hdhimmel/willy-rover/docs/WildWilly_AsBuilt_Design_v1.0.md

# WildWilly Autonomous Rover

## As-Built Design Document

**Revision 1.0 · Current Configuration**

---

## Document Control

| Field | Value |
|---|---|
| Project | WildWilly Autonomous Rover |
| Document | As-Built Design — current configuration only |
| Revision | 1.0 |
| Date | 2026-08-15 |
| Owner | Howard Himmel |
| Status | Build complete; live verification in progress |
| Supersedes | Nothing. This is a parallel document. |
| Historical record | Master Engineering Package rev 6.2.0 retains all incident history, superseded designs, and revision lineage. Retain it. |

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

---

## 1. System Overview

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

---

## 2. Power Architecture

### 2.1 Distribution tree

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

### 2.2 Regulated rails

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

### 2.3 Protection

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

### 2.4 Capacitors — complete list

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

### 2.5 Voltage limits

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

---

## 3. I²C Bus and Isolation
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
