hdhimmel/willy-rover/hardware/arm/arm_ducts_check.png

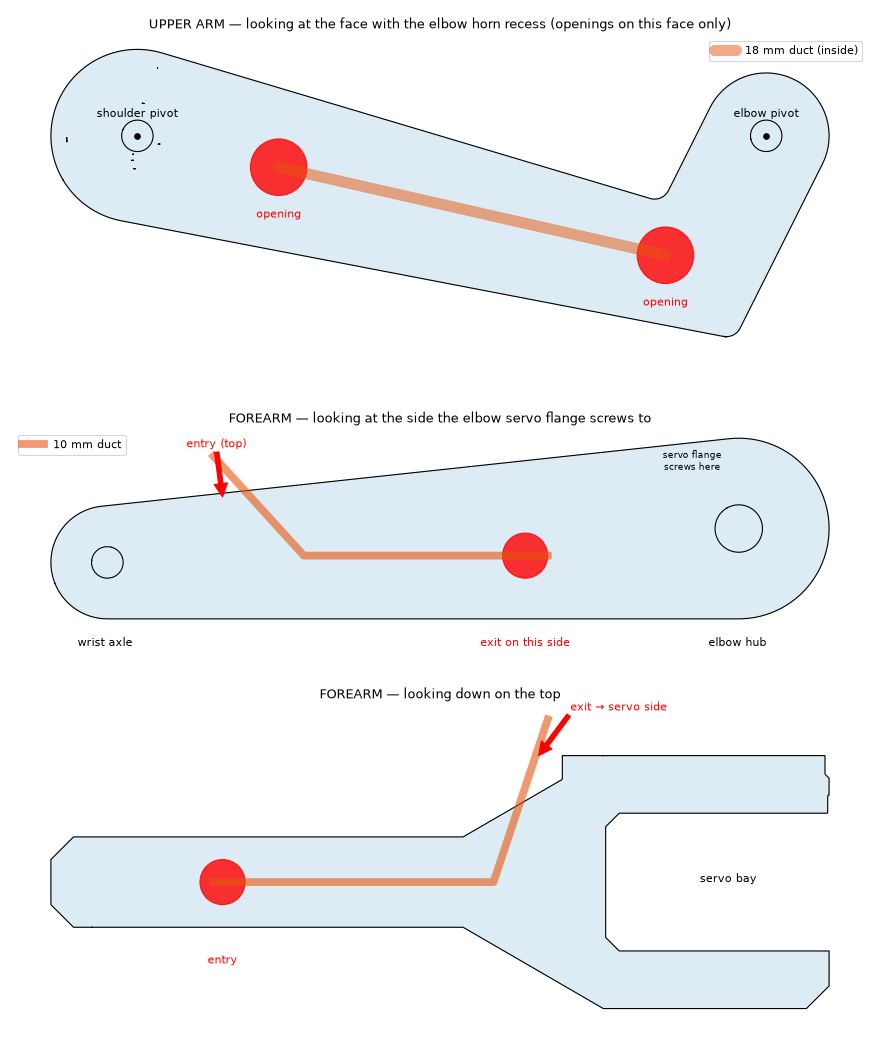
hardware/arm/arm_ducts_check.png
