hdhimmel/willy-rover/hardware/body/WildWilly_Body_P1S.3mf

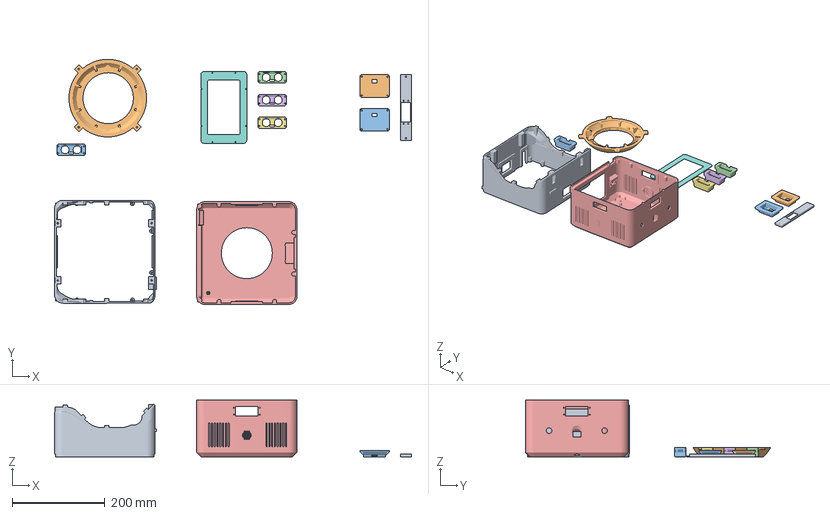
[picture p2: CAD file, 2026-10-14]
hardware/body/WildWilly_Body_P1S.3mf
771.7 x 530.4 x 123.2 mm
WildWilly_body_lower
WildWilly_dome_cap
Sonar_holder_1
Sonar_holder_2
WildWilly_body_upper
Sonar_holder_3
Sonar_holder_4
WildWilly_display_bezel
WildWilly_servo_bar
ToF_box_front
ToF_box_rear
