hdhimmel/willy-rover/docs/WildWilly_Bench_Test_Procedures.md

# WildWilly — Bench Test Procedures

**Created 2026-09-14.** Prepared in advance of a hardware session, at the owner's request,
following the direction to *"make the physical robot's control and safety foundation
rock-solid before expanding autonomy."*

> **NO RESULT IN THIS DOCUMENT HAS BEEN OBSERVED.** Every result field is blank and stays
> blank until someone runs the procedure on the physical rover and writes down what
> happened. A procedure with a plausible-looking number already in it is worse than no
> procedure: the whole point of this session is to replace assumptions with measurements,
> and the repository already contains several defects that survived because a reasonable
> guess was written down as though it were a reading.

This is an operational checklist, not a design document. It does not count against the
three-document rule (Master Hardware Design, Software Design, Functional Requirements) and
follows the existing convention of `archive/WildWilly_ADS1115_Bringup_Checklist.md`
and `archive/WildWilly_PCA9685_Arrival_Punchlist.md` (both archived 2026-09-24 — the
convention stands, the checklists are closed).

---

## What is already verified, and what is not

The distinction matters because it decides what still needs the rover.

### Verified in software — done, no hardware required

These are proven by the test suite (`WILLY_SIMULATE=1 ./venv/bin/python -m pytest`, 398
passing at time of writing; **412 as of 2026-09-17**). They need no bench time and are listed
so nobody re-does them.

✅ **S-1 sonar array — CLOSED ON HARDWARE 2026-09-17.** All three channels range-tested
together for the first time since the build: front 49.7cm, left 91.1cm, right 30.9cm, each
stable to ±0.4cm over 8 samples and each reading its own direction (three distinct
distances, so no cross-talk). All three ECHO lines idle LOW and go low against an internal
pull-down. R2 at 4.990V @ 0.026A — no sensor drawing fault current. There is no separate
S-1 procedure below because the array was closed while debugging it; the method is recorded
in Master Hardware Design §16.13, which now carries a diagnosis table for a dead channel.

| area | evidence |
|---|---|
| Emergency stop phrasing, incl. negation | `tests/test_emergency_stop_phrases.py` (40) |
| Reflex/deliberative separation | `tests/test_reflex_deliberative_separation.py` (5) |
| Nothing bypasses `safety.py` to the motors | `tests/test_no_direct_drive_bypass.py` |
| AI result → motion gating, all result kinds | `tests/test_stuck_ai_fallback_chain.py` |
| Malformed model output never becomes an action | `tests/test_malformed_model_output.py` (24) |
| Confidence gate semantics | `tests/test_confidence_gate_semantics.py` (9) |
| Hailo ChatML framing, statelessness, params, device sharing | 4 files, 27 tests |
| STUCK prompt shape and single-source | `tests/test_stuck_prompt.py` (11) |
| sd_notify wire format, inertness, fault tolerance | `tests/test_sd_notify.py` (6) |
| I²C expected-device agreement | `tests/test_expected_i2c_agreement.py` (5) |

### Requires the physical rover — everything below

Nothing in the sections that follow can be established from a laptop, and none of it should
be inferred from code reading. Each has a blank result field.

**Safety rules for every procedure here:**

1. **Rover on blocks, wheels free**, unless a step explicitly says otherwise.
2. **Stop the service first**: `sudo systemctl stop willy-rover` — it holds the I²C bus, the
   camera and the serial ports, and two processes driving the same PCA9685 is its own defect.
3. **Keep a hand on the power switch.** The hardware e-stop is a latching cut with no
   documented GPIO sense pin, so software cannot observe or override it — that is the point.
4. Restart afterwards: `sudo systemctl start willy-rover`.

---

## M-1 — Motor port mapping (one wheel at a time)

**Why:** `config.py:59` `MOTOR_PORT` was changed on 2026-09-04 from a bench-measured mapping
to an assumed physical ordering. Until this is confirmed, do not trust per-wheel odometry,
stall attribution, crab steering, or autonomous recovery — every one of those names a
specific wheel.

**Tooling (rewritten 2026-10-16 for the Pico cutover):** the MCP23017 expander is off the
bus (Master Hardware Design §4.7); the six encoders are counted by **Pico A** and read over
`uart4-pi5` by `sensors.Encoders` (signed ×2 since firmware a-0.3, `ENCODER_COUNTS_PER_REV`=763).
`scripts/motor_map_check.py` drives each `MOTOR_PORT` alone in rover-forward terms
(`MOTOR_SIGN` applied, as `motors.py` does) and prints every encoder's count change: a correct
row moves **only its own** encoder, by a **positive** amount. `scripts/wheel_current_test.py`
drives one wheel and reports current, which independently confirms a port is connected.
`scripts/encoder_map_check.py` (MCP23017 pin poll) no longer exists; do not reinstate it.

**Procedure:**

1. Rover on blocks. Service stopped (it owns the motor ports and Pico A's UART). Label the
   six wheels physically (LF, LM, LR, RF, RM, RR) with tape.
2. `python3 scripts/motor_map_check.py` -- all six, or name wheels (`lf rr`).
3. For each row, record **which physical wheel turned**, **whether it rolled forward**, and the
   script's verdict. The script can only see encoders; your eyes confirm the wheel.
4. Any non-OK row: wires first (connector, crimp, J3 position), then config
   (`MOTOR_PORT`, `MOTOR_SIGN`), then the part. Re-run that wheel alone after a fix.

**Record:**

| config key | address, port | wheel that actually turned | rolled forward? | script verdict |
|---|---|---|---|---|
| `lf` | `MOTORKIT_LEFT_ADDR`, 3 | | | |
| `lm` | `MOTORKIT_LEFT_ADDR`, 2 | | | |
| `lr` | `MOTORKIT_LEFT_ADDR`, 1 | | | |
| `rf` | `MOTORKIT_RIGHT_ADDR`, 3 | | | |
| `rm` | `MOTORKIT_RIGHT_ADDR`, 2 | | | |
| `rr` | `MOTORKIT_RIGHT_ADDR`, 1 | | | |

**Pass:** all six map to the wheel their key names, and forward is forward on both sides.
**If a whole side runs backward**, that is `MOTOR_SIGN`, not `MOTOR_PORT`: the motors are
mounted mirrored (harness-end outward), so one side is negated in software (2026-10-01).
**If it fails:** correct `MOTOR_PORT` in `config.py`, then re-run this whole procedure —
not just the rows that were wrong. A mapping is a permutation; fixing one entry can move
another.

**Note:** the encoder A/B channel assignment is a *separate* unverified question
(`config.py:57`) and is **not** settled by settling this one. See E-1.

---

## E-1 — Encoder supply and output

✅ **Counts/rev MEASURED 2026-10-01: 382** (×1, Phase A only — see C-1 Phase 5). Every 752
below is the old-motor figure and is superseded. **Now 763** — Pico A a-0.3 decodes signed x2
the same day, exactly 2 × 381.6.

**Why:** `ENCODER_COUNTS_PER_REV=752` (11 PPR × 4 quadrature × 17.1:1) is arithmetic, not a
measurement, and the A/B assignment is flagged unverified. FRD G-2 separately computes that
at 620 RPM output the edge rate is ~7,770 Hz against a ~1 kHz polling ceiling — roughly 8×
oversubscribed — which means counts may be *systematically* low rather than noisy.

**Do not hand-turn the wheels.** Measured 2026-08-25: 30s of hand-turning produced one
distinct pin state while 3s of driving produced seven. The encoder is on the motor shaft
behind the 17.1:1 gearbox and does not back-drive. Any encoder measurement here must be
taken under power.

**Procedure:**

1. Meter the encoder supply rail at the encoder connector, motors idle, then again while
   driving. Record both — a rail that sags only under load is the failure mode that looked
   like a dead sensor on 2026-08-25 (measured 2.83 V against a 3.3 V target).
2. Run `scripts/encoder_map_check.py` (rover on blocks) and record which encoder channels
   move for which driven wheel.
3. Run `scripts/encoder_calibration.py` to compare observed counts per revolution against
   the configured 752.

**RESULT 2026-09-18 — partially closed.**

| measurement | value | notes |
|---|---|---|
| Encoder supply, idle | **3.3 V** | in spec; the datasheet range is 3.3–5 V, so undervoltage was never the fault |
| Encoder supply, under load | **3.3 V** | no sag — the 2026-08-25 theory (2.83 V) is dead |
| Encoder supply POLARITY | ⚠ **WAS REVERSED** | found and corrected 2026-09-18. LF Phase A went 2/6 → 6/6 immediately after |
| Pin-to-wheel map | ✅ **measured** | left/right were transposed, same as the motor boards — see Master Hardware Design §7.2 |
| Phase A (yellow, even pin) | ✅ all six | |
| Phase B (green, odd pin) | ❌ **dead on all six** | one wiring pattern, not six faults — trace the green wires |
| Counts per revolution vs 752 | not measured | blocked on Phase B: quadrature needs both channels |

**Superseded 2026-10-01:** the dead Phase B was the OLD motors. On the six new motors A and B
toggle in step on every wheel (raw pin poll over USB, each wheel driven alone); a-0.3 decodes
signed x2, direction verified on all six; counts/rev **763**.

**Historical (MCP23017, retired):** the next paragraph describes the old expander method and
is kept for the record only -- Pico A counts in hardware (PIO), so none of its aliasing applies now.
**The method matters more than the numbers here.** Do not poll these pins for edges: at 0.6
duty the edge rate is ~7.7 kHz against a ~1.2 kHz I²C ceiling, and the aliasing reads as a
CONSTANT. Three attempts concluded "no encoder output at all" and all three were wrong. Drive
one wheel ~1 s, compare the MCP23017 resting state before and after, and count across several
trials which pins change.

**Still open:** the green/Phase-B wiring, and only then counts-per-rev. **Both closed 2026-10-01.** Note step 3 below is
itself invalid — `scripts/encoder_calibration.py` is built on hand-turning, which produces
nothing on this rover (§2.2: the encoder is behind the 17.1:1 gearbox and does not
back-drive).

⚠ **STEP 3 IS ALSO BLOCKED ON HARDWARE, owner-stated 2026-09-24: the drive motors are
being replaced with 170 RPM variants.** `ENCODER_COUNTS_PER_REV` is 11 × 4 × the gearbox
ratio, so calibrating it against the 17.1:1 motors measures hardware that is about to come
out. **Do step 1 and step 2 now; leave step 3 until the new motors are fitted.**
**Done 2026-10-01: 382** — under power, not with step 3's script (C-1 Phase 5). **763** under a-0.3's x2.

Two things to carry into that session:

- **Step 2 has to be re-run after the swap regardless.** Both left/right transpositions
  found on 2026-09-18 — `MOTOR_PORT` and `ENCODER_PINS` — came from landing motors and
  their encoders in a single pass. Six new motors is that same pass. M-1 and E-1 step 2
  both re-open, and wire colours differ between batches of this family.
- **Do not let 3292 back in.** It implies 74.8:1 ≈ 142 RPM output, not 170, so it is
  roughly 20% wrong for the new motors rather than 4.4× wrong — and a 20% fixed offset
  reads as wheel slip, which is exactly what FR-500-002 is supposed to distinguish it
  from. Measure the value; do not adopt either recorded figure.
| Channels responding per wheel | | |
| Observed counts/rev vs 763 | | x2 (a-0.3); was "vs 382" (×1) earlier 2026-10-01, "vs 752" before |
| Counts plausible at speed, or systematically low? | | bears on FRD G-2 |

**Pass:** supply holds within tolerance under load, every wheel produces distinct A/B
activity, and observed counts/rev are within a few percent of **763** (x2, a-0.3), and each wheel counts
up driven forward, down in reverse. Was 382 (×1) earlier 2026-10-01, 752 before.

---

## A-1 — Arm connector reconnection

**Why:** the arm connector was reconnected and has not been exercised since.

**Procedure:**

1. Arm clear of obstructions, rover powered, service running.
2. Issue `arm_home` by voice ("willie, home the arm") or via the pending-command path.
3. Observe physically.

**Record:**

| check | result |
|---|---|
| All expected joints moved | |
| Any joint stuck, buzzing, or fighting | |
| Motion smooth or jerky | |
| Servo current during motion (`scripts/servo_current_test.py`) | |

**Pass:** every joint moves to centre, nothing buzzes at the limit, current is in family
with the other joints.

**Note for the recorder:** `brain.py:807` currently aliases **both** `arm_stow` and
`arm_home` to `arm.center_all()`, because no calibrated stow pose exists yet (§20.6). So
this procedure tests the connector and the servos — it does **not** test a stow pose,
because there is not one. Do not record "stow verified".

---

## V-1 — IMX708 range and bearing calibration

**Why:** `vision.py:19-20` uses `_ASSUMED_HFOV_DEG = 70.0` and `_FOCAL_PX_ESTIMATE = 600.0`,
both explicitly not bench-measured. `come_here`, `follow`, `retrieve` and the grasp standoff
all rest on them. Conservative stopping does not make the numbers right; it makes the error
land in a safer direction *most* of the time.

**Precondition — settle the camera question first.** `vision.py`'s constants are commented as
being for the **OV9281**, while `config.CAMERA_DEVICE` is `/dev/video8`, which `config.py:587`
records as the **rear-facing Arducam**. Calibrating range for a camera that is not looking
where the rover drives produces a confident wrong number, which is worse than the current
honest estimate. `scripts/calibrate_vision_range.py` refuses to proceed until this is
confirmed, deliberately.

**Procedure:**

1. `sudo systemctl stop willy-rover`
2. `./venv/bin/python scripts/calibrate_vision_range.py --object person`
3. Place the object squarely at measured distances across the working range — suggested
   50, 75, 100, 150, 200, 300 cm, measured to the **front face of the rover**.
4. For bearing: place the object at a measured lateral offset at one fixed distance, both
   left and right, and record reported bearing against true angle.

**Record:**

| true distance (cm) | reported (cm) | ratio |
|---|---|---|
| 50 | | |
| 75 | | |
| 100 | | |
| 150 | | |
| 200 | | |
| 300 | | |

| bearing check | true angle | reported |
|---|---|---|
| left offset | | |
| right offset | | |

**Interpretation, decided in advance so the result is not rationalised afterwards:**

- A **constant** true/reported ratio across all distances is a focal-length error. Scale
  `_FOCAL_PX_ESTIMATE` by it.
- A **varying** ratio is *not* a focal-length error — a wrong focal length scales every
  reading by the same factor. Varying means the assumed object width is wrong, the detector
  box is unstable, or the object was not square to the camera. **Do not apply a correction
  from such a run.**

**Pass:** ratio constant within ±0.1 across the range, bearing within a few degrees.
**Until this passes**, treat `retrieve` grasp distance as unvalidated regardless of how
conservative the stopping behaviour looks.

---

## T-1 — ToF (DFRobot SEN0628) bench test, before integration

**Why:** `tof.py::read_frame()` deliberately raises `NotImplementedError` — the wire format
had never been observed. `ENABLE_TOF=False`.

> **HISTORICAL — first bench test of the sensor, before it was mounted (2026-09-15).** The zone
> results below (62–63 of 64 live, rows reading 5–14 mm) describe the loose sensor on the bench, not
> the mounted ones. Both mounted sensors run with floor profiles re-captured **2026-10-15** (front rows
> 6–7, rear rows 0–1; see Software Design ToF section). Do not cite these numbers as current.
>
> ✅ **LARGELY CLOSED 2026-09-15 — the sensor works.** Transport, protocol and sensor are all
> verified: **200/200 clean frames** at 0.13s each, 62–63 of 64 zones live.
>
> **Root cause of the day spent getting there: it was powered from a dormant supply rail**, not
> from the Pi's 3V3 / I²C rail (R4). A marginal supply boots the RP2040 far enough to light its
> LED, hold TX idle-high and answer a few commands, then go quiet — so every "is it powered?"
> check passed. **Prove which RAIL a device is on, not just that it has voltage.**
>
> What remains: the near-field zone anomaly below, one longer stability run, `read_frame()`,
> and the floor profile.

**Pi side — VERIFIED 2026-09-15, does not need rechecking:**

| check | result |
|---|---|
| `dtoverlay=uart3-pi5` in `/boot/firmware/config.txt` | ✅ added and confirmed |
| `/dev/ttyAMA3` exists after reboot | ✅ `PL011 AXI` at `1f0003c000.serial` |
| `pinctrl get 8-9` shows `a2` = TXD3 / RXD3 | ✅ |
| `spi0` not holding GP8/GP9 | ✅ empty |

⚠ **It must be `uart3-pi5`, never `uart3`.** The plain overlay is BCM2711/Pi 4 and puts
UART3 on GPIOs 4–7. It does not error, the Pi boots cleanly, and the sensor reads as dead
hardware on the wrong pins.

**UART protocol — derived from `DFRobot_MatrixLidar.cpp` verbatim, 2026-09-15:**

```
request   [0x55][argsNumH][argsNumL][cmd][args...]      argsNum = len(args) + 1
reply     [status][cmd][lenL][lenH][payload...]          lenL BEFORE lenH
          status 0x53 = SUCCESS, 0x63 = FAILED
          0xFF is filler; skip it while hunting the status byte
getAllData    55 00 01 02
setRangingMode 8x8   55 00 05 01 00 00 00 08   then wait 5s (library does delay(5000))
payload   little-endian uint16 millimetres, 64 zones = 128 bytes; 4000 = invalid
```

Two traps, both of which cost hours: `argsNum` is `len+1` not `len` (the un-incremented
value returns `STATUS_FAILED`, which reads like a hardware fault), and the reply's `0x53`
is a **status byte, not a header** — parsing it as a header yields nonsense lengths.

**`scripts/tof_probe.py` implements all of this.** Use it rather than rewriting a client.

**Procedure — the sensor-dependent half:**

1. **Set the DIP switch to UART and then DISCONNECT POWER.** The factory default is I²C, and
   DFRobot require a power disconnect for the change to latch — a Pi reboot will not do it,
   because the 3.3V header rail stays up. A sensor in I²C mode is silent on UART with both
   lines idling high, indistinguishable from any other fault here.
2. **Peel the protective film** off the optics and off the DIP switch.
3. **Wire BOTH data lines.** `sensor TX → GP9 = pin 21` *and* `sensor RX → GP8 = pin 24`.
   Power from **3.3V, not 5V**. Earlier guidance that only RX was needed was wrong — see
   below — and one wire produces permanent silence.
4. `./venv/bin/python scripts/tof_probe.py --listen` → **expect zero bytes.** The sensor is
   polled, not streaming. Zero here is a pass, not a fault.
5. `./venv/bin/python scripts/tof_probe.py` → expect `SUCCESS`, `len=128`, and a grid.
6. `./venv/bin/python scripts/tof_probe.py -n 200` for the stability bar. §6.5 requires a
   **stable multi-minute stream**; intermittent is a fail. Return inside 30 days if it will
   not hold one.
7. Implement `read_frame()` against the observed bytes.
8. On clear level floor, on the surface Willie actually roams, run
   `python3 scripts/calibrate_tof_floor.py`.
9. Only then set `ENABLE_TOF=True`.

**`pinctrl` answers "is it even connected?" without a meter.** `sudo pinctrl get 9` reads
`pu | hi` by default — but a *floating* pin reads the same, so that proves nothing. Force
the pull down (`sudo pinctrl set 9 pd`) and re-read: still `hi` means something external is
actively driving the line, i.e. the sensor is powered and its TX is alive. Restore with
`sudo pinctrl set 9 pu`. This separated "sensor absent" from "sensor present but mute"
three times on 2026-09-15.

**Record:**

| check | result |
|---|---|
| Raw frame observed (paste a sample) | ✅ 2026-09-15 — `status=0x53 cmd=2 len=128`, payload LE uint16 mm; sample row `1087 1145 1182 1211 1167 1203 1227 1212` |
| Frame length and structure match library source | ✅ 128 bytes = 64 zones × uint16, exactly as derived |
| All 64 zones return data | ⚠ **62–63 of 64.** Rows 1–4 read **5–14mm**, below the sensor's 20mm minimum, with scattered zeros and two `4000`s. Rows 5–8 read a sensible 1.0–1.2m. **Check the protective film on the optics first** (CLAUDE.md's first ToF trap — a ~5×3mm square the vendor docs never mention), then the bench pose. Do NOT run the floor profile until this is understood — `calibrate_tof_floor.py` would bake it into the baseline |
| Stable multi-minute stream (`-n 200`) | ✅ **200/200, zero dropouts, 0.13s/frame.** Run took ~1.8 min — repeat at `-n 600` to fully satisfy "multi-minute" before `ENABLE_TOF=True` |
| Floor profile captured, zones with no data | blocked on the near-field anomaly above |
| Reads consistent at fixed distance | |

**Supply — record this, it was the whole fault.** 3.3V must come from the **Pi 3V3 / I²C rail
(R4)**. The rail it was originally on is out of the build entirely. The sensor adds
up to 80mA to R4 and is now its largest single consumer; nothing monitors that rail, so if it
goes tight the symptom is I²C flakiness appearing after `ENABLE_TOF` goes True.

**Note:** re-run the floor capture after **any** mechanical change. The profile is tied to
the sensor's exact pose; a shifted bracket invalidates it. That failure is loud rather than
silent (phantom obstacles, so he stops for nothing), but it is still a failure.

---

## B-1 — Battery divider calibration

**Why:** `BATTERY_DIVIDER_SCALE=0.2386` needs re-trimming, and the feed should be confirmed
electrically correct first. A scale trimmed against a wrong feed is a wrong number that
looks right.

**Procedure:**

1. Confirm the divider feed is what the documentation says it is — meter it, do not infer it.
2. With a meter on the pack, compare true pack voltage against `adc.battery_volts` at three
   states of charge across the usable range.
3. Compute the corrected scale; do not fit from a single point.

**Record:**

| true pack voltage | reported `battery_volts` | ratio |
|---|---|---|
| | | |
| | | |
| | | |

**Pass:** reported tracks true within ~0.1 V across the range after correction.

**Related:** `config.BAT_IMPLAUSIBLE_V=5.0` rejects readings below a plausibility floor. Note
during this procedure whether any legitimate reading is being rejected.

---

## W-1 — systemd watchdog, bench validation before arming

**Why:** on 2026-09-07, `WatchdogSec=500ms` was installed on a `Type=simple` unit.
`NotifyAccess` then defaults to `none`, so systemd **discarded every** `sd_notify` message —
the heartbeat was never received, no heartbeat rate could have satisfied the deadline, and
the rover was SIGABRTed four times in twenty seconds, never reaching its own first log line.

**Prepared, not installed:** `willy-rover-watchdog.service.prepared`. It is named `.prepared`
so a wildcard copy cannot pick it up, and it carries two `__MEASURE__` placeholders.

**systemd does not reject those** — verified 2026-09-14 with `systemd-analyze`, it logs
`Failed to parse ... ignoring` for both lines and starts the unit with the **defaults**, and the
default for `WatchdogSec` is *disabled*. That would be the worst outcome available: the rover
comes up cleanly and whoever installed it believes the watchdog is armed while nothing is
watching. So the refusal is enforced explicitly by an `ExecStartPre` guard that fails the start
while any placeholder remains (checked in both directions: exit 1 with placeholders, exit 0 once
filled). **A unit that refuses to start is a better failure than a rover that crash-loops, and
far better than one that lies about being protected.**

**Software side already verified** (`tests/test_sd_notify.py`): message wire format,
inertness when `NOTIFY_SOCKET` is unset, abstract-socket translation, no exception into the
tick loop from a dead socket, and that `READY=1` is reachable after a *failed* self-test — so
a degraded rover stays up instead of restart-looping.

**Procedure:**

1. `sudo systemctl stop willy-rover`
2. `./venv/bin/python scripts/measure_startup.py --runs 5 --out /tmp/startup.json`
   This launches `main.py` with its own notify socket; it does not install anything or use
   `systemctl`.
3. Fill both `__MEASURE__` values from the printed suggestions. Sanity-check `WatchdogSec`
   against `config.TICK_OVERRUN_THRESHOLD_S` — a watchdog **below** the tick-overrun
   threshold kills the process before it has logged that it was running slow, destroying the
   evidence for why it died.
4. Install as a **separate** unit; do not overwrite `willy-rover.service`, so rollback is one
   command.
5. **Rover on blocks.** Restart it 10 times: `sudo systemctl restart willy-rover-watchdog`,
   confirming each time that it reaches ready and stays up for at least two minutes.
6. Confirm the watchdog actually bites: induce a stalled tick (e.g. `SIGSTOP` the process) and
   confirm systemd restarts it within roughly `WatchdogSec`.

**Record:**

| measurement | value |
|---|---|
| Startup, worst of 5 runs | |
| Startup, median | |
| Worst tick-gap between heartbeats | |
| `TimeoutStartSec` chosen | |
| `WatchdogSec` chosen | |
| `WatchdogSec` > `TICK_OVERRUN_THRESHOLD_S`? | |
| 10 restarts all reached ready | |
| Watchdog fires on an induced stall | |
| Degraded self-test still reaches ready (not a restart loop) | |

**Pass:** all ten restarts reach ready, the watchdog demonstrably fires on a real stall, and
a deliberately failed self-test produces a degraded-but-running rover rather than a loop.

**Rollback:**
`sudo systemctl disable --now willy-rover-watchdog && sudo systemctl enable --now willy-rover`

---

## Suggested order

Each stage assumes the one before it. Doing them out of order produces measurements that
have to be retaken.

⛔ **C-0 comes before all of these, and before the motors are touched.** It measures
counts-per-rev on the fitted motors, and once they are out it can never be run. The
170 RPM replacements arrived 2026-09-26.

1. **M-1** motor mapping — everything per-wheel depends on knowing which wheel is which.
2. **E-1** encoders — needs M-1 to attribute channels to wheels correctly.
3. **B-1** battery divider — cheap, independent, and it underpins every "is the rail sagging"
   question in E-1.
4. **A-1** arm — independent, quick.
5. **W-1** watchdog — do it before any unattended running, and after M-1/E-1 so a restart
   loop cannot be confused with a drive fault.
6. **V-1** vision range — gate for `retrieve`/`come_here`/`follow`; settle the camera-facing
   question first or skip it.
7. **T-1** ToF — last, because it is the only one that needs new code written against
   observed bytes.
8. **C-1** the Pico and motor cutover — a session of its own, not a step in another
   one. It re-lands six motors and twelve encoder wires, which is how the left/right
   transposition happened twice before.

---

## C-0 — counts-per-rev on the FITTED motors ⛔ DO THIS BEFORE ANYTHING ELSE

⚠ **Overtaken 2026-10-01:** the cutover is done and these motors are out; the table below
was never filled. The 170 RPM replacements measured **382** (C-1 Phase 5) — **763** under a-0.3's x2.

**Why:** the vendor parameter table (2026-09-27) makes the fitted motors
`JGA25-370-9.6K`, i.e. **9.6:1**, which puts `ENCODER_COUNTS_PER_REV` at **422** rather
than the **752** in `config.py`. If that is right, `odometry.py` is under-reporting
every distance by **1.78×** and has been all along. The recorded 17.1:1 was
owner-supplied, and the ~10,600 RPM bare speed was *derived from it* — then each was
cited as corroborating the other. Neither was measured.

**This is unrepeatable once the motors are out.** Everything else in C-1 can be redone;
this cannot.

**Procedure:**

1. Read the part number off a fitted motor body and write it here. `-9.6K` confirms the
   table; anything else rewrites this whole item.
2. Rover on blocks, wheels free, service stopped. Drive **one** wheel a known number of
   full revolutions **under power** — never by hand, the gearbox does not back-drive.
3. counts ÷ revolutions = counts/rev. Expect **422** if the table is right, **752** if
   the document is.
4. Record it, then set `ENCODER_COUNTS_PER_REV` to the measured value regardless of
   which it matches.

| measurement | value | notes |
|---|---|---|
| Part number on the motor body | | `-9.6K` expected |
| Revolutions driven | | |
| Counts observed | | |
| **counts/rev measured** | | 422 vs 752 |

---

## C-1 — Pico and motor cutover

**Everything below happens in one session.** The two changes are independent in
principle and entangled in practice: both re-land six motors' worth of connectors, and
that is exactly how the left/right transposition happened on 2026-09-18 — twice, on the
motor ports and on the encoder channels.

**Standing convention:** removed hardware is **DELETED** from the documents, not struck
(owner-directed 2026-09-20). The MCP23017 does not become a historical note; it goes.

### Phase 1 — bench, before the rover is opened

- [ ] Two carrier boards built to the schematic, **four meter checks passed** — diode
      orientation, no short across the input, PTC cold resistance under ~0.5Ω, divider
      ratio at TP2. Nothing plugged in.
- [x] Both Picos flashed, `os.uname()` and `machine.unique_id()` recorded against A and
      B, and the IDs written **on the boards**. A is `643f69a756a232ea`, B is
      `ad25bbf0f1e1f160` — confirm rather than assume.
      **Confirmed over USB 2026-09-29: both UIDs match, both on MicroPython v1.29.0
      (2026-08-24), RP2350.** ⚠ **And add a step nobody thought to write down: check
      the firmware is installed as `main.py`.** Both boards had it as `pico_a.py` /
      `pico_b.py`, which does not autorun; that alone cost a full session and looked
      exactly like dead hardware.
- [x] `Pin("LED")` **verified on BOTH boards, 2026-09-29** — lit at boot, 60 ms wink
      once a second, wrapped so a CYW43439 failure cannot take the link down.
- [ ] On the Pi: `dtoverlay -h uart2-pi5` reports GPIOs 4–5 and `uart4-pi5` reports
      12–13. **A wrong overlay boots clean and the Pico reads as dead hardware** — that
      cost a full session on the SEN0628.
- [x] `dtoverlay=uart2-pi5` and `dtoverlay=uart4-pi5` added, rebooted, `/dev/ttyAMA*`
      present, serial console still disabled. **Done 2026-09-28**; `pinctrl get 4,5,12,13`
      reads `TXD2 RXD2 TXD4 RXD4`, so `uart4-pi5` IS GP12/GP13 and the `uart5-pi5`
      fallback is not needed.

### Phase 2 — hardware

- [ ] **Meter the encoder supply polarity at the connector before anything is powered.**
      It was found reversed on 2026-09-18; blue-to-black read −3.3 V and a swapped pair
      of probes made it look right.
- [ ] Six motors out, six in. **Record which physical wheel each harness goes to as you
      go** — do not rely on the old labelling.
- [ ] Twelve encoder wires onto Pico A's J3, **yellow to the even GP, green to the odd**,
      in the order the net table gives.
- [ ] MCP23017 off the bus entirely. The bus becomes **ten devices**.
- [ ] Six sonar lines off the Pi header onto Pico B. GP4, GP5, GP13, GP14, GP21 and GP26
      are then free on the Pi, and **GP14 stays free permanently** — that is what retires
      the UART0 console hazard.
- [ ] BNO085 RST from the MCP23017's GPB4 to Pico B, **open-drain against the 10k**.
- [ ] Both carriers' feeds fused and diode'd: A from R5 at the encoder 3V3 distribution,
      B from 5 V at the breakout terminal. **Not R2.**

### Phase 3 — software

- [x] `config.py`: `ENCODER_COUNTS_PER_REV` → **382, measured 2026-10-01** (this line said
      **1562**, which assumed ×4 quadrature — wrong for Pico A's ×1 Phase-A count; **now 763**, a-0.3 x2); `ENCODER_ADDR` and `ENCODER_PINS`
      retire; re-measure `MOTOR_PORT` before trusting it (see Phase 5).
- [x] `config.py`: re-measure breakaway duty before keeping `SPEED_SLOW=0.55`. **Done
      2026-10-01 with `scripts/breakaway_sweep.py`: SLOW raised to 0.60, not lowered.**
      Four wheels break away at 0.15–0.35, but lm sits at 0.40–0.50 and rf wanders
      0.45–0.55. Motors accepted as-is pending break-in; re-sweep after use.
- [ ] `config.py`: `STALL_GRACE_S` is now a **hardware protection parameter**. Stall is
      1.8 A against the TB6612's 1.2 A continuous — 150% — so the window must be short
      enough to matter thermally, not merely short enough to feel responsive.
- [ ] `brain.py`: `_EXPECTED_I2C` drops `0x27`. The self-test expects **ten**. Miss this
      and a correctly built rover fails its own gate and `_motion_enabled` stays false.
- [ ] `sensors.py::Encoders`: I²C register reads → framed counts from Pico A.
- [ ] `sensors.py::SonarArray`: local pin timing → frames from Pico B, **with the
      staleness deadline**. The 999 cm sentinel goes; `-1` means unmeasurable and stale
      means **stop**. Software Design S-9.

### Phase 4 — documents, same session

Counts as of 2026-09-27, so you can tell when you are done:

| File | `MCP23017` / `0x27` / `ENCODER_ADDR` | `620 RPM` / `17.1` |
|---|---|---|
| Master Hardware Design | **42** — includes all of §16.6, which is deleted whole | **22** |
| FRD | **8** | **9** |
| Software Design | **5** | **7** |
| Bench Test Procedures | **2** | — |
| `config.py` | **7** | **5** |
| `sensors.py` | **14** | — |
| `brain.py` | **1** | — |

§4.7 stops being "design, not as-built" and becomes the description. §0's topology, §3.3's
roll-call, §11.2's self-test count, §13 and FRD FR-100-002 all move from eleven devices to
ten.

### Phase 5 — re-verify, in this order

- [ ] **M-1**: drive each port alone by raw address, owner names the wheel that turns.
      `0x61` is LEFT, `0x60` is RIGHT — confirm it survived the swap.
- [x] **E-1 step 2**: `scripts/encoder_map_check.py`, channel-to-wheel attribution. **Done
      2026-10-01 over USB on Pico A** (raw pin poll, each wheel alone): lf GP0/1, lm GP2/3,
      rf GP4/5, rm GP6/7, lr GP8/9, rr GP10/11.
- [x] **Green wires**: Phase B has read dead on all six since 2026-09-18. **Superseded
      2026-10-01: alive on all six new motors** — the dead ones were the old motors. Meter them
      during the re-land — the connectors are open anyway, and it is the cheapest this
      check will ever be.
- [x] **Counts/rev on the new motors**: expect **1562**. If it comes out otherwise, the
      11 PPR figure is wrong, since the ratio is fixed by the part number.
      **MEASURED 2026-10-01: 382.** Left-front, 0.35 duty to 3905 Phase-A edges, hard brake,
      3911 final (6 coast) over 10.25 tape-marked turns = 381.6, ±~5. **×1, not ×4** — 1562
      was the wrong expectation for this transport. 2.3% under 11 × 35.5 = 390.5 (effective
      ≈ 34.7:1). One wheel only. ⚠ Hand-turning failed (459, then 0, for 10 turns) — hub
      likely slips when back-driven; measure under power. Re-measure (≈1526) once Phase B
      decodes ×4. **Superseded 2026-10-01: a-0.3 decodes x2 → 763** (2 × 381.6); ×4 not planned.
- [ ] Only then: rails under load, and a drive test.

## Recording results

Write results **into this file** and commit them, rather than into a chat log. The standing
repo rule applies: when a measurement contradicts a document, prefer the artifact, and sweep
the *old* value repo-wide before calling the change done. Strike superseded text rather than
deleting it, so the correction stays legible.
