hdhimmel/willy-rover/docs/drawings/WildWilly_Arm_Measurements.html

# Willie Arm Measurements

for IK · 2026-10-14 · all lengths mm, pivot centre to pivot centre

## Side view · lengths and heights

## Top view · base axis, offsets, camera

## Lengths

Key | What | mm
L1 | shoulder pivot → elbow pivot
L2 | elbow pivot → wrist-pitch pivot
L3 | wrist-pitch pivot → jaw centre (where the object sits, jaws closed)
Hs | floor → shoulder pivot
Xs | shoulder pivot → front face (horizontal)
So | base axis → shoulder pivot, if the pivot is off the axis (0 if on it)
Xb | base axis → front face
Ys | centreline → base axis (+ = left)
Hc | floor → front camera lens centre
Xc | lens set back from front face (0 if flush)
Yc | centreline → lens (+ = left)
θc | camera tilt below horizontal, degrees

## How to measure

1. Lengths go between output-shaft centres, not horn edges or bracket ends.
2. Willie on a flat floor, tyres at normal pressure: Hs and Hc depend on it.
3. Angles: phone level app laid along the link, read at two pulses per joint. Two readings give degrees per µs and the zero pulse. Pick pulses far apart.
4. θc: level the phone on the camera board, or aim at a floor mark of known distance and work it out from the frame.
5. Gripper is already known: open 1150 µs = 73 mm, closed 2150 µs = 0.

## Joint angles · two-point slope

Joint | 0° is | µs A | ° at A | µs B | ° at B | °/µs | 0° at µs

## Send me the numbers

Copy all values

Values stay in this browser only. Paste the text into the chat.
