hdhimmel/willy-rover/config.py

# WildWilly Rover — Central Configuration v2
# 180x125mm chassis · 5" 800x480 landscape display

import os,storage
# §19 of docs/WildWilly_Claude_Fix_Implementation_Plan.md: every hardware-backed class in
# motors.py/sensors.py/arm.py checks this at construction time and, when set, skips opening real
# I2C/GPIO/SPI entirely in favor of an in-memory simulated stand-in with the same public
# interface — this is what lets brain.py (and everything built on it) import and run off the
# physical rover, per §20's testing requirements. Default OFF: the real hardware path is
# unchanged unless this is explicitly requested.
SIMULATE_HARDWARE=os.environ.get('WILLY_SIMULATE','0')=='1'

# §13: configurable storage roots — see storage.py's module docstring for why the *default*
# (unset env var) anchors to the repo directory rather than the process's CWD, and why this unit
# doesn't yet split these across a real SSD/SD (no such split physically exists here — confirmed
# 2026-08-08, boot-from-SSD is still a pending item per the master doc §13.4). Setting an env var
# overrides that tier's location with zero further code changes whenever that migration happens.
WILLY_DATA_ROOT=storage.resolve_root('WILLY_DATA_ROOT','.')      # operational/working files root
WILLY_MAP_ROOT=storage.resolve_root('WILLY_MAP_ROOT','.')        # world_model.db lives here (§9)
WILLY_MEMORY_ROOT=storage.resolve_root('WILLY_MEMORY_ROOT','.')  # memory.db lives here (§FR-1900)
WILLY_LOG_ROOT=storage.resolve_root('WILLY_LOG_ROOT','logs')     # logsetup.py's rotating file dir
# SIMULATION NEVER WRITES THE REAL STORES (2026-10-02). Running the test suite on the rover wrote
# simulated BATTERY_HALT events into the real logs/willy.log -- which feature_requests.py reads as
# evidence -- and full-sim brain tests open memory.db/world_model.db in the repo. Under
# WILLY_SIMULATE, any root not set explicitly goes to a throwaway directory instead.
if SIMULATE_HARDWARE:
    import tempfile as _tf
    _SIM_ROOT=os.path.join(_tf.gettempdir(),'willy-sim')
    for _env,_name in (('WILLY_DATA_ROOT','WILLY_DATA_ROOT'),('WILLY_MAP_ROOT','WILLY_MAP_ROOT'),
                       ('WILLY_MEMORY_ROOT','WILLY_MEMORY_ROOT'),('WILLY_LOG_ROOT','WILLY_LOG_ROOT')):
        if not os.environ.get(_env):
            globals()[_name]=os.path.join(_SIM_ROOT,'logs' if _name=='WILLY_LOG_ROOT' else '')
    os.makedirs(os.path.join(_SIM_ROOT,'logs'),exist_ok=True)

# DISPLAY_FPS 30 -> 15 (2026-10-11): py-spy on the idle service showed drawing the face at 30 fps
# was the largest CPU user (~38% of busy samples, above wake-word listening at ~29%). 15 fps is
# plenty for blinking and the talking mouth, and frees CPU for speech-to-text.
DISPLAY_W=800; DISPLAY_H=480; DISPLAY_FPS=15; DISPLAY_ROTATE=0
DISPLAY_FPS_QUIET=5   # while voice transcribes (display.set_quiet): frees CPU for speech-to-text

# Drive — 2x Adafruit FeatherWing #2927 MotorKit boards over I2C (§9, §1.3 master doc).
# Replaces the old GPIO H-bridge pins (freed — no discrete driver chip, no direction/PWM GPIO).
# ADDRESSES SWAPPED 2026-09-18 AFTER MEASURING THEM. These read 0x60=left, 0x61=right
# from the original build until M-1 was finally run: the left wheels are on 0x61.
MOTORKIT_LEFT_ADDR=0x61; MOTORKIT_RIGHT_ADDR=0x60
# BENCH-VERIFIED 2026-09-18 (M-1). Rover on boxes, wheels clear, service stopped,
# each port driven ALONE by raw address+port -- never by wheel name, since this dict
# was the thing under test -- with the owner naming the wheel that actually turned.
#
#   0x61 M1 -> LEFT REAR     0x60 M1 -> RIGHT REAR
#   0x61 M2 -> LEFT CENTER   0x60 M2 -> RIGHT CENTER
#   0x61 M3 -> LEFT FRONT    0x60 M3 -> RIGHT FRONT
#
# Two separate findings, and only one of them was the expected one:
#
# 1. PORT ORDER M1=REAR, M2=MIDDLE, M3=FRONT IS CORRECT. This was the ordering
#    commit 484fbdc asserted on 2026-09-04 for "physical layout symmetry" -- an
#    argument, not a measurement, and flagged here as untrustworthy ever since. The
#    argument happened to be right.
#
# 2. THE BOARD ADDRESSES WERE SWAPPED, AND THAT WAS NEVER SUSPECTED. Every revision
#    of this file had 0x60=left, 0x61=right. The left wheels are on 0x61. Note the
#    hardware was rebuilt after the 2026-08-24 test, so that result described
#    different wiring and could not have caught this.
#
# The 2026-08-24 result (M1=MIDDLE, M2=FRONT, M3=REAR) is now superseded and should
# not be restored -- it predates the rebuild.
#
# WHY THIS HID FOR SO LONG, and it is worth understanding before trusting any
# per-wheel claim in this repo: _set() commands all three wheels of a side to the
# same value, so forward, reverse and skid turns behave identically whether or not
# the sides are swapped. A left/right swap is invisible to every gross motion the
# rover makes. It only surfaces under per-wheel work -- odometry attribution,
# crab/differential steering, stall tracing -- where "lf stalled" names the wrong
# physical wheel, on the wrong side of the robot.
#
# The encoder A/B channel assignment in Master Hardware Design section 7.2 is
# unverified for the same reason and is NOT settled by settling this one. It has its
# own bench test (E-1) and its own swap risk.
#
MOTOR_PORT={'lf':(MOTORKIT_LEFT_ADDR,3),'lm':(MOTORKIT_LEFT_ADDR,2),'lr':(MOTORKIT_LEFT_ADDR,1),
            'rf':(MOTORKIT_RIGHT_ADDR,3),'rm':(MOTORKIT_RIGHT_ADDR,2),'rr':(MOTORKIT_RIGHT_ADDR,1)}
# MIRRORED MOTORS, 2026-10-01. Every motor is mounted harness-end OUTWARD, so the left and
# right motors face opposite ways, and both sides are wired the same (owner-stated). The
# same throttle therefore turns the two sides opposite ways at the ground. Until this sign
# existed, motors._set() sent both sides the same value: forward() pivoted him in place and
# turn_left()/turn_right() drove him straight. Observed on the block the same day: +0.6 on
# lf rolled forward, +0.6 on rf rolled BACKWARD, so the right side is negated. Only lf and
# rf were watched; rm/rr follow on the owner's word that all six are mounted and wired
# alike. motors.py applies this at the one place it writes throttle, so everything above
# it -- _target, _actual, current_speed -- stays in rover terms (+ = forward). Scripts that
# drive a single wheel raw (wheel_current_test, breakaway_sweep) bypass it, which is fine:
# they measure current and |counts|, not direction. Phase-A-only counts have no sign, so
# telemetry cannot see a wrong entry here -- watch the wheels.
MOTOR_SIGN={'lf':1,'lm':1,'lr':1,'rf':-1,'rm':-1,'rr':-1}
# Raised 2026-08-24. The previous set (ROAM .55 / TURN .50 / SLOW .35 / MAX .80)
# was below breakaway torque for this chassis: commanded motion produced an
# audible hum with no rotation. Measured per-wheel on the bench that day, a
# JGA25-370 on this base needs roughly 0.5+ duty to start turning at all, so
# SLOW=0.35 could never move him -- it only ever stalled the motors.
# WHY breakaway is that high, established 2026-08-25: these are 12V 620 RPM motors,
# a low-reduction speed-optimised gearbox, driving 101.6mm wheels. Torque scales
# with reduction and tractive force scales inversely with wheel radius, so both
# choices cut force at the ground. Raising these numbers spends headroom; it does
# not create torque, and full duty is already full duty. If more torque is needed
# it is a motor change -- see Master Hardware Design v2.0 section 7.1.
# HISTORY, from when these were PWM duty -- SLOW 0.55 -> 0.60 on 2026-10-01, after the 170 RPM / 35.5:1 motors went in. The
# prediction that more reduction would drop breakaway well below 0.5 did not hold for
# every wheel: scripts/breakaway_sweep.py, wheels free, found 0.15-0.35 on four wheels
# but lm at 0.40-0.50 and rf at 0.45-0.55 from rest (rf failed to move at 0.50 twice
# across five sweeps). Owner accepted the motors as-is, expecting break-in, so SLOW
# carries margin over rf on the block -- loaded on the floor needs more, not less.
# Re-run the sweep after some hours of use; this should come down.
# SPEEDS IN MPH (owner, 2026-10-02): slow 0.5, cruise 1.0, cap 1.5. Since closed-loop wheel
# speed control (FR-500-004, motors.wheel_duty) the SPEED_* values below are FRACTIONS OF THE
# CAP, not PWM duty: 1.0 = SPEED_MAX_MPH. The motors top out near 147 RPM free (~1.8 mph), so
# the 1.5 mph cap leaves headroom for the loop; 3 mph would need ~250 RPM (different motors).
SPEED_MAX_MPH=1.5; SPEED_ROAM_MPH=1.0; SPEED_SLOW_MPH=0.5; SPEED_TURN_MPH=1.0
SPEED_MAX=1.0
SPEED_ROAM=SPEED_ROAM_MPH/SPEED_MAX_MPH; SPEED_SLOW=SPEED_SLOW_MPH/SPEED_MAX_MPH
SPEED_TURN=SPEED_TURN_MPH/SPEED_MAX_MPH
# FR-500-004 closed-loop wheel speed (2026-10-02). Each wheel's duty = feed-forward from its
# measured duty->RPM line + a PI trim from its encoder. Off -> feed-forward only (open loop).
WHEEL_SPEED_CONTROL=True
# Feed-forward per wheel: RPM ~= slope*(duty-d0), fitted to scripts/breakaway_sweep.py,
# wheels free, 2026-10-02 (rf was disconnected -> default). Loaded on the floor reads lower;
# the PI trim makes that up, and a re-fit after break-in keeps the trim small.
WHEEL_FF={'lf':(0.163,225.0),'lm':(0.229,195.0),'lr':(0.192,231.0),
          'rf':(0.22,225.0),'rm':(0.271,211.0),'rr':(0.285,273.0)}
WHEEL_KP=0.002        # duty per RPM of error
WHEEL_KI=0.008        # duty per RPM-second of error
WHEEL_TRIM_MAX=0.30   # the PI may move duty at most this far from feed-forward: a blocked
                      # wheel gets a bounded push, and stall detection still stops it at
                      # STALL_GRACE_S (Directive 5)
# Seconds of being stopped AND fully ramped down before the bridges are released and the
# two MotorKit PCA9685s are put to sleep. Measured 2026-09-30: the +12V motor branch idles
# at 0.019A holding six stopped wheels in adafruit_motor's hard-brake -- about 0.2W spent
# to hold nothing. brake() is exempt: ESTOP wants the wheels held, not coasting.
# ~ Raise this if the rover is ever parked on a slope; a released 35.5:1 gearbox has high
#   backdrive resistance but it is not a parking brake.
MOTOR_COAST_AFTER_S=2.0

# --- servo idle release -------------------------------------------------------------
# A servo holds its angle only while it is receiving pulses. Stop the pulses and it goes
# LIMP. That is the point -- and the hazard.
#
# WHY THIS IS NOT ABOUT BATTERY. Idle draw measured 2026-09-30 is 0.23W on R2 and 0.35W on
# R3, which is nothing against a ~333Wh pack (2x 3S 15000mAh since 2026-10-05). The real reason is arm.py's note: the servo
# fitted before 2026-09-17 "held ~8A at 1500us indefinitely and was destroyed by it". A
# servo stalling against its own mechanism cooks itself in minutes, and releasing an idle
# joint is what prevents that. Treat this as servo protection that happens to save power.
#
# ⚠ THE ARM WILL FALL when released, to wherever gravity and its stops take it. The delay
#   is longer than steering's for that reason, and the first test should be done with the
#   arm LOW and nothing underneath it. Set ARM_RELEASE_WHEN_IDLE=False to disable.
STEER_RELEASE_AFTER_S=2.0
STEER_SETTLE_S=0.3   # 2026-10-10 (owner): straighten before moving -- centre, wait this long, then drive
ARM_RELEASE_AFTER_S=10.0
ARM_RELEASE_WHEN_IDLE=True
SPEED_RAMP_PER_S=2.0  # FR-400-003: max throttle change per second (slew rate), full range in 0.5s
TURN_INNER_SCALE=0.0

# Sonar (§8.1 master doc) — FRONT_ECHO/LEFT_ECHO were wired to GP11/GP19 here, which do not match
# the documented harness (GP26/GP14) and aren't connected to anything real — front/left obstacle
# detection has likely been silently reading 999cm (no obstacle) on every call. Fixed 2026-08-02.
# SONAR PIN CONSTANTS REMOVED 2026-09-30. They named GP5, GP13 and GP4, which the
# uart2-pi5 and uart4-pi5 overlays now claim as TXD2, RXD4 and RXD2 -- pinctrl confirms
# it. The three HC-SR04s are read by Pico B and arrive as $S frames over uart2-pi5, so
# nothing on the Pi times an ECHO line any more. Master Hardware Design section 4.7.
SONAR_INTERVAL=0.05
# Furthest a fresh "no echo" reading means. A -1 on a channel whose frame is FRESH is
# the Pico saying it pinged and heard nothing -- for a sensor pointed at an open room
# that is true, and it means clear, not broken. Distinct from a stale link, which means
# stop. Software Design S-9.
SONAR_MAX_CM=400.0
# How old a $S frame may be before sonar is treated as UNKNOWN, which means STOP.
# 33 Hz nominal, so this is ~10 missed frames -- long enough not to trip on jitter,
# short enough that a dead link cannot be driven through.
SONAR_STALE_S=0.30
DIST_STOP=20; DIST_SLOW=40; DIST_CLEAR=60; DIST_SIDE_CLEAR=25
# FR-1000-002 turn choice (avoidance.py, owner 2026-10-06): the front camera's detections bias
# WHICH WAY he turns. Never whether he stops -- Master Hardware Design §12 rule 15.
AVOID_USE_CAMERA=True
# CAMERA BRAKE (2026-10-14, owner): he hit a chair and a coffee table that sonar and ToF looked
# under. The calibrated front camera (CAM_FRONT_*) turns where these objects meet the floor into a
# distance, and ROAM/SLOW use the nearer of that and the sonar/ToF reading (arm_ik.obstacle_cm).
CAMERA_BRAKE=True
CAMERA_BRAKE_CLASSES=('chair','couch','dining table','bed','person','dog','cat','bench','potted plant','toilet','suitcase','tv')
CAMERA_BRAKE_PERIOD_S=0.3       # look this often while roaming (a detect costs ~50 ms)
CAMERA_BRAKE_HALF_WIDTH_MM=250  # his path: body/wheels half-width plus margin
CAMERA_BRAKE_OVERHANG_CM=10     # table tops / seats stick out past their legs
CAMERA_BRAKE_CUTOFF_FRAC=0.98   # box bottom this low = cut off by the frame: closer than it looks
CAMERA_BRAKE_CUTOFF_EXTRA_CM=10
ROAM_START_CLEAR_CM=40          # roaming starts with something nearer than this: turn away first
# STEER EARLY (2026-10-14, owner go): while roaming, something in his path within ROAM_STEER_EARLY_CM
# -> curve gently toward the clearer side (front corners +deg, rear -deg) and keep moving, instead
# of driving straight at it until the 40 cm slow-down / 20 cm stop (which stay as the backstop).
# This is steered DRIVING, deferred since 2026-08-18 and released by the owner on 2026-10-14.
ROAM_STEER_EARLY=True
ROAM_STEER_EARLY_CM=100         # start curving away when something in the path is this close
ROAM_STEER_DEG=15               # how hard (corner degrees); safety clamps to ROAM_STEER_MAX_DEG
ROAM_STEER_MAX_DEG=20
ROAM_STEER_HOLD_S=1.0           # keep a curve at least this long before switching sides
# SIDE-STEP (2026-10-14, owner): blocked on one side, he went back and forth. On the
# SIDESTEP_AFTER-th avoid within SIDESTEP_WINDOW_S, with one side under SIDESTEP_BLOCKED_CM and the
# other over SIDESTEP_OPEN_CM, all six wheels turn SIDESTEP_DEG toward the open side ("crab") and he
# drives SIDESTEP_TIME_S at slow speed: forward-diagonal if the front has room, else in reverse with
# the wheels the other way (still toward the open side). Then straight again. Owner 2026-10-14: the
# wheels do not touch the body at this angle.
SIDESTEP=True
SIDESTEP_AFTER=3
SIDESTEP_WINDOW_S=15.0
SIDESTEP_BLOCKED_CM=40
SIDESTEP_OPEN_CM=60
SIDESTEP_DEG=40
SIDESTEP_MAX_DEG=45
SIDESTEP_TIME_S=1.0
SIDESTEP_FRONT_ROOM_CM=35       # forward-diagonal only with at least this much in front
# Rotation mode (rotate.py, owner 2026-10-07): corners steered onto the turning circle, spin on IMU.
ROTATE_SPEED=1.0              # fraction of the mph cap for the corners; a skid turn needed full duty
ROTATE_SETTLE_S=0.6           # steering reaches its angle before any wheel drives
ROTATE_RESTEER_S=0.5          # re-assert the corner pulses, ahead of STEER_RELEASE_AFTER_S
ROTATE_STOP_EARLY_DEG=10.0    # stop this short; live 2026-10-07 he coasted ~6 deg past a 5 deg early stop
ROTATE_TIMEOUT_S=8.0          # a turn that is not happening, not a turn that is slow
ROTATE_CLEAR_CM=15.0          # anything nearer than this on any sonar/ToF stops the spin
# Pre-spin clearance on front/left/right (rotate.py _room_to_turn). Footprint ~0.42 x 0.41 m (length
# ESTIMATED as wheelbase + one wheel diameter; width owner-measured 41 cm): the corners sweep a
# 0.29 m radius, ~9 cm beyond the body on each side, plus margin. Arm or anything else sticking out
# is NOT included -- re-check if the arm rests outside the body.
ROTATE_START_CLEAR_CM=20.0
ROTATE_WRONG_WAY_DEG=10.0     # heading moving this far the wrong way = stop
# Blocked-turn stop (2026-10-07: spun into the couch, pushed 8 s until the timeout). After the spin
# has had ROTATE_STALL_ARM_S to break away and ramp, heading moving slower than this rate across
# the window = something is in the way. Live good turns ran ~25-50 deg/s.
ROTATE_STALL_ARM_S=1.0
ROTATE_STALL_WINDOW_S=0.7
ROTATE_STALL_MIN_RATE_DPS=5.0
ROTATE_STALL_WHEEL_CPS=100.0  # mean |counts/s| above this = wheels still turning (slip, not stall)
ROTATE_MIN_DEG=5.0
ROTATE_USE_CAMERA=True
ROTATE_CAMERA_HFOV_DEG=66.0   # imx708 standard lens, horizontal (datasheet), not bench-measured
ROTATE_REAR_CAMERA_HFOV_DEG=70.0  # rear Arducam OV9281 (UC599), global shutter -- NOT measured, a typical figure
ROTATE_CAMERA_MIN_RESPONSE=0.5    # phase-correlation quality; below it a frame is blurred = no measurement
ROTATE_CAMERA_MIN_MATCHED_DEG=20.0  # IMU rotation over a camera's clear frames before it may judge
ROTATE_CAMERA_MAX_DISAGREE_DEG=25.0
ROTATE_CAMERA_MAX_DISAGREE_FRAC=0.4
# First live run 2026-10-07: IMU 46 deg (owner: the turn was good) vs camera 17 deg -> stopped. The
# camera estimate under-reads; until the cause is found it can be set to log-only (False).
ROTATE_CAMERA_STOP=True
AVOID_CAMERA_CENTRE_DEG=5.0
AVOID_USE_ROTATION=True       # brain._avoid turns in rotation mode (rotate.py); False = the old skid turn   # a detection this close to dead ahead counts for neither side

# --- FR-1000-002 / FR-1200-005 multi-zone ToF (DFRobot SEN0628, Master Hardware Design §6.5).
# Front obstacle sensing ALONGSIDE the sonar, never replacing it: the two fail in opposite
# directions. Sonar is blind to chair legs, soft furnishings and angled surfaces; ToF looks
# straight THROUGH glass, which sonar reflects off perfectly well.
ENABLE_TOF=True             # fitted and answering (5/5 clean frames 2026-10-02). Reports NOTHING
                            # until scripts/calibrate_tof_floor.py has captured a floor profile.
TOF_POLL_S=0.05             # background reader cadence; a frame itself takes ~0.13 s
TOF_FRAME_MAX_AGE_S=0.5     # an older frame is no frame -> sonar alone
# 2026-10-10: the two ToF harnesses ended up swapped at the Pi header while the front sensor was
# being fixed. Proven with a palm over the FRONT sensor: it showed on ttyAMA0. Owner chose to follow
# in software rather than re-plug: FRONT = UART0 (pins 8 TXD0 / 10 RXD0), REAR = UART3 (24 / 21).
TOF_PORT='/dev/ttyAMA0'     # FRONT. UART, not I2C -- keeps it off a bus that took the whole rover down
                            # twice on 2026-09-07/08. CONFIRM the Pi 5 overlay->pin mapping first
                            # (§6.5): the Pi 4 mapping does not carry over to the RP1.
TOF_BAUD=115200             # fixed in the sensor's firmware, not configurable
TOF_ZONES=64                # 8x8. A frame of any other length is a desynchronised UART, not data
TOF_ZONE_COLUMNS=8          # zone index % this = column
# Which zone columns look LEFT (FR-1000-002 turn choice, avoidance.py). RE-MEASURED 2026-10-07 after
# the sensor was refitted in a new housing ROTATED 180 deg: an upright tin on Willie's left (front-
# camera photo as witness) showed in columns 0-1 only. LEFT = columns 0-3; row 7 is the BOTTOM of the
# view (near floor). Before the rotation it was columns 4-7 and row 0 at the bottom. ANY remount
# re-opens this -- re-run the tin test. None means "unknown" and turns the ToF's side input off.
# New housing: the 0-5 cm window-edge returns are gone (2026-10-07 baseline, nothing under 36 cm).
TOF_LEFT_COLUMNS=(0,1,2,3)
# Rows the floor profile keeps (scripts/calibrate_tof_floor.py); all others are NO_DATA. MEASURED
# 2026-10-07 in this mounting: rows 6-7 see floor at 37-60 cm, even across all columns, repeatable to
# a cm or two between captures; rows 0-5 see the room at 1.3-1.8 m. Tied to the mount like the
# columns -- re-check after a remount. None = keep every row.
# TRADE-OFF: NO_DATA zones never report an obstacle, so the ToF now sees only what blocks its view of
# the floor band (anything nearer than ~60 cm low down). Sonar still covers the rest.
TOF_FLOOR_ROWS=(6,7)
# Rows OUTSIDE the floor band (tof.py _is_obstacle, 2026-10-07: "why does he still bump into things"):
# anything nearer than this is an obstacle, no floor baseline needed. Those rows see the room at
# 1.3-1.8 m and meet the floor no nearer than ~86 cm, so 40 cm is well clear of both and matches
# DIST_SLOW. Catches a couch edge or table top at body height that the floor rows never see.
TOF_NOFLOOR_OBSTACLE_MM=400.0
# Floor-profile margin. A zone counts as an obstacle only when it returns this much SHORTER than
# its own stored floor distance, and as a drop when it returns this much LONGER (or nothing).
# Wide enough to absorb carpet pile, a rug edge and a few mm of ride height -- without a margin
# every surface change reads as an obstacle and he never moves.
TOF_FLOOR_MARGIN_MM=120.0
TOF_FLOOR_PROFILE_PATH='tof_floor_profile.json'
# REAR ToF (second SEN0628, 2026-10-10). Faces backward on the Pi 5 UART0 (dtoverlay=uart0-pi5,
# pins 8 TXD0 / 10 RXD0), 3.3 V from the DROK bus. Mounted UPSIDE DOWN relative to the front one,
# measured 2026-10-10: a hand over the top half showed in rows 5-7 and the floor is rows 0-1; a
# hand on Willie's LEFT showed in columns 0-3 (owner confirmed). Both handled in software.
ENABLE_TOF_REAR=True
# REAR CAMERA (vision.RearCamera, 2026-10-10). Opened on demand for rotation and reversing.
REAR_CAM_IDLE_CLOSE_S=5.0
REAR_CAM_RETRY_S=30.0          # after a failed open, do not retry every tick
REAR_CAM_DETECT_S=0.3          # rear detection rate while reversing (~3 Hz; the chip is shared)
REAR_CAM_NEAR_FRAC=0.6         # person box this tall (fraction of frame) = close behind -> stop reverse
REAR_CAM_STOP_CLASSES=('person','dog','cat')
TOF_REAR_PORT='/dev/ttyAMA3'   # REAR (swapped 2026-10-10, see TOF_PORT)
TOF_REAR_FLOOR_ROWS=(0,1)   # 2026-10-14: row 2 dropped -- he now sits nose-down and row 2 grazes the floor (540-1117 mm, erratic). Was (0,1,2): 2026-10-10: row 2 meets floor at 43-46 cm, only 3-6 cm past
                              # TOF_NOFLOOR_OBSTACLE_MM -- a little pitch would read as an obstacle
TOF_REAR_DROP_ROWS=(0,)          # 2026-10-14: row 0 only -- row 1 went empty across 5 columns while
                                 # driving (pitch). Was (0,1): only where returns are solid (row 2 grazes)
# FRONT drop rows (2026-10-14): row 7 only (~35 cm out, steady). Row 6 meets the floor at ~50 cm at a
# shallow angle; a degree or two of nose-up pitch while driving pushed it to 650-920 mm / nothing,
# so he flipped between ROAM and AVOID. Row 6 still counts for obstacles (TOF_FLOOR_ROWS).
TOF_FRONT_DROP_ROWS=(7,)
TOF_REAR_LEFT_COLUMNS=(0,1,2,3)     # WILLIE's left, not the sensor's
TOF_REAR_FLOOR_PROFILE_PATH='tof_rear_floor_profile.json'
TOF_PROFILE_SAMPLES=10

# FR-2300 GPS (gps.py, 2026-10-11): Adafruit Mini GPS PA1010D, I2C 0x10 via STEMMA QT, on the DROK
# 3.3 V bus. OPTIONAL: never in the self-test's required set, never feeds the stop (FR-2300-005).
ENABLE_GPS=True
GPS_ADDR=0x10
GPS_POLL_S=0.1              # 32-byte reads; the chip streams ~1 kB of NMEA a second
GPS_STALE_S=5.0             # a fix older than this is no fix
GPS_HOME_PATH='gps_home.json'
GPS_AT_HOME_M=15.0          # closer than this: "at home" (GPS is ~3-5 m at best)
GPS_HOME_RADIUS_M=50.0      # FR-2300-003 wander alert radius
GPS_WANDER_CONFIRM=5        # consecutive fresh fixes beyond (or back inside) the radius
GPS_ALERT_REPEAT_S=300.0    # while out of the home area, a position email every 5 min
GPS_LEARN_S=60.0            # "this is home": average this long
GPS_LEARN_MIN_FIXES=20
GPS_LEARN_MAX_SPREAD_M=15.0
TOF_STARTUP_IGNORE_DROP_S=3.0
TOF_DROP_CONFIRM_S=0.3          # front (since 10-14) and rear: a drop must persist this long (2+ frames) before it stops reversing   # no DROP verdicts for this long after a ToF starts giving frames      # frames averaged when capturing; one frame carries per-zone noise
                            # straight into the baseline everything else is measured against

# I2C bus 1 clock. THE KERNEL IS AUTHORITATIVE, NOT THIS CONSTANT -- the bus speed is set by
# dtparam=i2c_arm_baudrate in /boot/firmware/config.txt and needs a reboot. This value exists so
# sensors.py has one number to pass to busio.I2C() instead of a hardcoded literal that silently
# disagrees with the kernel, and so the intended speed is recorded somewhere a reader will find.
# Keep the two in sync by hand; scripts/i2c_bus_check.py reports the kernel's actual value.
#
# 100000 is the Pi default and what this bus has always run at. 400000 is a candidate worth
# ~4x on every transaction -- the BNO085 alone is polled at IMU_POLL_HZ=100 and clock-stretches,
# which costs more at the lower speed. It is NOT a free change: Master Hardware Design v2.0 s3.2
# computes ~2.2us to threshold from the Pi's 1.8k pull-ups into ~400pF of cabling, against a
# 2.5us bit at 400kHz. That is marginal on paper, and the LTC4311 accelerator is fitted for
# exactly this reason. Validate with scripts/i2c_bus_check.py (20 consecutive clean roll-calls,
# zero new kernel i2c errors) BEFORE leaving it raised. Revert on any device dropping out.
I2C_BAUDRATE=100000

IMU_ADDR=0x4A; IMU_TILT_LIMIT=25; IMU_TILT_WARN=18; IMU_POLL_HZ=100  # BNO085, §8.2/§8.5
# Hardware-reset recovery, 2026-10-01 (sensors.IMU._poll_once). 10 consecutive failed reads is
# 0.1 s at IMU_POLL_HZ -- long enough that one I2C hiccup never pulses RST, short enough that
# recovery starts before anyone notices. At most one recovery per 10 s: a chip that will not
# come back must not be hammered, and brain.py's SENSOR_FAULT already stops motion while the
# IMU is down (is_healthy goes false on its own deadline).
IMU_RESET_AFTER_FAILS=10; IMU_RESET_MIN_INTERVAL_S=10.0
# A quaternion unchanged for this long is a FAILED read, not a still rover. Measured 2026-10-01
# at rest: 101 distinct values in 10 s (~10 Hz reports), longest identical run 0.50 s. The case
# it exists for: a reset the driver did not cause leaves it returning its cached value forever
# with no error, so without this, tilt would freeze and nothing would notice.
# 2026-10-02: raised to 3.0 and judged on quaternion PLUS raw acceleration. On the blocks,
# perfectly still, the fused quaternion stayed bit-identical for up to 3.7 s with the service
# stopped (reports had dropped to ~5 Hz), so the 1.5 s quaternion-only check latched a false
# SENSOR_FAULT every ~15 s. Accelerometer noise changes whenever a report actually arrives.
IMU_STALE_S=3.0
# RST: see the note below. It is no longer an expander pin.
# IMU_RST_MCP_PIN REMOVED 2026-09-30 with the expander that hosted it. Section 4.7
# consequence 1 moves the BNO085 reset to Pico B GP15, open-drain against R4, exposed as
# an explicit acknowledged RST command over uart2-pi5. That direction was dead until
# 2026-10-01 -- cold solder joints on the one wire, Pi phys 7 to c27 -- and is now proven:
# PING, ID and BOGUS all answered. RST itself has not yet been sent.

# Steering — PCA9685 @0x42, CH0-3 and CH8-9 since 2026-10-05 (§3.1/§10). Servo mode (500-2500/1000-2000/900-2100us) is
# unconfirmed per-unit — default to the narrowest documented range so a narrow-mode servo can't
# be driven into a mechanical bind. Widen only after a bench check confirms a unit's real range.
# Steering kinematics (wheel-angle coordination, crab/point-turn) are undesigned in the master
# doc (§10: "pending in software") — this pass only centers all six and holds them there.
STEER_PCA_ADDR=0x42
# Channels as re-plugged by the owner 2026-10-05, each one MEASURED 2026-10-06: one channel swung
# 1000<->2000us at a time with the owner naming the wheel. Not a pattern -- the fronts and rears
# have right on the lower channel, the middles have left. Do not "tidy" it.
# 2026-10-06: INA260 0x40 showed NO current change while a steering servo swung -- the steering
# board's V+ was on the 6 V ARM rail. Moved to the 5 V bus after 0x40 on 2026-10-11; 0x40 now
# follows steering motion (0.08 -> 0.49 A on one servo's swing).
# 2026-10-12: the rear pair moved to CH4/CH5 (rear right showed no servo on CH8; found by a channel
# walk and the jig sweep). Fronts and middles unchanged.
STEER_LF=3; STEER_RF=2; STEER_LM=0; STEER_RM=1; STEER_LR=5; STEER_RR=4
SERVO_CENTER_US=1500; SERVO_MIN_US=1000; SERVO_MAX_US=2000
# Per-corner straight-ahead pulse. All six were mechanically re-horned straight at 1500us on
# 2026-10-05, so 1500 is measured, not nominal; the earlier trims (1800/1350/1270) are void.
# Fine-tune with scripts/steer_jog.py if a wheel is visibly off.
# MEASURED 2026-10-12 with the owner's alignment jig holding each side's wheels straight: each
# servo was swept 10 us at a time and the pulse where it stops pushing against the jig (the
# minimum of the 5 V current on INA260 0x40) is straight. Clean valleys on all six.
STEER_CENTER_US={'lf':1440,'rf':1440,'lm':1460,'rm':1320,'lr':1560,'rr':1630}
# Steering direction and scale, owner-measured 2026-10-07 by eye, each corner ALONE to 1700 us:
# all four corners point RIGHT for +us, ~15 deg per 200 us. The rear servos are mounted reversed
# from the fronts, but the wheel still went right -- measure, don't infer from the mounting.
# Middles not measured (rotation keeps them straight). 1 = +us turns the wheel right.
STEER_RIGHT_SIGN={'lf':1,'rf':1,'lr':1,'rr':1}
STEER_US_PER_DEG=200/15.0
# FR-600-004 manual steering override (steer_override.py, 2026-10-08): parked only, held until
# "wheels straight", a stop, or leaving IDLE. 37 deg = the full SERVO_MIN..MAX span at the
# measured scale (500 us / 13.3 us per deg); corner_us() clamps to the servo range as well.
STEER_OVERRIDE_MAX_DEG=37.0
STEER_OVERRIDE_DEFAULT_DEG=15.0  # "steer left" with no angle
SERVO_PWM_FREQ=50

# Arm — PCA9685 @0x43. Wider nominal range than steering (manufacturer spec 500-2500us) though
# §11.5/§20.6 flag cheap-clone units may bind before the full sweep.
ARM_PCA_ADDR=0x43
#
# CHANNEL MAP CORRECTED 2026-09-17 AGAINST HARDWARE. Every assignment below was verified by
# driving one channel at a time with the owner watching which joint moved. The previous map came
# from a 2026-09-06 paper reassignment that was never tested, and CHANNELS 0-3 WERE EXACTLY
# REVERSED in it -- it read shoulderA/shoulderB/elbow/wristPitch where the hardware is
# wristPitch/elbow/shoulder/shoulder. 4, 5 and 6 were already right.
#
#   CH0 wrist pitch   CH1 elbow   CH2 shoulder   CH3 shoulder (second servo of the pair)
#   CH4 wrist rotate  CH5 gripper CH6 base       CH7 unused, nothing connected
# RE-VERIFIED 2026-10-12, each channel driven alone with the owner watching.
#
# THE SHOULDER IS A PAIR, DRIVEN WITH THE SAME PULSE (2026-10-12). CH2 and CH3 are two servos on
# one joint, mounted facing each other. New servos fitted 10-12 (horns set at 1500us): each alone
# raises the shoulder as the pulse goes UP, and both at the same pulse held at ~0.1A and moved
# smoothly. arm.py writes every 'shoulder' command to both channels. Never drive them apart, and
# never mirror them (2x1500 - x): they would fight. The 09-17 note that they were "not a pair"
# was measured while one servo was dead (it drew no current at all on 10-12 until replaced).
# 2026-10-14 (owner): CH2's horn is loose (10-13) -- it moves nothing -- so the shoulder runs on CH3
# and CH2 is the passenger. With CH2 as primary, every hold and lowering move ran on the loose servo
# and the arm fell forward at the end of a stow. ARM_POSE_REST['shoulder'] (500) was CH2's pulse with
# the arm placed by hand: re-map the stow on CH3 with a camera before trusting it.
ARM_BASE=6; ARM_WRIST_PITCH=0; ARM_ELBOW=1; ARM_SHOULDER=3; ARM_SHOULDER_B=2
# 2026-10-13 (owner OK): the shoulder is driven by CH2 ONLY; CH3's servo stays unpowered and turns
# along as a bearing. Measured: moved gently together the pair agreed (<0.45 A over CH3 1360-1560),
# but after any jolt (a wave reversal, standing up, a 40 us jump) they settled apart inside their
# deadbands and locked at 2.9-5.8 A -- every arm jam that day. CH2 alone held the upright arm at
# 0.04 A. Set True to drive both again (same pulse; never mirrored).
ARM_SHOULDER_PAIR=False
# ...EXCEPT for the heavy moves (2026-10-13): CH2 alone could not lift the arm back from the floor
# reach (3.4 A); both servos stepped together ARM_PAIR_STEP_US every ARM_PAIR_STEP_S did it at
# 0.3-1.6 A. So every shoulder RAMP in a plan engages CH3 ('shoulder_pair' step), moves slowly,
# then drops CH3 again (grip.shoulder_ramp). Holding and the wave run on CH2 alone.
ARM_PAIR_STEP_US=25
ARM_PAIR_STEP_S=0.3
ARM_WRIST_ROT=4; ARM_GRIPPER=5
ARM_SERVO_MIN_US=500; ARM_SERVO_MAX_US=2500; ARM_SERVO_CENTER_US=1500
# Per-joint limits, clamped in arm.py on top of the servo range: {'joint':(min_us,max_us)}.
# Empty since 2026-10-13: ELBOW is now a DS3225 (270-degree travel, ~0.135 deg/us vs ~0.09 for the
# MG996R; owner: it holds its position unpowered), fitted 2026-10-13 and not yet mapped. Put each
# joint's measured stops here.
ARM_JOINT_LIMITS_US={'elbow':(800,1850),'wrist_pitch':(1075,1475)}   # elbow fold capped 1850 (owner 10-14)
# Limits that apply only while another joint is in a range: (joint, other, (other_lo,other_hi), (lo,hi)).
# 2026-10-13, owner, with the arm reaching down to the floor in front (shoulder forward of upright,
# lower us): the elbow opened down to 1300 keeps the hand off the wheels, and folded past 1850 the
# forearm presses into his front (1875 held 2.3 A). Upright and back, the elbow keeps its full range.
# Shoulder bound: reach pose measured at 1300 (hand at the floor), 1400 still forward of upright.
ARM_COUPLED_LIMITS_US=(('elbow','shoulder',(500,1400),(1300,1850)),)
# WRIST PITCH (horn refitted 2026-10-13): free 1050-1500 with the forearm level (0.14 A); 1000 and
# 1550 jammed at ~3.1 A. Every wave jam that day was the wrist driven past 1500.
# ELBOW 800: held the forearm out level without strain on 10-13 (owner's 1000 was not the end).
# ELBOW (DS3225, 2026-10-13, owner-set on the rover): 2050 = folded at rest, 1000 = fully open.
# Lower us opens it. Nothing outside that range is ever sent.
# Joints that keep their position with the pulses off (the DS3225 elbow, 2026-10-13). MEASURED: it is
# not limp -- with no pulse it keeps actively HOLDING its last position while the 6 V rail is on
# (all channels off still drew 0.1-1.1 A depending on the pose). So its last pulse still describes
# it after a release, and wherever it is left it keeps drawing whatever that pose costs -- stow
# must leave it where it does not press (ARM_POSE_REST elbow). Every other joint falls when released.
ARM_HOLDS_UNPOWERED=frozenset({'elbow'})
#
# Teaching arm poses by voice (teach.py, 2026-10-13). One jog = one step on one joint.
# ARM_POSE_EPOCH is stamped on every saved pose: BUMP IT whenever a servo or horn changes, and
# every pose taught before is refused instead of being replayed onto different hardware.
ARM_POSE_EPOCH='2026-10-14-ch3'   # shoulder now driven on CH3 (2026-10-14); was '2026-10-13-ds3225'
ARM_POSES_PATH='arm_poses.json'          # under WILLY_MEMORY_ROOT, on the rover only
ARM_TEACH_STEP_US=50
ARM_TEACH_STEP_SIZES_US={'small':20,'normal':50,'big':150}
ARM_TEACH_IDLE_S=180.0                   # teach mode ends after this long with no command
# Which way each spoken direction moves the pulse. shoulder: measured 2026-10-12 (higher = up).
# wrist pitch: measured 09-17 (higher lowers). gripper: measured (higher closes). Elbow, wrist
# rotate and base are NOT measured on the current servos -- if "up" goes down, flip the sign here.
ARM_TEACH_DIRECTIONS={
    'shoulder':{'up':+1,'down':-1},
    'elbow':{'up':+1,'down':-1},                       # unverified
    'wrist_pitch':{'up':-1,'down':+1},
    'wrist_rot':{'left':+1,'right':-1},                # unverified
    'base':{'left':+1,'right':-1},                     # unverified
    'gripper':{'open':-1,'close':+1},
}
# Where a joint not yet driven this boot starts when first jogged (its real position is unknown).
# Shoulder pair and elbow: where their horns were fitted on 10-12. Gripper: measured open.
ARM_TEACH_START_US={'shoulder':1500,'elbow':1500,'wrist_pitch':1500,'wrist_rot':1500,'base':1500,
                    'gripper':1150}            # = GRIP_OPEN_US (defined further down)
#
# Routines ("when I say X, do A, then B, then C"; teach.py). The next step starts once the brain
# has been free (IDLE, nothing queued, not speaking) for ROUTINE_STEP_GAP_S; a step that keeps it
# busy longer than ROUTINE_STEP_TIMEOUT_S abandons the rest.
ROUTINE_STEP_GAP_S=1.0
#
# Battery log (battery_log.py, owner 2026-10-13): every 2 h to a local CSV under WILLY_LOG_ROOT,
# then pushed to the public repo's 'battery-log' branch (owner's choice) from a separate clone,
# and posted to Home Assistant if the HA token file exists. Offline: the next cycle pushes it all.
ENABLE_BATTERY_LOG=True
BATTERY_LOG_INTERVAL_S=7200
BATTERY_LOG_FIRST_S=120          # first reading two minutes after start (unless a row is <2 h old)
BATTERY_LOG_HEARTBEAT_S=60       # running time is added to hours_on_charge this often (2026-10-14)
BATTERY_LOG_CHARGE_JUMP_V=0.3     # a rise this big between readings = he was charged
BATTERY_LOG_CSV='battery_log.csv'
BATTERY_LOG_BRANCH='battery-log'
BATTERY_LOG_REPO='https://github.com/hdhimmel/willy-rover.git'
BATTERY_LOG_CLONE="~/battery-log"
ROUTINE_STEP_TIMEOUT_S=300.0
ROUTINE_MAX_STEPS=10
#
# DO NOT CENTRE CH1. ARM_SERVO_CENTER_US applied to the elbow drives it into the top of Willy:
# the servo fitted before 2026-09-17 held ~8A there indefinitely and was destroyed by it. Any
# homing or park routine that centres every joint will stall the elbow on each startup.
#
# DIRECTIONS, owner-confirmed on hardware 2026-09-17 (shoulder re-measured 2026-10-12):
#   shoulder CH2+CH3 : INCREASING us RAISES (new servos 10-12 -- the OPPOSITE of the old servo,
#                  which raised with decreasing us; every shoulder value measured before 10-12
#                  is therefore wrong)
#   gripper  CH5 : INCREASING us closes, decreasing opens. LONGER FINGERS fitted by 2026-10-05:
#                  jaws now shut at ~2205us (0.39A); 2210us drew 0.49A = stalling. Widest open
#                  without load is 1150us (0.07A); the open stop is ~1100 and 1050us stalls at 0.8A. The ~1700us
#                  contact point and the current figures below are from the old, shorter fingers.
#
# GRIP FORCE IS SET BY CURRENT, NOT POSITION. Closing draws 0.075A at 1500us, 0.156A at 1650,
# 0.215A at 1700, 0.457A at 1750, 1.049A at 1780. Stop feeding past ~0.4-0.5A: it grips there,
# and beyond that it is stalling and heating. No position means "closed" -- the jaws close on
# whatever is held.
#
# MOVE, THEN KEEP HOLDING. Releasing a channel (off=0) makes the arm go limp and fold. Holding
# is nearly free -- the full waving pose below sits at ~0.33A -- while MOVING briefly costs amps.
# Release only when slack is actually wanted.
#
# ORDER MATTERS: open the elbow BEFORE moving the shoulder, or the arm strikes the top of Willy.
#
# Presets. WAVE_HELLO verified end to end on hardware 2026-09-17; the whole pose holds at ~0.33A
# on a 6.04V rail with every channel energised. Reach it in the order given, 50us steps on the
# shoulder -- not as a single jump, which would slam the joint.
ARM_POSE_WAVE_HELLO={'elbow':1000,'shoulder':1500,'wrist_pitch':1275}   # 10-13 new hardware: upright, held 0.18 A; wrist mid-range
#
# 2026-10-14 (owner): the shoulder gate (ARM_SHOULDER_POSES_VERIFIED, added 10-12 after the
# servo change) is REMOVED -- wave, stow, home, pick and knock run without it. The shoulder
# values here still date from before CH2's horn came loose on 10-13 and before the 10-15 servo
# swap; re-check them with a camera after the swap.
#
# REST pose, owner-designated 2026-09-17. TWO CAVEATS, both measured, neither yet resolved:
#
#  1. It does NOT hold for free. The wrist sits against its travel limit here and draws a
#     SUSTAINED 0.87A (~5.2W) for as long as the pose is held, with the 6V rail sagging to
#     6.017V. Every other pose today settled under 0.4A. A rest pose is held indefinitely by
#     definition, so this is the one place a standing load actually matters. Wrist at 2300us
#     holds the same shape for 0.23A and 2200us for 0.05A -- prefer one of those if the exact
#     wrist angle is not load-bearing.
#  2. The elbow value is OUT OF SPEC (manufacturer range is 500-2500us). Past about 2530us the
#     servo stopped responding -- peaks collapsed to ~0.1A -- so 2610 is very likely not a
#     position it actually reaches. Treat ~2530us as the real limit until re-measured.
# 2026-10-14 (owner): elbow 2050 folded too far in with the arm down -- the stow pressed into him
# and tripped the arm over-current (3.06 A, 10:39). Stow elbow 1825 = the fold measured 10-13 to
# hold at 0.12 A (1850 0.31 A, 1875 1.53 A, 1900 2.29 A); the elbow limit is capped at 1850.
# 2026-10-14 (owner go): shoulder 500 -> 2000. On CH3 lower us = FORWARD, so 500 made the stow
# stand the arm up and then extend it out in front again. 2000 = lying back on his top, measured
# 10-13 with both servos at one pulse (0.11 A; 2100 pressed into him at 3.2 A).
ARM_POSE_REST={'elbow':1825,'shoulder':1900,'wrist_pitch':1200}   # owner 10-14: 2000 stopped short -> 1900
# ⚠ SHOULDER STOW = 500, OWNER-SET 2026-10-13 EVENING (owner: "that is the stowed position for the
# shoulder -- don't forget it"): upper arm lying back over the REAR of his top. Confirmed with the
# laptop camera. Supersedes the 2000 above/below, which after the arm was jammed against his front
# no longer matched the real shoulder angle. Every other shoulder value (upright 1500, reach 1300,
# base-turn 1650) dates from before that and MUST be re-checked with a camera before it is trusted.   # elbow 1825->1800->1775 10-13 eve: stows left it pressing at 3.7 A
# 2026-10-13 STOW = lying back over the top (owner). Measured: arm up at shoulder 1500, elbow
# folded to 1950 (0.15 A; 2000 pressed at >2.5 A), then shoulder stepped back to 2000 (0.11 A,
# lying on his top; 2100 pressed into him at 3.2 A). Reached only in that order (brain._rest_plan).
# Refined the same day: the DS3225 elbow keeps HOLDING with the pulses off (it is not limp -- it
# holds its last pulse while the 6 V rail is on), so in stow it must not press: elbow 1950 held
# 0.60 A there, and folding UP to it (as stow does) 1875 held 1.53 A, 1900 2.29 A, 1850 0.31 A,
# 1825 0.12 A -> 1825. Wrist 1275 added ~1 A folded, 1200 nothing.
# ARM GEOMETRY (2026-10-14, for IK; pivot centre to pivot centre, mm). Upper arm and forearm are
# the ORIGINAL designs (hardware/arm/: the ducted reprints keep these lengths). The old 220 mm
# stretched forearm is retired. Upper arm hole line runs 10.9 deg off the part's long edge.
ARM_L1_MM=200.1               # shoulder pivot -> elbow pivot (Alt_Kol, from the STL)
ARM_L2_MM=220.0               # elbow -> wrist-pitch axle ON WILLIE NOW: the stretched forearm (owner
                              # measured 22 cm). The ORIGINAL On_Kol is 140.1 mm and CANNOT reach the
                              # floor past the front wheels at all (arm_ik.solve finds no pose,
                              # 2026-10-14) -- don't fit the 140 mm ducted print without stretching it.
ARM_HAND_TIP_CLOSED_MM=227    # wrist-pitch pivot -> fingertips, jaws closed (owner-measured)
ARM_HAND_TIP_OPEN_MM=180      # same, jaws open: the tips pull back 47 mm as the jaws open
ARM_SHOULDER_HEIGHT_MM=446    # floor -> shoulder pivot on the CURRENT body (owner); the new body changes it
ARM_BASE_OFFSET_MM=(0,0)      # base axis at the top centre of the body (owner): x forward, y left
ARM_FRONT_REACH_CLEAR_MM=215  # base axis -> front of the front wheels (430 mm chassis / 2)
ARM_SHOULDER_FWD_MM=0         # shoulder pivot ahead of the base axis (0: on the axis -- check)
ARM_GRIP_POINT_MM=165         # wrist-pitch pivot -> centre of an object in the open jaws. ESTIMATE
                              # (tips 180 mm open, minus a ball's radius); measure with a ball held
#
# VISION-GUIDED REACH (arm_ik.py, 2026-10-14, owner: "judge where an object is via the camera,
# move the arm there, verify with the camera"). None = not measured: the pick-up then falls back
# to the image-position line-up and says what is missing.
PICK_USE_IK=True
# Calibrated 2026-10-14 on the CURRENT body: ball at 6 taped spots 40-100 cm out
# (hardware/calibration/front_camera_2026-10-14.json). Height held at the taped 280 (a free fit
# gave 284); rms 12 mm on the floor. Nearest floor the camera sees: ~314 mm ahead of the lens
# (454 mm from the base axis) -- beyond the arm's reach band (220-380 mm).
CAM_FRONT_HEIGHT_MM=280       # floor -> front lens centre (owner tape)
CAM_FRONT_TILT_DEG=19.8       # optical axis below horizontal (fit)
CAM_FRONT_HFOV_DEG=71.4       # horizontal field of view of the 1280x720 detection frame (fit)
CAM_FRONT_X_MM=140            # lens ahead of the arm base axis (owner tape)
CAM_FRONT_Y_MM=0.0            # lens left of the base axis
# {joint: (us at 0 deg, us per deg)} in arm_ik.py's angle conventions (measurement sheet):
# base 0 = straight ahead (+ left); shoulder 0 = upper-arm hole line level forward (+ up);
# elbow 0 = straight (+ folding down); wrist 0 = in line with the forearm (+ curling down).
ARM_JOINT_CAL={'base':None,'shoulder':None,'elbow':None,'wrist_pitch':None}
ARM_ANGLE_LIMITS_DEG={'base':(-70,70)}   # extra angle-space limits; pulses are also held to ARM_JOINT_LIMITS_US
ARM_HAND_TILT_CHOICES_DEG=(0,15,30,45,60)  # hand from vertical, tried in order (more tilt = more reach)
ARM_IK_MARGIN_MM=10           # never ask for a fully straight or fully folded arm
ARM_IK_MIN_ELBOW_HEIGHT_MM=200  # elbow stays above the wheels / body edge
ARM_IK_MAX_GRIP_HEIGHT_MM=60  # grip at most this far above the floor (tall things: grip low)
# Keep-out boxes the whole arm must stay out of (every link, not just the joints, since 2026-10-14),
# centred on the base axis: (half length, half width, top above the floor), mm.
#   chassis + wheels: 430 x 400 mm, frame top 150 mm (owner)
#   body: front face ~170 mm ahead of the base axis and top = shoulder - 80 mm -- both ESTIMATES
#   for the current body; measure them (tape) before trusting a reach close to the body.
ARM_IK_KEEPOUT_MM=((215,200,150),(170,200,ARM_SHOULDER_HEIGHT_MM-80))
# LAST FIX + BLIND CREEP (2026-10-14, owner): the front camera's nearest floor (~450 mm) is beyond
# the arm's reach (220-380 mm), so: drive until the object is just above the bottom of the image,
# take that as the last good fix, creep the rest with it out of view (encoder distance, rf left out),
# reach to the remembered spot, then back off the same distance and look again to verify.
PICK_FIX_BOTTOM_FRAC=0.95     # box bottom this far down the frame = close enough for the last fix
PICK_MAX_BLIND_MM=220         # never creep further than this out of view
PICK_IK_TARGET_FRAC=0.8       # aim for this far across the reach band (0 near, 1 far): less blind creep
PICK_CREEP_PULSE_S=0.12       # one blind creep pulse at RETRIEVAL_CREEP_SPEED
PICK_CREEP_MAX_PULSES=40      # give up creeping after this many
PICK_CREEP_TOL_MM=10
PICK_CREEP_MM_PER_PULSE=10    # ESTIMATE, used only when the encoders are not healthy
ARM_STOW_UPRIGHT_US=1500        # shoulder: arm standing up, where the elbow folds/opens safely
ARM_BASE_TURN_SHOULDER_US=1650  # owner 10-13: shoulder raised/back while the base turns (hand high)
# ⚠ 2026-10-13 REPLACES the two caveats above (old servos). Re-measured on the new hardware:
# shoulder pair 1750 (10-12: the furthest back before the hand meets his front, held 0.05 A;
# then a release lets the arm settle into the fold), elbow 2050 (DS3225, owner-set as rest),
# wrist pitch 2300.
ARM_WAVE_WRIST_US=(1200,1350)  # inside the wrist's 1075-1475 (10-13); was 1380/1620   # oscillate the wrist between these, ~0.35s per leg, 4 cycles
ARM_WAVE_APPROACH_STEP_US=50    # shoulder step size travelling to the pose
ARM_WAVE_STEP_S=0.06            # time between shoulder steps (2026-10-02, brain._wave)
ARM_WAVE_CYCLES=4
ARM_WAVE_BASE_US=(1300,1700)    # owner 2026-10-13: base sways left/right after the wrist wave
ARM_WAVE_BASE_CYCLES=3
ARM_WAVE_BASE_LEG_S=0.6
ARM_WAVE_LEG_S=0.6     # 10-13: slower legs, the quick reversals jolted the shoulder pair
# Where the wave returns to: ARM_POSE_REST with the wrist at 2300us, the low-current variant noted
# under ARM_POSE_REST (0.23A vs 0.87A at 2450). The elbow is clamped to ARM_SERVO_MAX_US by arm.py.
ARM_REST_WRIST_US=1200   # 10-13: stow-measured (1275 pressed ~1 A with the arm folded)
#
# Any arm motion should watch INA260 ARM_6V current and release the arm when it stays above this
# for this long. A threshold checked only AFTER a move completes is useless -- that is how the
# first elbow servo was destroyed. ENFORCED since 2026-10-02 by brain._check_arm_current(), every
# tick (~20 Hz) rather than inside each movement loop, so it covers every arm motion. Arm.release()
# sleeps the whole PCA9685: EVERY arm channel goes limp, not just the straining one.
ARM_CURRENT_LIMIT_A=2.5
ARM_CURRENT_LIMIT_S=0.4
# FR-200-002 overcurrent, per INA260 rail (2026-10-02). Limits are 90% of the branch fuse
# (MHD §2.1: F2 10A motors, F4 10A DROK-5V), so software stops the load before the fuse goes.
# Held for OVERCURRENT_S, so a motor start or a steering slew does not trip it. The arm rail
# has its own, tighter limit above (servo protection, releases the arm).
# steering_5v trip RESTORED 2026-10-11. It was dropped 10-08 because 0x40 never saw steering
# current -- the cause, found by the owner: BOTH PCA9685 boards took V+ from the 6 V arm rail.
# The steering board (0x42) now feeds from the 5 V bus after 0x40; a front-left swing read
# 0.08 -> 0.49 A on 0x40 with 0x44 flat at 0.03 A (2026-10-11, wheel seen to turn).
OVERCURRENT_LIMIT_A={'bus_12v':9.0,'steering_5v':9.0}
OVERCURRENT_S=1.0

# Wheel encoders — Pico A over uart4-pi5 (§4.7). SIGNED x2 quadrature since firmware a-0.3
# (2026-10-01): both Phase A edges counted, Phase B sampled for direction; Phase B is alive on
# all six. ENCODER_COUNTS_PER_REV=763 is measured (one wheel, under power) -- see its own note.
# ENCODER_ADDR REMOVED 2026-09-30. The MCP23017 is off the bus; a live scan returns ten
# devices and none of them is 0x27. Encoder decode is Pico A's job now, over uart4-pi5.
PICO_A_DEVICE='/dev/ttyAMA4'   # uart4-pi5, Pi GP12/GP13 -- encoders + R5 rail sense
PICO_B_DEVICE='/dev/ttyAMA2'   # uart2-pi5, Pi GP4/GP5  -- sonar + BNO085 reset
# Identify a board by UID, never by port: the port follows the USB slot, not the board.
PICO_A_UID='643f69a756a232ea'
PICO_B_UID='ad25bbf0f1e1f160'
# $E arrives at 50 Hz. Ten missed frames before the encoders are considered unknown --
# at which point every wheel reads as stalled, which is the safe direction.
ENCODER_STALE_S=0.20
# R5 (the encoders' 3.3V rail) below Pico A's R5_WARN_MV (3000) for this long -> warn and name it.
# WARN ONLY, owner decision 2026-10-01: no stop on this. Nobody has measured the voltage these
# encoders quit at, and if they do quit, the stall and health checks already stop motion -- this
# makes the status and the stop reason say "encoder rail" instead of blaming six wheels, which is
# what the 2026-08-25 sag looked like. Grace so one low ADC sample does not raise it.
ENCODER_R5_GRACE_S=0.5
ENCODER_POLL_HZ=50.0
# MEASURED 2026-09-18 (E-1) -- LEFT AND RIGHT WERE TRANSPOSED, the same swap found on the
# motor boards the same day (see MOTOR_PORT above). The encoders were landed at the same time
# as the motors, so the same left/right confusion propagated into both. Master Hardware Design
# 7.2 predicted exactly this: the encoder column "may follow the physical wheels, or the port
# permutation, or neither".
#
# Method, SUPERSEDED 2026-09-29 and kept only because the reasoning still holds. It used to be:
# drive one wheel 1.0s and compare the MCP23017's resting state before and after, over six
# trials, because a pin on that wheel's encoder changes on most trials while one picking up PWM
# crosstalk changes rarely. That was a workaround for an I2C poll too slow to see edges.
# Pico A counts every edge in PIO, so the question is now answered directly: drive one wheel
# and read which channel's count moves. Done on blocks 2026-09-29, five wheels, unambiguous.
#
# DO NOT sample these pins in a tight loop looking for edges. At 0.6 duty the edge rate is
# ~7.7kHz and I2C polling tops out near 1.2kHz, which aliases to a CONSTANT reading -- that is
# why every earlier attempt concluded "no encoder produces any output", which was wrong.
#
# WARNING, PHASE B IS NOT VERIFIED AND CURRENTLY READS DEAD. Only the even pin of each pair
# (Phase A, yellow) produces transitions; every odd pin (Phase B, green) is silent except a
# flicker on A7. Six wheels failing on exactly the odd pin is one wiring pattern, not six
# faults -- trace the green wires before trusting any direction-aware decode. Until then the
# quadrature decode in sensors.py can count distance but cannot resolve direction.
#
# The encoder supply was found REVERSED on 2026-09-18 and corrected; lf went from 2/6 to 6/6
# on its Phase A immediately afterwards. Phase B did not recover, so those output stages may
# have been damaged by the reverse polarity -- the same failure that destroyed two sonars the
# previous day, on connectors reassembled during the same rebuild.
# ENCODER_PINS REMOVED 2026-09-30 with the expander. ⚠ AND IT WAS WRONG: it disagreed
# with the as-built landing in Master Hardware Design 16.6 by a left/right swap at every
# position, and the firmware's WHEELS tuple had inherited the same error. Proved on
# hardware 2026-09-29, one wheel at a time on blocks: driving lf counted on GP0/GP1, rf
# on GP4/GP5, lm on GP2/GP3, rm on GP6/GP7, rr on GP10/GP11 -- the as-built table, five
# for five. The order now lives in ONE place, firmware/pico_a.py's WHEELS, and reaches
# the Pi in the frame itself.
# 763 since Pico A firmware a-0.3 (2026-10-01): x2 quadrature, both edges of A with B sampled
# at each, SIGNED. That is exactly twice the x1 figure measured below the same day -- the same
# edges, both of them counted -- so it is derived from a measurement, not from a datasheet.
# The x1 measurement, for the record:
#
# MEASURED 2026-10-01: 382 counts per wheel revolution, on the fitted 170 RPM motors
# (JGA25-370-35.5K) and the then transport -- Pico A counting Phase A rising edges only (x1).
# Method: drove lf at 0.35 until Pico A had counted 3905, hard-braked (final 3911, 6 of coast);
# a tape mark on the tyre made 10.25 turns. 3911 / 10.25 = 381.6, +/- ~5 from judging the stop
# to an eighth of a turn. 2.3% under the 11 PPR x 35.5 = 390.5 prediction: the effective
# reduction is ~34.7:1, not the nominal 35.5. One wheel; the other five are the same part.
#
# MEASURE UNDER POWER, NOT BY HAND. Hand-turning lf ten times counted 459, then 0, while the
# same encoder counted ~475/s driven -- back-driving the gearbox slips the hub on the shaft.
# scripts/encoder_calibration.py's hand-turn method is not valid on this rover.
#
# THE CHAIN THIS ENDS, every link derived and none measured: 3292 ("823.1 PPR x4", a 74.8:1
# gearbox that never existed) -> 752 (11 x4 x 17.1, 2026-08-25) -> 422 (11 x4 x 9.6 from the
# vendor table, never set) -> 1562 (11 x4 x 35.5, assumed x4 quadrature this transport does
# not do). odometry.py divides by this, so at 752 every distance read 752/382 = 1.97x short.
#
# PHASE B WAS NEVER BROKEN ON THESE MOTORS: the dead greens were the old ones. Found alive on
# all six new motors 2026-10-01 and decoded from a-0.3 the same day. If the firmware ever moves
# to full x4, this doubles again (~1526) -- the frame format would not change, so re-measure.
ENCODER_COUNTS_PER_REV=763
# Which count sign is rover-FORWARD, per wheel. Pico A sends the board's raw sign; measured
# 2026-10-01 on a-0.3, each wheel alone on the block: +throttle -> +counts on all six. The
# motors are mirrored (MOTOR_SIGN), so forward is +counts on the left and -counts on the right.
# odometry.py applies this; Encoders.counts stays raw. Kept separate from MOTOR_SIGN because a
# swapped encoder pair on one motor would flip this and not that.
ENCODER_SIGN={'lf':1,'lm':1,'lr':1,'rf':-1,'rm':-1,'rr':-1}

# Odometry (§8, WildWilly_Claude_Fix_Implementation_Plan.md). This comment used to cite a
# "430x330x220mm chassis envelope (§2)" — that figure appears ONLY in
# docs/archive/WildWilly_Master_Engineering_Package_rev6.0.7.md, a superseded document the repo
# explicitly says not to cite as authoritative, and the current Master Hardware Design v2.0
# carries no chassis envelope at all. Owner measured the chassis at 400mm wide on 2026-08-25;
# the archived 430mm is stale. Neither figure is a track measurement anyway — no doc ever gave a
# wheel diameter or a track (L/R wheel-center spacing), so both constants below began as
# estimates derived from that retired envelope rather than from a caliper. odometry.py's pose output is dead-reckoning
# only (no slip correction, no fusion with the IMU heading) and will drift; re-measure these two
# values directly off the chassis before trusting distances/headings for anything beyond rough
# relative dead-reckoning.
WHEEL_DIAMETER_M=0.1016 # 4.00 in, owner-measured 2026-08-25. Was 0.065 (an UNCONFIRMED
                        # placeholder), so every distance odometry reported was 56% short of
                        # actual -- 0.204 m/rev assumed against 0.319 m/rev real. Anything
                        # derived from dead reckoning before this date is wrong by that
                        # factor, including stored world_model landmark positions.
                        # NOTE this is the nominal/unloaded diameter. The effective ROLLING
                        # diameter under the rover's weight is slightly smaller if the tyre
                        # compresses; a drive-a-measured-distance check is what settles that.
WHEELBASE_M=0.320      # front axle to rear axle, centre to centre, owner-measured 2026-10-07
TRACK_WIDTH_M=0.310     # Owner-measured 2026-08-25. 400mm overall width ACROSS THE WHEELS minus
                        # one 90mm wheel width: outer edges at +/-200mm put the wheel centrelines
                        # at +/-155mm, so track = 310mm. Was 0.28, which over-reported rotation by
                        # ~11% (odometry.py:36 divides d_heading by this, so too small a value
                        # makes him believe he turned further than he did).
                        # Chassis envelope, same measurements: 430mm long x 400mm wide across the
                        # wheels, wheels 90mm wide. Note the archived rev6.0.7 figure of
                        # "430x330x220mm" had the LENGTH right and the width wrong -- a reminder
                        # that a superseded citation is not automatically wrong in every part.
POSE_LOG_INTERVAL_S=5.0 # brain.py logs the current odometry pose at most this often
TICK_OVERRUN_THRESHOLD_S=0.15 # brain.py::run() logs+counts a TICK_OVERRUN when a single _tick()
                              # call takes longer than this (loop targets ~50ms sleep + tick time) --
                              # 2026-08-08 audit P1, pure visibility regardless of whether systemd's
                              # WatchdogSec ends up catching a hung loop on its own -- see brain.py's
                              # RoverBrain.__init__ comment for the unreconciled repo-vs-live-unit
                              # WatchdogSec=500ms discrepancy found 08-08, still unresolved.
                              # Raised from 0.1 2026-08-09 after this ran live for the first time:
                              # a sustained-brake state (battery shutdown/tilt/sensor fault) makes
                              # safety.py::emergency_stop() call motors.py::brake() every tick, which
                              # is 6 real per-wheel PCA9685 I2C writes -- that alone measured
                              # 100-134ms live (py-spy confirmed the cost is in
                              # adafruit_pca9685.duty_cycle's I2C write, not a bug). That write is
                              # intentional (safety.py's own comment: must reassert every tick to
                              # survive a noise-flipped register) so the threshold moved up to match
                              # real cost instead of the write being removed. Still tight enough to
                              # catch a genuine hang well above this range.
ESTOP_LOG_INTERVAL_S=5.0 # safety.py throttles emergency_stop()'s own log line to at most this
                          # often — the brake() call itself still fires every tick unconditionally,
                          # only the logging is throttled (found 2026-08-08: a sustained fault/tilt/
                          # battery-shutdown condition calls emergency_stop() every tick for as long
                          # as it persists, which had been flooding the log at ~20Hz with no limit —
                          # same class of bug as 516d1ec's memory.save_all_now() fix, just for a
                          # log line instead of a disk write, and missed by that pass since it lives
                          # in safety.py not brain.py)

# Current monitoring — INA260 x3 (§5.2). Monitor/log only (FR-1100 diagnostics) — no numeric
# overcurrent trip thresholds exist anywhere in the documentation to hardcode a cutoff against.
#
# 2026-08-24: ADDRESSES CORRECTED AGAINST LIVE MEASUREMENT. All three read directly off the bus
# with base power on and the self-test passing:
#     0x40 ->  5.148 V @ 0.136 A     0x44 -> 11.373 V @ 0.112 A     0x45 ->  9.068 V @ 0.002 A
# 0x40 matched its documentation exactly. The other two did NOT: the docs put the Pi's monitor on
# 0x44 (as a 5.0-5.1V Pi-buck rail) and the motor/+12V bus on 0x45. Measurement shows the opposite
# -- 0x44 is the ~11.4V bus and 0x45 is the Pi's supply. The 2026-08-23 power rework swapped them:
# the Pi is no longer fed 5V from the Pi buck, it is fed 9V (DROK -> Witty Pi VIN -> Pi), which is
# why 0x45 reads 9V rather than the old 5V and why it reads ~0A while the Pi runs on AC.
# So the original NAMES were right and only the ADDRESSES were transposed -- fixed by swapping the
# two address values below rather than renaming anything, which keeps every existing caller valid.
# Owner-confirmed. Master Hardware Design v2.0 §2.2/§16.4 updated to match.
#
# ⚠ SUPERSEDED 2026-09-15 -- AND NOTE WHY, because it is not "the docs were wrong".
# The 2026-08-24 readings above were CORRECT FOR THE WIRING OF THAT DATE. Re-measured 2026-09-15:
#     0x40 -> 4.986 V @ 0.526 A     0x44 -> 6.043 V @ 0.037 A     0x45 -> 11.174 V @ 0.019 A
# 0x44 moved from the +12V bus (11.373V) to the 6V arm rail, and 0x45 moved from the 9V Pi feed
# (9.068V) to the +12V bus. The monitors were PHYSICALLY RELOCATED between those dates -- there is
# an unmerged branch named docs/eplzon-rev3.2-ina260-relocation -- and neither this file nor the
# design docs were updated to follow. R1's 9V now has no INA260 at all; the Witty Pi HAT monitors
# its own VIN (owner-stated 2026-09-15).
#
# LESSON, and it is the expensive kind: a constant whose NAME encodes a consumer ("motor", "pi")
# silently becomes a lie when the wire moves, and nothing fails loudly. brain.py went on reading
# the rail called 'motor' for three weeks while that monitor sat on the arm supply. The names
# below now encode VOLTAGE, which is a property of the rail rather than of our intent for it.
# When an INA260 is relocated again, re-measure all three and rename to match -- do not assume
# the old name still describes the new wire.
# ---------------------------------------------------------------------------------------------
# INA260 IDENTITIES — CORRECTED AND RENAMED 2026-09-15, owner-stated, measurements agree.
#
# The old names (INA260_SERVO_ADDR / INA260_MOTOR_ADDR / INA260_PI_ADDR) were wrong about which
# rail two of the three watched, and the wrongness was not cosmetic: brain.py's motor-power-cut
# detector read the rail named 'motor' and was therefore watching the ARM rail. See the note on
# INA260_ARM_6V_ADDR below. Three mutually inconsistent mappings existed simultaneously -- these
# constants, sensors.py's class comment, and sensors.py's own _RAILS dict -- which is precisely
# how the error survived two separate identification passes (2026-09-13 and 2026-09-14).
#
# Names are now RAIL-DESCRIPTIVE rather than consumer-descriptive. "Servo" was ambiguous the
# moment arm servos moved to their own 6V rail; "motor"/"pi" were simply incorrect. A name that
# states the voltage cannot drift away from the hardware the way a name stating a purpose can.
#
# Measured 2026-09-15 with the pack at 11.36V (owner meter):
#     0x40 -> 4.986V     0x44 -> 6.043V     0x45 -> 11.174V
INA260_5V_ADDR=0x40      # R2, 5V (DROK-5V, replaced FEICHAO UBEC 2026-08-28) -> steering servos
                         # + sonar VCC + Pi screen. VERIFIED 5.148V; read 4.986V on 2026-09-15.
                         # Wired inline, so the rail passes through it: this device can stop
                         # ACKing on I2C while still passing power perfectly (seen 2026-08-24 --
                         # dropped off the bus, came back after the wiring was physically handled,
                         # which points at a marginal logic-side connection, not a dead chip).
INA260_ARM_6V_ADDR=0x44  # R3, 6V (DROK-6V) -> arm servo distribution. Reads 6.043V, which matches
                         # the DROK-6V's 12V->6.0V spec and nothing else in the system.
                         # ⚠ THIS IS NOT THE MOTOR BUS. It was named INA260_MOTOR_ADDR until
                         # 2026-09-15 and brain.py::_motor_rail_status() read it believing it was
                         # the +12V motor bus. That broke in both directions: a real motor-power
                         # cut collapses the 12V bus and leaves this rail untouched, so the cut
                         # was UNDETECTABLE; and this rail idles at 6.043V against a 6.0V
                         # threshold, so 43mV of arm-servo droop raised a false "motor rail lost".
INA260_BUS_12V_ADDR=0x45 # +12V bus (battery via F1/SW-MAIN/Q1) -> both FeatherWing VIN. Reads
                         # 11.174V against an owner-metered pack of 11.36V -- the ~0.19V delta is
                         # the fuse and switch drop. This is the rail brain.py watches for a
                         # motor-power cut.
                         # Was named INA260_PI_ADDR and documented as "DROK 9V -> Witty Pi VIN".
                         # It is NOT the 9V rail: R1's 9V is monitored by the Witty Pi HAT itself,
                         # not by any INA260 (owner-stated 2026-09-15). The old "reads ~0A when
                         # the Pi runs on AC" note explained the low current under the wrong
                         # premise; the real reason is that this bus only draws when motors do.

# Witty Pi 5 HAT+ (UUGear) — RTC and power management. Uses only SDA/SCL (per its own user
# manual), no other GPIO — confirmed no conflict with anything else on this bus. Physically
# installed, `wp5`/`wp5d` software installed and configured 2026-08-21: power source priority
# VUSB first (matches wiring — Pi powered via USB-C, then Witty Pi outputs that same 5V to the
# Pi via its own VUSB output). "Default state when powered" set to ON with a 2s delay (so Willie
# boots when power is connected), hardware watchdog enabled at 200 missed heartbeats (~10-20s).
# ENABLE_WITTY_PI now True — 0x51 is included in brain.py's _EXPECTED_I2C self-test set.
# Witty Pi's 9V input comes from DROK-Pi (9V adjustable buck, R1). The HAT monitors that VIN
# itself -- no INA260 sits on R1 (corrected 2026-09-15; this line previously credited
# INA260_PI_ADDR, which is now INA260_BUS_12V_ADDR and watches the +12V bus instead).
# The manual's low-voltage-threshold registers (#22/#23) monitor VIN; exact thresholds are not
# live-tested. The existing software battery-tier system (config.BAT_SHUTDOWN_V, battery-voltage
# ADC) remains the primary safety mechanism.
ENABLE_WITTY_PI=True
WITTY_PI_ADDR=0x51

ADS_ADDR=0x48; ADS_CH_BATTERY=0  # AIN0 = battery divider. A1 spare (FSR402 removed 2026-10-04).
# GRIPPER POSITION FEEDBACK on AIN2 (2026-10-04, replaces the FSR402). The gripper MG90S (arm CH5)
# is modified: a wire is soldered to its pot wiper and runs to a 47k/47k divider + 100 nF at the
# ADS1115 end (MHD §6.6). The divider is there because the wiper swings toward the 6V arm rail and
# the ADS1115 runs on 3.3V. 47k keeps the load on the servo's own pot to ~1%. Not yet calibrated:
# scripts/grip_feedback_curve.py records wiper volts against commanded us.
ADS_CH_GRIP_FB=2
GRIP_FB_DIVIDER_SCALE=0.5  # 47k/(47k+47k); ADS1115 input impedance pulls the reading ~0.4% low
# Gripper end points with the longer fingers, measured 2026-10-05 (see the CH5 note above).
# Measured 2026-10-11 (owner watching, arm held clear of the body): fully open 1150 us (feedback
# ratio 0.189), fully closed 2150 us (ratio 0.451; the owner's hand-closed reading was 0.446).
# Free travel between them draws no extra current; pressing past 2150 starts to. Feedback is
# linear, ~0.00026 ratio per us. 2205 was a squeeze past closed.
GRIP_OPEN_US=1150; GRIP_CLOSED_US=2150
GRIP_OPEN_WIDTH_MM=73   # jaw gap at GRIP_OPEN_US, owner-measured; 0 at GRIP_CLOSED_US
# 2026-10-14: every grasp "stopped near 1150 us" (fully open) -- the feedback never moved, so a dead
# or misread feedback looked like an object in the jaws. The jaw is open when closing starts, so the
# first reading must be near the open ratio measured 2026-10-11 (0.189); otherwise the feedback is
# not trusted and the close is unsensed (fixed close + the camera check after the lift).
GRIP_FB_OPEN_RATIO=0.189
GRIP_FB_SANE_TOL=0.06
# Grasp with feedback (grip.py, 2026-10-08). Feedback = A2 wiper / arm rail volts (ratio), so the
# 10-05 run-to-run shift with the rail drops out. Starting values -- to be checked against the A2
# curve (scripts/grip_feedback_curve.py) on the rover before fetch is switched on.
GRIP_CLOSE_STEP_US=30         # close this far per tick
GRIP_STALL_STEPS=3            # jaw not following for this many steps = blocked by the object
GRIP_FB_MIN_DELTA=0.004       # ratio change that counts as "the jaw moved" over those steps
GRIP_MIN_TRAVEL_US=90         # ignore the first few steps (servo starting to move)
GRIP_SQUEEZE_US=40            # hold this far past where the jaw stopped: grips, and lets hand-off be sensed
GRIP_UNSENSED_US=1800         # no feedback: close only this far (well short of the 2210 stall)
# Hand-off (FR-1700-006), set 2026-10-15 from the 10-11 calibration (re-checked 10-15: open 0.195,
# closed 0.46): ~0.00026 ratio per us, so the GRIP_SQUEEZE_US the jaw is held past the object is
# ~0.010 of travel when the object is pulled out. The old 0.01 threshold needed ALL of it -- a
# take could easily read short. Now 60% of it, toward CLOSED only (the jaw closes when the object
# leaves), on GRIP_HANDOFF_READS readings in a row, measured from the hold at the hand-off
# itself, not from the grasp (carrying can shift the object in the jaws).
GRIP_FB_PER_US=(0.451-0.189)/(2150-1150)
GRIP_HANDOFF_DELTA=round(0.6*GRIP_SQUEEZE_US*GRIP_FB_PER_US,4)   # ~0.0063
GRIP_HANDOFF_READS=3
GRIP_RAIL_MIN_V=5.0           # arm rail below this = no trustworthy ratio
# Reach-down pose for the floor, MEASURED 2026-10-13 with the owner: upper arm flat forward over
# the top, forearm straight down, hand at the floor just in front of the right-front wheel; held
# 0.27 A. Elbow 1300 is the owner's limit that keeps the hand off the wheel.
ARM_POSE_REACH={'shoulder':1300,'elbow':1300,'wrist_pitch':1275,'base':2200}
# base 1950 (2026-10-13, aimed with Willie's own front camera): at 1500 the hand lands beside the
# right-front wheel, outside the camera's view; stepping the base up brought it in from the right
# edge and at 1950 the open jaws were on the object at RETRIEVAL_TARGET_XY. 1400 pressed (4.4 A).
# base 2200 (owner, same evening): reach on his LEFT, where the front camera can see the hand --
# at 1950-2000 the forearm hid the hand and the ball. At 2200 the jaws land at image (0.26,0.93),
# holding 0.05 A. The base only ever turns with the arm UP (turning at the floor swept balls away).
# FR-1000-006 knock at a shut door (knock.py, 2026-10-08). Pose NOT MEASURED: jog it with
# scripts/arm_jog.py, owner watching, arm pointing at a door from ARM_KNOCK_STANDOFF_CM, then set
# e.g. {'shoulder':..,'elbow':..,'wrist_pitch':..}. Until then the navigator asks only. The tap
# is a fixed wrist-pitch flick: low current, and its sign (toward the door) is checked with the pose.
ARM_POSE_KNOCK=None
ARM_KNOCK_TAP_JOINT='wrist_pitch'
ARM_KNOCK_TAP_US=150            # tap amplitude; sign = direction, confirm when the pose is measured
ARM_KNOCK_TAPS=3
ARM_KNOCK_TAP_S=0.25            # per half-tap
ARM_KNOCK_STANDOFF_CM=(15,35)   # sonar front distance a knock may start from; not measured
# Re-trimmed 2026-10-01: AIN0 read 2.7653V (raw ~22120, 40 samples) against the pack metered at
# 11.37V at the divider input. Scale = 2.7653/11.37 = 0.2432 -- within 0.4% of the 10k/3.197k
# = 0.2423 that Master Hardware Design §16 specifies. The divider now matches its design.
#
# WHY IT MOVED: the 2026-09-17 trim (0.3237, ~10k/4.7k) was measured against the OLD bus node
# board, whose low side was ~4.7k rather than the drawn 3.2k. The rev 15.1 board is built to the
# drawn value (MHD §6.2), which already flagged 0.3237 as wrong for it. Nobody re-trimmed, and
# the stale 0.3237 read a healthy 11.37V pack as 8.53V: below BAT_SHUTDOWN_V, so Willie walked
# IDLE->SHUTDOWN on his own. A scale change this size is a divider change, not drift.
# ONE-POINT calibration: §6.2 asks for two points across the range -- repeat near 12.6V
# (full) and near 10.5V when the chance arises.
#
# HEADROOM: at PGA ±4.096V the ADC now represents up to 4.096/0.2432 = 16.8V, so a full or
# on-charger 3S pack (12.6V) reads correctly. The 12.65V ceiling of the 0.3237 era is gone.
#
# Previous values: 0.2481 (MCP3008-era), 0.2865 (2026-08-02), 0.2386 (2026-08-16),
# 0.3237 (2026-09-17, old bus node board). If this ever disagrees with a meter again, check the physical
# divider connection before recalibrating.
BATTERY_DIVIDER_SCALE=0.2452   # 2026-10-10: NEW divider board 10k/3.3k; A0 2.9983V vs metered pack 12.23V (one point; second point when the pack is ~11V)

# Battery threshold ladder (§13.2) — one-way toward safer states until voltage recovers above
# the next threshold up + hysteresis. Supersedes the old flat BAT_LOW/BAT_CRITICAL pair.
#
# BAT_FULL_V is a *display-only* 100% anchor for the battery_pct linear map (sensors.py
# ADC.battery_pct) — not a true full-charge voltage. A fully charged 3S LiPo open-circuit/rested
# reads ~12.6V; 11.39V is what this pack read *under load* while driving at calibration time
# (§13.2). battery_pct is cosmetic (HUD/voice announcements only) — every real safety decision
# in brain.py compares raw measured voltage against BAT_WARN/RTH/SAFE/SHUTDOWN_V directly, never
# battery_pct. Don't treat voltage-under-load as equivalent to open-circuit/rested voltage if
# these thresholds are ever recalibrated from a bench (unloaded) reading.
BAT_FULL_V=12.6       # display-only 100% anchor for battery_pct. 2026-10-10: was 11.58, an under-load
                      # divider figure; battery_volts is now bus+drop ~= the pack, so 3S full = 12.6V
# PLAUSIBILITY FLOOR. Below this, the reading is not a flat pack -- it is a broken sensor, and
# sensors.py refuses it instead of letting it drive the shutdown ladder.
#
# Why this exists: the 2026-08-24 change stopped a FAILED read from zeroing the value, because a
# loose I2C wire had made "the bus hiccupped" indistinguishable from "the pack is flat" and
# Willie powered himself off. It did not cover a SUCCESSFUL read of an impossible value, and
# that happened for real -- an unfed battery divider read A0 at 0.0146V, which scales to a pack
# voltage near 0.06V, passes every guard, and walks the ladder straight to shutdown.
#
# 5.0V is chosen to be unarguable rather than tight. The Pi runs from this same pack through
# DROK-Pi; at 5V a 3S pack is destroyed and nothing would be executing this code. It sits well
# BELOW BAT_SHUTDOWN_V on purpose -- a genuinely flat pack must still shut the rover down, so
# raising this above the shutdown threshold would disable the protection the ladder exists for.
BAT_IMPLAUSIBLE_V=5.0
BAT_WARN_V=11.1       # -> warn. 2026-10-10 (owner): was 11.4 = ~3.8V/cell, about HALF charge; 11.1 = 3.7V/cell, ~30%
BAT_RTH_V=10.8        # -> graceful halt while ENABLE_DOCKING=False; return-to-home / DOCK otherwise
BAT_SAFE_V=10.5        # -> SAFE_MODE (motion stop, arm holds)
BAT_SHUTDOWN_V=10.2   # -> controlled shutdown; also the 0% anchor for battery_pct
BAT_HYSTERESIS_V=0.2
# DOCKING IS DEFERRED (owner, 2026-10-01). With no dock, the 'rth' tier has nowhere to return
# to, so it runs FR-200-005's proactive graceful shutdown instead of driving DOCK. Flip this
# only when a dock and a route to it exist.
ENABLE_DOCKING=False
SONAR_FAULT_DEBOUNCE_S=2.0   # FR-800-004: a sonar must fail (or recover) for this long to be reported
# FR-1000-003 IMU heading in odometry (2026-10-02). OFF until checked on the rover: the BNO085's
# mounting sets the sign of its yaw relative to odometry's (CCW-positive) heading. To enable:
# turn left on the spot, confirm odometry heading and IMU.heading both increase (else set
# IMU_YAW_SIGN=-1), then set ODOM_USE_IMU_HEADING=True.
ODOM_USE_IMU_HEADING=False
IMU_YAW_SIGN=1
# FR-1000-006 search sweep: look for PURSUIT_LOOK_TICKS ticks, then turn PURSUIT_SEARCH_TURN_S,
# up to PURSUIT_SEARCH_STEPS times. Skid-turn timing is uncalibrated -- tune on the floor.
PURSUIT_LOOK_TICKS=10
PURSUIT_SEARCH_STEPS=8
PURSUIT_SEARCH_TURN_S=0.4
# FR-1200-005/006 stairs (2026-10-02). Owner decision 2026-09-11: in floor mode Willie holds
# STAIR_STANDOFF_M clear of a mapped stair edge. Stairs are labelled by voice ("stairs ahead")
# with Willie facing them; the edge is placed STAIR_LABEL_AHEAD_M in front of his centre.
# The standoff is only as good as odometry -- dead-reckoning drift moves the edge with it.
STAIR_STANDOFF_M=0.15
STAIR_DEFAULT_WIDTH_M=0.9
STAIR_LABEL_AHEAD_M=0.30
MOBILITY_MODE='floor'   # FR-1200-002: power-on default; 'stair' mode is not built
# A battery-tier halt (FR-200-004/005) powers the Pi off, so it must not fire on a transient:
# the reading has to stay below the tier's threshold, with the rover already stopped, for this
# long. Motors stopped means load sag has recovered, so this is close to a resting reading.
BAT_HALT_CONFIRM_S=10.0

# --- Battery cross-check (added 2026-09-15) -------------------------------------------------
# Two independent sources exist for pack voltage and until now nothing compared them:
#   * the ADS1115 divider on A0 -- the authority, because it taps V21 on the PACK side and keeps
#     reading no matter what is switched off downstream;
#   * INA260 INA260_BUS_12V_ADDR -- factory-calibrated, no divider, no scale constant.
# On 2026-09-15 they read 0.09V and 10.97V simultaneously for hours and nobody noticed until a
# diagnostics run happened to be read by eye.
#
# WHAT THIS ACTUALLY BUYS, and it is not the case you would first think of. A grossly wrong ADC
# reading is ALREADY caught: accept_battery_raw() rejects anything below BAT_IMPLAUSIBLE_V=5.0V
# and brain.py escalates the staleness through SENSOR_FAULT. The dangerous case is the one that
# passes that floor -- a divider drifting or partially failing so it reports, say, 7.5V from an
# 11.2V pack. That is plausible, so it is adopted, and it walks the tier ladder to rth/safe and
# eventually shutdown. Willie returns home or powers off for no reason, and the log says low
# battery. THAT is what a second opinion catches.
#
# DETECTION ONLY, exactly like _check_motor_rail(): it logs and shows on the face, it never
# stops, faults, or touches the tier. The whole point is not to add a new automatic halt path to
# a rover whose battery sensing is the thing under suspicion.
BAT_CROSSCHECK_MAX_DIFF_V=1.5
# Must clear the LEGITIMATE difference between the two taps, not just sensor noise. The bus sits
# downstream of F1/SW-MAIN/Q1 (and, per §2.1's P3 row, SW-M), so it reads lower than the pack by the
# drop across them: measured 0.19V at 16mA idle on 2026-09-15. Under motor load that drop grows,
# and nobody has measured how much yet -- M-1/E-1 will produce that number, and this value should
# be TIGHTENED once they have. 1.5V is deliberately loose to start: a false "your battery sensor
# is lying" during first driving would be worse than a slightly late catch.
BAT_CROSSCHECK_GRACE_S=5.0   # sustained disagreement before reporting -- rides out motor inrush

# Diagnostics/logging (FR-1100) — rotating file log alongside the existing journal output;
# the journal is ephemeral (rotates per systemd-journald policy), this file persists independently.
# §13: the directory itself is now WILLY_LOG_ROOT above (was a bare 'logs' joined against the
# script's own directory here — that join now happens once, in storage.resolve_root()).
LOG_FILE='willy.log'
VOICE_MAX_SPOKEN_CHARS=320       # ~20 s of speech; longer replies are cut at a sentence end (2026-10-15)
VOICE_PLAY_MARGIN_S=5.0          # playback limit = the reply's own length + this
# Yes to a question he asked (explore permission). 2026-10-15: "yes" answers were logged only as
# "declined"; widened, and the answer text is now logged so a miss can be read.
ASK_YES_WORDS=('yes','yeah','yep','yup','yah','ya','yea','sure','okay','ok','alright','fine','absolutely',
               'definitely','certainly','please','go','course')
ASK_NO_WORDS=('no','nope','nah','not',"don't",'dont','later','stop','wait','never')   # any of these = no, whatever else was said
ASK_YES_PHRASES=('go ahead','go for it','do it','you can','you may','of course','all right','uh huh','why not')
VOICE_FOLLOWUP_S=6.0       # 2026-10-15 (owner): after his reply he listens this long with no "Hey Willie" (0 = off)
VOICE_FOLLOWUP_PREROLL_BLOCKS=6   # ~0.5 s kept from before speech is detected, so the first word isn't cut
VOICE_LOCAL_AI_MAX_S=8.0  # 2026-10-15: the local model's typical answer is ~5 s; past this he asks the cloud instead of waiting (30-39 s seen)
# FR-2400 engagement words (2026-10-15). The cloud writes the line; these fill in when it is slow,
# offline or returns junk. Keys: topic kind, or kind_about for callback/change. {fields} come from
# Topic.facts; a template whose fields are missing is skipped.
ENGAGE_WORDS_TIMEOUT_S=3.0
ENGAGE_LINE_MAX_CHARS=200
ENGAGE_TEMPLATES={
    'greet_known':["Hi {name}!","Hello {name}, good to see you.","Hey {name}!"],
    'greet_known_back':["Hi {name}! I last saw you {when}.","Hello again, {name}. Last time I saw you was {when}."],
    'greet_stranger':["Hi, I'm Willie! What's your name?"],
    'ask_room':["What room is this?","Can you tell me what room I'm in?"],
    'ask_thing':["Whose {thing} is that?","Is that someone's {thing}?"],
    'callback_seen':["{who}! I last saw you {when}.","Hello again, {who}. Last time I saw you was {when}."],
    'callback_thing':["There's {label}. I last saw it {when}."],
    'callback_note':["{name}, last time you told me you {note}. How did that go?"],
    'change_new':["I haven't seen a {thing} in the {room} before."],
    'change_missing':["{label} isn't in the {room}. It was here {when}."],
    'ask_person':["How's your day going, {name}?","What have you been up to, {name}?"],
}
# FR-2400 engagement rules (2026-10-15, owner: idle + roaming, moderate, all four topic kinds,
# friendly to strangers). See docs/superpowers/specs/2026-10-15-engagement-design.md.
ENABLE_ENGAGEMENT=True
ENGAGE_STATES=('IDLE','ROAM','SLOW')
ENGAGE_GAP_S=300.0              # at most one non-greeting topic this often
ENGAGE_VISIT_S=1800.0           # unseen this long = the next sighting is a new visit (greet again)
ENGAGE_STRANGER_CONFIRM_N=3     # consecutive face scans with an UNKNOWN face before he says hello
ENGAGE_ASK_ROOM_GAP_S=3600.0
ENGAGE_ASK_PERSON_AFTER_S=120.0 # greeted this long ago and still here -> may ask about their day
ENGAGE_CALLBACK_MIN_H=2.0       # 'last time I saw you' only if it was at least this long ago
ENGAGE_MISSING_H=4.0            # a thing usually here, unseen this long while he has looked
ENGAGE_LOOK_ROOM_S=60.0         # ...and he has been in this room at least this long
ENGAGE_THING_CLASSES=('sports ball','frisbee','teddy bear','cup','bottle','wine glass','bowl','backpack',
                      'handbag','suitcase','umbrella','cell phone','remote','laptop','book','scissors',
                      'kite','skateboard')
ENGAGE_TURN_MIN_DEG=15.0
ENGAGE_MAX_S=20.0
ENGAGE_LOOK_S=2.0               # IDLE: run a detection this often for engagement
VOICE_REOPEN_MAX_S=60.0   # 2026-10-15: a failed mic stream is reopened (2,4,8.. s, capped here) instead of going deaf
VOICE_PLAY_FALLBACK_S=30.0       # if the length cannot be read
LOG_MAX_BYTES=5_000_000; LOG_BACKUP_COUNT=10   # 2026-10-15 (owner): keep more (still swept at DATA_RETENTION_DAYS)

# World model (§9/§10, WildWilly_Claude_Fix_Implementation_Plan.md) — spatial/semantic memory,
# a separate SQLite file from memory.db per the master doc's §13.4 storage design ("SQLite on
# the SSD = spatial/semantic memory... live source of truth").
WORLD_MODEL_DB_PATH='world_model.db'
OBSTACLE_MAX_AGE_S=30.0      # Layer-1 local obstacle points older than this are dropped, never persisted
ROOM_MATCH_RADIUS_M=1.5      # default Room radius when add_room() isn't given one
OBJECT_DEDUPE_RADIUS_M=0.5   # repeated detections of the same class within this radius merge into one Object
# Sonar mounting bearing relative to chassis forward (0deg, matches odometry.py's heading
# convention) — UNCONFIRMED placeholder, no bench measurement exists in any doc for how the side
# sonars are actually angled. Used to project a sonar hit into a world (x,y) point via the
# current pose (mapping.py). Re-measure off the chassis before trusting mapped obstacle positions.
SONAR_BEARING_DEG={'front':0.0,'left':-90.0,'right':90.0}

# Navigation (§11, WildWilly_Claude_Fix_Implementation_Plan.md) -- local planner tunables for
# navigation.py's Navigator. No bench-measurement basis for these two (same "UNCONFIRMED
# placeholder" caveat as WHEEL_DIAMETER_M/TRACK_WIDTH_M above) -- reasonable starting guesses.
NAV_ARRIVAL_RADIUS_M=0.3       # how close counts as "reached" a waypoint
# FR-1000-006 shut door (come-to-me design §4.7), ask-only -- the knock is not built.
# Blocked counts as a door only at a LABELLED doorway waypoint and within this radius of it. Wider
# than NAV_ARRIVAL_RADIUS_M because a shut door stops him DIST_STOP short of the doorway point,
# plus however far the label sits from the door leaf.
DOOR_BLOCKED_RADIUS_M=0.8
DOOR_WAIT_S=15.0               # between asks, re-checking front clearance every tick
DOOR_MAX_ASKS=3
NAV_HEADING_DEADBAND_DEG=15.0  # within this heading error, drive forward instead of turning first
NAV_TURN_STEP_S=0.2            # duration of each incremental heading-correction turn while seeking

CLAUDE_MODEL='claude-sonnet-5-5'   # owner decision 2026-10-02: Claude (not Gemini) is the cloud provider
CLAUDE_MAX_TOKENS=2000; CLAUDE_ESCALATE_AFTER=5   # headroom for adaptive thinking (Sonnet 5.5 cannot disable it)
# 2026-10-10 (owner: "the internet retrieval needs to be faster"): spoken answers to general
# questions use a FAST model, no extended thinking, short replies. Sonnet stays for decisions.
CLAUDE_CHAT_MODEL='claude-haiku-4-5-20251001'
CLAUDE_CHAT_MAX_TOKENS=200
CLAUDE_CHAT_TIMEOUT_S=6
# 2026-10-14 (owner): asked things, he kept saying he is "an AI without a physical presence" -- the
# prompt never told the model he HAS a body. WILLIE_BODY is shared by every prompt that speaks as him.
WILLIE_BODY=("You are Willie, a real six-wheeled home robot rover with a body: steerable wheels, a "
             "robotic arm with a gripper (you can wave, pick things up off the floor and put your arm "
             "away), front and rear cameras, sonar and depth sensors, a face on a screen, a microphone "
             "and a speaker. Never say you are just an AI or that you have no body or physical presence.")
CLAUDE_CHAT_SYSTEM=(WILLIE_BODY+" You are answering out loud. If asked to do something physical, say "
                    "you can and give the words to say, such as 'pick up the red ball', 'wave hello', "
                    "'come here', 'follow me' or 'go explore', or say honestly what you cannot do yet. "
                    "Reply in one or two short spoken sentences, plain words, no lists, no markdown.")
CLAUDE_EFFORT='low'   # short structured answers; low effort keeps thinking and latency small
AI_NEARBY_RADIUS_M=3.0  # §14: how far counts as "nearby" when ai_provider.py's build_world_state()
                        # filters world_model.py objects/obstacles into the AI's world-state payload

# safety.py SafetyController (§3/§4 of docs/WildWilly_Claude_Fix_Implementation_Plan.md) — the
# single authoritative gate all motor commands pass through, reactive-FSM and Claude-proposed
# alike.
MAX_COMMAND_DURATION_S=3.0  # hard cap on any single timed move regardless of what was requested
SENSOR_FAULT_GRACE_S=1.0    # how long imu/encoders/current may report unhealthy before _tick()
                            # forces a safe stopped state (SENSOR_FAULT) instead of just logging
BAT_ADC_STALE_S=5.0         # 2026-08-24: how long ADC.battery_volts may go without a successful
                            # read before is_healthy reports the value as stale. The ADC polls at
                            # 1.0s, so this tolerates ~4 consecutive misses -- long enough to ride
                            # out a transient I2C glitch, short enough that a genuinely dead bus is
                            # caught within a few seconds. Before this existed, a failed read was
                            # forced to 0.00V and read as a flat pack, silently powering the rover
                            # off (happened for real: a loose I2C wire self-terminated Willie with
                            # no warning). Staleness now escalates via SENSOR_FAULT instead.
# Self-test override (owner request 2026-08-24). While motion is gated off by a failed startup
# self-test, brain.py re-runs the test every SELFTEST_RETRY_S; after SELFTEST_OVERRIDE_AFTER
# consecutive failures for the SAME reason it offers an on-screen button to enable motion anyway.
# In-memory only -- a service restart clears it, so an override never outlives its session.
# Deliberately scoped to the startup self-test: TILT/STALL/SENSOR faults are NOT overridable.
SELFTEST_RETRY_S=30.0
# Start-up SENSOR check (startup_check.py, 2026-10-14, owner): STARTUP_SENSOR_CHECK_S after start,
# check every sensor is delivering readings (not just answering), log + say what isn't. Report only.
STARTUP_SENSOR_CHECK=True
STARTUP_SENSOR_CHECK_S=12.0
STARTUP_CAM_WAIT_S=5.0           # keep asking the on-demand rear camera for a frame this long
STARTUP_GRIP_FB_RANGE=(0.10,0.60)   # gripper feedback ratio anywhere from open (0.19) to closed (0.45), with margin
SELFTEST_OVERRIDE_AFTER=3

# STUCK help-photo alert (owner request 2026-08-24). When Willie enters STUCK -- he has exhausted
# his own avoidance attempts and escalated -- he emails the owner a photo from the front camera
# plus pose/sonar/battery context, so the situation can be seen rather than guessed at.
# This is the ONLY path where Willie sends outbound mail without a human confirmation step (see
# email_client.py::send_alert for why that's a bounded exception to FR-2000-004). It can only
# ever send to EMAIL_OUTBOUND_ALLOWLIST[0], and it reports -- it never acts.
# Both limits below are load-bearing, not boilerplate: _go('STUCK') can recur, and this codebase
# has already been bitten once by an unthrottled per-tick action spinning at ~9Hz for an hour.
# Motor-power-loss detection (2026-08-24). G-1 (FRD v3.1) is that the E-stop is invisible to
# software -- it cuts motors and arm with no GPIO sense line, so the control loop keeps issuing
# drive commands into dead motor controllers with no idea anything happened. A sense wire is
# still the real fix, but an INA260 sits inline on the +12V motor bus, so a cut there
# IS observable today with no new hardware: bus voltage collapses toward zero.
# (That monitor is 0x45 / INA260_BUS_12V_ADDR as of 2026-09-15. This comment said 0x44, and
# brain.py duly read 0x44 -- which had been relocated to the 6V ARM rail, making the cut
# undetectable. Corrected; see the INA260 identity note above and tests/test_motor_rail_identity.py.)
# Deliberately DETECTION-ONLY for now -- it logs and shows on the face, it does NOT stop or
# fault. Adding a brand-new automatic halt path on the eve of first driving is how you get a
# rover that refuses to move for reasons nobody understands; prove the signal is clean first,
# then decide about escalation. Threshold is well below any real operating voltage (the bus
# measured 11.3-11.4V) but above the ~0V a genuine cut produces.
MOTOR_RAIL_MIN_V=6.0
INA_FRESH_S=1.0   # an INA260 rail older than this is NOT a reading (sensors.fresh_volts); 10 Hz reader
BUS_TO_PACK_DROP_V=0.16   # F1 + SW-MAIN + Q1 between the pack and the 0x45 bus monitor. Measured 0.157V
                          # 2026-10-10 (12.23 metered vs 12.073 bus) and 0.16V 10-07, motors idle; was 0.08
MOTOR_RAIL_GRACE_S=1.0            # sustained below threshold before it's reported, not a blip
# Arm power (SW-A) seen on INA260 0x44, 2026-10-15 (brain._check_arm_rail). The rail sits at ~6.04 V
# and dips toward ~5.5 V on a servo stall; a switched-off converter reads near 0.
ARM_RAIL_MIN_V=4.0
ARM_RAIL_GRACE_S=1.0
ENABLE_STUCK_ALERT_EMAIL=True
STUCK_ALERT_COOLDOWN_S=600.0      # min seconds between stuck alerts (10 min)
STUCK_ALERT_MAX_PER_SESSION=5     # hard cap per service run, regardless of cooldown
# Wheels left out of the stall check because their ENCODER is known bad, not the wheel: rf reads
# ~0 counts while turning (open since 2026-10-07; owner parked encoders). 10-13 live: a pick-up
# line-up latched STALL_FAULT on rf within 2 s. The other five still catch a real stall.
STALL_IGNORE_WHEELS=('rf',)
STALL_SKIP_IN_LINEUP=True   # 2026-10-14: no stall check during the retrieval line-up (brain._check_stall)
STALL_GRACE_S=1.0           # FR-500-003 (Directive 5): how long a commanded wheel may show near-zero
                            # counts_per_sec before brain.py treats it as a real stall rather than
                            # still ramping up. Must clear both SPEED_RAMP_PER_S's worst-case ramp
                            # time (0.5s, full range) and Encoders' own 0.2s rate-sampling window —
                            # 1.0s matches SENSOR_FAULT_GRACE_S's precedent with comfortable margin
                            # over both. Unconfirmed against real hardware (no live drive test yet).
# FR-500-003, inverse case (2026-10-02): wheels turning with NO wheel commanded -- being pushed,
# rolling down a slope, or a driver fault. Reported, not braked (an idle rover coasts on purpose,
# see motors.py). Grace covers the coast-down after a stop.
UNCOMMANDED_COUNTS_PER_S=50.0   # ~2 cm/s at 763 counts/rev on a 0.1016 m wheel
UNCOMMANDED_GRACE_S=2.0

# ============================================================================
# v2.2 subsystems (docs/archive/WildWilly_Functional_Requirements_Document_v2.2.md,
# superseded by v3.0 but kept for the v2.2-era subsystem notes).
# Every flag below defaults OFF except the two with no external dependency
# (display expressions, local memory) — FR-000 Directive 6 requires all
# task-level behavior to stay inert unless explicitly enabled, and several of
# these need assets/credentials that are not provisioned on this unit yet
# (see docs/WildWilly_v2.2_Programming_Pass.md for the open list). Flip a
# flag only after its prerequisite is actually in place.
# ============================================================================

# --- FR-1300/2000: Willie's own Google account. This is NOT the owner's
# personal account (h.d.himmel@gmail.com). Create it, enable Gmail/Home Graph
# access on it, and populate the credential paths below before flipping
# ENABLE_SMART_HOME/ENABLE_EMAIL. Never put a live secret value directly in
# this file (FR-2000-005) — only env var names / paths under secrets/
# (gitignored).
WILLIE_GOOGLE_ACCOUNT='willie.pi5.droid@gmail.com'

ENABLE_SMART_HOME=False  # FR-1300
# Remote commands IN from Home Assistant / Google Home (remote_cmd.py, owner 2026-10-01). Fixed
# intents only: status, battery, stop, come_here. Never starts without the token file.
ENABLE_REMOTE_CMD=True
REMOTE_CMD_PORT=8765
REMOTE_CMD_TOKEN_PATH='secrets/remote_cmd_token.txt'
REMOTE_CMD_REPLY_TIMEOUT_S=8.0   # under HA rest_command's timeout, so HA always gets an answer
GOOGLE_HOME_CREDS_PATH='secrets/google_home_token.json'
SMART_HOME_DISCOVERY_TIMEOUT_S=5

# FR-1400 cloud AI fallback, never a primary dependency. The FRD assumed Gemini under
# WILLIE_GOOGLE_ACCOUNT above, but that account's Gemini API key hit a persistent zero free-tier
# quota even with billing linked (Google-side provisioning gap, parked 2026-08-06) — swapped to
# Anthropic's API instead, reusing ANTHROPIC_API_KEY (already configured for brain.py's STUCK-
# state decisions, see .env). See ai_provider.py::CloudAIProvider for the unified client (§14) —
# both this fallback and the STUCK-state decisions now share one Anthropic client instance.
ENABLE_CLOUD_AI=True
CLOUD_AI_TIMEOUT_S=8

ENABLE_EMAIL=True  # FR-2000 — Gmail app password verified working 2026-08-06 (IMAP+SMTP login OK)
GMAIL_IMAP_HOST='imap.gmail.com'; GMAIL_SMTP_HOST='smtp.gmail.com'; GMAIL_SMTP_PORT=465
GMAIL_APP_PASSWORD_ENV='WILLIE_GMAIL_APP_PASSWORD'
GMAIL_POLL_INTERVAL_S=120  # FR-2000-002
OWNER_EMAIL='h.d.himmel@gmail.com'
OWNER_FAMILY_SPOKEN='Carolyn and Howard Himmel'   # "who is your owner / who are your parents" (owner 2026-10-11)
OWNER_NAME='Howard'   # how Willie names the owner aloud ("Howard emailed: ...")
# FR-2000-012/013 email commands (owner decision 2026-09-11, built 2026-10-02). Only the owner,
# only with Gmail's own Authentication-Results showing DKIM pass ALIGNED with the From domain,
# only with a subject starting EMAIL_COMMAND_PREFIX, only if fresher than
# EMAIL_COMMAND_MAX_AGE_S, one per poll. Everything then goes through the same queue and
# Directive gating as a spoken command. Set False to shut the channel if the account is ever
# suspected compromised.
ENABLE_EMAIL_COMMANDS=True
EMAIL_COMMAND_PREFIX='willie'          # subject "Willie: go to the kitchen" (':' or ',' after)
EMAIL_COMMAND_MAX_AGE_S=600.0          # mirrors VOICE_COMMAND_MAX_AGE_S: late motion is worse than none
EMAIL_AUTHSERV_ID='mx.google.com'      # only this receiver's Authentication-Results is trusted
# FR-2200 feature requests (built 2026-10-02, feature_requests.py). Evidence-grounded, composed
# by the cloud model, approved by DKIM-verified owner email, then one Markdown file committed.
ENABLE_FEATURE_REQUESTS=True
FEATURE_REQUEST_MAX_PER_DAY=1
FEATURE_REQUEST_MIN_EVENTS=5          # a category needs this many events in the window to count
FEATURE_REQUEST_WINDOW_DAYS=7
FEATURE_REQUEST_EXPIRE_DAYS=7         # unapproved requests are discarded after this
FEATURE_REQUEST_REPROPOSE_DAYS=30     # the same problem is not proposed again within this
FEATURE_REQUEST_FIRST_CHECK_S=600     # first look 10 min after start
FEATURE_REQUEST_CHECK_S=21600         # then every 6 h
FEATURE_REQUEST_PENDING_PATH='secrets/pending_feature_request.json'
FEATURE_REQUEST_HISTORY_PATH='secrets/feature_request_history.json'
FEATURE_REQUEST_PUSH_PENDING_PATH='secrets/feature_request_push_pending.json'
# FR-2000-009: single hard-coded outbound recipient, enforced in email_client.py itself, not
# just here — changing who Willie can email requires a code change, not a config edit.
EMAIL_OUTBOUND_ALLOWLIST=('h.d.himmel@gmail.com',)
# FR-2000-010/011: inbound sender allowlist is owner-managed at runtime (voice/display cannot
# touch it) so it lives in its own file, not a code constant like the outbound list above.
EMAIL_INBOUND_ALLOWLIST_PATH='secrets/email_sender_allowlist.json'

# --- FR-1500 voice pipeline. Hardware confirmed present 2026-08-06 (USB PnP Audio Device,
# mic+speaker, card 2). Enabled 2026-08-09 on owner's go-ahead. Audio I/O and the acoustic
# feedback loop (TTS leaking into the mic and self-triggering) were fixed 2026-08-15 (b5ae067) —
# see voice.py's own comments for both. Not yet live-verified end-to-end with real voice input.
ENABLE_VOICE=True
# Custom-trained "Hey Willie" model (models/hey_willie.onnx + .onnx.data, trained 2026-08-07,
# deployed 2026-08-15 — see wakeword_data/hey_willie_model/ for training artifacts) — replaced
# the earlier "Hey Jarvis" placeholder; this is the real trained wake phrase, not a stand-in.
WAKEWORD_MODEL_PATH='models/hey_willie.onnx'; WAKEWORD_THRESHOLD=0.5
# 2026-08-24: back to 0.5. It was briefly raised to 0.65 on a theory that was then RULED OUT --
# Corrected note: raising this did NOT stop the false wakes. Neither did raising
# VOICE_ECHO_DECAY_S 0.6->2.0. The actual root cause was stale openwakeword smoothing state
# surviving the muted window -- fixed by calling Model.reset() in voice.py::_speaker_loop().
# See that function's comment for the real story; an earlier version of this comment asserted
# the dehumidifier-noise theory as established fact, which contradicted voice.py and would
# mislead whoever tunes this next.
# A dehumidifier IS genuinely running in the room, so some elevated threshold may still be
# worth keeping on its own merits -- but 0.65 is an untested-live guess that was never
# validated as necessary, and a higher threshold risks missing a real "Hey Willie", including
# the one preceding a spoken "stop". Revisit against 0.5 now that reset() is in place.
WHISPER_MODEL_SIZE='base.en'   # 2026-08-21: was 'small.en'. Benchmarked on this rover against a
                               # real 1.21s "what time is it" clip, service stopped: small.en
                               # 5.71s vs base.en 1.88s -- 3x faster for an identical, correct
                               # transcription. Pre-downloaded into ~/.cache/huggingface/hub
                               # before flipping (see the local_files_only note below).
                               # faster-whisper model name. NOTE voice.py loads this with
                               # local_files_only=True, so changing it to a size that is not
                               # already in ~/.cache/huggingface/hub RAISES, gets caught by
                               # _load_models()'s except, and silently disables voice entirely.
                               # Pre-download on the rover first, then change this.
WHISPER_CPU_THREADS=3          # 2026-08-21: was unset, so faster-whisper took all 4 cores. That
                               # all-core burst is the largest current spike this rover makes and
                               # it was browning the 5V rail out mid-utterance (EXT5V dipping past
                               # the Witty Pi cutoff -> hard power-off, reproducible by asking him
                               # the time). Leaving a core free trades a little STT latency for a
                               # smaller peak draw. Raise back to 4 once the rail is fixed.
# --- Hailo NPU STT, 2026-08-23. Scaffolding only -- see docs/superpowers/plans/2026-08-23-
# hailo-voice-offload-design.md Task 5. Blocked on compiling a Whisper HEF via Hailo's Dataflow
# Compiler on a separate x86 Ubuntu machine -- ARM (this rover) cannot run the compiler, and no
# such machine is available yet. Do not enable until HAILO_STT_MODEL_PATH points at a real HEF.
ENABLE_HAILO_STT=False
HAILO_STT_MODEL_PATH='models/hailo_whisper.hef'  # does not exist yet
PIPER_VOICE_PATH='models/piper/en_US-amy-medium.onnx'
# Faster replies (2026-10-07): voice.PiperEngine keeps the voice loaded in-process and caches the
# finished audio of short replies ("Turning left.", "Checking.") so they need no synthesis at all.
TTS_CACHE_MAX=64              # cached replies kept (oldest dropped first)
TTS_CACHE_MAX_CHARS=60        # only replies this short are cached -- the fixed fast-path ones
LOCAL_LLM_MODEL_PATH='models/llama-3.2-3b-instruct-q4.gguf'  # llama.cpp gguf
LOCAL_LLM_CONFIDENCE_FLOOR=0.55  # FR-1400-001: below this, offer cloud AI fallback if enabled
# --- Hailo NPU intent-parsing LLM, 2026-08-23. See docs/superpowers/plans/2026-08-23-hailo-
# voice-offload-design.md Task 4 for the full investigation trail. Shares vision's Hailo device
# via picamera2.devices.Hailo.TARGET (confirmed live on the rover -- a separately-constructed
# VDevice collides with vision's, HAILO_OUT_OF_PHYSICAL_DEVICES(74); reusing the existing one
# does not). CPU LocalAIProvider baseline on voice.py's real prompt: 75% (24/32) on a 32-case
# intent-reliability batch (experiments/llm_reliability_batch.py) -- that is the number this
# backend's own pass rate needs to be judged against before treating it as safe to leave on,
# not an assumed-good ~100%.
# FR-1400-006 real fix (hailo_server.py, 2026-10-08): one child process owns the Hailo chip for
# vision AND the model, so the model's prompt read (2.2 s holding the GIL) no longer freezes the
# rover process. False = the old in-process path (and its brake-before-every-call). If the child
# will not start, vision runs in-process for that run and the on-board MODEL stays off (2026-10-09:
# falling back to the in-process model would bring the freeze back).
ENABLE_HAILO_SERVER=True
HAILO_SERVER_START_TIMEOUT_S=90.0     # child loads YOLO + the 1.6 GB LLM before answering
HAILO_SERVER_DETECT_TIMEOUT_S=5.0     # a prompt read (~2.2 s) can delay a detection; 5 s = dead
HAILO_SERVER_GENERATE_TIMEOUT_S=60.0
HAILO_SERVER_RESTART_S=60.0           # after a crash or timeout, at most one restart a minute
ENABLE_HAILO_LLM=True   # PRIMARY on-device reasoning (Hailo-10H NPU). 2026-09-01: enabled for autonomous thinking.
                        # STUCK state tries this first; falls back to Claude only if confidence < HAILO_LLM_CONFIDENCE_FLOOR.
HAILO_LLM_MODEL_PATH='models/hailo_qwen2_1_5b.hef'  # qwen2:1.5b, Hailo GenAI Model Zoo. ~1.6GB, not tracked in git.
HAILO_LLM_CONFIDENCE_FLOOR=0.7  # NOT a confidence threshold, despite the name. brain.py:1007
                        # compares this against AIResult.action_confidence, and
                        # ai_provider.py::_action_confidence() returns ONLY 1.0 (the action name is
                        # recognised and duration/speed are in range) or 0.0. So this is a boolean
                        # gate: every value in (0.0, 1.0] behaves identically. Tuning it does
                        # nothing. 0.0 would admit structurally invalid actions and >1.0 would
                        # reject every on-device decision, which are the only two changes that
                        # would have any effect at all.
                        # The model's OWN self-reported confidence is used elsewhere --
                        # voice.py:467 against LOCAL_LLM_CONFIDENCE_FLOOR -- not here.
                        # Pinned by tests/test_confidence_gate_semantics.py.

# Generation parameters for the on-device LLM. Until 2026-09-14 hailo_llm.py called
# generate_all(prompt) with NONE of these set, leaving temperature/top_p/top_k/max_generated_tokens
# at whatever the runtime defaults to -- i.e. sampling tuned for varied prose, on a model whose
# only job is emitting one small JSON object for a strict parser. Observed live, same prompt back
# to back: defaults produced valid JSON with the WRONG intent ("status" for a battery question),
# temperature=0.1/top_p=0.9 produced valid JSON with the correct one.
#
# These are tuned against experiments/llm_reliability_batch.py. If you change one, RE-RUN THAT
# BATCH -- the 32-case score in FRD G-6 is only meaningful for the values it was measured at, and
# HAILO_LLM_CONFIDENCE_FLOOR above is calibrated against the same run.
HAILO_LLM_TEMPERATURE=0.1   # Near-greedy. JSON-only output wants determinism, not creativity.
HAILO_LLM_TOP_P=0.9
HAILO_LLM_MAX_TOKENS=256    # 20 of 32 failures on 2026-09-14 broke at exactly char 96 -- the
                            # signature of truncation. This budget is well clear of a complete object.
# --- Audio device selection. Mic swap 2026-09-09: capture moved OFF the Waveshare mic+speaker
# puck and onto a dedicated capture-only USB mic. The puck stays as the SPEAKER (owner decision
# 2026-09-09) -- it is the only non-HDMI playback device on the rover.
#
# Matched by NAME, not by card index. `arecord -l` order follows USB enumeration and can change
# across reboots, so a pinned `hw:3,0` would silently start listening to the wrong device. The two
# names differ by exactly one word, so read this carefully before editing:
#     'USB PnP Sound Device'  = the capture-only mic   (08bb:2902, card 3 as of 2026-09-09)  <- IN
#     'USB PnP Audio Device'  = the Waveshare puck     (0c76:1203, card 2 as of 2026-09-09)
AUDIO_INPUT_DEVICE='USB PnP Sound Device'
# The mic's hardware offers ONLY 48000 and 44100 (`cat /proc/asound/card3/stream0`) -- it cannot do
# the 16000 openwakeword requires, and PortAudio exposes the raw `hw:` devices only (no plug, no
# default, no PipeWire route), so ALSA will not convert for us. voice.py captures at this rate and
# decimates to 16k itself. 48000 is chosen over 44100 because it is an exact 3:1 integer ratio;
# 44100 would force fractional resampling on the wake-word hot path. Must be a whole multiple of
# 16000 -- validate() enforces it. A future 16kHz-native mic sets this to 16000 and the conversion
# becomes a passthrough.
AUDIO_INPUT_RATE=48000
AUDIO_QUEUE_BLOCKS=50
# 2026-10-11 CPU (audio_gate.py). The wake-word model runs only while there is sound: louder than
# WAKE_GATE_MARGIN x the tracked noise floor (and at least WAKE_GATE_MIN_RMS), or the ReSpeaker's
# hardware VAD. PREROLL ~1 s is replayed at onset so "Hey Willie" is not clipped; HANG keeps
# scoring after the sound stops. If a soft-spoken wake word starts being missed, lower MARGIN or
# set WAKE_GATE_ENABLED=False -- the heartbeat line logs 'skipped (quiet)' to tune by.
WAKE_GATE_ENABLED=True
WAKE_GATE_MARGIN=2.0
WAKE_GATE_MIN_RMS=0.002
WAKE_GATE_PREROLL_BLOCKS=12
WAKE_GATE_HANG_S=2.0
# A capture device whose name contains one of these is a mic ARRAY: captured at 16 kHz, channel 0
# (its processed output). RESPEAKER_VAD reads the v2.0's hardware voice flag over USB (pyusb).
AUDIO_ARRAY_NAMES=('ReSpeaker',)
RESPEAKER_VAD=True   # ~4 s of 80 ms blocks between the capture callback and the wake loop
# NOT USED. Kept only to document that it is inert: all three playback sites in voice.py call
# `pw-play`, which routes to PipeWire's default sink, and nothing anywhere reads this value.
# Setting it does nothing. To change the output device, change PipeWire's default sink.
AUDIO_OUTPUT_DEVICE=None
VOICE_TONE_DEFAULT='neutral'  # 'neutral'|'funny'|'silly'|'bashful' — FR-1500-008/009/010
# --- Voice latency, 2026-08-21. Measured live on this rover, "What time is it?":
# stt=12.1s intent=0.0s tts=4.6s total=16.7s. ~4.0s of that stt bucket was the old fixed capture
# window sitting in silence long after the speaker had stopped -- a 1.3s command paid the same
# 4s as a 4s one. Endpointing ends capture on trailing silence instead. NOTE the CPU was at a
# full un-throttled 2.4GHz for that measurement, so the remaining cost is real compute, not the
# power/throttling artifact the NPU spec (SS1) guessed at.
VOICE_CAPTURE_MAX_S=4.0       # hard cap -- unchanged from the old fixed window, so a noisy room
                              # that never endpoints behaves exactly as before, never worse
VOICE_CAPTURE_MIN_S=1.2       # never endpoint before this. Was 0.8, which live turned out to be
                              # short enough that a premature endpoint cut mid-command and Whisper
                              # returned nothing. Real commands ("what time is it") run ~1.2s of
                              # speech, so this is a floor under the whole utterance, not padding.
VOICE_ENDPOINT_SILENCE_S=0.6  # trailing silence that ends capture, once speech has been heard.
                              # Set >= VOICE_CAPTURE_MAX_S to disable endpointing entirely.
VOICE_VAD_NOISE_MULT=2.5      # speech threshold = measured ambient floor x this
VOICE_VAD_FLOOR=0.004         # absolute minimum threshold (RMS, 0-1) so a silent room can't set
                              # a threshold low enough for its own noise to read as speech
VOICE_ECHO_DECAY_S=0.6        # 2026-08-24: back at 0.6 (its original value). It was raised
                              # to 2.0 mid-investigation on a theory that was then RULED OUT --
                              # raising it did NOT stop the false wakes. The real fix was
                              # Model.reset() (see voice.py::_speaker_loop). Reverted because at
                              # 2.0 this was a ~2.4s window (decay + blocking done-chirp) where
                              # Willie could not hear "Hey Willie, stop" after every reply. That
                              # was tolerable while he could not move; with motion enabled and
                              # vision arming come_here/follow/retrieve, it is not.
# Perceived latency: a short chirp the instant the wake word fires, so the interaction *starts*
# immediately even though STT/TTS still take seconds behind it. This is the "Gotcha" idea the
# Hailo NPU spec (SS6) deferred rather than rejected. Deliberately a tone and NOT speech: this
# mic+speaker puck has no echo cancellation (see voice.py), so a spoken ack would be recorded
# and transcribed as part of the command.
# How long a queued voice command stays valid. voice.py stamps every queued command with 'ts'
# but nothing read it until 2026-08-25, so a command issued during a running task executed
# whenever that task happened to end -- "turn right" said during a 30s retrieval turned the
# rover half a minute later. Acting late on a motion command is worse than not acting: by then
# the person has stopped expecting it and is no longer watching for it. 10s is long enough to
# survive a slow STT+intent pass (measured worst case ~38.6s total is dominated by the LLM,
# which happens BEFORE queueing) and short enough that nothing executes out of context.
# confirm_receipt is exempt -- see brain.py's _NON_EXPIRING_INTENTS.
VOICE_COMMAND_MAX_AGE_S=10.0
VOICE_ACK_ENABLED=True
VOICE_ACK_PATH='models/ack.wav'  # generated on first use, not provisioned -- models/ is gitignored
# 2026-08-23: owner-requested -- a second, audibly distinct chirp signalling Willie has finished
# speaking and is listening again. Two 660Hz pulses (vs. the single 880Hz wake chirp) so the two
# are never confused by ear. Plays while still muted (_speaking held) so its own sound can't
# self-trigger the wake word, same defensive shape as the wake chirp's deaf_frames handling.
VOICE_DONE_CHIRP_ENABLED=True
VOICE_DONE_PATH='models/done.wav'  # generated on first use, not provisioned

# --- FR-1600 display expressions. Pure software, layered on the existing WillyFace state
# machine (display.py) — no new hardware/model dependency, safe to default on.
ENABLE_DISPLAY_EXPRESSIONS=True
# FR-1600-009 talking mouth (owner 2026-10-07): the mouth opens and closes with the loudness of the
# speech actually being played (voice.speech_envelope -> display.set_talking).
ENABLE_TALKING_MOUTH=True
MOUTH_TALK_STEP_S=0.05        # one mouth frame per 50 ms of audio
MOUTH_TALK_GATE=0.15          # quieter than this (fraction of the loud parts) = mouth closed
IDLE_PERSONALITY_CYCLE_S=90  # FR-1600-007: how often the idle 'silly' animation may recur
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
