hdhimmel/willy-rover/firmware/pico_b.py

"""Pico B firmware -- three HC-SR04 sonars and the BNO085 reset, over uart2-pi5.

PROVEN ON HARDWARE 2026-09-30 -- this said "NOT YET RUN" until then, and that line
outlived the truth by a day. Measured from the Pi on /dev/ttyAMA2: $S frames at
33.3 Hz, 200 frames in 6.0s with ZERO sequence gaps and ZERO bad checksums, all
three HC-SR04s ranging, and the stuck-ECHO flag firing correctly on two dead
sensors and clearing on a good one. Rail 0x40 read 5.004 V @ 0.031 A during it.

Pi -> Pico direction PROVEN 2026-10-01: PING, ID and BOGUS answered. It was dead
until then -- cold solder joints on the one conductor from Pi phys 7 to c27. RST
travels that way and is now reachable, but has not yet been sent.

Written 2026-09-24. Master Hardware Design section 4.7 is the wiring authority;
this file must not disagree with it.

THERE IS NO 999 SENTINEL HERE, AND THERE MUST NEVER BE ONE.
`sensors.py:43,46` return 999.0 on timeout and `safety.py:22,38` default to it,
which makes "I got no reading" and "nothing is in front of me" the same value.
Behind a serial link that is a fail-open: a dropped frame asserts clear path.
This firmware reports an unmeasurable channel as **-1** and never as a distance,
stamps every channel with its own age in milliseconds, and numbers every frame.
The Pi enforces the deadline and stale must mean STOP -- Software Design S-9.

ECHO STUCK HIGH IS A DESTROYED SENSOR, NOT A TIMEOUT. Two HC-SR04s were killed
by reverse polarity on 2026-09-17: 19 ohms across VCC-GND and ECHO held high
instead of idling low (section 16.12). So this firmware checks ECHO is low
BEFORE it triggers, and reports a stuck line as its own flag rather than letting
it masquerade as no-echo. A stuck line also never lets a measurement start, so
without this check the channel would simply read invalid forever with no clue
why.

THE RADIO IS NOT INITIALISED. Do not import `network`. Section 12 item 17.
"""

import sys
import time
import machine
from machine import Pin, UART, time_pulse_us

VERSION = "b-0.2"   # 2026-10-10: fourth sonar (REAR, GP6/GP7) + firmware update over the UART (uartupd.py)
BOARD = "B"

# --- wiring, section 4.7 -----------------------------------------------------
# ECHO arrives already divided to 3.33V on the signal conditioning board; the
# divider never moves downstream of the Pico (its GPIO is not 5V tolerant).
SONARS = (
    # name,   TRIG, ECHO, P1 trig, P1 echo
    ("front", 0, 1, "P1-1", "P1-4"),
    ("left",  2, 3, "P1-5", "P1-8"),
    ("right", 4, 5, "P1-9", "P1-12"),
    ("rear",  6, 7, "GP6",  "GP7"),    # 2026-10-10: ECHO through its own 1k/2k divider
)

UART_ID = 0
UART_TX = 12          # -> Pi GP5, phys 29
UART_RX = 13          # <- Pi GP4, phys 7
BAUD = 115200

# Status LED: the Pico 2 W has one ONBOARD, on the CYW43439, exposed by
# MicroPython as Pin("LED"). An earlier revision of this file fitted an external
# LED on GP14 in the belief that the onboard one was unusable without the radio.
# That was wrong: driving it brings up the wireless CHIP and loads its firmware
# over SPI, but joins no network and transmits nothing. Section 12 item 17 was
# amended 2026-09-26 to permit exactly that and nothing more. Do NOT import
# `network`. VERIFIED on both boards 2026-09-30 -- lit, and winking once a second.
LED_PIN = "LED"       # GP14 is free
RST_PIN = 15          # BNO085 RST, open-drain against a 10k pull-up to Pi 3V3

# 4 m of air is 23.3 ms there and back; 25 ms gives margin without stalling the
# loop on a dead channel.
ECHO_TIMEOUT_US = 25_000
# HC-SR04 needs ~60 ms between pings to avoid hearing its own last burst. One
# sensor per 30 ms slot, round robin, is 90 ms per sensor -- about 11 Hz each.
SLOT_MS = 30
US_TO_MM = 0.1715     # 343 m/s, there and back

RST_ASSERT_MS = 10

F_STUCK = {"front": 0x01, "left": 0x02, "right": 0x04, "rear": 0x08}
F_RESET_DONE = 0x40   # an IMU reset has been performed since boot


class Sonar:
    def __init__(self, name, trig, echo):
        self.name = name
        self.trig = Pin(trig, Pin.OUT, value=0)
        self.echo = Pin(echo, Pin.IN)
        self.mm = -1
        self.stamp = None       # ticks_ms of the last VALID reading
        self.stuck = False

    def ping(self):
        # The sensor's own idle state is the first diagnostic. Check it before
        # driving anything -- section 16.12's table, check 1.
        if self.echo.value():
            self.stuck = True
            self.mm = -1
            return
        self.stuck = False

        self.trig.value(1)
        time.sleep_us(10)
        self.trig.value(0)

        us = time_pulse_us(self.echo, 1, ECHO_TIMEOUT_US)
        if us < 0:
            # -1 no pulse end, -2 no pulse start. Either way: not a distance.
            self.mm = -1
            return
        self.mm = int(us * US_TO_MM)
        self.stamp = time.ticks_ms()

    def age_ms(self, now):
        if self.stamp is None:
            return -1
        return time.ticks_diff(now, self.stamp)


class ImuReset:
    """Open-drain, idle hi-Z. A push-pull pin sitting at 0V while this board is
    unpowered and the Pi runs on Witty Pi would hold an active-low reset on a
    live IMU -- section 4.7 consequence 1. OPEN_DRAIN with value=1 is hi-Z, so
    that state is unreachable, and the pull-up is what holds RST high."""

    def __init__(self, pin):
        self.pin = Pin(pin, Pin.OPEN_DRAIN, value=1)
        self.count = 0

    def assert_reset(self):
        self.pin.value(0)
        time.sleep_ms(RST_ASSERT_MS)
        self.pin.value(1)
        self.count += 1


class Status:
    """Onboard LED, lit from the moment the board is powered.

    Wrapped, and never allowed to fail loudly. Driving Pin("LED") brings the
    CYW43439 up over SPI, and this sits in main.py's boot path: if it threw, the
    board would crash-loop and send nothing -- which is exactly the silent-board
    failure that cost 2026-09-28. A Pico that cannot blink must still report.

    Lit steady with a short wink once a second. LIT means powered; the wink means
    the loop is still turning. Steady with no wink is a hung board, and dark is no
    power -- three states, one indicator, readable from across the bench.
    """

    WINK_MS = 60
    PERIOD_MS = 1000

    def __init__(self, pin):
        self.led = None
        self.off_until = None
        try:
            self.led = Pin(pin, Pin.OUT)
            self.led.value(1)
        except Exception:
            self.led = None
        self.next_wink = time.ticks_add(time.ticks_ms(), self.PERIOD_MS)

    def beat(self, now):
        if self.led is None:
            return
        try:
            if self.off_until is not None:
                if time.ticks_diff(now, self.off_until) >= 0:
                    self.led.value(1)
                    self.off_until = None
            elif time.ticks_diff(now, self.next_wink) >= 0:
                self.led.value(0)
                self.off_until = time.ticks_add(now, self.WINK_MS)
                self.next_wink = time.ticks_add(self.next_wink, self.PERIOD_MS)
        except Exception:
            self.led = None


def checksum(body):
    c = 0
    for ch in body:
        c ^= ord(ch)
    return c


def send(uart, body):
    uart.write("${}*{:02X}\n".format(body, checksum(body)))


def main():
    led = Status(LED_PIN)
    uart = UART(UART_ID, baudrate=BAUD,
                tx=Pin(UART_TX), rx=Pin(UART_RX),
                timeout=0, timeout_char=0, rxbuf=1024)   # update lines are ~280 chars
    try:
        from uartupd import Receiver
        upd = Receiver(lambda body: send(uart, body))
    except ImportError:
        upd = None        # installed without uartupd.py: USB updates only, as before
    sonars = [Sonar(n, t, e) for (n, t, e, _a, _b) in SONARS]
    by_name = {s.name: s for s in sonars}
    imu = ImuReset(RST_PIN)
    uid = "".join("{:02x}".format(b) for b in machine.unique_id())

    send(uart, "I,{},{},{}".format(BOARD, uid, VERSION))

    seq = 0
    slot = 0
    next_slot = time.ticks_ms()
    rx = b""
    reset_done = False

    wdt = machine.WDT(timeout=2000)

    while True:
        wdt.feed()
        now = time.ticks_ms()

        # --- commands from the Pi -------------------------------------------
        chunk = uart.read()
        if chunk:
            rx += chunk
            while b"\n" in rx:
                line, rx = rx.split(b"\n", 1)
                # Update lines are case-sensitive hex: handled BEFORE the upper() below.
                if upd is not None and upd.handle(line.strip()):
                    continue
                cmd = line.strip().upper()
                if cmd == b"PING":
                    send(uart, "P,{}".format(seq))
                elif cmd == b"ID":
                    send(uart, "I,{},{},{}".format(BOARD, uid, VERSION))
                elif cmd == b"RST":
                    # Explicit and acknowledged, never implicit and never on
                    # boot -- section 4.7 consequence 1.
                    imu.assert_reset()
                    reset_done = True
                    send(uart, "R,ok,{}".format(imu.count))
                elif cmd:
                    send(uart, "X,unknown")
            if len(rx) > 600:      # must fit an update line (was 128)
                rx = b""

        # --- one sensor per slot, round robin -------------------------------
        if time.ticks_diff(now, next_slot) >= 0:
            next_slot = time.ticks_add(next_slot, SLOT_MS)
            sonars[slot].ping()
            slot = (slot + 1) % len(sonars)

            now = time.ticks_ms()
            flags = 0
            for s in sonars:
                if s.stuck:
                    flags |= F_STUCK[s.name]
            if reset_done:
                flags |= F_RESET_DONE

            f = by_name["front"]
            l = by_name["left"]
            r = by_name["right"]
            b = by_name["rear"]
            seq = (seq + 1) & 0xFFFF
            # REAR goes AFTER the flags (b-0.2): fields 0-9 keep their places, so a Pi still
            # running the three-sonar parser reads this frame unchanged.
            send(uart, "S,{},{},{},{},{},{},{},{},{},{},{}".format(
                seq, now,
                f.mm, f.age_ms(now),
                l.mm, l.age_ms(now),
                r.mm, r.age_ms(now),
                flags,
                b.mm, b.age_ms(now)))

        # --- heartbeat ------------------------------------------------------
        led.beat(now)


if __name__ == "__main__":
    main()
