hdhimmel/willy-rover/brain.py

import json,math,re,time,socket,os,subprocess,threading,logging,config,logsetup,storage,privacy,thermal
from logsetup import log_event
if not config.SIMULATE_HARDWARE: import board,busio
from motors import DriveBase,Steering
from sensors import SonarArray,IMU,ADC,Encoders,CurrentMonitor
from display import WillyFace
from ai_provider import CloudAIProvider,build_world_state,build_stuck_prompt
from safety import SafetyController,Rejected
from odometry import Odometry
from world_model import WorldModel,Observation,project_point
from mapping import MappingSession
from navigation import Navigator,Mission
from arm import Arm
from memory_store import MemoryStore
from smart_home import SmartHomeClient
from voice import VoicePipeline,is_emergency_stop
from vision import ObjectDetector
from retrieval_task import RetrievalTask
from pursuit_task import PursuitTask
from come_to_me_task import ComeToMeTask
from rotate import Rotation
from steer_override import SteerOverride
import avoidance
import grip
import teach
import battery_log
import startup_check
import reach_table,arm_ik
from email_client import EmailClient
from remote_cmd import RemoteCommandServer
from feature_requests import FeatureRequests
from identity import IdentityStore,RECOGNISED,UNCERTAIN,UNKNOWN
from recognition import FaceRecognizer
from witty_pi import WittyPi
hailo_llm=None; HailoIntentModel=None
if config.ENABLE_HAILO_LLM:
    # Tolerated, not required: the Hailo runtime (picamera2.devices, hailo_platform) exists only on
    # the rover. Without it brain.py still imports and runs, with no on-board model -- STUCK falls
    # back to the cloud. Found 2026-10-07 by the first CI run, where this import alone stopped
    # test collection on a machine without picamera2.
    try:
        import hailo_llm
        from hailo_llm import HailoIntentModel
    except ImportError as e:
        logging.getLogger('brain').warning(f'Hailo runtime not importable ({e}); running without the on-board model')
        hailo_llm=None; HailoIntentModel=None
log=logsetup.setup('brain')

# Intents that must never be dropped for age in _drain_voice_commands(). confirm_receipt answers
# retrieval_task.py's AWAIT_CONFIRM state, which can legitimately sit waiting longer than the
# expiry window -- expiring it would stall the task rather than protect anyone from a stale
# command. Everything else is safer discarded than executed out of context.
_NON_EXPIRING_INTENTS=frozenset({'confirm_receipt'})

# Intents _drain_voice_commands() will answer on ANY tick rather than only from IDLE. Everything
# here does nothing but read already-cached state and speak, so it cannot move the rover and
# cannot meaningfully block the tick thread.
#
# The test is "does it block the tick", NOT "does it only speak". Two intents that speak rather
# than move are deliberately excluded:
#   'diagnostics'     runs a real I2C scan synchronously, ~0.5s+. The branch's own comment
#                     accepts that cost specifically because it only ever runs from IDLE.
#                     Draining it mid-drive stalls obstacle checks for half a second at speed.
#   'what_do_you_see' runs a detector inference synchronously -- cheap on the Hailo, several
#                     hundred ms on the CPU-YOLO fallback, which is precisely when the rover is
#                     already under strain.
# Both belong here once they are made non-blocking, and not before.
_SPEECH_ONLY_INTENTS=frozenset({'status','battery','where_are_you','what_doing','privacy_on'})
# Command sources that are not someone in the room speaking: they never answer a pending
# yes/no ask (the shutdown confirmation, the roam permission). See answers_ask.
_NON_SPOKEN_SOURCES=frozenset({'remote','email','routine'})
# What an email may queue: everything a spoken command could, through the same gating.
_EMAIL_QUEUEABLE=frozenset({'forward','reverse','turn_left','turn_right','go_to','retrieve','map',
    'stop_map','status','battery','arm_stow','arm_home','wave','come_here','come_to_me','rotate','steer','follow','diagnostics',
    'find_storm','tidy_toys','toy_box_here','last_seen','my_day',
    'where_are_you','what_do_you_see','see_object','what_doing','privacy_on','privacy_off','name_room','mark_stairs','shutdown','demo_replay','roam','check_logs','learn_home','home_address',
    'routine','pose_go','pose_list'})
# What a routine step is queued as: everything the brain executes (the rest just speak a reply).
_ROUTINE_QUEUED=_EMAIL_QUEUEABLE|{'arm_teach','arm_teach_done','arm_jog','arm_more','arm_step','pose_save',
                                  'pose_forget','enrol','forget_everyone','demo_start','demo_stop'}
# Teaching the arm and saved poses (teach.py, 2026-10-13), handled by RoverBrain._teach_cmd().
_TEACH_INTENTS=frozenset({'arm_teach','arm_teach_done','arm_jog','arm_more','arm_step','pose_save',
                          'pose_go','pose_forget','pose_list','reach_learn','reach_save','reach_forget','reach_touch',
                          'pick_up','let_go','put_down'})

# Intents answered while the startup self-test is failing (2026-10-01). _tick() returns early in
# that state, before either drain pass, so Willie heard every command and answered none -- with
# the base off he could not even say why he was not moving. The rover is parked with motion
# disabled, so blocking the tick is harmless here: 'diagnostics' (the self-test, ~0.5 s) is
# allowed, as is 'shutdown'. Anything else is refused out loud with the self-test reason.
_SELFTEST_FAULT_INTENTS=_SPEECH_ONLY_INTENTS|{'diagnostics','shutdown'}

class _SdNotify:
    # Hand-rolled systemd sd_notify (no extra dependency) — sends READY=1 once init passes and
    # periodic WATCHDOG=1 so systemd's WatchdogSec can restart us on a stalled tick loop
    # (§14.2: "Controller/process crash — systemd watchdog — motors disable, arm holds position").
    def __init__(self):
        addr=os.environ.get('NOTIFY_SOCKET'); self._sock=None; self._addr=None
        if addr:
            if addr.startswith('@'): addr='\0'+addr[1:]
            self._sock=socket.socket(socket.AF_UNIX,socket.SOCK_DGRAM); self._addr=addr
    def notify(self,msg):
        if self._sock:
            try: self._sock.sendto(msg.encode(),self._addr)
            except OSError: pass

# I2C addresses expected present per §5.2's authoritative map. Deliberately excludes 0x70 (PCA9685
# all-call broadcast) — PCA9685.reset() clears MODE1's ALLCALL bit during motors.py/arm.py's
# construction in RoverBrain.__init__, which runs before this self-test, so 0x70 legitimately
# never answers by the time we scan; it was never a real device to begin with.
# 0x27 REMOVED 2026-09-30. The MCP23017 is off the bus -- encoder decode moved to Pico A over
# uart4-pi5 (§4.7) and the expander is physically gone. Leaving it here made a correctly built
# rover fail its own self-test: missing={0x27} -> critical -> _motion_enabled stayed false, so
# Willie could not move no matter what else was right. Verified against a live scan the same day,
# which returns exactly these ten: 0x40 0x42 0x43 0x44 0x45 0x48 0x4a 0x51 0x60 0x61.
_EXPECTED_I2C={config.INA260_5V_ADDR,config.STEER_PCA_ADDR,config.ARM_PCA_ADDR,
               config.INA260_BUS_12V_ADDR,config.INA260_ARM_6V_ADDR,config.ADS_ADDR,config.IMU_ADDR,
               config.MOTORKIT_LEFT_ADDR,config.MOTORKIT_RIGHT_ADDR}
# Witty Pi 5 only joins the expected-device set once it's actually installed and enabled --
# adding it unconditionally when the hardware is absent would make the self-test report a
# real device as missing every single run. The gate is still correct; the hardware IS now
# fitted and ENABLE_WITTY_PI is True (config.py), so 0x51 is expected. The self-test now looks
# for TEN devices: nine plus the Witty Pi. It was eleven until 2026-09-30, when 0x27 left the
# set with the MCP23017 it named. (Comment corrected 2026-09-11 -- it still said the hardware
# did not exist on this unit.)
if config.ENABLE_WITTY_PI: _EXPECTED_I2C.add(config.WITTY_PI_ADDR)

# FULL SCAN ONCE, THEN PROBE ONLY WHAT IS MISSING (2026-10-01). Blinka's scan() probes every
# address with an SMBus quick-write -- a zero-length write. The BNO085 (0x4A) logs each one as
# SHTP error 2 "host write too short" and later sends the accumulated list as a channel-0 Error
# List packet, which adafruit_bno08x mis-parses as sensor data: 'Unprocessable Batch bytes'
# while the list is short, then KeyError: 12 once it ends in 0x0C ("list truncated"). With the
# base off the self-test retried every SELFTEST_RETRY_S, so the scan knocked the IMU over every
# 30 s and the RST recovery picked it back up. A device seen once is not re-probed: each one
# already has its own health check (IMU, ADC, encoders, current, motors) for dropping out later.
# THE IMU IS NEVER PROBED (2026-10-02). The one full scan kept at startup still quick-wrote
# 0x4A, and on the first boot with this code the resulting SHTP error list stalled the BNO085
# long enough to latch SENSOR_FAULT -- every boot would have waited for an operator reset. The
# IMU's presence is already proven by its driver constructing, and its health is the
# self-test's separate 'IMU not reporting' check, so probing it adds nothing but the fault.
def _i2c_present(seen,probe):
    """seen: expected addresses already found (None before the first run). probe(addr): True if
    addr answers. Probes only expected addresses not yet seen, never the IMU, never a full scan.
    Returns the updated set of expected addresses present."""
    seen=set(seen or ())|{config.IMU_ADDR}
    return seen|{a for a in _EXPECTED_I2C-seen if probe(a)}

def _i2c_probe(addr):
    # Same two-step probe as Blinka's generic_linux scan(), for one address.
    from Adafruit_PureIO.smbus import SMBus
    with SMBus(1) as bus:
        try: bus.write_quick(addr); return True
        except OSError:
            try: bus.read_byte(addr); return True
            except OSError: return False

# Battery ladder (§13.2), most severe first. Each entry's threshold is the "below this" boundary;
# recovering to a less severe tier requires climbing BAT_HYSTERESIS_V above that boundary, not
# just crossing it, so a hovering voltage doesn't flap the state back and forth.
_BAT_TIERS=[('shutdown',config.BAT_SHUTDOWN_V),('safe',config.BAT_SAFE_V),
            ('rth',config.BAT_RTH_V),('warn',config.BAT_WARN_V)]
_BAT_SEVERITY={'shutdown':4,'safe':3,'rth':2,'warn':1,'normal':0}

# §14/§15: what _stuck() asks the AI for — was ai_provider.py's predecessor claude_client.py's
# module-level SYSTEM constant. _MOTION_SCHEMA is what ai_provider.py structurally validates the
# response against (AIResult.parse_success/action_confidence) — this is NOT the safety gate,
# safety.py::SafetyController.approve_motion() still independently clamps/rejects whatever action
# comes out of this, unchanged.
_MOTION_SYSTEM=("You are the brain of WildWilly, a 6-wheel autonomous rover.\n"
                "Safety: never forward if front<15cm. Stop if tilt>22deg.")
_MOTION_SCHEMA={'action':str,'duration':(int,float),'speed':(int,float)}

# Found 2026-08-21: constructing this many I2C devices back-to-back at startup with zero
# spacing can draw enough simultaneous inrush current to transiently sag the bus below what a
# slow, one-at-a-time i2cdetect probe ever sees -- a device's OWN construction (e.g.
# MotorKit's first PWM write) then hits 'OSError: [Errno 121] Remote I/O error' even though the
# bus is otherwise healthy moments later. Not a substitute for real hardware margin -- just
# resilience against a demonstrated transient at process startup specifically.
#
# Widened 2026-09-07 to catch ValueError as well, and the window lengthened from 4x0.3s to
# 8x0.75s. The original guard caught OSError only, which covers the Errno 121 transient above
# but NOT the case that actually crash-looped the service: Adafruit's
# I2CDevice.__probe_for_device() raises **ValueError** ("No I2C device at address: 0x60") when
# nothing ACKs, so "the isolated rail has not come up yet" propagated on the first attempt with
# zero retries -- the exact scenario this function exists for, and it never engaged. The longer
# window is for rail settling, which is seconds, not the sub-second bus transient.
#
# ValueError is caught broadly rather than matched on message text, which would be fragile
# against a library string. The cost is that a genuine ValueError bug inside a constructor is
# retried before surfacing; unrelated exception types still propagate on the first attempt.
# States in which the tick's dispatch commands motion. A voice "stop" must leave these, or the
# same tick's dispatch drives again -- see the stop_requested branch of _tick().
_MOTION_STATES=('ROAM','SLOW','AVOID','STUCK','DOCK','WAVE','RETRIEVE','NAVIGATE','MANUAL','PURSUE','COME_TO_ME','ROTATE')

def _sonar_returns(d):
    """The sonar readings that are echoes off something real, for the world model.

    NOT `< 999`. That was the timeout sentinel the Pico cutover retired (S-9). Pico B's path
    reports "no echo, nothing in range" as SONAR_MAX_CM -- a CLEAR path -- and "no fresh
    frame" as 0.0, which means unknown and makes safety STOP. Both are below 999, so until
    2026-10-01 an open room plotted a phantom wall SONAR_MAX_CM out on every tick, and a
    stale link plotted one on top of the rover. Only a reading strictly inside
    (0, SONAR_MAX_CM) is a return."""
    return {n:cm for n,cm in d.items() if n in config.SONAR_BEARING_DEG and 0.0<cm<config.SONAR_MAX_CM}

def _init_device(ctor,name,attempts=8,delay_s=0.75):
    for attempt in range(attempts):
        try: return ctor()
        except (OSError,ValueError) as e:
            if attempt==attempts-1: raise
            log.warning(f'{name} init failed ({e}), retrying in {delay_s}s (attempt {attempt+1}/{attempts})')
            time.sleep(delay_s)

def _bus_volts(current):
    """+12V bus voltage for BATTERY decisions: 0.0 when the 0x45 reading is stale, i.e. a dead
    monitor counts as a dead bus. Then battery_volts falls back to the divider, which the
    cross-check flag can veto -- instead of the tiers reading a frozen last-good bus value
    (outside review 2026-10-08). Plain rail() for monitors without fresh_volts (test fakes)."""
    fresh=getattr(current,'fresh_volts',None)
    if fresh is None: return current.rail('bus_12v')['voltage_v']
    v=fresh('bus_12v')
    return 0.0 if v is None else v

class RoverBrain:
    def __init__(self):
        log.info('Initialising WildWilly v2...')
        self.display=_init_device(WillyFace,'display')
        try:
            self.motors=_init_device(DriveBase,'motors')
        except (OSError,ValueError) as e:
            # Pi powered without the 12 V supply: the motor drivers do not answer. Start without
            # them (motion stays disabled by the self-test) instead of crash-looping (2026-10-08).
            log.error(f'Motor drivers unreachable ({e}) -- starting with the drive OFFLINE; no motion')
            self.motors=DriveBase(offline=True)
        self.steering=_init_device(Steering,'steering')
        self.safety=SafetyController(self.motors,steering=self.steering)
        self.sonars=_init_device(SonarArray,'sonars')
        # FR-1000-002 / FR-1200-005: the SEN0628 multi-zone ToF. It was fitted but never
        # constructed -- sensors.py had a slot "set by brain.py" that nothing set (2026-10-02).
        if config.ENABLE_TOF and not config.SIMULATE_HARDWARE:
            try:
                from tof import ToFSensor,SerialFrameSource,BackgroundFrames
                self.sonars.tof=ToFSensor(source=BackgroundFrames(SerialFrameSource()),
                                          drop_rows=config.TOF_FRONT_DROP_ROWS)
                if self.sonars.tof.profile is None:
                    log.warning('ToF fitted but no floor profile -- it reports nothing until '
                                'scripts/calibrate_tof_floor.py is run on clear floor')
            except Exception:
                log.warning('ToF could not start; sonar alone',exc_info=True)
        # REAR ToF (2026-10-10): second SEN0628 facing backward, mounted upside down (config).
        if config.ENABLE_TOF_REAR and not config.SIMULATE_HARDWARE:
            try:
                from tof import ToFSensor,SerialFrameSource,BackgroundFrames
                self.sonars.tof_rear=ToFSensor(
                    source=BackgroundFrames(SerialFrameSource(config.TOF_REAR_PORT)),
                    profile_path=os.path.join(config.WILLY_MEMORY_ROOT,config.TOF_REAR_FLOOR_PROFILE_PATH),
                    floor_rows=config.TOF_REAR_FLOOR_ROWS,left_columns=config.TOF_REAR_LEFT_COLUMNS,
                    drop_rows=config.TOF_REAR_DROP_ROWS,name='rear')
                if self.sonars.tof_rear.profile is None:
                    log.warning('Rear ToF fitted but no floor profile -- it reports nothing until '
                                'scripts/calibrate_tof_floor.py --rear is run on clear floor')
            except Exception:
                log.warning('Rear ToF could not start; reversing without it',exc_info=True)
        # The BNO085's RST is on Pico B, whose link SonarArray owns (§4.7 consequence 1).
        self.imu=_init_device(lambda:IMU(reset=self.sonars.reset_imu),'imu')
        self.adc=_init_device(ADC,'adc')
        self.encoders=_init_device(Encoders,'encoders')
        try: self.motors.attach_encoders(self.encoders)   # FR-500-004 closed-loop wheel speed
        except Exception: log.warning('Wheel speed control: could not attach encoders',exc_info=True)
        self.current=_init_device(CurrentMonitor,'current')
        # Battery voltage from the +12V bus monitor when the bus is live (see ADC.battery_volts).
        self.adc.bus_source=lambda: _bus_volts(self.current)
        self.arm=_init_device(Arm,'arm')
        self.odometry=Odometry(self.encoders,
                               heading_source=lambda: self.imu.heading if self.imu.is_healthy else None)
        self.world_model=WorldModel(self.odometry)  # §9: loads any previously saved map in __init__
        self._sd=_SdNotify()
        # v2.2 subsystems (docs/archive/WildWilly_Functional_Requirements_Document_v2.2.md,
        # superseded by v3.0 but kept for the v2.2-era subsystem notes) — each stays
        # inert unless its config.ENABLE_* flag is on and its assets/credentials are present; see
        # config.py's v2.2 block and docs/WildWilly_v2.2_Programming_Pass.md for what's open.
        # §14: one CloudAIProvider instance now serves both STUCK-state motion decisions (below)
        # and voice.py's free-text fallback — was two separate, un-unified clients hitting the
        # same Anthropic endpoint (ClaudeClient + CloudAIClient).
        self.memory=MemoryStore(); self.cloud_ai=CloudAIProvider(); self.smart_home=SmartHomeClient()
        self.hailo_llm=HailoIntentModel() if (config.ENABLE_HAILO_LLM and HailoIntentModel) else None  # Primary on-device reasoning (STUCK state)
        # Brake before every Hailo generation: it freezes every thread for seconds (hailo_llm.py).
        if hailo_llm is not None: hailo_llm.set_before_generate(self._brake_before_hailo)
        self.voice=VoicePipeline(memory=self.memory,cloud_ai=self.cloud_ai,display=self.display,
                                  smart_home=self.smart_home)
        self.detector=ObjectDetector()
        self.mapping=MappingSession(self.world_model,self.detector)  # §10
        self.navigator=Navigator(self.safety,self.odometry,self.world_model,  # §11
                                 sonars=self.sonars,detector=self.detector,say=self._say,
                                 arm=self.arm)   # arm: the knock at a shut door (knock.py)
        self.retrieval=RetrievalTask(self.safety,self.arm,self.detector,display=self.display,voice=self.voice,
                                     feedback=lambda: grip.read_feedback(self.adc,self.current))
        self.retrieval.encoders=self.encoders   # 2026-10-14: blind-creep distance (arm_ik last fix)
        self.pursuit=PursuitTask(self.safety,self.detector,display=self.display,voice=self.voice)  # FR-1000
        # Rotation mode (rotate.py, live-verified 2026-10-07). Drives THROUGH SafetyController
        # (set_wheels is approved like a turn). Front camera only here: the rear camera is not
        # opened by the service, and opening a USB camera on the tick thread would stall it.
        # Rear camera (2026-10-10): rotation was built to use it and was never given it.
        from vision import RearCamera
        self.rear_cam=RearCamera()
        self._rear_watch=False; self._rear_block=False; self._rear_block_t=0.0; self._rear_thread_on=True
        threading.Thread(target=self._rear_watch_loop,daemon=True).start()
        self.rotation=Rotation(self.steering,self.safety,self.imu,lambda: self.sonars.distances,
                               camera_grab=self.detector.capture_frame,encoders=self.encoders,
                               rear_grab=self.rear_cam.grab,
                               say=self._say)
        self.steer_override=SteerOverride(self.steering)   # FR-600-004
        self.teacher=teach.ArmTeacher()      # arm poses taught by voice (2026-10-13)
        self._stow_requested=False; self._release_after_seq=False
        try: self.arm.on_idle=self._request_stow   # owner 2026-10-13: always back to stow
        except Exception: pass
        self.routine=teach.RoutineRunner()   # "when I say X, do A, then B" (2026-10-13)
        self.battery_log=battery_log.BatteryLogger(self._battery_reading) if config.ENABLE_BATTERY_LOG else None
        self.startup_check=startup_check.StartupCheck(self)
        # FR-2300 GPS (2026-10-11). Optional: absent or fixless never blocks anything (FR-2300-005).
        self.gps=None
        if config.ENABLE_GPS and not config.SIMULATE_HARDWARE:
            try:
                import gps as _gps; self.gps=_gps.GPS()
            except Exception: log.warning('GPS reader could not start (optional)',exc_info=True)
        self._gps_t=0.0; self._gps_reported=False; self._gps_started=time.time()
        try:
            import gps as _gps; self._wander=_gps.WanderWatch()
        except Exception: self._wander=None
        self._after_rotate='IDLE'
        self.come_to_me=ComeToMeTask(self.navigator,self.pursuit,self.world_model,self.detector,
                                     say=self._say)  # FR-1000-006
        self.email=EmailClient()
        self.remote=RemoteCommandServer(self.voice)  # HA / Google Home in, see remote_cmd.py
        self.email.set_command_handler(self._email_command)   # FR-2000-012
        self.feature_requests=FeatureRequests(self.cloud_ai,self.email)   # FR-2200
        self.email.add_approval_handler(self.feature_requests.try_approve)
        # FR-2100 person recognition: store/matcher + embedding source, both inert if disabled.
        self.identity=IdentityStore()
        self.faces=FaceRecognizer(self.detector.capture_frame)
        self.email.add_approval_handler(self._approve_enrolment)
        # FR-2400 engagement (2026-10-15) -- engage.py decides, _engage_* act.
        from engage import Engagement
        self.engage=Engagement(self.memory)
        self._engage_topic=None; self._engage_prev_state=None; self._engage_thread=None
        self._engage_prev={}; self._engage_look_t=0.0; self._last_dets=(0.0,[])
        self.witty=WittyPi()
        self._state='INIT'; self._stuck_count=0; self._last_action='none'; self._manual_action=None
        self._idle_t=0.0; self._avoid_start=0.0; self._avoid_phase=None; self._running=False
        self._motion_enabled=False; self._init_fail_reason=''; self._selftest_critical=[]
        # Self-test override (owner request 2026-08-24). While motion is gated off by a failed
        # startup self-test, retry the test periodically; after SELFTEST_OVERRIDE_AFTER
        # consecutive failures for the SAME reason, offer an on-screen button letting the
        # operator accept the risk and enable motion anyway. In-memory only -- a restart clears
        # it, deliberately, so an override can never outlive the session it was granted in.
        # Scoped to the startup self-test only: TILT/STALL/SENSOR faults keep their own reset
        # gate and are NOT overridable, since those represent live physical danger rather than
        # a missing diagnostic device.
        self._selftest_retry_t=0.0; self._selftest_fail_count=0; self._i2c_seen=None
        self._selftest_overridden=False
        # STUCK help-photo throttling (owner request 2026-08-24) -- see _send_stuck_alert().
        self._stuck_alert_t=0.0; self._stuck_alert_count=0
        # Motor-power-loss detection (2026-08-24) -- see _check_motor_rail().
        self._motor_rail_low_since=None; self._motor_rail_lost=False
        # Arm-power (SW-A) detection, 2026-10-15 -- see _check_arm_rail().
        self._arm_rail_low_since=None; self._arm_rail_lost=False
        # Encoder-rail (R5) warning, 2026-10-01 -- see _check_r5(). Warn only, never a stop.
        self._r5_low_since=None; self._r5_low=False
        self._bat_halt_since=None   # battery-tier halt confirmation clock, see _battery_halt()
        self.thermal=thermal.ThermalMonitor()   # M-009, polled from _tick(), see _thermal_tick()
        self._fan_warned=False
        self._retention_t=0.0       # FR-1800-004: last retention sweep, see _retention_sweep()
        self._arm_over_since=None   # FR-700-001: arm over-current clock, see _check_arm_current()
        self._oc_since={}           # FR-200-002: per-rail overcurrent clocks, see _check_overcurrent()
        self._sonar_failed={}       # FR-800-004: channels currently reported failed
        self._sonar_edge={}         # FR-800-004: channel -> when its state started to differ
        self._uncmd_since=None; self._uncmd_reported=False  # FR-500-003 inverse case
        self._demo=None             # FR-1900-001: demonstration being recorded, see _demo_sample()
        self._bat_warned=False      # FR-200-003: warn tier announced once per descent
        # Battery sense cross-check (2026-09-15) -- see _check_battery_crosscheck().
        self._bat_xcheck_since=None; self._bat_xcheck_flagged=False
        self._bat_tier='normal'; self._health={}; self._fault_since={}; self._stall_since={}
        self._wave_step=0; self._wave_deadline=None
        # RESOLVED 2026-09-07: it was a stale deploy, exactly as guessed below. The 2026-08-08
        # audit P1 found no systemd WatchdogSec configured, confirmed via `systemctl cat` on the
        # live unit -- while this repo's own willy-rover.service has specified WatchdogSec=500ms
        # since 2026-08-02 (df24199, predating that audit). Checked on the rover 2026-09-07:
        # /etc/systemd/system/willy-rover.service was byte-identical to the repo copy EXCEPT for
        # the missing WatchdogSec line, and `systemctl show -p WatchdogUSec` returned 0. So the
        # repo file was right and simply had never been installed, for over a month.
        #
        # Consequence worth holding onto: for that whole period the watchdog described below was
        # NOT armed. Every "systemd will kill us mid-tick" risk in this file and in FRD G-5 was
        # real in the code and dormant in deployment -- including the f18af62 blocking call noted
        # further down. sd_notify's WATCHDOG=1 was a no-op, so a genuinely wedged tick loop was
        # never restarted either; the Witty Pi HAT's own watchdog was the only live backstop.
        # Installing the repo unit on 2026-09-07 to arm it was a mistake and was reverted the
        # same hour: the service was SIGABRT'd ~500ms after every start, four times in twenty
        # seconds, never reaching its own first log line. Cause: this unit is Type=simple, so
        # NotifyAccess defaults to `none` and systemd DISCARDS every sd_notify message the
        # process sends -- the WATCHDOG=1 below was never received by anything, and no heartbeat
        # rate could have satisfied the deadline. WatchdogSec=500ms is now commented out in
        # willy-rover.service with the full precondition list; the rover is back on the unit it
        # had before. So the watchdog is STILL not armed, and the figures below still describe
        # a mechanism that has never once run in this deployment.
        #
        # FRD v3.1 G-5 (2026-08-18) sharpened the risk this WatchdogSec value actually poses:
        # notify() below is called once per tick, so a single _tick() call blocking anywhere near
        # 500ms gets the whole process killed by systemd *mid-tick*, before this tick's own
        # overrun-logging (which only runs after _tick() returns, in run()'s loop) ever executes.
        # The two known culprits that could push a tick that long -- retrieval_task.py's _grasp()
        # and this file's wave-hello gesture, both previously blocking via time.sleep() -- were
        # both converted to non-blocking, tick-serviced step machines the same day (see
        # retrieval_task.py and _wave()/_start_wave() below). This closes the *known cause*,
        # not the risk structurally -- nothing stops a future blocking call from reintroducing
        # it, and this reconciliation itself is unverified on live hardware.
        #
        # A future blocking call did exactly that. f18af62 (2026-09-01) added a synchronous
        # Hailo LLM generate_all() to _stuck(), on this thread, while the paragraph above still
        # read "no other per-tick blocking call is known to remain" -- so the claim was false
        # for six days and nothing flagged it. Moved to the async worker-thread path 2026-09-07
        # (see _stuck()). Treat "no blocking call remains" as a claim to re-verify whenever an
        # AI provider or task is added, not as a standing fact. Tick-overrun counting below is pure visibility regardless --
        # it doesn't do anything about an overrun, just makes one observable instead of silent.
        self._last_tick_duration_s=0.0; self._max_tick_duration_s=0.0; self._tick_overrun_count=0
        self._stopped=False
        self._claude_pending=False; self._claude_move_pending=False
        self._hailo_pending=False  # 2026-09-07: Hailo LLM is polled, not called inline
        self._stuck_history=[]; self._last_stuck_prompt=''  # §14: caller-owned conversation history
        self._pose_log_t=0.0
        self._shutdown_pending=False; self._shutdown_deadline=0.0  # FR-900-005 voice-commanded shutdown confirm
        self._fix_ask_pending=False; self._fix_ask_deadline=0.0    # "check your logs" -> "ask for a fix?"
        # Roam permission (owner decision 2026-09-09). ENABLE_AUTONOMOUS_ROAM means "allowed to
        # ask"; this grant is what actually opens the gate, and it starts false at EVERY boot --
        # unattended roaming is never the state Willie powers up in. See _roam_allowed().
        self._roam_permission=False
        self._roam_ask_pending=False; self._roam_ask_deadline=0.0
        self._roam_ask_next=0.0     # earliest time a new ask may open, after a decline/lapse
        self._shutdown_after_stop=False  # set by _begin_shutdown() -- see stop()'s tail

    def start(self):
        log.info('Starting subsystems...')
        # FR-100-002 (initialize I2C bus and connected devices): bringing up every sensor
        # and actuator subsystem is the whole point of start() below.
        self.display.start(); self.sonars.start(); self.imu.start(); self.adc.start()
        self.encoders.start(); self.current.start()
        self.steering.center_all()
        # The ARM IS NOT CENTRED AT STARTUP (2026-10-02, seen on the rover). centre_all() jumped
        # the shoulder from rest to 1500 us in one step -- the slam config.py forbids -- and the
        # idle release dropped it again 10 s later, on every boot. The arm stays as it is
        # (released) until something asks it to move, and every arm motion steps the shoulder.
        # v2.2: voice/email run their own background threads regardless of self-test result —
        # neither can move the robot on its own (voice queues motion intents for _tick() to
        # gate; email never acts autonomously per FR-2000-004) — but both stay inert no-ops if
        # their ENABLE_* flag is off or credentials/models are missing (see each module).
        self.voice.start(); self.email.start(); self.remote.start(); self.feature_requests.start()
        self.faces.start()
        self._running=True
        # FR-100-003 (run startup self-test): _self_test() below.
        ok,reason=self._self_test()
        # FR-100-004 (prevent motion until startup checks pass): _motion_enabled gates
        # every call into safety.approve_motion() -- see 'motion disabled (self-test
        # failed)' there. Set once here; not touched again afterward (see safety.py's
        # emergency_stop() for why that does NOT also cover FR-300-003's post-E-stop
        # reset requirement, which is a different, unimplemented, gate).
        self._motion_enabled=ok; self._init_fail_reason=reason
        if ok:
            self._go('IDLE')
            # main.py sets this when it force-enabled WILLY_SIMULATE because no I2C device
            # acked at startup (bus physically offline) -- distinct from a developer
            # deliberately running under WILLY_SIMULATE=1, which needs no special-casing here.
            # Self-test genuinely passes either way (simulated sensors always report healthy),
            # so this is purely an operator-visible label, not a different code path.
            if os.environ.get('WILLY_I2C_FORCED_SIMULATE'):
                self.display.update_state('idle','I2C OFFLINE — degraded mode, restart to recheck')
                log.warning('WildWilly v2 ready, but I2C was offline at startup — running '
                            'forced-simulate/degraded. Restart the service once hardware is '
                            'reconnected.')
            else:
                self.display.update_state('idle','WildWilly v2 ready')
                log.info('WildWilly v2 ready.')
        else:
            log.error(f'Startup self-test FAILED — motion disabled: {reason}')
            self.display.update_state('warn',f'SELF-TEST FAILED: {reason}')
        self._sd.notify('READY=1')

    def _self_test(self):
        # FR-100-002/003/004: no motion permitted until this passes (§13.1/§14.2 INIT->IDLE gate).
        # config.validate() (2026-08-08 audit P2) is deliberately NOT added to `problems` below --
        # a config inconsistency (e.g. today's real BAT_FULL_V vs BAT_WARN_V finding) doesn't mean
        # the robot can't safely hold still, and turning it into a new motion-blocking gate is an
        # owner decision, not something to flip silently. Logged for visibility only.
        config_problems=config.validate()
        if config_problems: log.warning('Config validation found issues (non-blocking): '+'; '.join(config_problems))
        # PROBLEMS ARE CLASSIFIED, ADDED 2026-09-17. `problems` used to be one flat list, and
        # brain.py offered the operator an override for ANY entry in it after
        # SELFTEST_OVERRIDE_AFTER consecutive failures -- which meant "IMU not reporting" was
        # exactly as overrideable as a log-directory permission warning. An override that
        # re-enables motion on a rover with no tilt sensing, no wheel feedback, no current
        # monitoring or no battery sensing is not a judgement call an operator should be offered.
        #
        # SAFETY-CRITICAL -> never overrideable. Anything the safety path reads: the I2C bus
        # itself (every expected address is a motor controller, a sensor, or a power monitor),
        # the IMU (tilt/stair detection), the battery ADC (the whole shutdown ladder), the
        # encoders (stall detection) and the current monitors (rail-loss detection).
        #
        # NON-CRITICAL -> overrideable. Storage: it costs logging, map persistence and memory
        # durability, which is real damage to the record but not to anyone's safety. Willy can
        # be driven home with a read-only data root.
        problems=[]; critical=[]
        storage_ok,storage_problems=storage.check_storage({'data':config.WILLY_DATA_ROOT,
            'map':config.WILLY_MAP_ROOT,'memory':config.WILLY_MEMORY_ROOT,'log':config.WILLY_LOG_ROOT})
        if not storage_ok: problems.extend(storage_problems)  # §13: startup availability/permission check
        if config.SIMULATE_HARDWARE:
            pass  # no real bus to scan — every sim class already reports itself healthy below
        else:
            try:
                self._i2c_seen=_i2c_present(self._i2c_seen,_i2c_probe)
                missing=_EXPECTED_I2C-self._i2c_seen
                if missing: critical.append('I2C missing: '+','.join(hex(a) for a in sorted(missing)))
            except Exception as e:
                critical.append(f'I2C scan failed: {e}')
        # Let the sensor threads take a first reading (current monitor is the slowest, 10 Hz) --
        # at STARTUP only. Retries run on the tick thread every SELFTEST_RETRY_S, and the threads
        # are long since running, so the sleep there was pure stall: 288 TICK_OVERRUNs of
        # ~501 ms on 2026-10-01/02, found by Willie's own feature request
        # (docs/feature-requests/2026-10-02-investigate-brain-control-loop-tick-overruns.md).
        if not getattr(self,'_selftest_settled',False):
            time.sleep(0.5); self._selftest_settled=True
        if not self.imu.is_healthy: critical.append('IMU not reporting')
        if self.adc.battery_volts<=0: critical.append('battery ADC not reporting')
        if not self.encoders.is_healthy: critical.append('encoders not reporting')
        # FR-100-003 (2026-10-08): Pico A also reports the encoder supply rail R5 -- the rail
        # whose loss killed every encoder on 2026-08-25. Watched every tick already
        # (_check_r5); now the boot gate refuses motion on it too, naming the rail.
        elif getattr(self.encoders,'r5_low',False): critical.append('encoder supply rail R5 low')
        if not self.current.is_healthy: critical.append('current monitors not reporting')
        if not self.sonars.is_healthy: critical.append('sonar link (Pico B) not reporting')
        if not self.motors.is_healthy: critical.append('motor drivers not responding')
        # FR-100-002: tell "base power off" apart from real faults. With the base switched off
        # the +12V bus monitor reads ~0V and exactly the base-fed subsystems drop out (battery
        # divider, Pico A on R5). 2026-10-01 that read as two unrelated sensor failures.
        base_fed={'battery ADC not reporting','encoders not reporting'}
        if critical and set(critical)<=base_fed|{'motor drivers not responding'}:
            try: bus=self.current.rail('bus_12v')['voltage_v']
            except Exception: bus=None
            if bus is not None and bus<config.MOTOR_RAIL_MIN_V:
                critical=[f'base power appears OFF (12V bus {bus:.1f}V) -- '+'; '.join(critical)]
        # Recorded on self so the override offer can consult it. Set on EVERY self-test run,
        # pass or fail, so a retry that clears the critical fault also clears the block.
        self._selftest_critical=list(critical)
        all_problems=critical+problems
        if all_problems:
            log.error('SELF-TEST FAILED: '+'; '.join(all_problems)
                      +(f'  [SAFETY-CRITICAL, override refused: {"; ".join(critical)}]' if critical else ''))
            return False,'; '.join(all_problems)
        log.info('Self-test passed — all subsystems present.')
        return True,''

    def stop(self):
        # Not just a nicety -- found live 2026-08-08: a second stop() call used to crash on
        # memory.close()'s already-closed sqlite connection (sqlite3.ProgrammingError), which
        # silently skipped every cleanup step after it (world_model.close(), motors.cleanup(),
        # every sensor's stop()). run()'s own `finally: self.stop()` plus any external caller
        # invoking stop() independently (this session's own live smoke test did exactly that)
        # is a real double-call path, not a hypothetical.
        if self._stopped: return
        self._stopped=True
        log.info('Shutting down...')
        self._running=False; self.safety.emergency_stop('shutdown'); time.sleep(0.2)
        if self.retrieval.active: self.retrieval.abort('shutdown')
        if self.mapping.active: self.mapping.abort('shutdown')
        if self.navigator.active: self.navigator.abort('shutdown')
        if self.pursuit.active: self.pursuit.abort('shutdown')
        if self.rotation.active: self.rotation.abort('shutdown')
        self.faces.stop(); self.feature_requests.stop(); self.remote.stop(); self.voice.stop(); self.email.stop(); self.detector.close()
        self._rear_thread_on=False
        try: self.rear_cam.close()
        except Exception: pass
        try:
            import hailo_server; hailo_server.close_client()   # FR-1400-006: release the chip
        except Exception: log.warning('Hailo server close failed',exc_info=True)
        self.memory.close()  # FR-1900-011: persist any new/updated memory before power-off
        self.world_model.close()  # §9/§10: persist rooms/landmarks/objects/routes before power-off
        self.motors.cleanup(); self.sonars.stop(); self.imu.stop(); self.adc.stop()
        self.encoders.stop(); self.current.stop(); self.display.stop()
        if self._shutdown_after_stop:
            # FR-900-005's actual `shutdown -h now` -- deliberately only fires from here, gated on
            # a flag only _begin_shutdown() ever sets, so a plain service restart/SIGTERM/Ctrl-C
            # calling this same stop() never powers off the Pi. voice.stop() above already waited
            # (join timeout=3.0) for the "Shutting down now" line queued in _begin_shutdown() to
            # finish playing before we get here.
            log_event(log,'COMMANDED_SHUTDOWN',severity='warning',subsystem='system',status='shutdown_h_now')
            try:
                subprocess.run(['sudo','shutdown','-h','now'],check=True,timeout=10)
            except Exception as e:
                log.error(f'shutdown -h now failed: {e}')

    def run(self):
        self.start()
        try:
            while self._running:
                t0=time.perf_counter(); self._tick(); self._record_tick_duration(time.perf_counter()-t0)
                time.sleep(0.05)
        except KeyboardInterrupt: log.info('Stopped.')
        finally: self.stop()

    def _record_tick_duration(self,dt):
        self._last_tick_duration_s=dt
        if dt>self._max_tick_duration_s: self._max_tick_duration_s=dt
        if dt>config.TICK_OVERRUN_THRESHOLD_S:
            self._tick_overrun_count+=1
            log_event(log,'TICK_OVERRUN',severity='warning',subsystem='brain',
                      duration_ms=f'{dt*1000:.0f}',threshold_ms=f'{config.TICK_OVERRUN_THRESHOLD_S*1000:.0f}')

    @property
    def tick_duration_ms(self): return self._last_tick_duration_s*1000
    @property
    def max_tick_duration_ms(self): return self._max_tick_duration_s*1000
    @property
    def tick_overrun_count(self): return self._tick_overrun_count

    # FR-200-002/003/004 (undervoltage/warning/critical-cutoff thresholds and shutdown):
    # tiered against calibrated volts (see sensors.py's ADC for FR-200-001's raw-to-volts
    # scaling), with hysteresis in _update_bat_tier() below so tier doesn't chatter at a
    # boundary. 'shutdown' tier below triggers emergency_stop() + SAFE_MODE in the battery
    # check further down this file.
    def _bat_tier_for(self,volts):
        for name,threshold in _BAT_TIERS:
            if volts<threshold: return name
        return 'normal'

    def _update_bat_tier(self,volts):
        raw=self._bat_tier_for(volts)
        if _BAT_SEVERITY[raw]>=_BAT_SEVERITY[self._bat_tier]:
            self._bat_tier=raw  # worsening (or unchanged) — react immediately, no hysteresis
        else:
            cur_threshold=next((t for n,t in _BAT_TIERS if n==self._bat_tier),None)
            if cur_threshold is not None and volts>=cur_threshold+config.BAT_HYSTERESIS_V:
                self._bat_tier=raw  # recovered enough to step down in severity
        return self._bat_tier

    def _check_health(self):
        # FR-1100-001/002: continuous subsystem health monitoring, independent of the one-shot
        # startup self-test in _self_test(). Before this, a sensor dying mid-run (e.g. the IMU
        # thread stalling) went completely unnoticed — is_healthy was only ever read once, at
        # INIT — so a live fault produced no log entry and no operator-visible signal at all.
        #
        # §4 watchdog (docs/WildWilly_Claude_Fix_Implementation_Plan.md): logging alone isn't
        # enough — a fault sustained past SENSOR_FAULT_GRACE_S must force a safe stopped state.
        # battery_adc WAS excluded from that escalation until 2026-08-24, on the reasoning that a
        # failed read defaulted battery_volts to 0 and _update_bat_tier() would treat that as
        # 'shutdown' anyway. That reasoning was wrong in practice: it made a bus glitch
        # indistinguishable from a flat pack and produced a SILENT power-off with no fault state
        # and no low-battery warning — which fired for real when a loose I2C wire took the bus
        # down. sensors.py::ADC now holds its last good value and reports is_healthy=False
        # instead, so staleness escalates here like every other sensor: grace period, visible
        # fault, operator reset. imu is the
        # sharpest case — self.imu.tilt returns the last cached reading even after the read
        # thread dies, so a stale tilt can silently pass the TILT_FAULT check below forever
        # without this.
        # FR-300-004 (controller failure halts motion) -- PARTIAL: this covers IMU,
        # encoders, current sensor and battery ADC health, escalating to emergency_stop()
        # below. It does NOT directly check the drive/arm PCA9685 controllers' own I2C
        # reads/writes for failure -- a total bus dropout would likely show up here via
        # the other devices going unhealthy, but an isolated motor-driver disconnect
        # would not be caught by this check on its own.
        # 'sonars' and 'motors' added 2026-10-01 (FRD gap audit). A stale Pico B link reads 0.0
        # on every channel -- fail-safe for forward motion, but with no fault raised ROAM fell
        # into AVOID and reversed blind on a loop. 'motors' is DriveBase's ramp thread: one I2C
        # error used to kill it silently, after which stop() did nothing.
        checks={'imu':self.imu.is_healthy,'encoders':self.encoders.is_healthy,
                'current':self.current.is_healthy,'battery_adc':self.adc.is_healthy,
                'sonars':self.sonars.is_healthy,'motors':self.motors.is_healthy}
        now=time.time(); sustained_fault=None
        for name,healthy in checks.items():
            was=self._health.get(name,True)
            if was and not healthy:
                # FR-1100-002: say what was seen and what was expected, not just the name.
                value,expected=self._fault_context(name)
                log_event(log,f'{name.upper()}_FAULT',severity='warning',subsystem=name,status='fault',
                          value=value,expected=expected)
            elif not was and healthy: log.info(f'{name} recovered'); self._fault_since.pop(name,None)
            self._health[name]=healthy
            if not healthy:
                self._fault_since.setdefault(name,now)
                if now-self._fault_since[name]>config.SENSOR_FAULT_GRACE_S:
                    sustained_fault=name
        return sustained_fault

    def _check_stall(self):
        # FR-500-003 (Directive 5): "a commanded motor showing no count change within the stall
        # window triggers stop-and-report, not increased drive." sensors.py::Encoders.stalled()
        # existed since the baseline pass but had no caller anywhere in the codebase (confirmed by
        # grep — found 2026-08-18) — Directive 5 was documented but not actually enforced. Same
        # sustained-past-a-grace-period shape as _check_health() above, so a wheel still ramping
        # up right after a fresh command isn't mistaken for a stall.
        now=time.time(); sustained=[]
        # 2026-10-14 (owner go): no stall check while a pick-up/fetch is lining up. Its creep and
        # turn pulses are 0.12-0.3 s at slow speed, too short and slow for the encoders to show
        # motion, so every line-up was cut off in 1-2 s (lf, rr). Bump and distance stops still apply.
        if config.STALL_SKIP_IN_LINEUP and getattr(getattr(self,'retrieval',None),'state',None) in ('LOCALIZE','APPROACH'):
            self._stall_since.clear(); return sustained
        for wheel,is_commanded in self.motors.commanded.items():
            if wheel in config.STALL_IGNORE_WHEELS: continue     # bad encoder, see config
            if is_commanded and self.encoders.stalled(wheel,True):
                self._stall_since.setdefault(wheel,now)
                if now-self._stall_since[wheel]>config.STALL_GRACE_S: sustained.append(wheel)
            else:
                self._stall_since.pop(wheel,None)
        return sustained

    def _fault_context(self,name):
        """FR-1100-002: (observed value, expected range) for a subsystem health fault."""
        try:
            if name=='battery_adc':
                return (f'{self.adc.battery_volts:.2f}V held (read failing or implausible)',
                        f'fresh plausible read, pack {config.BAT_SHUTDOWN_V}-12.6V')
            if name=='imu':
                return (f'tilt {self.imu.tilt:.1f}deg held, no fresh IMU report',
                        f'quaternion or acceleration changing within {config.IMU_STALE_S}s')
            if name=='encoders':
                return (self._encoder_fault_value(),f'$E frames within {config.ENCODER_STALE_S}s')
            if name=='sonars':
                return ('no fresh $S frame from Pico B',f'$S frames within {config.SONAR_STALE_S}s')
            if name=='current':
                return ('no INA260 read for >1s','reads from 0x40/0x44/0x45 within 1s')
            if name=='motors':
                return ('DriveBase ramp thread not running','ramp thread alive')
        except Exception:
            pass
        return ('unhealthy','is_healthy True')

    def _encoder_fault_value(self):
        """What an ENCODERS_FAULT saw, with the power state that usually explains it (feature
        request 2938, approved 2026-10-10 narrowed). 23 of these 10-07..09 all landed at service
        start with the base off: Pico A runs on R5 from the base, so "no frames" was no power, not
        a link fault -- and the log line could not say which. Now it says: the age of the last
        frame, the last R5 Pico A reported (it rides in the frame, so it can only be the last one),
        and the +12V bus, with a cause when the bus explains it."""
        parts=['no fresh $E frame from Pico A']
        try:
            f,age=self.encoders._link.latest('E')
            parts.append('never received' if f is None else f'last {age:.1f}s ago')
            if f is not None and len(f)>9: parts.append(f'last R5 {f[9]}mV')
        except Exception: pass
        try:
            bus=_bus_volts(self.current)
            parts.append(f'12V bus {bus:.1f}V')
            if bus<config.MOTOR_RAIL_MIN_V:
                parts.append('cause: base power off (Pico A and the encoders run on R5 from the base)')
            else:
                parts.append('bus live: Pico A, its power (R5) or the link')
        except Exception: pass
        return ', '.join(parts)

    def _stair_planning_front(self,d):
        """FR-1200-005, in the DELIBERATIVE layer (SWD §6.6): (front_cm for ROAM/SLOW/AVOID's
        planning, ok). A mapped stair edge ahead, in floor mode, shows up here as a nearer front
        so ROAM turns away STAIR_STANDOFF_M short of it. It never touches `d` -- the reflex
        sonar reading that safety.approve_motion() and the world model see stays the sensor's own
        -- so the map can steer the rover but is never what stops it.

        Fails CLOSED: with stairs on the map and no fresh pose (or an error reading them),
        ok=False and the caller refuses to roam. An uncomputable keep-out is not an absent one."""
        f=d['front']
        if config.MOBILITY_MODE!='floor': return f,True
        try:
            stairs=self.world_model.all_stairs()
            if not stairs: return f,True
            pose=self.world_model.get_robot_pose()
            if getattr(pose,'stale',False): return f,False
            from world_model import ray_to_segment
            best=None
            for st in stairs:
                a,b=st.endpoints()
                t=ray_to_segment(pose.x,pose.y,pose.heading,a,b)
                if t is not None and (best is None or t<best): best=t
        except Exception:
            log.warning('Stair standoff could not be computed -- refusing to roam',exc_info=True)
            return f,False
        if best is None: return f,True
        # f < DIST_STOP  <=>  the edge is closer than the standoff
        return min(f,max(0.0,(best-config.STAIR_STANDOFF_M)*100.0+config.DIST_STOP)),True

    # --- FR-2100 person recognition (2026-10-02) -----------------------------------------
    # Personality, not security: no alert, no event log, no photo (design §5). Runs in
    # IDLE/ROAM/SLOW since 2026-10-15 (FR-2400; was IDLE only) and only reads the
    # recognizer's single-slot result, so the tick thread never waits on a model.
    def _face_tick(self):
        """FR-2100 matching + presence; greetings moved to engage.py (FR-2400, 2026-10-15).
        Returns [FaceSeen] for a NEW scan, or None when no new scan arrived."""
        if not self.faces.available: return None
        self.faces.set_scanning(True)
        res=self.faces.latest()
        if res is None: return None
        from engage import FaceSeen
        _,faces=res; out=[]; w=getattr(self.faces,'frame_w',1280) or 1280
        pose=self.world_model.get_robot_pose(); room=self.world_model.get_room(pose.x,pose.y)
        for box,vec in faces:
            m=self.identity.match(vec)
            x,_,bw,_=box; bearing=(0.5-(x+bw/2)/w)*config.CAM_FRONT_HFOV_DEG
            if m.band==RECOGNISED:
                # 2026-10-15: last seen BEFORE this sighting, for 'back after hours' and restart-mid-visit
                try: s=self.identity.last_seen(m.name)
                except Exception: s=None
                self._engage_prev.setdefault(f'saw:{m.name}',s.at if s else None)
                self.identity.note_seen(m.name,room.name if room else None)
                self.voice.set_current_person(m.name)
            elif m.band==UNCERTAIN:
                self._face_last_uncertain=(time.time(),vec)   # silent (design §5); enrolment reads it
            out.append(FaceSeen(m.band,m.name if m.band==RECOGNISED else None,bearing))
        return out

    # --- FR-2400 engagement (2026-10-15): stop, turn toward it, say one thing, listen once ---
    def _engage_busy(self):
        try: priv=not privacy.mic_enabled()
        except Exception: priv=False
        def on(obj,attr='active'): return bool(getattr(getattr(self,obj,None),attr,False))
        task=(getattr(self,'_roam_purpose',None) is not None or getattr(self,'_holding',False)   # never during a task
              or on('teacher') or on('mapping') or on('routine') or on('steer_override'))
        return (priv or task or getattr(self.voice,'busy',False) or not self.voice.available
                or getattr(self,'_bat_tier','normal')!='normal' or self._engage_topic is not None)

    def _engage_step(self):
        faces=self._face_tick()
        if not config.ENABLE_ENGAGEMENT: return
        # Only IDLE/ROAM/SLOW get here, so a topic still set means ENGAGE/ROTATE was left some other
        # way (a fault, a task): end it, or _engage_busy() would block engagement for good.
        if self._engage_topic is not None: self._engage_end('interrupted')
        now=time.time()
        if self._state=='IDLE' and now-self._engage_look_t>=config.ENGAGE_LOOK_S:
            self._engage_look_t=now
            try:
                dets=self.detector.detect(); self._last_dets=(now,dets); self._note_sightings(dets)
            except Exception: log.warning('Engagement look failed',exc_info=True)
        t,dets=self._last_dets
        dets=dets if now-t<=2*config.ENGAGE_LOOK_S else []
        pose=self.world_model.get_robot_pose(); r=self.world_model.get_room(pose.x,pose.y)
        prev=self._engage_prev; self._engage_prev={}
        topic=self.engage.tick(self._state,dets,faces,pose,r.name if r else None,self._engage_busy(),prev)
        if topic is not None: self._start_engage(topic)

    def _start_engage(self,topic):
        log_event(log,'ENGAGE',subsystem='engage',kind=topic.kind,subject=topic.subject,status='start')
        self._engage_topic=topic; self._engage_prev_state=self._state
        self._engage_t0=time.time(); self._engage_phase='say'; self._engage_answer_text=None
        if self._state in ('ROAM','SLOW'): self.safety.stop()
        b=topic.bearing_deg
        if b is not None and abs(b)>=config.ENGAGE_TURN_MIN_DEG:
            ok,msg=self.start_rotation(b,then='ENGAGE')
            if ok: return
            log.info(f'Engage: not turning ({msg}); speaking from here')
        self._go('ENGAGE')

    # Every worker re-checks `self._engage_topic is t` before it speaks, listens or moves the phase:
    # a stop or timeout can land while line()/extract() wait on the cloud (fix round 1, 2026-10-15).
    def _engage_lock(self): return self.__dict__.setdefault('_engage_lk',threading.RLock())

    def _engage_apply_pending(self):
        """Tick thread only: rooms are stored here, never from the answer worker (world_model is read
        by the tick thread)."""
        p=getattr(self,'_engage_pending_room',None)
        if p is None: return
        self._engage_pending_room=None
        try: self.world_model.add_room(*p); self.world_model.save()
        except Exception: log.warning('Engage: room not stored',exc_info=True)

    def _engage_tick(self,d,tilt):
        self.safety.stop()   # ENGAGE behaves like IDLE for safety (spec §2.4)
        self._engage_apply_pending()
        self._upd('idle','',d,tilt)
        t=self._engage_topic
        if t is None: return self._engage_end('no topic')
        if time.time()-self._engage_t0>config.ENGAGE_MAX_S: return self._engage_end('timed out')
        if self._engage_phase=='say':
            self._engage_phase='talking'; self._engage_t0=time.time()   # the turn does not eat ENGAGE_MAX_S
            self._engage_thread=threading.Thread(target=self._engage_say,args=(t,),daemon=True,name='engage')
            self._engage_thread.start(); return
        if self._engage_phase=='done' and not getattr(self.voice,'busy',False):
            self._engage_end('done')

    def _engage_say(self,t):
        import engage_words
        try:
            text=engage_words.line(t,getattr(self,'cloud_ai',None))
            with self._engage_lock():   # _engage_end takes it too: no remark or listen after a stop
                if self._engage_topic is not t:
                    log.info(f'Engage line dropped (topic ended): {text!r}'); return
                self.voice.speak(text)
                log.info(f'ENGAGE said kind={t.kind} subject={t.subject}: {text!r}')
                if t.question:
                    self._engage_phase='listening'
                    cb=lambda ans,t=t: self._engage_answer(t,ans); self._engage_cb=cb
                    self.voice.prompt_listen(cb,config.FACE_ASK_TIMEOUT_S)
                    return
        except Exception: log.warning('Engage: saying failed',exc_info=True)
        if self._engage_topic is t: self._engage_phase='done'

    def _engage_answer(self,t,text):
        if text and is_emergency_stop(text):
            # prompt_listen hands the next utterance here, not to the stop matcher: a "stop" said
            # as the answer must still stop him -- checked FIRST, so a stop landing after the topic
            # timed out (and he went back to ROAM) is never dropped. The voice-stop branch does the rest.
            log.info(f'Engage answer was a stop: {text!r}')
            self.voice.stop_requested.set(); return
        if self._engage_topic is not t:
            log.info(f'Engage answer ignored (topic ended): {text!r}'); return
        def work():
            try: self._engage_store(t,text)
            except Exception: log.warning('Engage: storing failed',exc_info=True)
            finally:
                if self._engage_topic is t: self._engage_phase='done'
        self._engage_thread=threading.Thread(target=work,daemon=True,name='engage-answer'); self._engage_thread.start()

    def _engage_store(self,t,text):
        import engage_words
        if not text:
            log.info(f'ENGAGE answered=no kind={t.kind}'); return
        data=engage_words.extract(t,text,getattr(self,'cloud_ai',None))
        if not data:
            log.info(f'Engage answer not used: {t.kind} heard {text!r}'); return
        # 2026-10-16 (outside review): the topic check and everything it permits run under the lock
        # _engage_end takes, so a stop either lands first (nothing stored, nothing said) or after
        # (the answer was fully handled before it). speak() only queues; the writes are small.
        with self._engage_lock():
            if self._engage_topic is not t:
                log.info(f'Engage answer not used (topic ended): {t.kind} heard {text!r}'); return
            self._engage_act(t,data)

    def _engage_act(self,t,data):
        log.info(f'ENGAGE stored kind={t.kind} {data}')
        if t.kind=='greet_stranger':
            # FR-2100-003 kept: a spoken name may resolve an identity, never create one; no vector stored.
            name=data['name']; self.voice.set_current_person(name)
            if name in self.identity.names(include_pending=False):
                self.identity.note_seen(name)
                self.voice.speak(f"Oh, hi {name}! Sorry, I didn't recognise you.")
            else:   # a stranger's name lasts the visit only (set_current_person) -- not stored
                self.voice.speak(f'Nice to meet you, {name}!')
        elif t.kind=='ask_room':
            pose=self.world_model.get_robot_pose()
            self._engage_pending_room=(data['room'],pose.x,pose.y)   # stored by the tick thread
            self.voice.speak(f"Got it, this is the {data['room']}.")
        elif t.kind=='ask_thing':
            label=data.get('label') or f"the {t.facts.get('thing','thing')}"
            self.memory.name_thing(t.facts['thing'],t.facts.get('room'),data.get('owner'),label)
            self.voice.speak(f"Thanks, I'll remember that's {label}.")
        elif t.kind=='ask_person':
            self.memory.add_person_note(t.facts['name'],data['note'])
            self.voice.speak('Thanks for telling me.')

    def _engage_end(self,reason):
        with self._engage_lock():
            t=self._engage_topic; self._engage_topic=None
            cb=getattr(self,'_engage_cb',None); self._engage_cb=None
            if cb is not None and getattr(self.voice,'cancel_prompt',None):
                try: self.voice.cancel_prompt(cb)   # no wake-free listen left open after a stop
                except Exception: pass
        self._engage_apply_pending()
        if t is not None: log_event(log,'ENGAGE',subsystem='engage',kind=t.kind,subject=t.subject,status=reason)
        back=self._engage_prev_state if self._engage_prev_state in config.ENGAGE_STATES else 'IDLE'
        if reason in ('voice stop','operator stop button'): back='IDLE'   # stop means stop: never resume a roam
        if (back in ('ROAM','SLOW') and config.ROAM_PERMISSION_REQUIRED
                and not getattr(self,'_roam_permission',True)): back='IDLE'
        if self._state=='ENGAGE': self._go('ROAM' if back=='SLOW' else back)

    def _start_enrolment(self,name):
        """FR-2100-001/006: soft gate, capture ~2 s off the tick thread, store PENDING (inert),
        email the owner a code, then introduce himself and wave -- after the capture."""
        if not self.faces.available:
            self._say("I can't learn faces right now; my camera or face models aren't available."); return
        if not name: self._say('Who should I meet?'); return
        now=time.time()
        seen=[s for s in (self.identity.last_seen(n) for n in config.FACE_ENROL_AUTHORISED) if s]
        if self.identity.names(include_pending=False) and not any(now-s.at<config.FACE_ENROL_SEEN_WINDOW_S for s in seen):
            # Deterrent only (design §5): the email approval below is the real authority.
            self._say(f'I can only meet someone new when {" or ".join(config.FACE_ENROL_AUTHORISED)} is with me.')
            return
        self._say(f'Hello {name}. Look at me for a moment, please.')
        def work():
            vecs,why=self.faces.capture_for_enrolment()
            if why:
                if self.voice.available: self.voice.speak(why)
                return
            self.identity.enrol(name,vecs)
            code=__import__('secrets').token_hex(2)
            pend=self._load_pending_enrol(); pend[code]={'name':name,'expires':time.time()+config.FACE_ENROL_CODE_TTL_S}
            self._save_pending_enrol(pend)
            self.email.send_alert(f'Willie met {name}',
                f'Willie was introduced to "{name}" and stored their face as PENDING. It does nothing '
                f'until you approve it.\n\nTo approve, send an email with the subject:\n\n'
                f'    Willie: approve {code}\n\nIf you did not introduce anyone, ignore this; it '
                f'expires in a day.\n\n-- Willie')
            log_event(log,'IDENTITY',subsystem='identity',status='enrolled_pending',name=name,vectors=len(vecs))
            if self.voice.available:
                self.voice.speak(f"Nice to meet you, {name}. I'm Willie. {config.OWNER_NAME} will confirm you by email.")
            self._wave_requested=True   # the wave runs AFTER the capture, from the tick (design §5)
        threading.Thread(target=work,daemon=True,name='enrol').start()

    def _load_pending_enrol(self):
        try:
            with open(os.path.join(os.path.dirname(os.path.abspath(__file__)),config.FACE_PENDING_ENROL_PATH)) as f:
                return json.load(f)
        except (OSError,ValueError): return {}
    def _save_pending_enrol(self,pend):
        p=os.path.join(os.path.dirname(os.path.abspath(__file__)),config.FACE_PENDING_ENROL_PATH)
        os.makedirs(os.path.dirname(p),exist_ok=True)
        with open(p,'w') as f: json.dump(pend,f)

    def _approve_enrolment(self,code,provenance):
        """Email approval handler (DKIM already verified). None if the code is not an enrolment.
        It may ONLY flip an already-pending identity to active (design §5)."""
        pend=self._load_pending_enrol()
        ent=pend.pop(code.lower(),None)
        if ent is None: return None
        self._save_pending_enrol(pend)
        if time.time()>ent['expires']: return False,f'the code for {ent["name"]} has expired'
        ok=self.identity.approve(ent['name'])
        log_event(log,'IDENTITY',subsystem='identity',status='approved' if ok else 'approve_failed',name=ent['name'])
        return (True,f'{ent["name"]} is now recognised') if ok else (False,f'{ent["name"]} was not pending')

    def _demo_sample(self,pose):
        """FR-1900-001: while a demonstration is recording, keep a waypoint every
        DEMO_POINT_SPACING_M of travel. Stale odometry adds nothing (no guessed points)."""
        if self._demo is None or getattr(pose,'stale',False): return
        lx,ly=self._demo['points'][-1]
        if math.hypot(pose.x-lx,pose.y-ly)>=config.DEMO_POINT_SPACING_M:
            self._demo['points'].append((pose.x,pose.y))

    def _finish_demo(self):
        """FR-1900-001: stop recording; save the path as a demonstration and as a route."""
        demo=self._demo; self._demo=None
        if self.pursuit.active: self.pursuit.abort('demonstration finished'); self._go('IDLE')
        if demo is None:
            self._say("I wasn't learning a route."); return
        pose=self.world_model.get_robot_pose()
        pts=demo['points']+([(pose.x,pose.y)] if math.hypot(pose.x-demo['points'][-1][0],
                                                            pose.y-demo['points'][-1][1])>0.05 else [])
        if len(pts)<config.DEMO_MIN_POINTS:
            self._say("We barely moved, so there's nothing to learn yet."); return
        pts=[(round(x,2),round(y,2)) for x,y in pts]
        self.memory.record_demonstration(demo['name'],pts,demo['context'])
        self.world_model.add_route(demo['name'],pts); self.world_model.save()
        log_event(log,'DEMO',subsystem='memory',status='saved',name=demo['name'],points=len(pts))
        self._say(f"Got it. I've learned the way to the {demo['name']}.")

    def _check_uncommanded_motion(self):
        """FR-500-003, inverse: counts changing with no command issued. Reported once per
        episode; not braked, because an idle rover coasts deliberately (motors.py)."""
        try:
            if any(self.motors.commanded.values()) or not self.encoders.is_healthy:
                self._uncmd_since=None; self._uncmd_reported=False; return
            rates=self.encoders.counts_per_sec
        except Exception:
            return
        moving=sorted(w for w,r in rates.items() if abs(r)>config.UNCOMMANDED_COUNTS_PER_S)
        if not moving:
            self._uncmd_since=None; self._uncmd_reported=False; return
        now=time.time()
        if self._uncmd_since is None: self._uncmd_since=now; return
        if not self._uncmd_reported and now-self._uncmd_since>=config.UNCOMMANDED_GRACE_S:
            self._uncmd_reported=True
            log_event(log,'UNCOMMANDED_MOTION',severity='warning',subsystem='encoders',
                      status='moving_without_command',wheels=','.join(moving),
                      max_counts_per_s=f'{max(abs(rates[w]) for w in moving):.0f}',
                      threshold=config.UNCOMMANDED_COUNTS_PER_S)

    def _abandon_stuck_if_active(self):
        # Called alongside every retrieval.abort() at a Directive 1-4 preemption point (tilt,
        # battery, sensor fault). If STUCK was mid-flight — waiting on Hailo or Claude, or
        # executing an AI-issued timed move — this drops that in-flight work so the next STUCK
        # entry starts clean rather than replaying a stale poll/move-pending state.
        #
        # Both providers must be reset, not just the cloud one: reset_async() exists precisely
        # because an unpolled result leaves _busy True forever, after which every future
        # request_async() silently refuses to submit. Missing the Hailo reset here would mean a
        # single tilt fault during on-device thinking permanently disables on-device thinking.
        if self._state=='STUCK':
            self.cloud_ai.reset_async(); self._claude_pending=False; self._claude_move_pending=False
            if self.hailo_llm is not None: self.hailo_llm.reset_async()
            self._hailo_pending=False

    def _tick(self):
        # On-screen STOP SVC button (owner request 2026-08-24). Checked first, before any
        # Directive gating: this is an operator explicitly asking the service to stop, and it
        # must work even when the rover is faulted, wedged, or off the network -- which is the
        # whole reason it exists (2026-08-24: Willie sat healthy but unreachable with no way to
        # stop him from the panel). display.py's two-step confirm means this only fires on a
        # deliberate second tap. Brake first, then let main.py's normal shutdown path run.
        if self.display.privacy_resume_tapped():
            privacy.enable_mic_camera()
            self._say("My microphone and camera are back on.")
        if self.display.stop_tapped():
            log.warning('STOP SVC tapped on screen — braking and stopping the service.')
            self.safety.emergency_stop('operator stop button')
            if self._engage_topic is not None: self._engage_end('operator stop button')
            if self.retrieval.active: self.retrieval.abort('operator stop button')
            if self.mapping.active: self.mapping.abort('operator stop button')
            if self.navigator.active: self.navigator.abort('operator stop button')
            if self.pursuit.active: self.pursuit.abort('operator stop button')
            if self.rotation.active: self.rotation.abort('operator stop button')
            self.memory.save_all_now()
            self.display.update_state('warn','STOPPING SERVICE…')
            self._running=False
            return
        self._thermal_tick()
        self._gps_tick()
        if self.battery_log is not None: self.battery_log.tick()   # owner 2026-10-13: every 2 h
        self.startup_check.tick()   # owner 2026-10-14: report any sensor not delivering, once after start
        self.steer_override.tick(self._state)   # FR-600-004: held in IDLE, ended on leaving it
        if self.voice.stop_requested.is_set():
            # Checked before any Directive gating below — see voice.py's stop_requested docstring.
            # This is the only place that ever clears it, and this is the tick thread, so
            # SafetyController still only ever has one caller.
            self.voice.stop_requested.clear()
            if self.retrieval.active: self.retrieval.abort('voice stop')
            if self.mapping.active: self.mapping.abort('voice stop')
            if self.navigator.active: self.navigator.abort('voice stop')
            if self.pursuit.active: self.pursuit.abort('voice stop')
            if self.rotation.active: self.rotation.abort('voice stop')
            self.steer_override.end('release','voice stop')
            self.routine.abandon('voice stop')   # stop means the rest of the routine too
            if self.teacher.active: self.teacher.end()
            self._release_after_seq=False; self._pick=None; self._pick_after_stow=None
            try: self.arm.drop_pair()              # outside review 2026-10-13
            except Exception: pass
            self._abandon_stuck_if_active()
            if self._engage_topic is not None: self._engage_end('voice stop')   # FR-2400: drops a pending answer
            self.safety.emergency_stop('voice stop')
            self._revoke_roam_permission()  # stop means stop, not "pause for 30 seconds"
            # LEAVE THE MOTION STATE. Found 2026-10-01 (FRD gap audit): this branch braked and
            # aborted the tasks but left _state alone, so the dispatch at the bottom of this
            # same tick ran _roam() -- or SLOW/AVOID/DOCK/WAVE -- and drove again. Braking does
            # not latch anything in SafetyController; only the state does. Fault states are
            # left as they are: a voice stop must never clear a latched fault.
            if self._state in _MOTION_STATES: self._go('IDLE')
            log.info('Voice-triggered immediate stop')
        if getattr(self,'_fix_ask_pending',False) and time.time()>self._fix_ask_deadline:
            self._fix_ask_pending=False; log.info('Fix-request offer lapsed unanswered.')
        if self._shutdown_pending and time.time()>self._shutdown_deadline:
            self._shutdown_pending=False
            log.info('Voice shutdown confirmation timed out — cancelled.')
            if self.voice.available: self.voice.speak("Never mind, I won't shut down.")
        self._service_roam_ask()  # panel tap / lapse for the roam-permission ask (2026-09-09)
        sustained_fault=self._check_health()
        # FR-000 Prime Directives, in order — Directive 2 (self-test gate) and Directive 4
        # (tilt/physical-limit fault) and Directive 3 (battery ladder) are checked here, each
        # able to pre-empt Directive 6 (voice/retrieval/smart-home/email, everything added in
        # v2.2) mid-task. E-stop (Directive 1) is listed in the doc's priority table too but
        # software has no way to observe it — the hardware-only latching cut has no documented
        # GPIO sense pin, so there is no check for it here, same gap as the baseline pass.
        self._sd.notify('WATCHDOG=1')
        self.witty.heartbeat()  # independent hardware watchdog (Witty Pi 5), no-op if not
                                 # installed/enabled -- see witty_pi.py's own module docstring
        pose=self.odometry.update()  # §8: passive dead-reckoning, runs regardless of motion_enabled
                                      # — no motor consequence, just keeps the estimate current for
                                      # logging/diagnostics (nothing consumes it for navigation yet).
        if time.time()-self._pose_log_t>config.POSE_LOG_INTERVAL_S:
            self._pose_log_t=time.time(); log.info(f'pose: {pose}')
        if not self._motion_enabled:
            now=time.time()
            # Retry the self-test on a timer. Without this nothing ever re-runs it, so a fault
            # that clears on its own (e.g. the loose I2C wire reseating) would keep motion
            # disabled until a manual restart -- and the failure count below would never reach
            # the threshold that offers the override.
            if now-self._selftest_retry_t>=config.SELFTEST_RETRY_S:
                self._selftest_retry_t=now
                ok,reason=self._self_test()
                if ok:
                    log.info('Self-test now passes on retry — motion enabled.')
                    self._motion_enabled=True; self._init_fail_reason=''
                    self._selftest_fail_count=0; self._go('IDLE')
                    self._upd('idle','Self-test recovered — ready',{'front':999,'left':999,'right':999},0.0)
                    return
                # Count consecutive failures for the SAME reason. A new/different reason resets
                # the count, so an override is never offered for a fault the operator hasn't
                # actually seen repeated.
                if reason!=self._init_fail_reason:
                    self._init_fail_reason=reason; self._selftest_fail_count=1
                else:
                    self._selftest_fail_count+=1
                log.warning(f'Self-test retry failed ({self._selftest_fail_count}x): {reason}')
            if self.display.override_tapped():
                # Refuse here as well as hiding the button. The tap event can only have been
                # armed while the offer stood, but a critical fault can appear between the offer
                # and the tap -- and this is the last gate before motion is re-enabled, so it
                # re-checks rather than trusting that the button was never shown.
                if self._selftest_critical:
                    log.error('SELF-TEST OVERRIDE REFUSED — safety-critical failure: '
                              +'; '.join(self._selftest_critical))
                else:
                    log.error(f'SELF-TEST OVERRIDDEN by operator — motion enabled despite: '
                              f'{self._init_fail_reason}')
                    self._motion_enabled=True; self._selftest_overridden=True
                    self._go('IDLE'); return
            # FR-100-004: the override is offered ONLY when every outstanding problem is
            # non-safety-critical. See the classification in _self_test().
            offer=(self._selftest_fail_count>=config.SELFTEST_OVERRIDE_AFTER
                   and not self._selftest_critical)
            self._upd('fault',f'SELF-TEST FAILED: {self._init_fail_reason}',
                       {'front':999,'left':999,'right':999},0.0,offer_override=offer)
            self._drain_voice_in_selftest_fault()
            return
        d=self.sonars.distances; tilt=self.imu.tilt; bat_v=self.adc.battery_volts; bat=self.adc.battery_pct
        self.safety.update_context(front_cm=d['front'],tilt_deg=tilt,motion_enabled=self._motion_enabled,
                                   rear_cm=self._rear_cm())
        # §9: passive Layer-1 obstacle feed, same "no motor consequence, just keeps an estimate
        # current" spirit as the odometry pose logging above -- every real (non-timeout) sonar hit
        # this tick becomes a world_model Obstacle point at the robot's current pose+bearing.
        for name,dist_cm in _sonar_returns(d).items():
            x,y=project_point(pose,config.SONAR_BEARING_DEG[name],dist_cm/100.0)
            self.world_model.update_observation(Observation('obstacle',x,y,payload={'source':f'sonar_{name}'}))
        # §10: orthogonal to self._state -- see mapping.py's module docstring for why this is a
        # passive tick alongside whatever ROAM/SLOW/AVOID/STUCK is already doing, not its own FSM state.
        if self.mapping.active: self.mapping.tick(d,tilt)

        if sustained_fault:
            # §4 watchdog escalation (see _check_health) — a sensor fault this sustained means we
            # can no longer trust our own safety checks (tilt above all), so stop unconditionally
            # rather than let TILT_FAULT/battery logic below run on possibly-stale inputs.
            if self.retrieval.active: self.retrieval.abort(f'sensor fault: {sustained_fault}')
            if self.mapping.active: self.mapping.abort(f'sensor fault: {sustained_fault}')
            if self.navigator.active: self.navigator.abort(f'sensor fault: {sustained_fault}')
            if self.pursuit.active: self.pursuit.abort(f'sensor fault: {sustained_fault}')
            if self.rotation.active: self.rotation.abort(f'sensor fault: {sustained_fault}')
            self._abandon_stuck_if_active()
            self.safety.emergency_stop(f'{sustained_fault} sensor fault')
            if self._state!='SENSOR_FAULT': log.warning(f'  {self._state}->SENSOR_FAULT ({sustained_fault})')
            self._state='SENSOR_FAULT'
            self._upd('fault',f'SENSOR FAULT: {sustained_fault}',d,tilt); return
        if self._state=='SENSOR_FAULT':
            if not self._await_reset_or_resume('sensor fault',d,tilt,
                    'SENSOR FAULT CLEARED — tap screen to resume'): return

        if tilt>config.IMU_TILT_LIMIT:
            if self.retrieval.active: self.retrieval.abort(f'tilt fault {tilt:.1f}deg')  # FR-1700-007
            if self.mapping.active: self.mapping.abort(f'tilt fault {tilt:.1f}deg')
            if self.navigator.active: self.navigator.abort(f'tilt fault {tilt:.1f}deg')
            if self.pursuit.active: self.pursuit.abort(f'tilt fault {tilt:.1f}deg')
            if self.rotation.active: self.rotation.abort(f'tilt fault {tilt:.1f}deg')
            self._abandon_stuck_if_active()
            if self._state!='TILT_FAULT': log.warning(f'TILT_FAULT tilt={tilt:.1f}'); self._go('TILT_FAULT')
            self.safety.emergency_stop(f'tilt fault {tilt:.1f}deg')
            self._upd('fault',f'TILT {tilt:.1f}deg STOP',d,tilt); return  # FR-1600-003
        if self._state=='TILT_FAULT' and tilt<config.IMU_TILT_WARN:
            if not self._await_reset_or_resume('tilt fault',d,tilt,
                    'TILT CLEARED — tap screen to resume'): return

        # Motor-power observability (detection only -- never changes state, see _check_motor_rail).
        # Runs every tick regardless of FSM state so a cut is noticed while parked, not just
        # while driving.
        motor_rail_msg=self._check_motor_rail()
        # Encoder rail (detection only -- see _check_r5); feeds _upd's prefix and _stall_reason.
        self._check_r5()
        self._check_arm_rail()
        self._check_arm_current()
        self._check_sonar_channels()
        self._check_uncommanded_motion()
        self._demo_sample(pose)
        # Second opinion on the pack reading (detection only -- see _check_battery_crosscheck).
        self._check_battery_crosscheck()
        # Only advance the battery tier on a reading we actually got. A stale value must not
        # drive the ladder toward 'shutdown' -- that is exactly the silent self-power-off this
        # was changed to prevent (2026-08-24). _check_health() above is what reacts to staleness,
        # via SENSOR_FAULT, and it has already run this tick. Holding the tier here means a
        # transient glitch changes nothing and a sustained one surfaces as a visible fault.
        if self.adc.is_healthy:
            tier=self._update_bat_tier(bat_v)
        else:
            tier=self._bat_tier
        self.safety.update_context(bat_tier=tier)
        if tier=='shutdown':
            if self.retrieval.active: self.retrieval.abort(f'battery shutdown {bat_v:.2f}V')  # FR-1700-007
            if self.mapping.active: self.mapping.abort(f'battery shutdown {bat_v:.2f}V')
            if self.navigator.active: self.navigator.abort(f'battery shutdown {bat_v:.2f}V')
            if self.pursuit.active: self.pursuit.abort(f'battery shutdown {bat_v:.2f}V')
            if self.rotation.active: self.rotation.abort(f'battery shutdown {bat_v:.2f}V')
            self._abandon_stuck_if_active()
            self.safety.emergency_stop(f'battery shutdown {bat_v:.2f}V')
            if self._state!='SHUTDOWN':
                log_event(log,'LOW_BATTERY',severity='error',subsystem='battery',
                          status='shutdown',volts=f'{bat_v:.2f}')
                # best-effort backstop — the guaranteed save already ran at 'rth'. Guarded like
                # the 'rth' branch below: without this, every tick while voltage stays under the
                # threshold re-runs a full WAL checkpoint to disk, forever (found 2026-08-07 —
                # spun at ~9Hz for over an hour with the base powered off, pinning CPU).
                self._go('SHUTDOWN'); self.memory.save_all_now()
            # FR-200-004: the same clean halt as FR-900-005, not just a parked state.
            self._battery_halt('critical battery',bat_v,config.BAT_SHUTDOWN_V,d,tilt); return
        if tier=='safe':
            if self.retrieval.active: self.retrieval.abort(f'battery safe mode {bat_v:.2f}V')  # FR-1700-007
            if self.mapping.active: self.mapping.abort(f'battery safe mode {bat_v:.2f}V')
            if self.navigator.active: self.navigator.abort(f'battery safe mode {bat_v:.2f}V')
            if self.pursuit.active: self.pursuit.abort(f'battery safe mode {bat_v:.2f}V')
            if self.rotation.active: self.rotation.abort(f'battery safe mode {bat_v:.2f}V')
            self._abandon_stuck_if_active()
            if self._state!='SAFE_MODE':
                log_event(log,'LOW_BATTERY',severity='warning',subsystem='battery',
                          status='safe_mode',volts=f'{bat_v:.2f}')
            self.safety.emergency_stop(f'battery safe mode {bat_v:.2f}V'); self._go('SAFE_MODE')
            self._upd('lowbatt',f'SAFE_MODE bat={bat_v:.2f}V',d,tilt); return  # FR-1600-004
        if tier=='rth' and not config.ENABLE_DOCKING:
            # FR-200-005 with docking deferred: stop, save, then the FR-900-005 graceful halt.
            # This used to drive DOCK -- forward at 0.2 on sonar alone -- and re-enter it every
            # tick, so a voice "stop" could not hold the rover (FR-900-004).
            if self.retrieval.active: self.retrieval.abort(f'low battery {bat_v:.2f}V')
            if self.mapping.active: self.mapping.abort(f'low battery {bat_v:.2f}V')
            if self.navigator.active: self.navigator.abort(f'low battery {bat_v:.2f}V')
            if self.pursuit.active: self.pursuit.abort(f'low battery {bat_v:.2f}V')
            if self.rotation.active: self.rotation.abort(f'low battery {bat_v:.2f}V')
            self._abandon_stuck_if_active()
            self.safety.stop()
            if self._state!='LOW_BATTERY':
                self.memory.save_all_now()  # FR-1900-011 guaranteed save, while there is time
                log_event(log,'LOW_BATTERY',severity='warning',subsystem='battery',
                          status='low_battery_halt',volts=f'{bat_v:.2f}',threshold=config.BAT_RTH_V)
                if self.voice.available:
                    self.voice.speak(f'My battery is low, {bat_v:.1f} volts. I will shut down to protect it.')
                self._go('LOW_BATTERY')
            self._battery_halt('low battery',bat_v,config.BAT_RTH_V,d,tilt); return
        if tier=='rth':
            if self._state not in('DOCK','TILT_FAULT'):
                if self.retrieval.active: self.retrieval.abort(f'return-to-home {bat_v:.2f}V')  # FR-1700-007
                if self.mapping.active: self.mapping.abort(f'return-to-home {bat_v:.2f}V')
                if self.navigator.active: self.navigator.abort(f'return-to-home {bat_v:.2f}V')
                if self.pursuit.active: self.pursuit.abort(f'return-to-home {bat_v:.2f}V')
                if self.rotation.active: self.rotation.abort(f'return-to-home {bat_v:.2f}V')
                self._abandon_stuck_if_active()
                # ENABLE_DOCKING=True only (docking is deferred; the branch above handles rth
                # today). FR-1900-011: the guaranteed memory save happens here, at the earlier RTH
                # threshold. This does NOT by itself satisfy FR-200-005, which also requires the
                # FR-900-005 graceful halt -- with a dock, that halt is still to be designed.
                self.memory.save_all_now()
                log_event(log,'LOW_BATTERY',severity='warning',subsystem='battery',
                          status='return_to_home',volts=f'{bat_v:.2f}')
                self._go('DOCK')
        elif self._state=='SAFE_MODE':
            # FR-300-003 EXTENDED TO THE BATTERY LADDER, 2026-09-17. SAFE_MODE is entered via
            # safety.emergency_stop() (see the 'safe' tier above), so it is a latched fault like
            # tilt/sensor/stall -- and it used to be the ONE emergency_stop() path that resumed
            # automatically the moment voltage recovered. That is the worst place to auto-resume:
            # a sagging pack recovers as soon as the motors stop loading it, so the rover would
            # move, sag, cut, recover, and move again in a loop, each cycle taking the pack lower.
            # Now it holds braked and waits for an explicit operator reset like every other fault.
            if not self._await_reset_or_resume('battery safe mode',d,tilt,
                                               'Battery recovered — tap or say reset'): return
        if tier=='warn' and not self._bat_warned:
            # FR-200-003: warn BEFORE the critical level -- once per descent, not every tick.
            self._bat_warned=True
            log_event(log,'LOW_BATTERY',severity='warning',subsystem='battery',status='warn',
                      volts=f'{bat_v:.2f}',threshold=config.BAT_WARN_V)
            if self.voice.available:
                self.voice.speak(f'Heads up, my battery is getting low: {bat_v:.1f} volts.')
        elif tier=='normal':
            self._bat_warned=False
        if tier not in('shutdown','safe','rth'): self._bat_halt_since=None
        if self._state=='LOW_BATTERY' and tier in('normal','warn'):
            self._go('IDLE')   # recovered past the hysteresis band before the halt confirmed
        elif self._state in('SHUTDOWN','DOCK') and tier!='rth':
            # Unchanged. SHUTDOWN is a terminal powering-off path and DOCK is an ordinary
            # return-to-home task, not an emergency_stop() latch -- neither is a fault to reset.
            # Recovery can skip straight from shutdown/safe to warn/normal in one hysteresis step
            # (bypassing 'rth'), so release is handled here rather than only on DOCK.
            self._go('IDLE')

        # FR-000 Directive 5 (FR-500-003): stalls halt, not retry blindly. Checked after
        # Directives 2-4 above and before Directive 6's task dispatch below, per the priority
        # table's own ordering.
        stalled_wheels=self._check_stall()
        if stalled_wheels:
            why=self._stall_reason(stalled_wheels)
            if self.retrieval.active: self.retrieval.abort(why)
            if self.mapping.active: self.mapping.abort(why)
            if self.navigator.active: self.navigator.abort(why)
            if self.pursuit.active: self.pursuit.abort(why)
            if self.rotation.active: self.rotation.abort(why)
            self._abandon_stuck_if_active()
            if self._state!='STALL_FAULT':
                log_event(log,'MOTOR_STALL',severity='warning',subsystem='motors',
                          status='stalled',wheels=','.join(stalled_wheels),r5_low=self._r5_low)
                log.warning(f'  {self._state}->STALL_FAULT ({why})')
            self.safety.emergency_stop(why)
            self._state='STALL_FAULT'
            label='ENCODER RAIL LOW' if self._r5_low else f'STALL {stalled_wheels}'
            self._upd('fault',f'{label} STOP',d,tilt); return
        if self._state=='STALL_FAULT':
            if not self._await_reset_or_resume('wheel stall',d,tilt,
                    'STALL CLEARED — tap screen to resume'): return

        # FR-200-002: overcurrent latches like a stall -- stop, then wait for an operator reset.
        oc=self._check_overcurrent()
        if oc:
            if self.retrieval.active: self.retrieval.abort(oc)
            if self.mapping.active: self.mapping.abort(oc)
            if self.navigator.active: self.navigator.abort(oc)
            if self.pursuit.active: self.pursuit.abort(oc)
            if self.rotation.active: self.rotation.abort(oc)
            self._abandon_stuck_if_active()
            self.safety.emergency_stop(oc)
            if self._state!='OVERCURRENT_FAULT': log.warning(f'  {self._state}->OVERCURRENT_FAULT ({oc})')
            self._state='OVERCURRENT_FAULT'
            self._upd('fault',f'{oc.upper()} — STOP',d,tilt); return
        if self._state=='OVERCURRENT_FAULT':
            if not self._await_reset_or_resume('overcurrent',d,tilt,
                    'Current back to normal — tap screen to resume'): return

        self.safety.tick()  # services any in-flight timed move's deadline/obstacle re-check —
                             # must run every tick regardless of which state started the move
                             # (AVOID's reverse/turn or STUCK's Claude-issued action alike).

        if self._state=='DOCK':
            if self.adc.is_charging:
                self.safety.stop(); self._upd('idle',f'Charging {bat}%',d,tilt)
                if config.ENABLE_AUTONOMOUS_ROAM and bat>=95 and self._roam_allowed(): self._go('ROAM')
                return

        # FR-000 Directive 6 (v2.2): voice-queued task-level commands are only ever picked up
        # here, after every Directive 1-5 check above has already run this tick and none of
        # them pre-empted (FR-1500-007). Only intake a new task from IDLE — never interrupt an
        # in-progress ROAM/AVOID/etc. state to start one. Exception: mapping.active also opens
        # the gate (§10) -- mapping never touches self._state (see mapping.py's module docstring),
        # so without this a voice-issued "stop mapping" could never be drained while ROAM/SLOW/
        # AVOID legitimately keeps running the whole session.
        # Queries first, on every tick regardless of state. Asking "how's your battery?" while the
        # rover is driving used to leave the command sitting in the queue until it stopped, which
        # reads as being ignored. These branches only read cached state, so answering them costs
        # the tick nothing and none of the Directive 1-5 gating above is relevant to them.
        self._drain_voice_commands(speech_only=True)
        if (self._state=='IDLE' or self.mapping.active) and not self.retrieval.active and not self.pursuit.active:
            self._drain_voice_commands()
        self._teach_tick()
        # FR-2400 (2026-10-15): faces + engagement before dispatch; with engagement off, IDLE still scans faces.
        if self._state in config.ENGAGE_STATES and (config.ENABLE_ENGAGEMENT or self._state=='IDLE'):
            try: self._engage_step()
            except Exception: log.warning('Engagement step failed',exc_info=True)

        {'IDLE':self._idle,'ROAM':self._roam,'SLOW':self._slow,'AVOID':self._avoid,
         'STUCK':self._stuck,'DOCK':self._dock,'WARN':self._warn,'RETRIEVE':self._retrieve,
         'NAVIGATE':self._navigate,'MANUAL':self._manual,'PURSUE':self._pursue,'WAVE':self._wave,
         'COME_TO_ME':self._come_to_me_tick,'ROTATE':self._rotate_tick,'ENGAGE':self._engage_tick,
         'TILT_FAULT':lambda d,t:None,'SAFE_MODE':lambda d,t:None,'SHUTDOWN':lambda d,t:None,
         'LOW_BATTERY':lambda d,t:None,'OVERCURRENT_FAULT':lambda d,t:None,
        }.get(self._state,lambda d,t:None)(d,tilt)

    def _email_command(self,text,reply):
        """FR-2000-012, on the email thread: interpret an authenticated owner command, announce
        it aloud, and queue it exactly like a spoken one (Directives 1-5 gate it at drain).
        reply(text) mails the result back; brain._say() calls it with the actual answer."""
        intent=self.voice.interpret_text(text)
        if not intent:
            reply(f"I didn't understand \"{text}\", so I did nothing."); return
        name=intent.get('intent','')
        who=config.OWNER_NAME
        if name=='stop':
            self.voice.stop_requested.set()
            if self.voice.available: self.voice.speak(f'{who} emailed: stop. Stopping.')
            reply('Stopping.'); return
        if name not in _EMAIL_QUEUEABLE:
            r=intent.get('reply') or "That isn't something I can do from an email."
            reply(r); return
        if self.voice.available: self.voice.speak(f'{who} emailed: {text}.')
        log_event(log,'EMAIL_COMMAND',subsystem='email',status='queued',intent=name)
        self.voice.pending_commands.put({'source':'email','intent':name,'args':intent.get('args',{}),
                                         'text':text,'ts':time.time(),'on_reply':reply})

    def _request_fix_now(self):
        """Off the tick thread: compose (cloud model) + email take seconds. Speaks the outcome."""
        try: r=self.feature_requests.tick(owner_asked=True)
        except Exception:
            log.warning('Owner-asked feature request failed',exc_info=True); r='error'
        msg={'proposed':"Done. Check your email for the fix request and its approval code.",
             'pending':"There's already a fix request waiting for your approval in your email.",
             'no_evidence':"None of those happen often enough, or recently enough, to ask for a fix yet.",
             'deferred':"I can't write it right now. I need the internet and my email.",
             'error':"Something went wrong writing the fix request."}.get(r,f"Fix request: {r}.")
        log.info(f'Owner-asked feature request: {r}')
        if self.voice.available: self.voice.speak(msg)

    def _ask(self,question):
        """A question that wants a spoken answer: beep and listen without the wake word after it
        (voice.ask). A remote caller gets the question text as its reply, as _say does."""
        cb=getattr(self,'_reply_to',None)
        if cb is not None or not getattr(self.voice,'available',False) or not hasattr(self.voice,'ask'):
            self._say(question); return
        self.voice.ask(question)

    def _say(self,text):
        # Every answer from the two drain passes goes through here. Speaks it, and hands it to
        # a remote caller (remote_cmd.py) when the command being answered came from one, so
        # Home Assistant can read it back on the Nest. The callback runs even with voice off.
        cb=getattr(self,'_reply_to',None)
        if cb is not None:
            self._reply_to=None
            try: cb(text)
            except Exception as e: log.warning(f'Remote reply callback failed: {e}')
        # 2026-10-13: the answers are in the log, for remote testing. Since 2026-10-15 voice.speak
        # logs every spoken line itself (cloud answers included), so only log here when it won't.
        if self.voice.available: self.voice.speak(text)
        else: log.info(f'Say: {text}')

    def _drain_voice_in_selftest_fault(self):
        # See _SELFTEST_FAULT_INTENTS. Peeks like the speech-only pass, but a disallowed intent
        # is popped and refused rather than left at the head, where it would block every query
        # queued behind it for as long as the fault lasts.
        q=self.voice.pending_commands
        with q.mutex:
            if not q.queue: return
            head=q.queue[0]; intent=head.get('intent')
        if (self._shutdown_pending or self._roam_ask_pending or getattr(self,'_fix_ask_pending',False)) and head.get('source') not in _NON_SPOKEN_SOURCES:
            self._drain_voice_commands(); return
        if not intent or intent in _SELFTEST_FAULT_INTENTS:
            self._drain_voice_commands(); return
        try: self._reply_to=q.get_nowait().get('on_reply')
        except Exception: return
        log.info(f'Voice intent "{intent}" refused: self-test failing ({self._init_fail_reason})')
        self._say(f"I can't do that. My self-test is failing: {self._init_fail_reason}.")
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
