hdhimmel/willy-rover/rotate.py

import math,time,config,logsetup
log=logsetup.setup('rotate')

# ROTATION MODE (owner, 2026-10-07): turn on the spot with the corner wheels steered onto the
# turning circle, instead of skid-turning six straight wheels.
#
# Why: a skid turn drags every tyre sideways. Measured 2026-10-07 on the floor: duty 0.6 for
# 1.5 s strained in place (+0.8 deg); duty 1.0 for 1.0 s turned +62 deg, "rough". With the four
# corners pointed along the circle round his centre, they roll instead of scrub; the middles sit
# on the centre line and roll straight.
#
# GEOMETRY. Corner at (+-a, +-b), a = WHEELBASE_M/2 (0.16), b = TRACK_WIDTH_M/2 (0.155). The wheel
# must be perpendicular to the radius, so |angle| = atan(a/b) = 46 deg, and:
#     front-left RIGHT, rear-right RIGHT, front-right LEFT, rear-left LEFT,  middles straight.
# The same angles serve both spin directions; the drive decides which way he goes (left spin =
# left wheels back, right wheels forward -- as the skid turn). Corners sit on a 0.22 m radius,
# middles on 0.155 m, so corners run 1.44x faster than the middles.
#
# STEERING SCALE, owner-measured 2026-10-07 by eye (no protractor): on all four corners +us
# turns the wheel RIGHT, ~15 deg per 200 us. 46 deg would need ~610 us, past the +-500 us the
# servos are allowed (SERVO_MIN/MAX_US, the narrow range). So the corners go to the limit
# (~37 deg) until a wider servo range is confirmed. Close is far better than straight.
#
# WATCHED THE WHOLE WAY (owner: "use the cameras and sensors to watch the turning"):
#   - IMU heading is the feedback: stop on the angle reached, never on a timer. A timeout only
#     catches a turn that is not happening.
#   - sonar + ToF: anything inside ROTATE_CLEAR_CM stops it; the corners sweep a wider circle
#     than the body.
#   - front camera: frame-to-frame horizontal shift is integrated into a second, independent
#     rotation estimate. If the IMU says he has turned and the camera says the scene has not
#     moved (or the reverse), one of them is wrong: stop and say so. Magnitudes only -- the
#     image's sign convention is not measured.
#   - encoders: Directive 5 stall detection in brain.py still runs every tick for commanded wheels.
#   - BLOCKED TURN (2026-10-07: he spun into the couch and pushed for 8 s until the timeout). Once
#     the spin is under way, a heading rate below ROTATE_STALL_MIN_RATE_DPS for ROTATE_STALL_WINDOW_S
#     stops him; the encoders only say whether the wheels were still turning. THIS IS THE ONLY
#     THING THAT SEES THE REAR AND THE CORNERS: the sonars face front/left/right, the ToF faces
#     forward, there is no rear sensor, and sonar is known to miss soft furniture. Rotation needs
#     open space; the bump stop is the backstop, not a clearance check.
#
# Shape: tick-serviced, like the other tasks. abort() is the preemption contract.

def corner_us(corner,deg):
    """Pulse for a corner wheel at `deg` degrees RIGHT of straight (negative = left), from the
    measured scale and per-corner direction, clamped to the allowed servo range."""
    sign=config.STEER_RIGHT_SIGN.get(corner,1)
    us=config.STEER_CENTER_US.get(corner,config.SERVO_CENTER_US)+sign*deg*config.STEER_US_PER_DEG
    return max(config.SERVO_MIN_US,min(config.SERVO_MAX_US,us))

def rotation_angle_deg():
    return math.degrees(math.atan2(config.WHEELBASE_M/2,config.TRACK_WIDTH_M/2))

def rotation_pulses():
    """Corner pulses for rotation mode; middles centred."""
    th=rotation_angle_deg()
    out={'lf':corner_us('lf',+th),'rr':corner_us('rr',+th),'rf':corner_us('rf',-th),'lr':corner_us('lr',-th)}
    for m in ('lm','rm'): out[m]=config.STEER_CENTER_US.get(m,config.SERVO_CENTER_US)
    return out

def wheel_targets(direction,speed):
    """Per-wheel drive fractions for a spin. direction +1 = left (CCW), -1 = right (CW).
    Corners on the larger radius get the full speed; middles scaled by radius."""
    r_corner=math.hypot(config.WHEELBASE_M/2,config.TRACK_WIDTH_M/2); r_mid=config.TRACK_WIDTH_M/2
    mid=speed*r_mid/r_corner
    t={}
    for w in ('lf','lm','lr','rf','rm','rr'):
        s=mid if w[1]=='m' else speed
        side=-1.0 if w[0]=='l' else 1.0           # left spin: left side back, right forward
        t[w]=side*direction*s
    return t

def _wrap(a): return (a+180.0)%360.0-180.0


class CameraYaw:
    """Integrated horizontal image shift -> degrees, for one camera. Frame-to-frame (phase
    correlation on a small greyscale copy), because a whole turn soon leaves the first view.

    ONLY CLEAR FRAMES COUNT, and the IMU is compared over THE SAME FRAMES. Second live run
    2026-10-07 (90 deg, 54 frames at a steady 67 ms): frames with match quality >= 0.5 showed the
    expected ~4.4 px per frame; motion-blurred ones (quality 0.2-0.35) reported 0.3-1.5 px, and
    summing them turned 87 deg into 17. A blurred frame is now NO MEASUREMENT, not "no movement":
    the camera's degrees and the IMU's degrees are both accumulated only across clear frames."""
    def __init__(self,grab,hfov_deg,name='front',clock=time.time):
        self.grab=grab; self.hfov=hfov_deg; self.name=name; self.clock=clock
        self.prev=None; self._t_prev=None; self._imu_prev=None
        self.deg=0.0            # camera estimate over clear frames
        self.imu_deg=0.0        # IMU rotation over the same clear frames
        self.ok=grab is not None
        self.samples=[]         # (t, dt_s, dx_px, response, used) per frame pair
    def _small(self,f):
        import cv2,numpy as np
        g=cv2.cvtColor(f,cv2.COLOR_BGR2GRAY) if f.ndim==3 else f
        g=cv2.resize(g,(160,90),interpolation=cv2.INTER_AREA)
        return np.float32(g)
    def update(self,imu_turned):
        if not self.ok: return
        try:
            f=self.grab()
            if f is None: return
            import cv2
            s=self._small(f); now=self.clock()
            if self.prev is not None:
                (dx,_dy),resp=cv2.phaseCorrelate(self.prev,s)
                used=resp>=config.ROTATE_CAMERA_MIN_RESPONSE
                if used:
                    self.deg+=abs(dx)*self.hfov/160.0
                    self.imu_deg+=abs(imu_turned-self._imu_prev)
                self.samples.append((now,now-self._t_prev,dx,resp,used))
            self.prev=s; self._t_prev=now; self._imu_prev=imu_turned
        except Exception:
            log.warning(f'{self.name} camera yaw estimate failed; turning without it',exc_info=True)
            self.ok=False
    @property
    def judged(self):
        """Enough clear-frame rotation to compare at all."""
        return self.ok and self.imu_deg>=config.ROTATE_CAMERA_MIN_MATCHED_DEG
    @property
    def agrees(self):
        return abs(self.deg-self.imu_deg)<=max(config.ROTATE_CAMERA_MAX_DISAGREE_DEG,
                                               config.ROTATE_CAMERA_MAX_DISAGREE_FRAC*self.imu_deg)


class Rotation:
    def __init__(self,steering,drive,imu,distances,camera_grab=None,say=None,clock=time.time,
                 rear_grab=None,encoders=None):
        self.steering=steering; self.drive=drive; self.imu=imu; self.distances=distances
        self.camera_grab=camera_grab; self.rear_grab=rear_grab; self.encoders=encoders; self.say=say or (lambda t:None); self.clock=clock
        self.state='IDLE'   # IDLE|SETTLE|SPIN|DONE|FAILED|ABORTED
        self._fail_reason=''

    @property
    def active(self): return self.state in('SETTLE','SPIN')
    @property
    def fail_reason(self): return self._fail_reason

    def start(self,degrees):
        """degrees > 0 = left (CCW), < 0 = right (CW)."""
        if self.active: return False,'already rotating'
        if abs(degrees)<config.ROTATE_MIN_DEG: return False,'too small to rotate for'
        room=self._room_to_turn()
        if room: return False,room
        self._goal=float(degrees); self._dir=1 if degrees>0 else -1
        self._h0=self.imu.heading; self._h_last=self._h0; self._acc=0.0
        self._t0=self.clock(); self._last_steer=0.0
        use=config.ROTATE_USE_CAMERA
        # Front and back cameras (owner: "include willie's back camera"). The back one looks the
        # other way, so its image moves the other way -- only magnitudes are compared.
        self._cams=[CameraYaw(self.camera_grab if use else None,config.ROTATE_CAMERA_HFOV_DEG,'front',self.clock),
                    CameraYaw(self.rear_grab if use else None,config.ROTATE_REAR_CAMERA_HFOV_DEG,'rear',self.clock)]
        self.trace=[]     # (t, imu_turned, {camera: (camera_deg, imu_deg over its clear frames)})
        self._pulses=rotation_pulses(); self._steer()
        self.state='SETTLE'; self._fail_reason=''
        log.info(f'Rotation start: {degrees:+.0f} deg from heading {self._h0:.1f}, corners {self._pulses}')
        return True,'started'

    def _steer(self):
        for c,us in self._pulses.items(): self.steering.set_pulse(c,us)
        self._last_steer=self.clock()

    def _room_to_turn(self):
        """Pre-spin clearance (outside review 2026-10-07, P0 "rotation safety envelope"): '' when
        front, left and right all read beyond ROTATE_START_CLEAR_CM, else why not. The chassis
        corners sweep a circle wider than the body, so a spin needs room on every side it can
        see. It CANNOT see behind -- no rear sensor -- which is why the bump stop exists; this
        check covers the sides that can be checked before moving, not the one that cannot."""
        if self.distances is None: return ''
        try: d=self.distances()
        except Exception: return 'I cannot read my distance sensors'
        for side in ('front','left','right'):
            v=d.get(side,0.0)
            if v<config.ROTATE_START_CLEAR_CM:
                return f'not enough room to turn, only {v:.0f} centimetres on my {side}'
        return ''

    def _blocked_reason(self):
        try:
            cps=self.encoders.counts_per_sec if self.encoders is not None else None
        except Exception: cps=None
        if cps and sum(abs(v) for v in cps.values())/max(1,len(cps))>config.ROTATE_STALL_WHEEL_CPS:
            return 'something is in the way, my wheels are turning but I am not'
        return 'something is stopping me turning'

    def _turned(self):
        """Rotation so far, UNWRAPPED: heading changes are summed tick by tick. 2026-10-07, live:
        a 180 deg "turn around" logged "-178.4 deg" -- heading wraps at +-180, so start-to-now
        cannot tell 182 from -178, and a turn past 190 would have tripped the wrong-way stop."""
        h=self.imu.heading
        self._acc+=_wrap(h-self._h_last); self._h_last=h
        return self._acc

    def _finish(self,state,reason=''):
        self.drive.stop(); self.state=state; self._fail_reason=reason
        try: self.steering.center_all()
        except Exception: log.warning('Could not recentre steering after rotation',exc_info=True)
        if state=='DONE': log.info(f'Rotation done: turned {self._turned():+.1f} deg of {self._goal:+.0f}')
        else:
            log.warning(f'Rotation {state}: {reason} (turned {self._turned():+.1f} deg)')
            if state=='FAILED': self.say(f"I stopped turning: {reason}.")

    def abort(self,reason):
        if self.active: self._finish('ABORTED',reason)
        else: self.state='ABORTED'; self._fail_reason=reason

    def reset(self): self.state='IDLE'

    def tick(self,d,tilt):
        if not self.active: return
        now=self.clock()
        if now-self._last_steer>=config.ROTATE_RESTEER_S: self._steer()   # beat the idle release
        if self.state=='SETTLE':
            if now-self._t0>=config.ROTATE_SETTLE_S:
                res=self.drive.set_wheels(wheel_targets(self._dir,config.ROTATE_SPEED))
                if res is not None and type(res).__name__=='Rejected':   # SafetyController said no
                    self._finish('FAILED',f'I am not allowed to move: {res.reason}'); return
                self.state='SPIN'; self._spin_t0=now; self._hist=[]
            return
        # 2026-10-14: a drop ahead does not matter to a turn on the spot (front_obstacle), and the
        # message names the side -- 'something is 0 centimetres away' told the owner nothing
        sides={'front':d.get('front_obstacle',d.get('front',999)),'left':d.get('left',999),'right':d.get('right',999)}
        side=min(sides,key=sides.get); near=sides[side]
        if near<config.ROTATE_CLEAR_CM:
            log.info(f'Rotation stopped: {side} reads {near:.0f} cm ({sides})')
            self._finish('FAILED',(f'my {side} sensor reads zero, it may not be working' if near<=0.5 else
                                   f'something is {near:.0f} centimetres away on my {side}')); return
        turned=self._turned()
        self._hist.append((now,turned))
        while self._hist and now-self._hist[0][0]>config.ROTATE_STALL_WINDOW_S: self._hist.pop(0)
        if (now-self._spin_t0>=config.ROTATE_STALL_ARM_S and
                now-self._hist[0][0]>=config.ROTATE_STALL_WINDOW_S*0.9 and
                abs(turned-self._hist[0][1])<config.ROTATE_STALL_MIN_RATE_DPS*config.ROTATE_STALL_WINDOW_S):
            self._finish('FAILED',self._blocked_reason()); return
        for c in self._cams: c.update(turned)
        self.trace.append((now,turned,{c.name:(c.deg,c.imu_deg) for c in self._cams if c.ok}))
        judged=[c for c in self._cams if c.judged]
        # Stop only when every camera that can judge disagrees: one blurred or badly lit camera
        # must not stop a turn the other camera and the IMU agree on.
        if config.ROTATE_CAMERA_STOP and judged and not any(c.agrees for c in judged):
            c=judged[0]
            self._finish('FAILED',f'my gyro says {c.imu_deg:.0f} degrees but my {c.name} camera says {c.deg:.0f}'); return
        if turned*self._dir<-config.ROTATE_WRONG_WAY_DEG:
            self._finish('FAILED','I was turning the wrong way'); return
        if abs(turned)>=abs(self._goal)-config.ROTATE_STOP_EARLY_DEG:
            self._finish('DONE'); return
        if now-self._spin_t0>config.ROTATE_TIMEOUT_S:
            self._finish('FAILED',f'I only turned {abs(turned):.0f} of {abs(self._goal):.0f} degrees'); return
