hdhimmel/willy-rover/(commit log)

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2026-08-02 Swap ADC from MCP3008/SPI to ADS1115/I2C
    MCP3008 all-channels-zero fault was never conclusively isolated after
    exhausting power and wiring diagnostics; switching ADC families
    sidesteps the ambiguity. sensors.py's ADC class and config.py now
    target the ADS1115 over I2C (0x48) instead of SPI0. Charge-sense
    divider and battery-divider recalibration are still open, tracked in
    docs/WildWilly_ADS1115_Bringup_Checklist.md.
    Also commits docs/ for the first time (previously untracked).
    [config.py, sensors.py]
2026-08-02 Calibrate ADS1115 battery divider scale against multimeter
    Pack metered at 11.43V while AIN0 read 3.2749V, giving a new
    BATTERY_DIVIDER_SCALE of 0.2865 (was 0.2481, carried over from the
    MCP3008 and no longer valid given the ADS1115's different input
    loading). battery_volts now matches the meter to 1mV.
    [config.py]
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2026-08-02 Fix IMU: dead MPU6050@0x68 → BNO085@0x4A (was crash-looping in prod)
    willy-rover.service was actively crash-looping: IMU.__init__ wrote to
    0x68, a chip address that no longer exists on the bus (superseded by
    a BNO085 at 0x4A per the master doc, code never updated). Rewrote the
    IMU class to use adafruit-circuitpython-bno08x's SH-2 quaternion
    fusion instead of hand-rolled MPU6050 register reads + a complementary
    filter — same public API (pitch/roll/tilt/is_safe/should_warn), plus
    a new is_healthy property (FR-800-004).
    Also required, discovered along the way:
    - None of the Adafruit CircuitPython stack was installed. Since pip
    is externally-managed on this OS, created venv/ (--system-sit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
    [config.py, sensors.py]
2026-08-02 Rebuild hardware constants, drive/steering/arm drivers, encoder+current sensing
    config.py: replaced stale/wrong constants (PCA_ADDR_1=0x40 collided with the
    real INA260 address; MOTOR_LF_IN1 etc referenced freed GPIO pins) with the
    master doc's §5.2 authoritative address map. Also fixed a real, independent
    bug caught while auditing: SONAR_FRONT_ECHO/LEFT_ECHO were on GP11/GP19,
    which don't match the documented harness (GP26/GP14) and aren't wired to
    anything — front/left sonar have likely been silently returning "no
    obstacle" on every read. Battery thresholds moved from a flat two-tier
    raw-code pair to the master doc's §13.2 voltage ladder (warn/RTH/safe/
    shutdown + hysteresis).
    motors.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
    [arm.py, arm_jog.py, config.py, motors.py, sensors.py]
2026-08-02 Rewrite brain.py safety state machine: self-test gate, battery ladder, watchdog
    INIT self-test (FR-100-002/003/004): rolls call all 10 expected I2C addresses
    plus confirms IMU/ADC/encoders/current monitors have produced a first reading
    before permitting any motion. Failure holds in a motion-disabled state with
    the reason shown on-display, rather than crashing or silently driving with
    dead sensors.
    Battery ladder (§13.2) replaces the old flat two-tier battery_low/critical
    check: 11.4V warn -> 10.8V DOCK (return-to-home) -> 10.5V SAFE_MODE (brake,
    hold) -> 10.2V controlled shutdown (software-side halt only; no OS poweroff
    is wired up, that needs privileges and sign-off this pass didn't cover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
    [brain.py]
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2026-08-07 Fix self-test false failure on PCA9685 all-call address (0x70)
    PCA9685.reset() clears MODE1's ALLCALL bit during motors.py/arm.py
    construction in RoverBrain.__init__, which runs before the self-test —
    so 0x70 never answered by scan time and motion was disabled on every
    boot since df24199. It was never a real device to check for.
    [brain.py]
2026-08-07 Enable cloud AI fallback: fix model ID and disable thinking for JSON/text parsing
    Real ANTHROPIC_API_KEY replaces the old 19-char stub, so this and the
    STUCK-state escalation path are credential-unblocked for the first time.
    - config.py: CLAUDE_MODEL was pinned to the deprecated
    claude-sonnet-4-20250514; updated to claude-sonnet-5. ENABLE_CLOUD_AI
    flipped to True after live verification through both client classes.
    - claude_client.py / cloud_ai.py: added thinking:{type:disabled} to both
    request payloads. Claude Sonnet 5 runs adaptive thinking by default,
    and both clients index content[0]['text'] unconditionally — without
    disabling thinking, content[0] would be a thinking block i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
    [config.py]
2026-08-07 Fix display black screen and unclean SIGTERM shutdown
    display.py created its SDL/Wayland window on the main thread but rendered
    on a background thread, so frames drew but never presented to the
    compositor. SDL was also grabbing SIGINT/SIGTERM process-wide by default,
    translating them into an SDL_QUIT event only display.py's own loop
    consumed, so systemd stop/restart hung until timeout. Move all pygame/SDL
    calls into the render thread, disable SDL's signal handlers, and give
    main.py an explicit SIGTERM handler so shutdown runs the normal
    KeyboardInterrupt/cleanup path.
    [display.py, main.py]
2026-08-07 Fix SHUTDOWN tier hammering memory.save_all_now() every tick
    The tier=='shutdown' branch in _tick() had no state guard, unlike the
    'rth' branch three lines below. As long as battery voltage stayed under
    BAT_SHUTDOWN_V, every tick re-ran a full SQLite WAL checkpoint to disk.
    Found 2026-08-07: with the base powered off (Pi-only via USB-C), this
    spun at ~9Hz for over an hour, pinning CPU and spamming the log.
    [brain.py]
2026-08-07 Implement Phase 1 safety architecture: non-blocking control loop + SafetyController gate
    Removes the three CONFLICT findings from the gap analysis: the AI-to-motor
    path blocked the tick thread and had no independent duration clamp or gate.
    - claude_client.py: move the HTTP call to a background worker thread with a
    non-blocking request/poll queue; brain.py's STUCK state polls instead of
    blocking on the API call.
    - motors.py/safety.py: replace blocking sleep-based *_for() timed moves with
    a deadline-based SafetyController serviced every tick.
    - safety.py: add SafetyController.approve_motion() as the single
    authoritative gate (speed clamp, duration cap, tilt, battery tier,
    obstacle c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
    [brain.py, config.py, motors.py, retrieval_task.py, safety.py, sensors.py, test_safety.py]
2026-08-08 Add differential-drive odometry (§8 of the Claude fix plan)
    odometry.py: Odometry.update() converts averaged left/right wheel encoder
    counts into a Pose(x,y,heading,linear_velocity,angular_velocity,timestamp),
    integrated once per brain.py tick and logged periodically. Freezes (marks
    stale) instead of integrating a bad delta when the encoder subsystem is
    unhealthy. The arc-update math (integrate()) is a pure function, unit
    tested in isolation in tests/test_odometry.py.
    Dead-reckoning only: no slip correction, no IMU fusion. WHEEL_DIAMETER_M
    and TRACK_WIDTH_M are unconfirmed placeholder estimates from the chassis
    envelope (no bench measurement exists in the docs) — flagged accordingly
    in c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
    [brain.py, config.py, odometry.py, test_odometry.py]
2026-08-08 Add WILLY_SIMULATE hardware mock mode (§19/§20 of the Claude fix plan)
    config.SIMULATE_HARDWARE (env var WILLY_SIMULATE=1) gates every real
    I2C/GPIO open in motors.py, arm.py, sensors.py, and brain.py's own I2C
    self-test scan. New hw_sim.py holds two shared mocks (SimMotor,
    SimServoBank) that satisfy DriveBase/Steering/Arm's existing interfaces
    unchanged, so no caller-visible API changed. sensors.py's five hardware
    classes (Sonar/SonarArray, IMU, ADC, Encoders, CurrentMonitor) each get a
    simulated _update() path returning plausible, safe values instead of
    touching real hardware.
    This was the root cause blocking §20 testing: previously even constructing
    RoverBrain() failed off the physica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
    [arm.py, brain.py, config.py, hw_sim.py, motors.py, sensors.py, test_sim_hardware.py]
2026-08-08 Add World Model foundation (§9 of the Claude fix plan)
    world_model.py: layered spatial/semantic memory (obstacle map / odometry-
    delegated pose / rooms / objects-landmarks / routes), own SQLite file per
    master doc §13.4, exposing exactly the plan's own API. Wired passively into
    brain.py's tick loop (sonar->obstacle feed) with no motor consequence, same
    pattern as the existing odometry logging. Unblocks §10/§11 (mapping mode,
    navigation layer), next.
    [brain.py, config.py, test_world_model.py, world_model.py]
2026-08-08 Add Mapping/Learning Mode (§10 of the Claude fix plan)
    mapping.py: MappingSession records vision landmarks/objects into the world
    model while active, snapshots the map on stop/abort. Voice-triggered via new
    map/stop_map intents, mirroring the existing retrieve intent's pattern.
    Deliberately not a top-level brain.py FSM state, unlike the plan's literal
    phrasing -- self.mapping.active is an orthogonal flag checked passively
    alongside the existing ROAM/SLOW/AVOID/STUCK dispatch (same pattern as the
    §9 odometry/obstacle logging), so driving during mapping is the unmodified
    existing reactive FSM rather than a copy of it. Routing through a competing
    top-level state and calling into _avoid()/_st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
    [brain.py, mapping.py, test_mapping.py, voice.py]
2026-08-08 Add Navigation Layer (§11 of the Claude fix plan)
    navigation.py: Mission (room/route/raw xy) + Navigator resolving a global
    route (known Route waypoints, or a networkx shortest-path over known
    Room/Doorway records with a straight-line fallback when no graph is known
    yet) and driving it via a bearing-to-waypoint local planner, entirely
    through the existing safety.py gate. Obstacle avoidance mirrors brain.py's
    _avoid() reverse-then-turn pattern as a self-contained copy rather than a
    direct call into it, same reasoning as mapping.py's §10 deviation.
    Owns a new top-level NAVIGATE FSM state (unlike mapping, which stayed
    orthogonal) since actively driving legitimately needs one -- its own
    SEEKI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
    [brain.py, config.py, navigation.py, test_navigation.py]
2026-08-08 Add timestamp/camera_id to vision detections (§12 of the Claude fix plan)
    vision.py's ObjectDetector.detect() now returns timestamp and camera_id on
    every detection, matching the plan's required shape. bearing/range stay a
    separate localize() call rather than bundled in -- mapping.py already calls
    both together every tick, so merging them would be a larger refactor for no
    behavior change.
    [vision.py]
2026-08-08 Unify AI call sites behind one AIProvider (§14+§15 of the Claude fix plan)
    ai_provider.py: AIProvider ABC (non-blocking worker-thread plumbing moved
    from claude_client.py, plus a synchronous ask_sync() path) with
    CloudAIProvider/LocalAIProvider implementations. Retires claude_client.py
    and cloud_ai.py entirely -- both independently hit the same Anthropic
    endpoint with duplicated transport code; brain.py and voice.py now share
    one CloudAIProvider instance instead. Conversation history is caller-owned
    (threaded through each call) rather than provider-owned, so the shared
    instance can't leak STUCK's motion-decision turns into voice's unrelated
    free-text turns.
    AIResult replaces voice.py's ol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
    [ai_provider.py, brain.py, config.py, test_ai_provider.py, voice.py]
2026-08-08 Add configurable storage roots (§13 of the Claude fix plan)
    storage.py: resolve_root() backs new config.WILLY_DATA_ROOT/MAP_ROOT/
    MEMORY_ROOT/LOG_ROOT -- an env var override, or a repo-relative default
    matching today's exact behavior. Unifies three independent copies of the
    same __file__-relative path-join in memory_store.py/world_model.py/
    logsetup.py. check_storage() adds a startup availability/permission check,
    folded into brain.py's existing self-test gate -- a bad storage mount now
    blocks motion the same way a missing sensor already does.
    This unit has no physical SSD/SD split yet (confirmed via df/mount --
    master doc's boot-from-SSD migration is still pending), so all four roots
    reso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
    [brain.py, config.py, logsetup.py, memory_store.py, storage.py, test_storage.py, world_model.py]
2026-08-08 Close §20 testing gaps: SafetyController, corrupted-db, AI timeout, battery hysteresis
    Auditing §20's checklist against the existing 91-test suite found three real
    blind spots, not just thin coverage:
    - SafetyController itself had zero tests -- only the pure approve_motion()
    function was covered. tests/test_safety_controller.py adds command
    timeout/cancellation, mid-flight obstacle abort, emergency_stop().
    - Corrupted-database handling was unhandled, not just untested:
    MemoryStore/WorldModel.__init__ raised sqlite3.DatabaseError straight out
    of RoverBrain.__init__, crashing the whole service on a corrupted
    memory.db/world_model.db (a real failure mode after an unclean shutdown)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
    [memory_store.py, test_ai_provider.py, test_brain_battery.py, test_memory_store.py, test_safety_controller.py, test_world_model.py, world_model.py]
2026-08-08 Add structured EVENT= logging tags (§21 of the Claude fix plan)
    logsetup.log_event(): a grep-able EVENT=<NAME> tag (plus key=value fields)
    on top of the existing free-text rotating-file log, applied at real
    fault/abort call sites -- brain.py's per-subsystem health-check
    transitions (IMU_FAULT/ENCODERS_FAULT/CURRENT_FAULT/BATTERY_ADC_FAULT),
    all three battery-tier branches (LOW_BATTERY), safety.py's mid-flight
    obstacle abort (OBSTACLE_STOP), navigation.py's Navigator.abort()
    (NAVIGATION_ABORT), and ai_provider.py's timeout path specifically
    (AI_TIMEOUT, not every failure).
    Deliberately not a wholesale reformat into JSON -- every other existing
    log call is unchanged. ESTOP_ACTIVE/WATCHDOG_FA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
    [ai_provider.py, brain.py, logsetup.py, navigation.py, safety.py, test_logsetup.py]
2026-08-08 Add subsystem implementation status doc (§22 of the Claude fix plan)
    docs/WildWilly_Subsystem_Status.md: the IMPLEMENTED/HARDWARE REQUIRED/
    SIMULATION ONLY/PARTIALLY IMPLEMENTED/PLANNED tag taxonomy per Python
    module, a small ASCII diagram of the actually-wired AI/World
    Model/Navigation/Safety/Hardware data flow, and an explicit capability
    caution reiterating that this robot does not have SLAM, autonomous house
    navigation, persistent spatial memory, or stair climbing -- now that
    world_model.py/mapping.py/navigation.py exist and could be oversold by
    anyone skimming commit messages without reading each module's own
    "milestone 1, not SLAM" caveats.
    Closes out everything code-shaped in the Cla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
2026-08-08 Wire up BNO085 RST via MCP23017 B4; correct stale §4 gap-analysis finding
    sensors.py::IMU now passes a real digitalio-style reset pin (adafruit_mcp230xx,
    MCP23017@0x27 port B bit 4) to BNO08X_I2C, so its initialize()/hard_reset() does
    an actual GPIO pulse instead of the silent no-op it was before. Bit confirmed by
    owner (previously only "spare pin" in the master doc, no bit number); verified
    live on Willie: IMU + Encoders construct together in brain.py's exact order, both
    healthy, no register conflict on the shared MCP23017.
    Also corrected gap-analysis §4 (watchdog) from PARTIAL to DONE — it described a
    "stale tilt reading" gap that Phase 1's SENSOR_FAULT escalation (adb9077) already
    cl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
    [config.py, sensors.py]
2026-08-08 Throttle emergency_stop()'s log line to avoid tick-rate log flooding
    Found live on Willie (2026-08-08, first real RoverBrain.run() since Phase 1 —
    the arm PCA9685 VCC was reconnected, unblocking init past the long-standing
    0x43 fault): with the base powered off, battery_volts reads 3.17V (correctly
    below BAT_SHUTDOWN_V), and brain.py calls safety.emergency_stop() every tick
    for as long as that persists. brake()/deadline-clear correctly need to fire
    every tick, but emergency_stop()'s own log.warning() had no throttle, so the
    log filled at ~20Hz indefinitely — same class of bug as 516d1ec's
    memory.save_all_now() fix, just for a log line instead of a disk write, and
    missed by that pass sinc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
    [config.py, safety.py, test_safety_controller.py]
2026-08-08 Close §18 (owner config sign-off); log first live RoverBrain.run()
    ENABLE_CLOUD_AI/ENABLE_EMAIL confirmed to stay True by owner, no code change
    needed -- §18 moves PARTIAL->DONE. Tally now DONE:14/PARTIAL:2/MISSING:1(§17,
    hw-gated)/CONFLICT:2(stale)/N/A-HW:2.
    Also logs today's bigger event: the arm PCA9685's VCC was reconnected,
    resolving the 0x43 fault that blocked every init since Phase 1 -- willy-rover.
    service reached active(running) for the first time, live-verifying init/safety
    FSM/battery-shutdown path (see prior commit for the emergency_stop() log-spam
    fix that surfaced during this). Motion itself remains unverified live.
    C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
2026-08-08 As-built pass on Master Engineering Package (rev6.0.7) and FRD
    Both documents predated the WildWilly Claude Fix architecture pass
    (Phases 1-6, landed 2026-08-07/08) and had drifted from what's actually
    running. Corrected against direct code/live-hardware inspection rather
    than assumption:
    Master doc (rev6.0.7, the current revision -- rev6.0.md is superseded
    and was not edited): no systemd WatchdogSec is actually configured
    (the "500ms watchdog" claim throughout was never deployed); real FSM
    states and SafetyController.emergency_stop() documented in place of
    "ACTIVE/SAFE_MODE" and "disable autonomy, allow limited manual"; servo/
    motor-rail overcurrent and Pi-undervoltage hazard rows marked n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
2026-08-08 Guard smbus2 import behind SIMULATE_HARDWARE (audit P0-1)
    sensors.py imported smbus2 unconditionally at module level, unlike every
    other hardware library it uses (RPi.GPIO/board/busio/adafruit_bno08x/
    adafruit_mcp230xx, all already guarded). This meant WILLY_SIMULATE=1
    didn't actually make the app importable on a machine without smbus2
    installed (a laptop, CI) -- it only happened to work on this Pi because
    the package is present here. All three real smbus2.SMBus(...) call sites
    were already conditional on SIMULATE_HARDWARE, so moving the import
    inside the same guard was a pure no-op for real-hardware behavior.
    Verified against the audit's own acceptance criterion: RoverBrain()'s
    full start(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
    [sensors.py]
2026-08-08 Make storage permission tests root-independent (audit P1-1)
    Both permission-denial tests used chmod to lock a directory read-only,
    then asserted check_storage() reported it as unwritable. That assumption
    breaks when the test suite runs as root, which bypasses filesystem
    permission checks entirely -- root would still be able to write, turning
    these into silent false-passes rather than real negative-path coverage.
    Replaced chmod with unittest.mock.patch on open()/os.makedirs() to
    deterministically inject PermissionError/OSError regardless of which
    user runs the suite. check_storage() itself is untouched -- this was a
    test-design problem, not evidence the function was wrong.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
    [test_storage.py]
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2026-08-08 Add config self-test (audit P2); surfaces a real BAT_FULL_V/WARN_V bug
    config.py has grown into the central hardware/software contract (per
    the audit's own P2 note) with no automated consistency check -- a
    duplicate address or an out-of-order threshold was easy to introduce
    and easy to miss reading the file top to bottom.
    New config.validate(): pure function, no hardware access, checks for
    duplicate I2C addresses, duplicate raw GPIO pins, MCP23017 pin index
    collisions (a separate namespace from raw GPIO -- checks ENCODER_PINS
    against IMU_RST_MCP_PIN specifically), battery-tier threshold ordering,
    tilt warn-vs-limit ordering, servo pulse-width range sanity, and speed/
    duration bounds. 11 new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
    [brain.py, config.py, diagnostics.py, test_config_validate.py]
2026-08-08 Add tick-duration telemetry (audit P1); fix a real RoverBrain.stop() double-call crash
    Audit P1 asked for tick_duration_ms/tick_overrun_count/max_tick_duration_ms
    given no systemd WatchdogSec is actually configured (confirmed earlier
    today -- see the master doc's §14 as-built correction), so a hung tick
    loop has no OS-level backstop. run()'s loop now measures each _tick()
    call and routes it through the new _record_tick_duration() (extracted
    as its own method specifically so it's unit-testable the same way
    _bat_tier_for/_update_bat_tier already are, per test_brain_battery.py's
    pattern, without constructing a full RoverBrain). Overruns past
    config.TICK_OVERRUN_THRESHOLD_S (100ms) are logged v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
    [brain.py, config.py, test_sim_hardware.py, test_tick_timing.py]
2026-08-08 Add AI safety telemetry tags (audit P2): REQUEST/RESULT/REJECTED/UNAVAILABLE
    Only AI_TIMEOUT existed before (added during the §21 logging pass).
    The audit's recommended full set makes it possible to reconstruct what
    the AI was asked, what it returned, and what got rejected -- purely
    from the log, without touching the AI response pipeline itself.
    Added to both CloudAIProvider._call() and LocalAIProvider._call() (same
    shape in each, since both funnel through _parse_response()):
    AI_UNAVAILABLE when the provider isn't configured/loaded, AI_REQUEST
    right before the actual call, and either AI_REJECTED (schema/parse
    failure -- result.parse_success is False) or AI_RESULT (success, with
    intent_conf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
    [ai_provider.py, test_ai_provider.py]
2026-08-09 Correct stale §6 gap-analysis finding: battery load/open-circuit comment already shipped
    The row still said the comment was missing; it landed same-day back in
    Phase 1 (config.py/sensors.py) but this doc was never revisited after.
    Tally: DONE 14->15, PARTIAL 2->1.
    Claude-Session: https://claude.ai/code/session_01TfzDGzCqUHqrgZvxf8DUoc
2026-08-09 Raise TICK_OVERRUN_THRESHOLD_S to 0.15s to match measured brake-reassertion cost
    First live run of the tick-duration telemetry (971c6e0) surfaced constant
    overruns (100-134ms) during any sustained-brake state. py-spy against the
    live process traced it to safety.py::emergency_stop()'s intentional
    per-tick PCA9685 I2C reassertion in motors.py::brake() -- 6 real writes,
    not a bug. Recalibrating the threshold to real cost rather than removing
    the writes, which safety.py's own comment says exist to survive a
    noise-flipped register.
    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
    [config.py]
2026-08-09 Finalize as-built pass: master doc + correct FRD (v2.2.md, not v1.1.md)
    Master doc (rev6.0.7): documents full Claude Fix plan closure
    (gap-analysis DONE 15/PARTIAL 1/MISSING 1), the follow-on audit's 8
    commits, live-verification status after this week's restarts, and the
    TICK_OVERRUN root cause/threshold recalibration (§14). New 6.0.9
    changelog entry.
    FRD: discovered the 2026-08-08 as-built pass was applied to the wrong
    file. v1.1.md predates the entire v2.2 subsystem set and is missing 50
    of the 55 FR-IDs actually cited in the codebase -- v2.2.md is the real
    match, confirmed by grep. Redid the as-built pass on v2.2.md's FR-000
    through FR-1200 groups against current code (not copied from t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
2026-08-09 Enable voice pipeline (ENABLE_VOICE=True); fix a real cloud-dependency gap
    Model files were confirmed present (2026-08-06) and all required
    packages import cleanly -- the "not downloaded yet" comment was stale.
    Flipping the flag surfaced a real bug: WhisperModel(WHISPER_MODEL_SIZE)
    made a live HTTP request to huggingface.co on every construction, even
    with the model already cached locally, since WHISPER_MODEL_SIZE is a
    hub name rather than a filesystem path like the other three voice
    models. This violated FR-1500-002's "no cloud dependency for basic
    STT" and added a startup network dependency. Fixed with
    local_files_only=True (cache already exists locally). Updated the FRD
    to match.
    Not yet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
    [config.py, voice.py]
2026-08-15 Fix voice pipeline audio I/O, deploy Hey Willie wake model, fix local LLM parsing, correct display for landscape-mounted panel
    - voice.py: TTS playback used bare aplay, which conflicts with pipewire holding
    the USB audio device exclusively under this session -> switched to pw-play.
    Also installed missing libportaudio2 (sounddevice/PortAudio import was
    crashing the mic thread on every startup).
    - voice.py: fix acoustic feedback loop -- TTS output was leaking back into the
    mic (no echo cancellation on this mic+speaker puck), getting transcribed as
    a new "command", and self-triggering endless AI round-trips while deaf to
    real wake words the whole time (wake-scoring and utterance-han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
    [ai_provider.py, config.py, display.py, sensors.py, voice.py]
2026-08-15 Remove stale 0x70 from I2C self-test expected-device list
    construction in RoverBrain.__init__, which runs before the self-test
    scan — 0x70 legitimately never answers by scan time, so it was never
    a real device to check for.
    Claude-Session: https://claude.ai/code/session_01FuqcTFg3JEpoNgFiCPrUmD
    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
    [diagnostics.py]
2026-08-16 docs: Hailo AI HAT+2 driver bring-up complete, flag new IMU 0x4a regression
    Root cause of the PCIe "link down" saga was a Hailo-8-only package line
    (hailo-all) installed against Hailo-10H hardware — its driver's PCI ID
    table never matched the device (1e60:45c4), so it loaded but silently
    never bound. Swapped to hailo-h10-all; /dev/hailo0 live, hailortcli
    confirms HAILO10H fw 5.1.1. Reboot pending to confirm clean boot-time
    autoload.
    Also logs an unrelated regression found incidentally: willy-rover.service
    crash-looping since last night's boot on BNO085 (0x4a) not acking at all
    on i2cdetect — distinct from the reset-timing bug closed 08-14/08-15,
    whose patch is confirmed still present in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
2026-08-16 Recalibrate battery voltage sensing and full-charge anchor
    BATTERY_DIVIDER_SCALE had drifted from its 08-02 value (0.2865),
    causing false battery-shutdown emergency stops at a meter-confirmed
    12.2V pack. Re-trimmed to 0.2386 from a fresh simultaneous ADC/meter
    reading. Also set BAT_FULL_V to 11.58V (measured post-fuse), closing
    the display-only calibration gap flagged since 08-08/09.
    Claude-Session: https://claude.ai/code/session_01PTJXUWZ3pBaASZS6AWpNJE
    [config.py]
2026-08-16 Consolidate face-screen text to 2-line footer, fix inverted mouth shape
    Move the state badge, WILLY title, sonar F/L/R, tilt, and speed off
    the separate right-side HUD column and into the same 2-line status
    footer the status message already used, so all on-screen text lives
    in one place.
    Also fixes a real bug found while doing this: the mouth-shape arc
    was inverted (happy states drew a frown, fault states drew a smile).
    Correcting it exposed a second latent bug — the fixed smile shape
    dips below STATUS_Y and was being hidden behind the now-opaque
    footer background — so the mouth was also repositioned to clear it.
    Claude-Session: h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
    [display.py]
2026-08-16 Fix Arducam capture path (V4L2/MJPG) and confirm battery calibration is clean
    cv2.VideoCapture's default backend opened /dev/video8 (the Arducam
    OV9281's real capture node -- /dev/video0 is actually the imx708 CSI
    camera, /dev/video9 is metadata-only) but failed to stream from it
    (VIDIOC_QBUF: Bad file descriptor). Fixed by forcing the V4L2 backend
    and an explicit MJPG request, since the camera doesn't advertise a raw
    BGR/YUV mode OpenCV defaults to. Camera path confirmed working.
    Also flips test_config_validate.py's BAT_FULL_V regression test from
    "documents the known issue" to "documents it's fixed" now that the
    08-16 recalibration (11.58V, measured post-fuse) closed that gap.
    Co-Authore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
    [config.py, test_config_validate.py, vision.py]
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2026-08-16 Add a wave-and-say-hello voice command
    New 'wave' intent: speaks "Hello!" while oscillating wrist_rot +-300us
    off center three times, the same offset magnitude already trusted by
    retrieval_task.py's _grasp() sequence -- fixed primitive, not
    calibrated IK, same §20.6 gap as arm_stow/arm_home. Blocks the tick
    thread for ~1.5s, same accepted tradeoff as _grasp()/diagnostics;
    only ever runs from IDLE.
    Claude-Session: https://claude.ai/code/session_01UnPVAMLogDw2cc3Vfn4puQ
    [brain.py, voice.py]
2026-08-17 Add voice fast-path commands, fix STT/LLM latency, add time query
    Fast-path shortcuts for battery/status/stop/forward/etc bypass the LLM
    intent pipeline for near-instant replies. Also fixes the dominant
    latency source on the slow path: faster-whisper defaulted to beam_size=5
    with no VAD filtering (~10s/utterance), and the local llama.cpp model
    only used half the Pi 5's cores (no n_threads set). Adds a 'what time
    is it' fast-path command, answered live without touching brain.py since
    it needs no hardware state.
    [ai_provider.py, voice.py]
2026-08-17 Add FR traceability citations for drive/steering/arm/encoder subsystems
    Cross-referenced the full FRD v3.0 against the codebase (113 requirements,
    20 categories) to find gaps. Tagged what's genuinely implemented in
    motors.py (FR-400 drive control, FR-500 encoder read/stall), sensors.py
    (FR-800 sensors, FR-200-001 battery ADC, FR-500 encoders), and arm.py
    (FR-700-001 mirrored shoulder pair, FR-600-003 steering travel limits).
    Also documents what is NOT implemented, found while verifying rather than
    blindly tagging:
    - FR-700-004: E-stop does not stop arm motion. SafetyController only
    holds a drive_base reference, never touches Arm.
    - FR-700-002/003: no preset arm poses or calibrated per-joi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
    [arm.py, motors.py, sensors.py]
2026-08-18 docs: fix stale FRD/master-doc version refs, flag open sensors.py regression
    CLAUDE.md cited FRD v2.3 and Master Engineering Package rev 6.2.0 as
    authoritative; neither exists — current FRD is v3.0, and the master doc's
    own revision history tops out at 6.0.7. Subsystem Status doc's snapshot
    date and sensors.py row had drifted stale-optimistic, not reflecting the
    still-undiagnosed IMU crash-loop regression noted at the bottom of that
    same doc.
2026-08-18 Make retrieval_task.py's grasp sequence non-blocking; add missing tests
    _grasp() ran its whole pulse sequence through blocking time.sleep() calls
    (~1.1s total) inside a single tick(), so a tilt/battery/sensor-fault
    abort() -- called from the same tick thread -- had no way to run until
    the arm had already finished moving. Same class of bug Phase 1 fixed for
    drive motion (non-blocking control loop), never applied to the arm.
    Rewritten as a 4-step, deadline-serviced state machine polled from
    tick(), so abort() can land between any two steps.
    Updated arm.py/safety.py comments to reflect what's fixed vs. still
    structurally true (no explicit arm-brake call exists, but that's a
    smaller residual ga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
    [arm.py, retrieval_task.py, safety.py, test_retrieval_task.py]
2026-08-18 docs: fix stale voice-pipeline status, add missing pursuit_task.py row
    config.py had a self-contradicting comment block -- said the wake word
    was still the "Hey Jarvis" placeholder in the lines right above where
    the real trained hey_willie.onnx (deployed 08-15) was already wired in.
    Subsystem_Status.md's voice.py row matched that same stale story
    (ENABLE_VOICE=False, placeholder wake word) even though voice has been
    enabled with the real model since 08-16. Also added a table row for
    pursuit_task.py (FR-1000 come_here/follow), which had none despite
    being a real, wired-in subsystem, and noted this session's
    non-blocking-grasp fix on the retrieval_task.py row.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
    [config.py]
2026-08-18 docs: archive superseded FRD/master-doc versions
    Move FRD v1.1, v2.2 (.md+.docx), and Master Engineering Package rev6.0
    into docs/archive/ -- all three are superseded (by v3.0 and rev6.0.7
    respectively) and were cluttering docs/ alongside the current versions.
    Fixed two comments (brain.py, config.py) that referenced the v2.2 FRD
    by its old path.
    Claude-Session: https://claude.ai/code/session_011oxwe2nNaFLigiinHjMmUv
    [brain.py, config.py]
2026-08-18 docs: adopt FRD v3.1 / Master Hardware Design v2.0 / Software Design v1.0
    Move the newly-uploaded document trio into docs/ (they landed at repo
    root) and archive everything they supersede: AsBuilt Design v1.0, FRD
    v3.0, and the old Master Engineering Package rev6.0.7 (.md+.docx).
    Rewrite CLAUDE.md's Reference Documents section to point at the new
    trio instead of rev 6.0.7. That earlier fix (this session) turned out
    to be wrong: Master Hardware Design v2.0 §17.2 reveals "rev 6.2.0" was
    a real, newer document that was simply never committed to this repo,
    not a typo -- rev 6.0.7 is actually the oldest doc in the tree. Also
    update CLAUDE.md's "Known contradictions" section: motor mapping and
    a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
    [brain.py, config.py]
2026-08-18 Implement stall detection (Directive 5) and fix wave-hello's blocking bug
    FR-500-003/Directive 5: Encoders.stalled() had no caller anywhere in the
    codebase. Add DriveBase.commanded (per-wheel target state) and
    RoverBrain._check_stall(), wired into _tick() between Directive 4 and
    Directive 6 per the FRD's own priority ordering. A sustained stall
    escalates to emergency_stop() and a new STALL_FAULT state, same shape
    as TILT_FAULT. New config.STALL_GRACE_S=1.0 clears the ramp-up window
    and the encoder's own rate-sampling lag. Emits MOTOR_STALL (not
    MOTOR_FAULT, which always covered stall+overcurrent generically --
    only stall is implemented here). tests/test_brain_stall.py, 5 cases.
    Also found a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
    [arm.py, brain.py, config.py, motors.py, test_brain_stall.py, test_brain_wave.py]
2026-08-18 Implement interrupt-driven encoder decode (G-2 decision: option 1 of 3)
    Owner decided interrupt-driven decode over a dedicated hardware counter
    or accepting encoders as stall-only, to close the gap between the ~1kHz
    practical I2C polling ceiling and the ~8.5kHz/channel edge rate at the
    620rpm no-load spec.
    sensors.py::Encoders now configures the MCP23017 for interrupt-on-change
    (IOCON.MIRROR combines both ports' INT lines onto one pin; INTCON=0 for
    compare-to-previous; GPINTENA=0xFF but GPINTENB=0x0F, deliberately
    excluding bit 4 -- IMU_RST_MCP_PIN, driven as an output by a separate
    MCP23017 object during BNO085 hard_reset(), sharing this same physical
    chip) and registers a GPIO.add_event_d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
    [config.py, sensors.py]
2026-08-18 Add touchscreen fault-reset gate (FR-300-003, applied to all faults)
    Owner decision for what "operator reset before resuming" should mean:
    a touchscreen "TAP TO RESUME" button rather than voice/remote/physical
    -- there's a real 5" DSI touch panel already installed (Master Hardware
    Design v2.0 SS15.3). Second decision: apply it now to TILT_FAULT/
    SENSOR_FAULT/STALL_FAULT (which already fire today), not just build it
    as unverifiable placeholder infrastructure for a future E-stop that
    has no sense pin yet.
    Real behavior change: those three faults no longer auto-resume to IDLE
    the instant their condition clears -- they keep braking and wait for
    an explicit screen tap. The same mechanism will ga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
    [brain.py, display.py, motors.py, test_brain_reset_gate.py]
2026-08-18 Confirm smart-home direction (S-8): outbound is correct
    Owner decision: Willy sends commands OUT to existing Google Home
    devices via the already-built Home Assistant REST API bridge -- not
    the reverse (Willy controlled by Google Assistant, a different,
    unbuilt Actions-on-Google integration). Resolves a standing "ASSUMPTION
    (flag for review)" that had sat unconfirmed in the FRD since 2026-08-01
    (v1.3). No code change -- smart_home.py already implemented the now-
    confirmed-correct direction; updated its comment plus FRD v3.1 and
    Software Design v1.0's S-8/Open Actions entries to record the
    confirmation. Still disabled (ENABLE_SMART_HOME=False) pending Willie's
    own Google account credentials, u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
    [smart_home.py]
2026-08-19 Detect offline I2C bus at startup, fall back to simulate instead of crash-looping
    Found live 2026-08-19: after pulling this session's changes onto the
    rover and restarting the service, it crash-looped -- MotorKit(0x60)
    raised ValueError because the Pi was physically disconnected from the
    rover's sensor/motor harness (mid Witty Pi 5 HAT install), and
    RoverBrain.__init__() constructs every hardware object unconditionally,
    so any single chip not acking crashes the whole process before
    _self_test()'s existing "report a reason, don't crash" gate ever runs.
    systemd's Restart=on-failure then loops indefinitely with no operator-
    visible signal beyond the journal.
    main.py now probes the I2C bus (a l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
    [brain.py, main.py]
2026-08-19 Fix I2C-offline detection: patch config.SIMULATE_HARDWARE directly
    Live-tested on the rover: main.py's bus probe correctly detected the
    offline bus and printed its warning, but the service still crashed
    with the same real-hardware ValueError right after. Root cause: config
    was imported (to read the address constants for the probe) before the
    decision to force simulate was made. config.py computes
    SIMULATE_HARDWARE = os.environ.get('WILLY_SIMULATE','0')=='1' once at
    that import and Python caches the module in sys.modules -- setting the
    env var afterward doesn't retroactively change the already-computed
    value that every later `import config` elsewhere (motors.py,
    sensors.py, arm.py) sees, sinc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
    [main.py]
2026-08-19 docs: record the SIMULATE_HARDWARE caching gotcha found live-deploying
    Software Design v1.0 SS4.1 now documents the sys.modules caching bug
    found and fixed while live-testing the I2C-offline detection (56f6bae
    -> e6b71b1) on the actual rover -- config.SIMULATE_HARDWARE is frozen
    at each module's first import, not a live re-read.
    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
2026-08-20 docs: reconcile macro spec with existing FR-1900-006 teaching feature
    Found while preparing the user's guide: voice.py::_maybe_learn()
    already has a "when I say X, do Y" mechanism (add_instruction()),
    storing raw unstructured text that gets re-interpreted by the LLM
    each time the trigger recurs -- no validation, no confirmation, and
    it uses the identical trigger phrasing the new macro system's
    define_macro intent would use, so it would short-circuit and swallow
    every macro-definition attempt as written today. Spec now says the
    implementation must replace that branch with a call into the new
    structured macro system, not run alongside it.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
2026-08-20 docs: add a household user's guide for Willy
    Plain-language guide for the owner/family, separate from the
    engineering docs -- covers current, real capability only (deliberately
    not a wishlist). Cross-checked against voice.py's actual fast-path
    patterns and intent list, and against which intents are gated on
    detector.available (come_here/follow/retrieve all need the currently-
    disabled camera, not just motion-safety clearance -- corrected an
    earlier draft that grouped them with the driving caveat instead).
    Explicitly flags that driving/mapping/E-stop are implemented but not
    yet live-verified safe, so nothing overclaims readiness the engineering
    docs themselves don't yet support.
    Co-Authored-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
2026-08-20 docs: Bluetooth phone companion design spec
    Greenfield feature, brainstormed and approved by the owner 2026-08-20.
    One BLE connection (Android + Web Bluetooth, no app-store install)
    serves two narrowed-to-honest halves: (1) off-network status alerts
    pushed from Willy, reusing existing signals (battery tier, fault
    states, the touchscreen reset-gate, retrieval outcomes) rather than
    inventing new detection logic; (2) RSSI-based presence reframed as
    "last seen near you" position-logging via world_model.py's existing
    Observation mechanism, since a single radio can give proximity, not a
    bearing, and the answer format (time elapsed, not a room name) matches
    that honestly rather than overclaiming na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
2026-08-20 Prepare Witty Pi 5 HAT+ software ahead of physical installation
    Not yet installed on the unit, but preparing the software now per the
    owner's request. Confirmed the I2C address (0x51) and register map
    against the official UUGear user manual (fetched live rather than
    trusted from general knowledge, given the stakes of guessing wrong on
    a power-management HAT) -- it uses only SDA/SCL, no other GPIO at all,
    so there's no conflict with anything already claimed on this rover.
    New witty_pi.py is deliberately narrow in scope: the vendor's own
    wp5/wp5d software (one .deb install) already handles RTC sync,
    scheduling, the low-voltage cutoff, and reacting to its own
    shutdown-request register -- no cu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
    [brain.py, config.py, witty_pi.py]
2026-08-20 docs: document SPI0/GP7 GPIO-busy root cause and fix
    dtparam=spi=on was still reserving GP7-GP11 for SPI0 at boot despite the
    MCP3008 being physically retired, which crash-looped willy-rover.service
    on every restart (lgpio.error: 'GPIO busy' claiming the encoder interrupt
    pin). Fixed live by disabling SPI0 and rebooting; verified 2+ min stable
    with 0 restarts.
    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
2026-08-20 Gate autonomous ROAM behind ENABLE_AUTONOMOUS_ROAM (default off)
    Idle-timeout and post-charging auto-ROAM were sending Willy wandering with
    sonar-only obstacle sensing (no vision yet), tripping repeated STALL_FAULTs
    against things sonar didn't catch. Default off until vision is live-verified;
    manual/voice-commanded driving is unaffected.
    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
    [brain.py, config.py]
2026-08-20 Enable object detection/retrieval (ENABLE_OBJECT_RETRIEVAL=True)
    Model file, Arducam OV9281 (/dev/video8), cv2, and ultralytics all confirmed
    present on the live rover. Flipping on to live-verify; vision.py's own
    try/except in _load() fails back to disabled if anything doesn't actually
    work end-to-end.
    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
    [config.py]
2026-08-20 Revert ENABLE_OBJECT_RETRIEVAL: wired camera is rear-facing, not front
    Live-verified the detection pipeline works end-to-end (model, cv2, ultralytics,
    Arducam capture all confirmed), but owner confirmed the Arducam (CAMERA_DEVICE,
    /dev/video8) is mounted rear-facing. vision.py's _CAMERA_ID='front' and
    retrieval_task.py's detect-then-drive-forward logic both assume forward-facing,
    so this would misdirect retrieval/pursuit. Reverting until CAMERA_DEVICE points
    at the actual front camera (CSI imx708) and that capture path is verified.
    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
    [config.py]
2026-08-20 docs: record ROAM gate, camera orientation, and live under-voltage findings
    Documents three findings from live testing after the GP7/SPI0 fix: the new
    ENABLE_AUTONOMOUS_ROAM gate (sonar-only wandering was tripping repeated
    STALL_FAULTs), the Arducam being rear- not front-facing (ENABLE_OBJECT_RETRIEVAL
    reverted until the CSI front camera is wired in), and a live under-voltage
    condition (wp5/wp5d now installed to investigate, points to a physical
    cable/connector check next, likely explains the slow local-LLM voice latency).
    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
2026-08-20 docs: record disconnected arm servo connector found during live test
    Voice-triggered arm_home/wave dispatched correctly in software but produced
    no physical motion. Owner felt the wrist resist manual movement (consistent
    with a powered servo) then found some servo connector(s) actually
    disconnected under the cover - a physical wiring issue, not the same-day
    under-voltage finding. Re-seat and retest next session before considering
    closed.
    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
2026-08-21 Enable Witty Pi 5 (ENABLE_WITTY_PI=True) after live config
    wp5 configured live on the rover: default-state-when-powered=ON with 2s
    delay (bypasses the physical power button), power source priority=V-USB
    first, watchdog enabled at 200 missed heartbeats. 0x51 now expected by
    brain.py's self-test. Low-voltage threshold deliberately left unset per
    the existing VIN-vs-VUSB caveat.
    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
    [config.py]
2026-08-21 docs: root-cause and fix the live under-voltage/I2C flicker issue
    Traced yesterday's under-voltage finding to a degraded AMS1117-3.3 linear
    regulator - the same failure category as an earlier documented incident.
    It was pulling down its shared upstream supply enough to trip both the Pi's
    brownout detector and cause the isolated I2C bus to flicker (different
    devices dropping in/out unpredictably, not a clean single-connector fault).
    Two loose connectors were also found and fixed along the way but neither
    alone stabilized the bus - only the regulator swap did, confirmed with 18
    consecutive zero-flicker i2cdetect scans and a clean service self-test.
    Documents a planned follow-up: replace the li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
2026-08-21 Add retry-with-backoff to startup I2C device construction
    Found live 2026-08-21: constructing 9 I2C devices back-to-back with zero
    spacing at startup can draw enough simultaneous inrush current to transiently
    sag the bus below what a slow one-at-a-time i2cdetect probe ever catches -
    a device's own construction (e.g. MotorKit's first PWM write) then hits
    OSError: [Errno 121] Remote I/O error even though the bus is healthy moments
    later, causing a persistent restart-on-failure loop. _init_device() retries
    each hardware constructor up to 4 times with a 0.3s backoff before giving up.
    Not a substitute for real hardware margin - just resilience against a
    demonstrated transient at process startup s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
    [brain.py]
2026-08-21 Retry the startup I2C pre-flight probe before declaring the bus offline
    Same root cause as the brain.py retry fix: a single pass through every
    expected address can transiently miss all of them at once during a brief
    startup moment even when the bus is genuinely healthy, causing this check
    to falsely force degraded/simulate mode on an otherwise-working rover.
    Retry the whole probe up to 3 times with a 0.3s gap before concluding the
    bus is actually offline.
    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
    [main.py]
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2026-08-21 docs: implementation plan for Hailo vision + CSI camera integration
    Bite-sized plan covering the vision half of the Hailo NPU offload spec:
    COCO labels file, config flags, the picamera2.devices.Hailo backend swap
    in ObjectDetector (CPU/Arducam path untouched as fallback), and live
    deploy/verification steps. Grounded in the real installed picamera2.devices.
    Hailo class and the official raspberrypi/picamera2 reference example (both
    read directly during planning, not recalled from general knowledge) plus a
    pre-installed yolov8m_h10.hef confirmed present and loadable on this exact
    rover. Voice/STT and voice/LLM halves of the spec are explicitly out of
    scope - split into a separate follow-up plan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
2026-08-21 Fix cwd-relative labels path in _load_hailo() per review
    HAILO_COCO_LABELS_PATH is repo-root-relative; resolve it against the
    script's own directory (same pattern _load() already uses for
    YOLO_MODEL_PATH) instead of trusting the process cwd.
    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
    [vision.py]
2026-08-21 Enable Hailo vision backend after live verification, update docs
    Step 2: Flip ENABLE_HAILO_VISION=True in config.py with dated comment
    confirming live-verified end-to-end operation: Hailo backend loads
    correctly, real detection round-trip working with camera_id='front'.
    Step 5: Update CLAUDE.md camera-orientation note to reflect CSI/Hailo
    vision backend is now live-verified and enabled (2026-08-21).
    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
    [config.py]
2026-08-21 Fix Hailo vision review findings: fail-safe detect/close, SIMULATE_HARDWARE guard, stale docs
    Review findings from the whole-branch review of the Hailo vision backend:
    - _detect_hailo() now wraps its capture/run/decode body in try/except, logging
    and returning [] on any failure (camera timeout, HailoRT error, malformed
    output) rather than raising -- matches detect()'s documented "never raise"
    contract and stops a single camera hiccup from restart-looping the whole
    rover control service (its outer loop only catches KeyboardInterrupt).
    - close() now guards each backend release (_cap.release(), _picam2.stop(),
    _hailo.close()) in its own try/except+log.warning, so one failing release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
    [config.py, vision.py]
2026-08-21 docs: record verification scope and the behaviours ENABLE_HAILO_VISION arms
    Two review findings that the previous fix commit did not carry over. Comment/
    doc only -- no flag values or code paths changed.
    - CLAUDE.md said the Hailo backend "loads correctly at startup". It was
    verified by a standalone run with willy-rover.service STOPPED, not at
    service startup; the plan Task 3 steps that restart the live service and
    check its journal have not been run yet. Reworded to state what was
    actually covered and what was not (service startup alongside the SDL
    display/voice stack, and per-tick timing vs WatchdogSec=500ms, since
    detect() runs synchronously on the tick thread).
    - Neither fi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
    [config.py]
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2026-08-21 voice: endpoint capture on silence + instant wake chirp
    Attacks measured voice latency without needing any of the Hailo NPU work that
    spec section 10 records as blocked. Live measurement on this rover for
    "What time is it?" was stt=12.1s intent=0.0s tts=4.6s total=16.7s, with the CPU
    at a full un-throttled 2.4GHz -- so this is real compute cost, not the power
    throttling artifact the spec guessed at.
    Endpointed capture: _handle_wake() used a fixed 4s window, so a 1.3s command
    paid the same latency as a 4s one -- roughly 2.7s of every interaction was spent
    recording silence before STT even started. Now ends on trailing silence once
    speech has been heard, bounded by VOICE_CAPTURE_MIN_S/MAX_S.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
    [config.py, voice.py]
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2026-08-21 voice: switch Whisper to base.en (3x faster STT, same transcription)
    Benchmarked on the rover itself against a real "what time is it" clip generated
    by the actual Piper voice, service stopped so nothing contended:
    small.en 3 threads -> 5.71s "What time is it?"
    small.en 4 threads -> 5.84s "What time is it?"
    base.en 3 threads -> 1.88s "What time is it?"
    base.en 4 threads -> 1.96s "What time is it?"
    3x faster with a byte-identical, correct transcription on this phrase. Live STT
    was running ~9.5s (higher than the bench figure because of service contention and
    a longer captured clip), so this should take roughly 6s off a voice interaction:
    measured total was 16.1s, expect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
    [config.py]
2026-08-21 voice: stop discarding the first 0.3s of capture -- it held the first word
    Regression I introduced with the wake chirp, caught live. _handle_wake() threw
    away _ACK_SKIP_S (0.30s) of frames so the chirp would not be recorded, on the
    assumption that nobody speaks that fast. They do -- people start talking the
    instant the wake word fires, so those frames hold the first word.
    Live evidence:
    16:49:08 capture: 1.2s of 4.0s max (endpointed=True)
    16:49:11 Heard: "Time is it." <- "What" was in the discarded frames
    16:49:11 AI_REQUEST provider=local <- missed _fast_path()'s fullmatch
    16:50:31 voice timing: stt=5.0s intent=74.2s tts=5.6s total=84.9s
    Losing one word turned a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
    [voice.py]
2026-08-21 voice: widen fast-path coverage, tiered by consequence of a false match
    The fast path uses fullmatch, so only exact whole-utterance phrasings hit it.
    Real speech carries filler -- "Willie, stop", "can you stow the arm", "what's the
    battery at please" -- and every one of those missed and fell through to the local
    LLM.
    That was a sound trade when written: the comment weighs a miss as costing "the
    LLM's usual latency", assumed 15-20s. Measured live on this rover 2026-08-21 it
    is 74.2s for one intent, 84.9s end to end. A miss is ~15x more expensive than the
    original reasoning assumed, so coverage now matters far more than it did, while
    the danger of a false match is unchanged.
    Rather than wide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
    [voice.py]
2026-08-21 voice: don't let the wake chirp arm the endpointer
    Second regression from the chirp, the mirror of the first. Removing the frame
    discard fixed the clipped first word, but exposed this: the chirp is audible to
    our own mic (no echo cancellation on this puck), so it latched heard=True at
    frame 0. The speaker's natural pause right after the chirp then read as
    end-of-utterance, silent hit the 0.6s threshold, and capture cut at the 0.8s
    minimum while they were still talking.
    Live symptom: every command truncated to exactly 0.9s, Whisper returned an empty
    string, and _process_utterance took its "How can I help?" branch. Four attempts
    at 17:02 and four more at 17:07-17:08 produced capture lines wit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
    [config.py, voice.py]
2026-08-21 docs: session record -- power delivery fault + voice latency work
    Captures the two threads from 2026-08-21 so neither has to be re-derived.
    POWER FAULT (unresolved, next session's job). ~0.223 ohm in the Pi's 5V path,
    measured by four instruments at the same moment: Witty Pi V-OUT 5.06V, INA260
    5.04V @ 1.39A, multimeter 4.98V, but the Pi's own PMIC reads 4.73V. Because drop
    scales with current, ~3.8A puts the Pi at 4.19V and it browns out -- which is
    why asking it the time reproducibly powered the rover off. A bigger buck cannot
    fix this; the supply is already holding 5.04V. Evidence points at the HAT header
    stack rather than a cable, since an 11-inch 7A cable swap changed nothing and
    distu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
2026-08-22 voice: add "what's the date" as a fast-path command
    Mirrors how 'time' already works: answered inline in _fast_path() and spoken by
    _act_on_intent()'s tail, so 'date' never reaches brain.py and needs no handler,
    no motion_intents entry, and no queueing. Two edits in voice.py, nothing else.
    Coverage is deliberately generous (20 phrasings verified) because 'date' is NOT
    in _interpret_local()'s prompt. Anything that misses the regex falls through to
    the local LLM, which has no clock and would confidently invent a date -- a wrong
    answer is worse here than the 74s latency, so the regex has to catch it.
    Uses tm_mday rather than strftime %-d: that flag is glibc-only, and plain %d
    would have Piper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
    [voice.py]
2026-08-23 Re-enable Hailo vision after resolving power/I2C faults
    DROK buck now feeds Witty Pi's VIN at 9V (low-voltage cutoff reconfigured
    to 8.0V to match), and the loose 3.3V wire to the I2C peripheral bus has
    been reseated -- full bus now enumerates cleanly. Re-enabling vision now
    that these real hardware faults are addressed.
    [config.py]
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2026-08-23 Task 1 complete: shared Hailo device confirmed live, no vision rework needed
    Ran the actual experiment on the rover via SSH (service stopped both times).
    First attempt used the wrong API (picamera2.devices.Hailo can't load
    multi-input GenAI models). Second attempt confirmed real device exclusivity
    via hailo_platform.genai.VDevice(). Third attempt found the actual answer:
    LLM(Hailo.TARGET, hef_path) reuses vision's existing class-level shared
    VDevice directly -- true in-process sharing confirmed live, no _load_hailo()
    changes needed. This is cheaper than spec section 10.3 anticipated; Task 2 is
    superseded and folded into Task 4.
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2026-08-23 Fix HailoIntentModel: clear conversation context after every call
    Real failure hit live during Task 4 testing: generate_all() is stateful,
    accumulating context across calls until 'Conversation context is full' and
    every subsequent call fails to parse. Each call here is meant to be
    single-turn (same contract as LocalAIProvider), so clear_context() runs in
    a finally block after every call regardless of outcome.
    [hailo_llm.py]
2026-08-23 Task 4 progress: context-clearing bug found and fixed, 4-case subset at 50%
    Full 32-case run hung on the stateful-context bug before the fix; a 4-case
    subset with the fix shows 50% (2/4), including a real placeholder-leak bug
    in one output. Not yet close to the 75% CPU baseline -- full batch pending.
2026-08-23 Scaffold Hailo STT behind ENABLE_HAILO_STT, blocked on x86 compilation machine
    Task 5 of docs/superpowers/plans/2026-08-23-hailo-voice-offload.md. Same
    fail-safe pattern as the vision/LLM backends -- HailoWhisper always raises on
    construction today (no HEF exists), falling straight through to the existing
    CPU faster_whisper path. Deploy/verify on the rover deferred until the
    Task 4 LLM reliability test currently running finishes.
    [config.py, hailo_stt.py, voice.py]
2026-08-23 Task 4 final result: full 32-case run at 0% -- do not enable ENABLE_HAILO_LLM
    Worse than the 4-case subset (50%), not a fluke. Recurring identical parse
    failure position plus repeated template-placeholder leakage in the cases
    that did parse. Recommendation: keep the flag off; this needs real further
    investigation (context-clearing verification, prompt simplification, or
    possibly this model/path just isn't reliable enough yet), not a quick fix.
2026-08-23 docs: update Software Design for Hailo vision/voice work, module inventory refresh
    Section 7 rewritten: vision is no longer CPU-only (Hailo YOLOv8 shipped,
    enabled), voice LLM attempted but not enabled (0% reliability, real
    investigation needed), voice STT scaffolded but blocked on x86 compiler
    access. Module table refreshed with real current line counts for the five
    files that changed materially this session, new modules added. Open Actions
    updated: accelerator integration marked done, three new items for the LLM
    reliability gap, the I2C fault, and the power rework.
2026-08-23 docs: update Master Hardware Design for power rework and I2C fault
    Documents the Witty Pi VIN feed change (DROK buck at ~9V, cutoff moved to
    8.0V), the isolated-bus 3.3V connector fault found and reseated (permanent
    hot-glue fix still pending, 0x40 current monitor needs confirming), and
    marks the AI accelerator integration done for vision. New Open Items for
    the Hailo LLM reliability gap and the pending hardware fix.
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2026-08-23 Raise WAKEWORD_THRESHOLD 0.5 -> 0.65: false wakes traced to dehumidifier noise, not echo
    Ruled out echo-decay timing first -- widening VOICE_ECHO_DECAY_S 0.6s->2.0s
    didn't stop the false triggers, which fired 8s after the reply ended, well
    outside any speech-adjacent window. Owner identified a dehumidifier running
    in the room as the actual noise source. 0.65 is untested live -- needs a
    real retest to confirm it cuts false positives without missing real
    wake attempts.
    [config.py]
2026-08-23 Call Model.reset() after speaking: clears stale wake-word smoothing state
    Neither raising VOICE_ECHO_DECAY_S (0.6s->2.0s) nor WAKEWORD_THRESHOLD
    (0.5->0.65) stopped the ~8s-post-reply false wake. Root cause: predict()
    is skipped entirely while _speaking is set, so openwakeword's internal
    smoothing-window state goes stale, including whatever was elevated from
    the genuine wake event that started the reply -- scoring then resumes
    mid-decay from that stale buffer rather than cold. Model.reset() (confirmed
    present on the installed openwakeword version) clears it.
    [voice.py]
2026-08-23 Widen _DATE_PATTERN: add 'what's today's day' phrasing
    Real live miss -- 'What's today's day?' fell through to the 34s LLM path
    because none of the existing alternatives have 'today's' placed before
    'day'. Separately noted but not fixed here: Whisper (base.en) mis-heard
    a different date attempt as 'What is today's game?' -- an STT accuracy
    issue, not a pattern-matching one.
    [voice.py]
2026-08-23 Add a second chirp signalling Willy has finished speaking
    Owner-requested. Two 660Hz pulses, audibly distinct from the single 880Hz
    wake chirp. Plays blocking, before _speaking clears / the wake model resets
    -- so its own sound is muted the same defensive way the wake chirp's is,
    not left to self-trigger the false-wake bug just fixed. Gated on
    config.VOICE_DONE_CHIRP_ENABLED, default True.
    [config.py, voice.py]
2026-08-23 docs: correct MCP23017 connector assumption -- same style as motor JST-PH
    Owner physically inspected and confirmed both ends use the same connector
    style, just different wire-color assignment -- corrects the earlier Dupont
    inference drawn from the BOM's separate listing.
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2026-08-23 docs: correct G-2/S-2 -- 8.5kHz figure was wrong, retract interrupt-driven decode
    8.5kHz double-counted the gearbox reduction (already baked into
    ENCODER_COUNTS_PER_REV) against 620 RPM as output-shaft speed -- implies a
    ~46000 RPM motor. Real rate is unresolved, roughly 450-4400 Hz depending on
    an unconfirmed gear ratio; resolve by bench test, not arithmetic. Separately,
    interrupt-driven decode is retracted: it breaks galvanic isolation (MCP23017
    is on the isolated side of ISO1540), doesn't actually save I2C transactions
    (INTA still needs a register read to learn what changed), and is incomplete
    (INTA is port-A only, LR/RR need INTB, no free pin identified). Raising
    i2c_arm_baudrate is the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
2026-08-23 Revert interrupt-driven encoder decode -- breaks I2C isolation, saves nothing
    sensors.py::Encoders reverts to pure polling: removes the MCP23017
    IOCON/INTCON/GPINTEN register writes, GPIO.add_event_detect() wiring, and
    _on_interrupt() callback. _loop() goes back to a tight poll instead of the
    0.1s heartbeat-only mode (which would have badly under-sampled real motion
    once GP7 was wired). config.ENCODER_INT_PIN removed along with its
    validate() reference. Reasoning: the MCP23017 lives on the isolated side of
    ISO1540 -- wiring INTA to a bare Pi GPIO would have run a conductor across
    that barrier, and interrupt-driven decode would not have reduced I2C
    transaction count anyway. GP7 reverts to fre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
    [config.py, sensors.py]
2026-08-23 G-6 follow-up: root cause found -- two compounding model failure modes, not prompt wording
    Ruled out context-clearing bug and generation-length cutoff via real
    introspection (get_context_usage_size, greedy-decoding determinism check).
    Found two real causes: (1) model doesn't reliably stop generating after a
    valid answer, producing runaway hallucinated conversation continuation that
    buries the answer past _parse_response()'s first-to-last-brace parsing;
    (2) model echoes template placeholder words literally regardless of
    convention (angle brackets, ellipsis, all-caps word all got echoed).
    Full 32-case run with a dramatically simplified real-intent-list prompt:
    still 0% (0/32) -- simplification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
2026-08-24 Fix four real issues found in independent code review
    1. sensors.py::Encoders._loop -- RESTORE time.sleep(0.001). The interrupt-decode
    revert dropped it entirely rather than restoring it, producing a sleepless
    busy-loop that had never run in any prior version. That saturates I2C bus 1,
    which is shared with both MotorKits (stop commands), the ADS1115 battery ADC
    feeding brownout logic, and the IMU -- every one of those would queue behind
    back-to-back encoder reads. Verified against f33f756^ (pre-interrupt) which
    had the sleep. This was a regression I introduced, not a pre-existing issue.
    2. voice.py::_speaker_loop -- reset() the wake model BEFORE clearing _speaking,
    not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
    [config.py, hailo_llm.py, hailo_stt.py, sensors.py, voice.py]
2026-08-24 CurrentMonitor: isolate per-rail reads, throttle failure logging
    Two real bugs found live 2026-08-24 with INA260 0x40 absent:
    1. Cascade blinding. _update() looped the three rails with no per-rail error
    handling, so the first failure (servo/0x40, first in dict order) propagated
    out and the pi (0x44) and motor (0x45) rails were never read at all. One
    absent device made all three rails report stale zeros -- which is why the
    self-test verdict read 'current monitors not reporting' rather than just
    naming 0x40, and why motor-rail current was unavailable for diagnostics.
    2. Log flood. A permanently-absent device emitted a full traceback on every
    iteration at 10Hz -- measured 76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
    [sensors.py]
2026-08-24 Correct INA260 rail labels against live measurement
    Read directly off the bus with base power on (2026-08-24):
    0x40 -> absent (Errno 121)
    0x44 -> 11.388 V @ 0.113 A
    0x45 -> 9.070 V @ 0.001 A
    Neither old name matched its rail. 0x45 was INA260_MOTOR_ADDR / rail 'motor'
    but reads 9V, not the 12V motor bus -- owner confirmed it now sits on the DROK
    9V feed to Witty Pi's VIN after the 2026-08-23 power rework. Renamed to
    INA260_WITTY_ADDR / rail 'witty' across brain.py, diagnostics.py, main.py,
    sensors.py and config.validate().
    0x44 is left named INA260_PI_ADDR but flagged UNVERIFIED in config: 11.39V is
    pack/bus voltage, so 'Pi 5V rail' is definitely wrong, but the correct name
    isn't est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
    [brain.py, config.py, diagnostics.py, main.py, sensors.py]
2026-08-24 Correct transposed INA260 addresses: 0x44 is the motor bus, 0x45 is the Pi feed
    Measured live with base power on and self-test passing:
    0x40 -> 5.148 V @ 0.136 A (matched docs exactly)
    0x44 -> 11.373 V @ 0.112 A (docs claimed 5.0-5.1V Pi buck rail)
    0x45 -> 9.068 V @ 0.002 A (docs claimed +12V motor bus)
    0x44 and 0x45 were transposed. The 2026-08-23 power rework is why: the Pi is no
    longer fed 5V from the Pi buck, it's fed 9V via DROK -> Witty Pi VIN, so the Pi's
    monitor is 0x45 and the +12V motor bus is 0x44. Owner-confirmed.
    The original constant NAMES were correct all along -- only the two address values
    were swapped -- so this reverts the interim INA260_WITTY_ADDR rename a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
    [brain.py, config.py, diagnostics.py, main.py, sensors.py]
2026-08-24 docs: record INA260 physical placement -- 0x45 (9V Pi feed) is leftmost from front
    Owner-provided 2026-08-24. Useful because the established top cause of an INA260
    dropping off this bus is a loose logic-side wire, so mapping address to physical
    board saves tracing. 0x40 and 0x44 positions still to be filled in.
2026-08-24 docs: complete INA260 physical placement -- 9V / 12V / 5V left to right from front
    0x45 (9V) leftmost and 0x40 (5V) rightmost owner-stated; 0x44 (12V) middle by
    elimination. Layout matches neither voltage order nor address order, so position
    can't be inferred -- worth having written down given loose logic-side wiring is
    the established top cause of an INA dropping off this bus.
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2026-08-24 Fix silent battery self-shutdown; add power indicator and self-test override
    1. BATTERY-READS-ZERO (the important one). ADC._loop() forced _bat_raw=0 on a
    failed read, so brain.py's tier ladder saw 0.00V, classified it 'shutdown',
    and powered the rover off -- with no low-battery warning and no fault state,
    because battery_adc was deliberately excluded from SENSOR_FAULT escalation on
    the reasoning that the 0V path reached the same outcome anyway. It does not:
    it makes an I2C glitch indistinguishable from a flat pack. This fired for real
    on 2026-08-24 when a loose I2C wire self-terminated Willy and destroyed the
    evidence. Now a failed read HOLDS the last good value and rep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
    [brain.py, config.py, display.py, sensors.py]
2026-08-24 Willy emails a help photo when he gets STUCK
    Owner-requested, scoped to STUCK only. When Willy enters STUCK -- meaning he has
    exhausted his own avoidance attempts and escalated -- he emails a front-camera
    photo plus pose, sonar distances, battery voltage and episode count, so the
    situation can be seen rather than guessed at.
    Three parts:
    - email_client.send_alert(): adds MIMEMultipart/MIMEImage attachment support and
    a no-confirmation send path. This is the ONLY place Willy sends outbound mail
    without human confirmation. Bounded deliberately: it can only send to
    EMAIL_OUTBOUND_ALLOWLIST[0], it is triggered solely by his own fault states
    rather than anything inbound, and it reports r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
    [brain.py, config.py, email_client.py, vision.py]
2026-08-24 Revert two ineffective voice settings; add motor-power-loss detection
    VOICE_ECHO_DECAY_S 2.0 -> 0.6 and WAKEWORD_THRESHOLD 0.65 -> 0.5. Both were
    raised mid-investigation on theories that were then ruled out -- neither stopped
    the false wakes, Model.reset() did. Reverting matters now that motion is enabled:
    at 2.0 the decay plus the blocking done-chirp created a ~2.4s window after every
    reply where Willy could not hear 'Hey Willie, stop', and voice stop is a real
    safety path that deliberately bypasses the command queue. The raised threshold
    likewise only risked missing a genuine wake -- including the one before a stop.
    Removed the stale comment block that still argued for keeping 2.0.
    Motor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
    [brain.py, config.py]
2026-08-24 FR-300 satisfied by hardware per owner authorization; G-1/S-1 closed
    Owner decision 2026-08-24, stated directly: the Pi does not need an E-stop sense
    line, the main power down is sufficient.
    Recorded as an explicit, traceable decision rather than a silent relaxation. The
    latching mushroom switch physically cuts motor and arm power; that cut is
    absolute and does not depend on software running, being responsive, or being
    correct. On that basis FR-300-001 (continuous monitoring) is met by construction,
    FR-300-002 (immediate disable) is met more strongly than software could manage,
    and FR-300-003 (operator reset) is met by the latching switch itself. The
    touchscreen reset gate remains in force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
2026-08-24 Add standalone rail logger to capture the trace across a shutdown
    Witty Pi powered Willy down three times on 2026-08-24 (09:29, 10:55, 11:18)
    with "Shutdown reason: Vin < Vlow" against the 8.0V threshold set during the
    9V rework -- at 84% battery (~11.36V), so the pack was never the cause and
    brain.py's ladder never fired. wp5d.log records the verdict but not the
    measurements behind it, and journald here runs volatile, so each event
    destroyed its own evidence.
    The open question is whether VIN genuinely sags under load or Witty Pi
    misreads it. Logging INA260 0x45 voltage AND current together discriminates:
    current pinned flat while voltage falls is the DROK in constant-current mode
    (owner id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
    [power_logger.py]
2026-08-24 Raise drive speeds above breakaway torque
    The previous set (ROAM .55 / TURN .50 / SLOW .35 / MAX .80) was below the
    torque needed to start this chassis moving: commanded motion produced an
    audible hum with no rotation. Per-wheel bench measurement on 2026-08-24 put
    breakaway around 0.5 duty, so SLOW=0.35 could only ever stall the motors.
    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
    [config.py]
2026-08-24 Correct MOTOR_PORT to the as-built wiring: M1=middle, M2=front, M3=rear
    Established 2026-08-24 by driving one wheel at a time with the rover on a
    block and having the owner name the wheel that actually turned. M2-left drove
    the left front, M1-right the right middle, M2-right the right front; the
    remaining two follow by elimination and the convention is symmetric.
    The old mapping was wrong in a self-concealing way: _set() commands all three
    wheels of a side identically, so forward/reverse/skid turns were unaffected.
    It only mattered once per-wheel diagnostics began -- and there it actively
    misled, reporting a dead leg as 'lf' when the physically dead motor is the
    left MIDDLE wheel on 0x60 M1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
    [config.py]
2026-08-24 Correct §7.2 motor port assignment to as-built; flag encoder column unverified
    The doc carried the same wrong mapping config.py did: ports listed in
    front/middle/rear order when the as-built wiring is M1=middle, M2=front,
    M3=rear on both kits. Verified 2026-08-24 by driving one wheel at a time on a
    block and recording which wheel actually turned.
    Also flags the Encoder A/B column as unverified. Only the driver ports were
    tested, and since those did not follow position order, the encoder channels
    cannot be assumed to either. Affects per-wheel odometry attribution only.
    Records the open fault: left middle motor on 0x60 M1 draws zero current at
    every duty in both directions, against ~0.11A f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
2026-08-25 Record the left middle motor fault as resolved: disconnected connector
    Symptom was zero current draw at 0.35/0.60/0.80/0.90 duty in both directions
    on 0x60 M1, against ~0.11A for every healthy motor free-running. Root cause
    found by physical inspection 2026-08-25: the connector was disconnected, not
    a failed motor or driver channel. Confirmed by watching the wheel turn under
    command.
    Keeps the diagnostic reasoning in section 7.2 rather than deleting it, since it
    generalises to the other five legs: twelve consecutive pulses giving identical
    near-zero readings is what pointed at wiring rather than a commutator dead
    spot, which varies between attempts at the same duty. Also records that a
    stal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
    [config.py]
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2026-08-25 Compose the time/date fast-path patterns instead of enumerating phrasings
    "What is the current time?" missed the fast path and cost 38.6s through the
    local LLM (intent=30.1s), directly after "What is today's date?" answered in
    8.5s. That presented as "the second command never works" -- position was
    coincidence, phrasing was the cause.
    _TIME_PATTERN carried `(?:the )?current time` as a bare alternative, so nothing
    allowed "what is" in front of it, while the neighbouring
    `(?:what's|whats|what is) the time` required "the time" to follow immediately.
    "the CURRENT time" satisfied neither. _DATE_PATTERN had the same hole.
    Both are now built as an optional interrogative prefix (_ASK) composed wit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
    [test_voice_fast_path.py, voice.py]
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2026-08-25 Compose the arm preset patterns so "center arm" stops costing 30s
    The arm patterns enumerated three surface forms each, so "center arm", "arm
    center" and "park the arm" all fell through to the local LLM at ~30s. Now
    composed as verb x subject, accepting both word orders, which is the same fix
    the time/date patterns got in c6473ee and for the same reason: enumeration is
    what let that class of gap recur three times.
    Note brain.py aliases BOTH arm_home and arm_stow to arm.center_all(), since no
    calibrated stow pose exists yet (section 20.6). The intents are distinct; the
    behaviour is not yet.
    Also corrects the face recognition plan's regression baseline from 4
    pre-existing test failures to 2.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
    [test_voice_fast_path.py, voice.py]
2026-08-25 Set WHEEL_DIAMETER_M to the measured 4in; add a steering servo current test
    WHEEL_DIAMETER_M was 0.065, an UNCONFIRMED placeholder. Owner measured the
    wheels at 4.00 in on 2026-08-25, which is 0.1016 m -- 0.319 m/rev against the
    0.204 m/rev the code assumed. Every distance odometry has ever reported was
    56% short of actual, and anything derived from dead reckoning before today
    carries that error, including stored world_model landmark positions.
    Note the measured figure is nominal/unloaded diameter. Effective ROLLING
    diameter under the rover's weight is slightly smaller if the tyre compresses,
    so a drive-a-known-distance check is still what settles it. TRACK_WIDTH_M
    (0.28) and ENCODER_COUNTS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
    [config.py, odometry.py, servo_current_test.py]
2026-08-25 Record the measured 400mm chassis width; correct a stale envelope citation
    config.py cited a "430x330x220mm chassis envelope (section 2)" as the basis for
    both odometry constants. That figure exists ONLY in
    docs/archive/WildWilly_Master_Engineering_Package_rev6.0.7.md -- a superseded
    document the repo explicitly says not to cite as authoritative -- and the
    current Master Hardware Design v2.0 carries no chassis envelope at all. Owner
    measured the chassis at 400mm wide on 2026-08-25; the archived 430mm is stale.
    TRACK_WIDTH_M stays 0.28 and stays UNCONFIRMED, deliberately. The 400mm figure
    is the chassis, not the track, and odometry.py:36 divides by wheel CENTRELINE
    spacing: wheels mounted ou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
    [config.py]
2026-08-25 Correct the drive motor spec: 12V 620 RPM, not 6V 100-200 RPM
    Section 7.1 recorded "6V nominal, ~100-200 RPM". The motors are 12V 620 RPM,
    owner-corrected 2026-08-25. That is a different gearbox entirely, and anything
    reasoned from the old figure is suspect -- including the assumption that the
    11.4V rail was over-driving them. It is not: 12V motors on a 12V rail, at their
    rated voltage.
    The correction also answers the low-torque complaint, which is not a fault.
    620 RPM is a low-reduction speed-optimised gearbox, and torque scales with
    reduction -- the 100-200 RPM variants of this same motor make roughly 3-5x more.
    Wheel radius compounds it: tractive force is motor torque x reduction / wheel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
    [config.py]
2026-08-25 Correct ENCODER_COUNTS_PER_REV: 3292 -> 752 from the real 17.1:1 reduction
    Follows directly from the motor spec correction in b01ade9. The old value was
    derived as "823.1 PPR x4 quadrature", and 823.1 divided by the 11 PPR
    motor-shaft encoder implies a 74.8:1 gearbox -- the reduction that matches the
    stale "6V, 100-200 RPM" spec, not the 12V 620 RPM motors actually fitted. Owner
    gave the real reduction as 17.1:1, consistent with 620 RPM from a ~10,600 RPM
    bare motor, so the correct figure is 11 x 4 x 17.1 = 752 and the old constant
    was 4.375x too high.
    odometry.py divides by this, so distances were reported at about 23% of actual
    from the encoder side alone. Together with the wheel diameter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
    [config.py, encoder_calibration.py]
2026-08-25 Fix encoder_calibration.py: counts is a property, not a method
    Called enc.counts() and got TypeError: 'dict' object is not callable.
    sensors.Encoders.counts is decorated @property. Verified the plumbing with a
    short no-turn run: it reads all six wheels and reports correctly.
    Claude-Session: https://claude.ai/code/session_018ueVT8zxN55tBKDxHcqQDT
    [encoder_calibration.py]
2026-08-25 Set TRACK_WIDTH_M to the measured 0.310; record the chassis envelope
    Owner measured 400mm overall width ACROSS THE WHEELS and 90mm wheel width on
    2026-08-25. Outer edges at +/-200mm put the wheel centrelines at +/-155mm, so
    the track is 310mm, not the 0.28 placeholder. odometry.py:36 divides d_heading
    by this, so the old value over-reported rotation by about 11%.
    That closes the last uncalibrated odometry input. All three were wrong as of
    this morning: wheel diameter 1.56x under, encoder counts 4.375x under, and
    heading 11% over. Distance was under-reported by roughly 6.8x combined.
    Also records the envelope: 430mm long x 400mm wide across the wheels, wheels
    90mm wide. Worth noting the arc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
    [config.py]
2026-08-25 Correct the encoder power rail; record the unresolved encoder signal fault
    Section 2.2 listed encoder distribution on R4, the Pi's own 3V3 header pin.
    Owner-corrected 2026-08-25: the encoders are powered from the isolated bus rail
    (VCC2/GND2), the same domain as the MCP23017 that reads them. Header pin 1 feeds
    ISO1540 Side 1 only.
    The distinction cost real time today. If the encoders HAD been on R4 they would
    have been driving GND1-referenced signals into GND2-referenced expander inputs
    across a barrier section 3.1 requires to have no DC path, which would have
    neatly explained all six encoders reading static. They are not, sensors and
    expander share a reference, and that explanation is void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
2026-08-25 Root-cause the dead encoders: AMS1117-3.3 failed, isolated rail at 2.83V
    Measured 2026-08-25: AMS1117 input 5.143V (healthy), output 2.83V against a
    3.3V target. The part has ample headroom at that input -- dropout is only
    ~1.1-1.3V -- so 2.83V means it is degraded, not starved. This document already
    warned about exactly this in section 12: "the dissipation drives it into
    thermal foldback and the isolated rail collapses progressively."
    This explains the one property no other hypothesis could: why all six encoders
    fail identically while everything else on the same rail tests healthy. Every
    I2C device there tolerates 2.83V -- MCP23017 to 1.8V, PCA9685 to 2.3V, INA260
    to 2.7V -- so the bus, ex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
2026-08-28 Docs: EPLZON board rev 3.2, INA260 0x44 relocation, correct stale address map
    Adds docs/WildWilly_EPLZON_Combined_Board_v3.2.md — the combined I2C bus /
    3.3V regulation / sonar divider board that replaces the twice-failed
    AMS1117-3.3 with the TPSM84203EAB.
    Board fixes over the owner's rev 3.1:
    - C6 (47uF/35V electrolytic) moved to the bottom section of cols 25/26. At
    c25d/c26d a 6.3mm can overlapped both C1 and the P2 JST, 2.54mm away on
    each side. Adds GND/12V bridge wires across the gap.
    - LTC4311 moved cols 5-8 -> 1-4; its SCL down-run passed over J1's GND pin
    under a 3-pin JST body.
    - Fuse 1A fast-blow -> slow-blow (C6 + C1 inrush would nuisance-trip).
    - J3 relabelled REAR -> RI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
2026-08-28 Docs: EPLZON board rev 3.4, supersede 3.2; flag G-1 regression as unverified
    Replaces docs/WildWilly_EPLZON_Combined_Board_v3.2.md with rev 3.4, the
    owner's consolidated build document. Netlist re-verified hole-by-hole against
    the rev 3.4 draft: no hole is used twice, every net resolves, and the 12-wire
    list matches the body exactly.
    Rev 3.4 reverses three rev 3.2 decisions, all owner calls, now recorded with
    their consequences rather than left implicit:
    - ISO1540 reinstated off-board. Col 12 carries ISO side-2 (GND2/SDA2/SCL2)
    plus a fourth VCC2 wire; the Pi no longer lands on this board.
    - LTC4311 returns off-board, to be mounted adjacent with the shortest leads.
    - Sonar headers 3-pin -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
2026-08-28 Docs: fold the bus node board into the three maintained documents
    The EPLZON board was living as a fourth standalone document. The maintained
    set is Master Hardware Design, Software Design, and Functional Requirements,
    and they are meant to stay in sync -- so the board now lives inside them and
    docs/WildWilly_EPLZON_Combined_Board_v3.4.md is deleted.
    Master Hardware Design, section 4 rewritten as the complete board:
    - 4.0 board structure, zones, and the centre-gap warning
    - 4.1 device-zone tap allocation (the existing 21-row table, corrected)
    - 4.2 circuit zone cols 21-30: rail map, power block, pull-ups, LED, dividers
    - 4.3 the 12-jumper wire list
    - 4.4 free space
    - 4.5 build order,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
2026-08-28 Docs: finish the AMS1117 -> TPSM sync; correct the galvanic-isolation premise
    Follow-up to 257a488, which folded the board in but left twelve references
    still presenting the AMS1117 as the current part. One of them was actively
    dangerous: section 12 constraint 2 read "The AMS1117-3.3 input is the 5V rail.
    Never 12V", which is the exact opposite of what the TPSM requires. Anyone
    following that rule during the build would have wired the new regulator wrong.
    It now states the TPSM rule and explicitly warns not to carry the old one
    forward.
    Swept and corrected: 2.2 rail table (R2 no longer feeds a regulator) and the
    repair note; 3.1 topology text and diagram; 10 ground reference; 12
    constraints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
2026-08-28 Docs: C6 constraint is can diameter, not lead pitch
    Section 4.5 step 3 told the builder to measure before ordering and implied a
    wrong-pitch part was unusable. Electrolytic leads bend easily over a 2.5mm
    span, so either pitch seats. The real constraint is the can: a 6.3mm body
    covers the row-a jumper holes 2.54mm to either side, and an 8mm body also
    crowds the TPSM at c26b. Reworded to dry-fit against diameter, which is what
    actually decides it.
    Claude-Session: https://claude.ai/code/session_019rAxMEdtjCZqDiH8LBMXuk
2026-08-28 Docs: FEICHAO UBEC and DZS buck replaced by individual DROKs
    Owner replaced both converters 2026-08-28 -- reliable similar components, one
    per rail. Four DROKs at 9V, 5V, 3V, 6V. Rail voltages, roles and fuse
    assignments are unchanged; only the converter parts differ, so downstream
    wiring, INA260 placement and the PCA9685 V+ feeds are unaffected.
    Swept: 2.1 distribution tree (P5, P6, plus new P8/P9 rows for the 3V DROK and
    the TPSM feed, neither of which had a path recorded at all); 2.2 rail table and
    the off-load setup voltages; 8 Arm; 15.6 and 15.8; 16.4 INA feed tables; 16.9
    PCA9685 V+ feeds; 2.3 SW-A placement; the FRD's SW-A description; and the rail
    table in scripts/servo_current_test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
    [servo_current_test.py]
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2026-08-31 Power design 2026-08-28: DROK consolidation + two-stage isolated bus chain
    **Master Hardware Design §2-3, §12, §15-16 updates:**
    - §2.1: Update distribution tree — P3 now includes INA260 0x44 monitoring;
    P4/P8 reflect new DROK routing (DROK-Pi, DROK-5V, DROK-6V); P8 adds
    polyfuse F6 and two-stage chain
    - §2.2: Add DROK inventory table with names; replace single TPSM warning
    with two-stage chain explanation (TPSM84205 → AMS1117-3.3)
    - §3.1: Topology now describes +12V → F6 → TPSM84205 (5V) → AMS1117-3.3 (3.3V)
    - §12 constraint 2: CRITICAL — use TPSM84205 (5V), NOT 84203 (3.3V) or 84212 (12V)
    - §15.4: Remove TPSM/capacitor entries (now external P8 path)
    - §15.6: Add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
    [config.py]
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2026-09-01 Enable autonomous thinking: Hailo LLM primary, Claude fallback
    **Architecture:**
    - STUCK state now tries Hailo Qwen2 1.5B (.hef on NPU) first (~10-50ms inference)
    - If Hailo confidence >= 0.7 (HAILO_LLM_CONFIDENCE_FLOOR), execute locally without cloud
    - If Hailo fails or confidence < 0.7, escalate to Claude Sonnet 5 as fallback
    - All AI decisions flow through new _apply_ai_motion() helper for consistent logging
    **Config changes:**
    - ENABLE_HAILO_LLM=True (was False, now primary)
    - HAILO_LLM_CONFIDENCE_FLOOR=0.7 (70% confidence threshold for local execution)
    **Code changes:**
    - brain.py imports HailoIntentModel (on-device LLM provider)
    - RoverBrain.__init__ instantiates self.hailo_llm if EN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
    [brain.py, config.py]
2026-09-02 Docs: clarify capacitor voltage ratings for TPSM84205 power chain
    §12 constraint 5 + §15.6 BOM now explicit:
    - 10µF 50V (Vin sides: TPSM input + AMS1117 input)
    - 47µF 50V ceramic (TPSM Vout, 5V rail)
    - 10µF 10V+ ceramic (AMS1117 Vout, 3.3V rail)
    Rule: Input stages = 50V (transient headroom). Output stages = lower OK
    (50V overspecs safe, 10V minimum on 3.3V).
    Fixes 2026-09-02 mistake where 47µF 10V caps were ordered for 5V output.
    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
2026-09-02 EPLZON redesign: add battery voltage divider to board (2026-09-02)
    §4.2 Circuit Zone updated:
    - Battery divider now on EPLZON cols 21-24 top (was external breadboard)
    - R3: 10kΩ (12V → midpoint), R4: 10kΩ∥4.7kΩ (midpoint → GND)
    - Midpoint tap → ADS1115 A0 (row 3 col 22)
    - External 12V feed from P8 to col 21 top
    §4.2 allocation table updated:
    - V21: battery divider high side (12V input)
    - G22: battery divider return + sonar div reference (consolidated)
    - SDA col 22: battery divider midpoint to ADS A0
    §15.4 BOM updated:
    - Added 10kΩ resistor (high side)
    - Added 10kΩ + 4.7kΩ (low side parallel)
    Consolidates battery voltage measurement onto the main board, removes
    separate ex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
2026-09-06 Correct arm servo channels: subtract 1 from previous mapping
    Updated PCA9685 0x43 channels (subtract 1):
    - CH6: ARM_BASE (was CH7)
    - CH5: ARM_GRIPPER + FSR402 (was CH6)
    - CH4: ARM_WRIST_ROT (was CH5)
    - CH3: ARM_WRIST_PITCH (was CH4)
    - CH2: ARM_ELBOW (was CH3)
    - CH1: ARM_SHOULDER_B (was CH2)
    - CH0: ARM_SHOULDER_A (was CH1)
    - CH7: unused (was CH0)
    Shoulder pair (CH0-1) move together: J1b = 2×1500µs − J1a
    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
    [config.py]
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2026-09-07 Move Hailo LLM off the tick thread; enable autonomous ROAM
    Two changes, one a defect fix and one an owner decision.
    1. brain.py::_stuck() no longer blocks the tick thread.
    f18af62 (2026-09-01) made the Hailo LLM primary for STUCK-state motion
    decisions and called it synchronously, on the tick thread, via the private
    _call(). That put a full autoregressive generate_all() inside a single tick
    against the unit's WatchdogSec=500ms, which needs a WATCHDOG=1 heartbeat
    every 250ms and sends one per tick -- the exact mid-tick kill FRD v3.1 G-5
    describes, arriving when the rover is already up against an obstacle. It
    also violated ai_provider.py::ask_sync()'s documented contract ("only for
    callers a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
    [brain.py, config.py]
2026-09-07 Docs: the systemd watchdog was never armed -- installed unit was stale
    Resolves the "unreconciled since 2026-08-08" question carried in brain.py
    and FRD v3.1 G-5. Checked on the rover today:
    /etc/systemd/system/willy-rover.service was byte-identical to this repo's
    willy-rover.service EXCEPT for a single missing line, WatchdogSec=500ms,
    and `systemctl show -p WatchdogUSec` returned 0.
    So the repo file had been correct since 2026-08-02 (df24199) and simply was
    never deployed. The 2026-08-08 audit was right about the live unit; the
    comment guessing "stale deploy" was right about the cause.
    This reframes a month of entries in both directions:
    - Every "systemd kills the process mid-tick" risk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
    [brain.py]
2026-09-07 Disarm WatchdogSec: arming it crash-looped the rover
    Installing the repository unit on the rover today to arm the watchdog was a
    mistake and was reverted within the hour. The service was SIGABRT'd roughly
    500ms after every start -- four starts in twenty seconds -- and never
    reached its own first log line. The rover was left stopped rather than
    cycling, on the unit it had before.
    Root cause is structural, not a bad threshold. This unit is Type=simple, so
    NotifyAccess defaults to `none` and systemd DISCARDS every sd_notify message
    the process sends. brain.py's WATCHDOG=1 heartbeat was never received by
    anything, so no heartbeat rate could satisfy the deadline and the watchdog
    fired unconditio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
    [brain.py]
2026-09-07 Docs: TPSM84205 installed; AMS1117-3.3 is NOT retired
    Owner confirmed 2026-09-07: the isolated-rail chain is the two-stage
    Design A, now built and functioning --
    +12V -> F6 (RXEF110 1.1A) -> TPSM84205 (12V->5V) -> AMS1117-3.3 (5V->3.3V) -> VCC2
    and the AMS1117-3.3 additionally supplies the touch sensor.
    The repo described two mutually incompatible power designs and had done
    since 2026-08-28. Design A (two-stage, above) in the P8 path, section 3,
    section 4, section 16.2, section 14 item 2 and the BOM. Design B
    (single-stage TPSM84203EAB, AMS1117 retired) in the section 2 diagram,
    section 5, section 14 item 6, the retired-parts table, CLAUDE.md and the
    FRD. Same document called the AMS111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
2026-09-07 Docs: record that the Side-2 4.7k I2C pull-ups were removed
    Owner reported 2026-09-07 that a previous Claude session directed the
    removal of the SDA2/SCL2 4.7k rail pull-ups (R1/R2). Nothing in this
    repository recorded it -- no doc, commit or code comment -- so every table
    described a board that no longer existed, and section 14's pre-power
    checklist still instructed the next person to verify parts that are not
    fitted.
    Corrected across all three documents plus CLAUDE.md:
    - 3.2 rewritten: rail pair marked removed, the ~1.3k combined figure
    retired as unmeasured, and the reasoning recorded for why removal can be
    correct (an LTC4311 supplies the fast edge actively, and 1.3k drew ~2.5mA
    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
2026-09-07 Fix _init_device: retry on missing device, not just I/O errors
    brain.py::_init_device exists to survive a startup transient -- many I2C
    devices constructed back-to-back can sag the bus enough that a device's own
    construction fails though the bus is healthy moments later (2026-08-21).
    It caught OSError only. Adafruit's I2CDevice.__probe_for_device() raises
    ValueError ("No I2C device at address: 0x60") when nothing ACKs, so the
    "isolated rail has not come up yet" case propagated on the first attempt
    with zero retries. The guard that existed for exactly that scenario never
    engaged -- which is what crash-looped willy-rover.service on 2026-09-07
    when the FeatherWings were off the bus.
    Now catch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
    [brain.py, test_brain_init_retry.py]
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2026-09-09 Voice capture moves to the dedicated USB mic; puck keeps the speakers
    Owner decision 2026-09-09: retire the Waveshare mic+speaker puck's MICROPHONE,
    keep its SPEAKERS. The puck is the only non-HDMI playback device on the rover,
    so disabling it outright would leave Willy mute -- including the spoken
    roam-permission ask added earlier today.
    Playback needed no change at all. All three speak/ack sites shell out to
    pw-play, which targets PipeWire's default sink, and that sink is already the
    puck. config.AUDIO_OUTPUT_DEVICE turns out to be dead config -- nothing reads
    it anywhere -- so it is now commented as inert rather than left looking
    functional.
    THE RATE PROBLEM
    The replacement mic cannot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
    [config.py, test_voice_resample.py, voice.py]
2026-09-09 Correct the stale MOTOR_PORT comment; it described the opposite mapping
    config.py's comment block still described the 2026-08-24 bench-measured order
    (M1=MIDDLE, M2=FRONT, M3=REAR) while the dict directly beneath it has read
    M1=REAR, M2=MIDDLE, M3=FRONT since 484fbdc on 2026-09-04. Anyone reading the
    file top to bottom got the exact opposite of what the code does.
    Deliberately NOT resolved by making the comment agree with the dict. That would
    present an unverified mapping as settled, which is the failure this repo has
    already paid for once. The comment now states the order actually in force, then
    records that it is not bench-verified, that it replaced one that was, what the
    2026-08-24 one-w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
    [config.py]
2026-09-09 Docs: BNO085 INT (GP15) belongs on the breakout; Pi 3V3 does not
    Correction to 89264c3's new section 5.3, caught by the owner: the eleven-line
    list for the on-order screw-terminal HAT was wrong in two ways that happened to
    cancel out to the right total.
    MISSING: BNO085 INT on GP15, physical header pin 10 (section 6.3, and the pin
    table in section 16). It is wired but unused by the driver -- the library polls
    over I2C -- which is likely why it was easy to overlook. Land it anyway; the run
    already exists.
    WRONGLY INCLUDED: the Pi's 3V3, header pin 1. The rails table's R4 row gives its
    only consumer as "ISO1540 Side 1 VCC only", and the ISO1540 came out of the
    build on 2026-09-08. Section 2.1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
2026-09-09 Docs: the TPSM84205 is fitted but out of service, not removed
    Owner-confirmed 2026-09-09: "the TPSM is there, not really used". Neither of the
    two claims already in the docs was right, and they contradicted each other:
    - section 0, section 2 and CLAUDE.md said the TPSM was REMOVED FROM THE BUILD.
    It is not. The part is still on the board.
    - section 14 and the BOM said the AMS1117 was "Installed -- in service, not
    retired" and "still the single point of failure on VCC2". It cannot be in
    service: its only input was the TPSM's 5V output, and the rail it fed does
    not exist.
    The actual state is a third one neither section had: FITTED, NO CONSUMERS, OUT
    OF SERVICE. That distinction is wo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
2026-09-10 Spec: "I'm in the kitchen, come to me" — room navigation plus find-the-person
    Design approved in chat 2026-09-10. Owner chose real room navigation over a
    search heuristic, rooms labelled after a mapping run, labelling via
    export -> browser page -> import, and routing through labelled doorways.
    Records the blocking dependency prominently: the navigate leg cannot be
    live-validated until the wheel encoders work, since Navigator steers by
    odometry.pose and no encoder channel has produced an edge since 2026-08-25.
    Everything is buildable and unit-testable against hw_sim in the meantime, so the
    spec separates what can be built now from a live acceptance test that is held.
    Exploration corrected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
2026-09-10 Spec: Willy knocks and asks to be let in at a shut door
    Owner decision 2026-09-10, replacing the "re-planning if a door is shut" line
    that was previously listed as out of scope. Retry rule chosen: knock, ask, wait
    ~15s, up to three attempts, then report and fail.
    Restricted to LABELLED DOORWAY waypoints only. Knocking at any blocked path
    would have him politely knocking on a sofa in the hallway.
    The safety shape of this matters more than the behaviour. Knocking is the only
    motion on this robot that deliberately drives an actuator into a rigid object,
    and it is the one with no safety net under it:
    - the 6V arm rail has NO current monitor -- no INA260, and servo_current_test.py
    was never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
2026-09-11 Docs: bring the household user guide up to date (was 3 weeks stale)
    The guide had not been touched since it was written on 2026-08-20 and had become
    wrong in the direction that matters for a household-facing document: it told
    readers Willy would NOT drive on his own and should not be relied on to stop,
    while autonomous ROAM has been enabled since 2026-09-07.
    Three statements were the reverse of the truth and are corrected:
    - "don't expect Willy to drive around on his own" -- he does now
    - "come here / follow me will just get you 'my camera isn't available'" --
    vision has been live since 2026-08-23 and both work
    - "the emergency stop hasn't been confirmed working" -- closed 2026-08-24 by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
2026-09-11 Docs: VL53L7CX multi-zone ToF on order, arriving 2026-09-12
    Ordered 2026-09-10. Records the part and, more importantly, the integration
    decisions taken while choosing it, so they are not re-derived from scratch when
    the box arrives.
    ADDED ALONGSIDE THE FRONT SONAR, NOT REPLACING IT. The two fail in opposite
    directions: sonar is blind to chair legs, soft furnishings and angled surfaces;
    ToF looks straight through glass, which sonar reflects off perfectly well.
    Neither covers the other's blind spot. The same reasoning will apply to a lidar
    later, since it shares the ToF's glass problem.
    Three constraints recorded because each is a trap:
    - Mount behind the TCA9548A already on the shelf. The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
2026-09-11 Docs: subtract a per-zone floor profile instead of masking ToF rows
    Supersedes the blanket row-mask specified in 739d078 a day earlier. Masking the
    bottom rows is the obvious fix and the wrong one: it discards real obstacles in
    exactly the zones that matter. Mounted around 20cm the floor first appears about
    32cm out, inside DIST_SLOW, so the rows a mask would throw away are precisely
    where a shoe or a cable at close range shows up.
    Instead: park on clear level floor, record what each of the 64 zones returns, and
    store that as the expected floor distance per zone. At runtime a zone counts as an
    obstacle only when it returns meaningfully shorter than its stored value. Low
    obstacles stay visib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
2026-09-11 Docs: FR-1200-005 stair standoff, and record the 15-degree camera down-angle
    Owner decision 2026-09-11: mark stairs during mapping and hold 0.15m clear while
    in floor mode, released by an explicit switch to stair mode. Cliff sensors are
    dropped -- the chassis extends past the body, so nothing can be mounted ahead of
    the front wheels without a bracket in the stair-riser strike zone.
    Framed as a capability gate, not an exclusion. The rocker-bogie is designed to
    climb stairs (FR-1200); the same mapped geometry that keeps him clear today is
    what he approaches deliberately later. So stair labels carry POSITION, HEADING
    AND WIDTH -- a circle is enough to avoid and useless to climb, and capturing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
2026-09-11 Spec: Willy introduces himself and waves when someone is introduced
    Owner decision 2026-09-11, extending the enrolment flow in section 5. Being
    introduced is a social exchange, not a database write, and a bare "enrolled" ack
    reads as the latter.
    brain.py::_wave() already exists as a non-blocking step machine on its own FSM
    state, so this is reuse rather than new motion code.
    Three constraints recorded:
    - The wave runs AFTER capture completes, never during. An arm sweeping through
    frame while embedding a face can occlude the face being learned, and that
    failure would present as "enrolment is unreliable" rather than as an obvious
    ordering bug. Sequence: capture, embed, store, speak, w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
2026-09-11 Spec: Willy asks who someone is before calling them a stranger
    Owner decision 2026-09-11. A confidently-unknown face now gets "Hello -- who are
    you?" first. A name that resolves to an enrolled identity gets a normal greeting;
    an unknown name, or no reply before a timeout, gets "Stranger Danger!".
    This is the recovery path for the error that actually matters. Face recognition's
    common failure is a false reject -- an enrolled person in poor light, a new
    haircut, a hat -- and without this that error is indistinguishable from an
    intruder and just as loud. One question rescues the case entirely, and it takes
    much of the pressure off the threshold tuning.
    Three things recorded because they are n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
2026-09-11 Spec: Willie commits the approved request himself, and never with git add -A
    Owner confirmed 2026-09-11: the approval comes back to Willie, and Willie is what
    records it and places it in GitHub.
    Refines the original design, which relied on the hourly auto_backup.sh cron to
    pick the file up. That works but it does `git add -A`, and on 2026-09-09 that swept
    a session's in-progress, still-untested work into a commit titled "Automated
    backup: <timestamp>" -- it only failed to reach GitHub because the rover was behind
    and the push was rejected. So Willie stages exactly the one request file, commits
    it with a real message, and pushes. The narrower command cannot do what the sweep
    did.
    If the pus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
2026-09-12 Master Hardware Design rev 2.1 — reconcile the document with its own §0
    Revision 2.0 carried most of v1.0 forward unchanged. §0's 2026-09-08 as-built
    capture then contradicted a dozen of those carried-forward sections without
    correcting them, so the document disagreed with itself in places that decide
    wiring. Reviewed and reconciled.
    Corrected:
    - §1's bus row said "Galvanically isolated I²C, 10 devices". Two errors: not
    isolated since 2026-09-08, and eleven devices. Anyone reading only §1 got the
    wrong architecture.
    - §2.2's R1 said 9V where §0 says 9.5V, and R5 still asked "3V or 5V?" after §0
    settled it at 3.3V. The DROK inventory note said all four were pending; they are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
2026-09-12 Software Design rev 1.1 — reconcile with the hardware doc and with the code
    Same problem as the hardware doc: a "Revision 1.0" dated 2026-08-18 that has been
    edited through 2026-09-11. Reviewed against the CODE rather than against the other
    document, which settled two claims outright and reversed a third.
    CORRECTED IN THE SOFTWARE DOC:
    - §4.1 said the Witty Pi 5 was "not yet on the unit", that ENABLE_WITTY_PI stays
    False and that 0x51 stays out of _EXPECTED_I2C. config.py:227 has it True and
    brain.py:71 adds 0x51 to the set. The hardware has been fitted for three weeks.
    - §4.1 step 3 said the self-test expects ten addresses. It expects eleven.
    - §12 items 11 and 12 described a loos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
    [brain.py]
2026-09-13 Docs: ToF part changed to DFRobot SEN0628; mux requirement withdrawn
    Owner decision 2026-09-13. The MusRock VL53L7CX breakout ordered 2026-09-10 did
    not arrive; replaced with DFRobot SEN0628 at $22 -- same sensor, but with an
    RP2040 in front of it, and that changes three things this section was designed
    around.
    - NO FIRMWARE UPLOAD ON THE PI'S BUS. A bare VL53L7CX needs ~84KB pushed at every
    init, and that was the ENTIRE reason the previous revision routed the sensor
    through the TCA9548A. The RP2040 does it locally, so the mux requirement is
    withdrawn.
    - UART IS AVAILABLE, selectable by DIP switch, so the sensor can stay off the bus
    that took the whole rover down twice on 2026-09-07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
2026-09-13 Docs: record the SEN0628 in CLAUDE.md and the FRD
    CLAUDE.md had no ToF section at all, despite it being the working-context file and
    the sensor arriving tomorrow. Adds the operational traps rather than the design,
    which lives in Master Hardware Design section 6.5:
    - set the DIP switch first -- wrong setting is a silent device that looks exactly
    like a wiring fault
    - peel the protective film off the optics, which the documentation does not mention
    - bench it over USB-C and prove a stable multi-minute stream BEFORE it goes near
    the reflex path, given the reported reset-looping
    - power from 3.3V not 5V: on UART the logic level follows the supply and the Pi's
    RX is not 5V tolerant
    - the T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
2026-09-13 Hardware Design: second consistency pass — divider dates, INA260 0x45, section 9
    Ten items from review, all verified against the file or the code before acting.
    Two were settled by config.py rather than by comparing documents.
    SETTLED BY CODE:
    - Section 13's Pi-rail INA260 row said 0x44 and cited config.INA260_PI_ADDR=0x44 as
    agreeing. config.py:212 says 0x45 ("VERIFIED 9.068V") and config.py:210 puts 0x44
    on the +12V motor bus. The row was stale from before the 2026-08-28 correction in
    section 15.8 and survived the rev 2.1 pass. Section 0, 2.2 and 16.4 were right.
    - Section 13 said the battery divider was calibrated 2026-08-16 while section 0 says
    the divider was added 2026-09-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
2026-09-13 Software Design: second consistency pass — S-2 recomputed, Witty Pi untangled
    Eight items from review. One changed a conclusion rather than a date.
    S-2 RECOMPUTED, AND THE ANSWER GOT WORSE. The entry argued on 2026-08-23 that the
    "~8.5kHz/channel" encoder concern was overstated and the real figure was "roughly
    450-4,400 Hz". That argument used constants corrected two days later and was never
    revisited. With the measured values -- ENCODER_COUNTS_PER_REV=752 (config.py:119) and
    620 RPM confirmed as the OUTPUT speed (config.py:123, "620 RPM from a ~10.6k RPM bare
    motor" through 17.1:1, corroborated by the ~3.3 m/s top speed on 101.6mm wheels) --
    the per-channel edge rate is 620/60 x 752 = ~7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
2026-09-13 CLAUDE.md: grep for the old value when a fact changes
    Three review passes on 2026-09-11/13 found the same defect repeatedly, across all
    three design documents: corrections land where someone happened to be looking while
    a paragraph two sections away goes on asserting the old state.
    The costly instances, tabulated in the new section so the pattern is concrete rather
    than abstract: the ISO1540 removal survived in six places for weeks; the corrected
    encoder constant left BOTH Software Design S-2 and FRD G-2 arguing from a dead
    figure, and both reached a WRONG CONCLUSION because of it -- dismissing an
    under-sampling concern that the real numbers say is roughly 8x oversubscribed; the
    INA260 addr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
2026-09-14 Section 3.2 recomputed: the ISO1540's removal changed the pull-up answer
    Owner: "the doc is very wrong, WE REMOVED THE ISO ENTIRELY." Correct, and worse
    than a naming problem -- section 3.2's pull-up analysis was never recomputed when
    the isolator came out on 2026-09-08, and the electrical CONCLUSION changes.
    THE PI'S OWN PULL-UPS NOW SERVE THE WHOLE BUS. The Pi 5 carries physical 1.8k
    pull-ups on GP2/GP3. Those used to sit on Side 1, isolated from every device. With
    the ISO1540 gone and the hubs hanging straight off the header, they pull up the
    entire segment. At 400pF that is ~2.2us to threshold against a 10us bit --
    comfortably fine -- and section 0's twenty consecutive clean scans with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
2026-09-14 The I2C bus runs on the Pi's own 3.3V; DROK-4 feeds the encoders only
    Owner-stated 2026-09-14, correcting a claim that was in every document: section 0,
    section 2.2, the BOM and CLAUDE.md all said R5/DROK-4 fed "Hall encoders and all
    I2C device logic". It feeds the encoders and nothing else. The bus runs from Pi
    header pin 1.
    TWO CONSEQUENCES, both material, and both unwinding edits made this week.
    1. PI HEADER PIN 1 IS LOADED, AND ALWAYS HAS BEEN. Section 5.3, section 9 and the
    rails table's R4 row all said Pi 3V3 had no consumer, and R4 was struck through
    on that basis in rev 2.1. Wrong -- it powers the entire device bus. R4 is
    un-struck and restated as a live rail with a real b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
2026-09-14 Pull-ups: 4.7k rail pair is NOT fitted — owner-confirmed, dispute closed
    Section 0 claimed they were re-fitted; section 3.2 and the section 15 BOM both said
    removed. The BOM and 3.2 were right and section 0's claim is withdrawn.
    The bus runs on the Pi's own 1.8k pull-ups on GP2/GP3 plus uncatalogued breakout
    pull-ups -- adequate, and confirmed by 20 consecutive clean scans. Sink current from
    the Pi's pair alone is ~1.8mA against the ~3mA a device is specced for, so there is
    headroom but not much: do not add pull-ups without measuring the combined value.
    One of the four open meter items is now closed.
    Claude-Session: https://claude.ai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
2026-09-14 R1 is 9V — owner-confirmed, dispute closed
    Section 0 recorded 9.5V and rev 2.1 propagated it into section 2.2's rails table.
    Wrong. config.py:212's "VERIFIED 9.068V", section 2.1's P4 row, its diagram and
    section 16.4 were all correct throughout -- the as-built capture was the outlier, as
    it was for the pull-ups.
    Two of the four open meter items now closed on owner confirmation rather than
    measurement; INA260 identities and the battery divider remain.
    Claude-Session: https://claude.ai/code/session_01R588kWA23XdY2ASV8mXwqQ
2026-09-14 Software Design: correct the 9.5V I propagated into item 12
    My 2026-09-11 closure of item 12 said section 0 recorded the Witty Pi feed as 9.5V
    and that this item's ~9V was wrong. The reverse: R1 is 9V, owner-confirmed
    2026-09-14, and config.py:212 measured 9.068V. Item 12 was right and my closure
    introduced the error.
    Caught by the grep the new CLAUDE.md rule prescribes.
    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
2026-09-14 Battery divider is fed and reading — gate closed
    Owner-confirmed 2026-09-14: the divider has its 12V feed, the voltages are in spec,
    and the ADS1115 reports real pack voltage.
    Section 0's A0 = 0.0146V reading was valid when taken -- the feed had not yet been
    connected -- and the hardware has since been completed. The shutdown-on-boot risk
    that gate described no longer applies, and willy-rover.service is safe to enable on
    this account. Section 0, CLAUDE.md and the FRD section V row all updated; the
    original measurement is retained rather than deleted, since it is what the gate was
    built on.
    Two things remain, neither blocking:
    - BATTERY_DIVIDER_SCALE still wants a re-trim against a meter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
2026-09-14 Sweep all docs for the four resolutions of 2026-09-14
    Four open items were closed today on owner confirmation -- the 4.7k pull-ups are not
    fitted, R1 is 9V, the INA260 identities are settled, and the battery divider is fed
    and reading. This propagates those through every document rather than leaving the
    corrections where they happened to land, per the rule added in b231d38.
    - Section 2.1's P4 row read "9V or 9V -- DISPUTED" after the 9.5V sweep collapsed
    both sides of the dispute into the same value. Restored to plain 9V.
    - Open item 2 no longer claims the divider is unfed, and no longer carries the
    open-circuit theory that briefly replaced that claim. What remains of the item is
    only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
2026-09-14 Third consistency pass — clean up what the 2026-09-14 corrections broke
    Fifteen items, most of them introduced by my own corrections earlier the same day.
    The showstopper is closed and stays closed; this reconciles everything the closure
    touched.
    DIRECT CONTRADICTIONS:
    - Section 0 item 1 carried TWO incompatible 2026-09-14 notes: a fault diagnosis
    ("A0 should be ~2.9V but reads 0.0146V, do not re-trim until A0 is in band") and
    the CLOSED note that supersedes it. The fault theory was held for about an hour;
    removed, with a line saying so.
    - Section 0 said "the bus does not load the Pi's own 3V3 pin". Backwards. It does --
    R5 being 3.3V only means the ENCODERS are not on that pin.
    -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
2026-09-14 Software Design: control block, SSD size conflict, calibration coupling
    Seven items from review.
    CONTROL BLOCK: title still said "Revision 1.0" against a control table saying 1.1 --
    the same defect just fixed in the hardware doc; "Supersedes: Nothing. First revision."
    against a 1.1 revision; and the date said 2026-09-11 while carrying 09-13 and 09-14
    changes. Third document in a row with that post-dating pattern.
    SSD SIZE IS A REAL CROSS-DOCUMENT CONTRADICTION and is FLAGGED, not guessed. Section
    1 says 1TB; Master Hardware Design section 15.1 says SanDisk Extreme PRO 500GB. One is
    wrong, and it matters for log retention and map storage sizing. `lsblk -d -o
    NAME,SIZE,MODEL` settles it in a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
2026-09-14 SSD is 1TB — owner-confirmed, BOM was wrong
    Software Design section 1 said 1TB; the hardware BOM said SanDisk Extreme PRO 500GB.
    Owner confirms 1TB, so the BOM row was the wrong one. Both now agree.
    Matters because log retention and map storage would have been sized against half the
    real capacity.
    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
2026-09-14 Arm servo connector reconnected — owner-confirmed 2026-09-14
    Open since 2026-08-20, when voice arm_home and wave dispatched correctly in software
    and produced zero physical motion. Cause was unplugged servo connector(s) under the
    cover.
    Recorded as reconnected but NOT YET RETESTED -- nobody has issued a voice arm_home and
    watched it move, and that is the difference between "wired" and "works". One command.
    Unblocks three items that were all waiting on it: arm_jog.py calibration (per-joint
    limits still recorded "Not tested", and nothing else unblocks retrieval), the
    door-knock design in the come-to-me spec, and the arm reach envelope that the lidar
    mounting question depends on.
    Co-Author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
2026-09-14 Breakout HAT installed — Xikentec HDO040, 2026-09-14
    Owner-confirmed. Replaces the Seengreat PX00 removed on 2026-09-08, which left the Pi
    header with no breakout at all.
    Section 13's verification row is set to NOT YET rather than PASS: the HAT is fitted,
    the connections are not re-verified. It carries the specific re-check that matters --
    section 16.13 check 6, re-metering the three sonar ECHO divider junctions for
    3.2-3.4V WITH the HAT in place. Its per-pin LEDs are parallel load at exactly those
    nodes, so any reading taken before fitting does not hold.
    Also worth watching once powered: the same LEDs sit on SDA and SCL. Meter them at idle
    -- they should read ~3.3V. If they sit near 2V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
2026-09-14 Breakout is the GeeekPi Micro terminal block, not the Xikentec HDO040
    Corrected 2026-09-14. The HDO040 photographed on 2026-09-09 was a candidate, not the
    part fitted.
    This matters for the verification list. The HDO040 has per-pin status LEDs, which is
    why section 13 and CLAUDE.md carried warnings about parallel load at the sonar ECHO
    divider junctions and on SDA/SCL. GeeekPi's "Micro" terminal blocks are generally
    passive -- if this one has no LEDs it adds no load anywhere and those concerns
    disappear. Recorded as something to CONFIRM rather than assumed either way, since
    skipping the ECHO re-meter on a wrong assumption would be the expensive mistake.
    Also noted: the listing names Pi 4B/3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
2026-09-14 Record WHY the HDO040 was rejected: physically too large
    Owner, 2026-09-14. The Xikentec HDO040 photographed on 2026-09-09 was tried and does
    not fit the head assembly, which is why the GeeekPi Micro terminal block was chosen.
    Recorded as a standing constraint rather than a one-off: the space is tight enough
    that a full-size 40-pin HAT with terminal blocks will not fit. Anyone sizing a future
    replacement needs that, and it is not derivable from anything else in the document --
    section 5.3 previously implied any 40-pin breakout would do.
    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
2026-09-14 Breakout labels terminals with SPI names — GP9 is MISO, GP8 is CE0
    Owner-confirmed 2026-09-14. The GeeekPi Micro terminal block uses SPI silkscreen, so
    the SEN0628 UART lands on terminals marked MISO (GP9, physical pin 21 -- required,
    sensor TX) and CE0 (GP8, physical pin 24 -- optional, config only).
    Physical pin numbers recorded alongside the names, since those are unambiguous
    regardless of what any future board silkscreens.
    Re-label both terminals for the UART they carry. An SPI-named terminal running a UART
    invites someone to wire actual SPI to it, and SPI0 must stay disabled (section 12) or
    the kernel reclaims GP7-GP11 -- so that one mistake would break the sensor and the pin
    reserv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
2026-09-14 Section 13: the items blocking the build are closed; what remains is verification
    The 2026-09-11 correction to "Nothing in the hardware build is outstanding" cited
    three live construction items -- an unfed battery divider, a breakout on order, and
    an unresolved pull-up question. All three closed on 2026-09-14, along with the arm
    servo connector.
    So the original line was right in kind and three weeks early: what remains IS
    verification rather than construction. Replaced the correction with the actual
    outstanding list -- encoder signal path (under power, not by hand), motor mapping
    bench test, arm_jog.py now that the connector is repaired, the divider scale re-trim,
    breakout connections not y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
2026-09-14 Build identity.py — the store and matcher for FR-2100
    First code for any of the three approved specs. TDD: 16 tests written first, watched
    to fail on the missing module, then implemented. All green.
    Built this piece first because the design calls it out as the one part of person
    recognition that is fully unit-testable off the rover -- vectors in, names out, no
    camera, no models, no frames. That mattered: Willie has been powered down for days and
    the laptop cannot import brain.py at all, so a local venv with numpy and pytest was
    enough to develop and verify this module properly rather than writing it blind.
    TWO PROPERTIES CARRY THE SAFETY WORK, and both have tests whose names say why:
    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
    [config.py, identity.py, test_identity_store.py]
2026-09-14 Battery plausibility floor — a broken sensor is not a flat pack
    Closes Software Design section 12 item 13, the sharpest remaining software risk and
    the only open item that could switch Willie off on its own.
    sensors.py already protected against a FAILED read: the 2026-08-24 change stopped
    zeroing _bat_raw on an exception, after a loose I2C wire made "the bus hiccupped"
    indistinguishable from "the pack is flat" and Willie powered himself off. It did not
    protect against a read that SUCCEEDS and returns something impossible -- and that is
    not hypothetical. With the divider unfed, A0 read 0.0146V, scaling to a pack voltage
    near 0.06V. That read succeeds, passes every existing guard, walks bra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
    [config.py, sensors.py, test_battery_plausibility.py]
2026-09-14 Build the ToF subsystem — classification, floor profile, fusion
    Everything for the SEN0628 except the UART frame parser. TDD, 24 tests written first
    and watched fail. 47 green locally across all four new test files.
    THE FLOOR IS SUBTRACTED, NOT MASKED, and that is the whole design. Masking the bottom
    rows is the obvious fix and the wrong one: mounted around 20cm the floor first appears
    roughly 34cm out, inside DIST_SLOW, so the rows a mask would discard are exactly where
    a shoe or a trailing cable at close range shows up. Every zone instead carries its own
    expected floor distance, captured on clear floor, and counts as an obstacle only when
    it returns meaningfully SHORTER than that.
    The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
    [calibrate_tof_floor.py, config.py, sensors.py, test_sonar_tof_fusion.py, test_tof.py, tof.py]
2026-09-14 P0: regression tests for the Hailo statefulness degradation
    The 2026-08-23 bug: generate_all() accumulates conversation context across calls, so
    the FIRST intent classification on a fresh model worked and later ones progressively
    degraded, ending in "Conversation context is full" and every subsequent call failing
    to parse. That is invisible to a single-call test, which is why it survived to be
    found live. Nothing covered it until now.
    13 tests, all against ONE long-lived instance -- which is how the rover actually uses
    it, since brain.py constructs the provider once at startup and keeps it for the life
    of the process:
    - 20 consecutive calls all parse (the symptom)
    - context never accumulat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
    [test_hailo_statelessness.py]
2026-09-14 P2: diagnostics.py expected eleven-device bus as ten — Witty Pi was missing
    Two places decide what should be on the I2C bus: brain.py::_EXPECTED_I2C, which gates
    motion at startup, and diagnostics.py::_EXPECTED_I2C, the read-only FR-1100-004
    report. They disagreed.
    brain.py:71 adds 0x51 conditionally on ENABLE_WITTY_PI, True since the HAT was fitted.
    diagnostics.py never learned about it and expected ten. So `python3 diagnostics.py`
    would report a clean bus on a rover whose Witty Pi had fallen off it -- and that is
    the bad failure direction: a health report that cannot see an absent device.
    This is the same ten-versus-eleven drift removed from three documents the day before,
    and in code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
    [diagnostics.py, test_expected_i2c_agreement.py]
2026-09-14 Stop test_navigation and test_mapping failing on load, not on defects
    Both spawned a real interpreter with timeout=30. That interpreter imports the whole
    stack under WILLY_SIMULATE and takes ~20s alone on this Pi, leaving about ten seconds
    of headroom -- so both failed whenever anything else was running. In practice they
    tipped over on roughly half of full-suite runs, and on every run sharing the machine
    with the Hailo reliability batch.
    A test that fails for load rather than for a defect is worse than no test: it trains
    the reader to ignore red, which is how a real failure gets waved past. That is not
    hypothetical here -- I have written "that one is the known flake" three times in the
    last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
    [test_mapping.py, test_navigation.py]
2026-09-14 Fix Hailo intent parsing: apply ChatML framing (0% -> 53% on the 32-case batch)
    The Hailo LLM has scored 0% on experiments/llm_reliability_batch.py since
    2026-08-23 and FRD G-6 has recorded it as a model-quality problem ever since.
    It was not. It was a prompt-framing bug on our side.
    The model is Qwen2: llm.prompt_template is a ChatML Jinja template and its stop
    tokens are ['<|im_end|>', '<|endoftext|>']. generate_all() does NOT apply that
    template -- it takes one raw string and continues it. hailo_llm.py handed it a
    bare instruction string with no role markers, so it did what a completion model
    should do with a template: it continued the template. Captured live, the output
    was the prompt's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
    [config.py, hailo_llm.py, test_hailo_chatml.py, test_hailo_generation_params.py, test_hailo_statelessness.py, voice.py]
2026-09-14 Hailo intent parsing: normalisation + prompt rewrite, and correct the record
    Follow-on to 3928ec7, which fixed the ChatML framing. Two further changes, plus
    a correction to a measurement I reported wrongly in that commit.
    MEASUREMENT CORRECTION. 3928ec7's message quotes "parsed 28/31, intent-correct
    23/31". Those numbers came from a throwaway scoring script whose regex required
    one space after OK, while the batch prints "OK " with two. It was matching only
    the FAIL lines, so every figure in that table was computed over failures alone.
    The direction of the result was right; the numbers were not. Rescored properly,
    over all 32 cases each time.
    Two metrics are now reported, because they diff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
    [ai_provider.py, config.py, test_ai_provider_normalisation.py, voice.py]
2026-09-14 Qualify the Hailo intent path: 96-call artifact, stability proof, gate semantics
    Addresses the 2026-09-14 review P0-1/P0-2/P0-3 and P1-2/P1-3. The review's first point was
    fair and worse than it stated: the batch numbers quoted in FRD G-6 lived in /tmp on the
    rover, which a power cycle wipes. Nothing in git let anyone check them. Every figure below
    now has a committed per-case record behind it.
    P0-1 ACCURACY. experiments/hailo_qualification.py, 96 calls at the shipped settings
    (temperature 0.1, top_p 0.9, max_tokens 256):
    actionable (correct intent, usable args, has a reply) 77 80.2%
    wrong intent 10 10.4%
    parse failure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
    [config.py, test_confidence_gate_semantics.py, test_malformed_model_output.py, test_stuck_ai_fallback_chain.py]
2026-09-14 Fix the STUCK motion prompt: 33% unsafe-execute rate -> 0%, and make it one prompt not two
    The placeholder sweep that was missed on 2026-09-14. The STUCK prompt still asked for
    {"action":"forward"|...,"duration":<float>,"speed":<0.0-1.0>,"reason":"<60 chars>"} --
    the same angle-bracket syntax whose literal echoing was the entire cause of the intent
    path's 0%. The ChatML fix was applied to the intent prompt and never swept into this one,
    which is the only AI path that can drive the wheels.
    MEASURED FIRST, because the last three attempts to tune this family of prompts each fixed
    one model by breaking the other, and the motion path had never been benchmarked at all.
    experiments/motion_reliabil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
    [ai_provider.py, brain.py, test_stuck_prompt.py]
2026-09-14 Classify every Hailo intent failure: the confidence signal is empty
    Answers the 2026-09-14 review's P0 question -- why does Hailo produce confident wrong
    answers -- and does it without touching temperature or top_p, which the review explicitly
    asked not to spend a pass on.
    ANSWER: the self-reported confidence is a stylistic artifact of a fluent completion, not an
    estimate. Over 96 calls (3 repeats x 32 cases, raw output captured):
    self-reported confidence correct (n=76) wrong (n=11)
    0.8 28 7
    0.9 32 2
    1.0 13 2
    The distributions are identical,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
    [test_reflex_deliberative_separation.py]
2026-09-14 Deterministic emergency stop; lock in the Hailo fixes; record the reasoner decision
    Works the 2026-09-14 review's list in the order given. No prompt or sampling tuning: the
    evidence says the remaining problem is model capability, not prompt format.
    1. LOCK IN THE HAILO FIXES. Three of the four already had regression cover (ChatML,
    clear_context, generation parameters). Device sharing had none -- it was described in a
    comment in hailo_llm.py and asserted nowhere, which made it the easiest of the four to lose.
    tests/test_hailo_device_sharing.py (6) pins that an existing Hailo.TARGET is REUSED rather
    than replaced (a second VDevice collides with vision's -- HAILO_OUT_OF_PHYSICAL_DEVICES(74)),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
    [test_emergency_stop_phrases.py, test_hailo_device_sharing.py, voice.py]
2026-09-14 Docs: fold the day's work into all three design docs, CLAUDE.md and the FRD gaps
    Documentation pass over everything landed today. Applies the repo's own rule -- grep the OLD
    value repo-wide before calling a change done -- rather than only editing the file each change
    happened to touch.
    SOFTWARE DESIGN
    10.1 replaced. It listed 6 test files and the suite is now 398 tests across far more than
    that. Regrouped by what the tests PROTECT rather than by date, since they all share one:
    the Hailo investigation and its fixes, the safety boundary (what may reach the motors), and
    infrastructure. Keeps the note that several exist because a single-call test cannot see the
    bug -- the context degr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
2026-09-15 Docs: the SEN0628 does not stream, and two more connectors dropped devices
    Records 2026-09-15. Everything here was measured or read out of vendor source; nothing is
    inferred from a datasheet summary, because doing exactly that is what cost the day.
    THE SEN0628 IS REQUEST/RESPONSE, NOT STREAMING. CLAUDE.md said "only RX is strictly needed;
    the sensor transmits and the Pi listens." That is struck. It was written assuming the sensor
    free-runs, and the assumption was never tested. Proven wrong two ways: the vendor library
    polls (getAllData() writes a frame then blocks in recvPacket()), and 30 seconds of passive
    listening on a powered, correctly-wired sensor returns zero bytes. The consequence i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
    [tof_probe.py]
2026-09-15 INA260 identities corrected: the motor-cut detector was watching the arm rail
    Owner-stated 2026-09-15: 0x45 is on the +12V bus and 0x44 is on the R3 6V arm rail; R1's 9V
    has no INA260 at all, the Witty Pi HAT monitors its own VIN. Live register reads agree, with
    the pack metered at 11.36V:
    0x40 -> 4.986V (R2, 5V) 0x44 -> 6.043V (R3, 6V arm)
    0x45 -> 11.174V (+12V bus) R1 9V -> Witty Pi HAT, no INA260
    THIS WAS NOT A DOCUMENTATION ERROR. config.py's August figures were correct when taken --
    0x44 read 11.373V and 0x45 read 9.068V on 2026-08-24. The monitors were then physically
    relocated and nothing followed them. Software Design section 8 and FRD G-1 had each
    RECOMMEN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
    [brain.py, config.py, diagnostics.py, main.py, power_logger.py, sensors.py, servo_current_test.py, test_expected_i2c_agreement.py]
2026-09-15 Docs: vision never mentioned the ToF, and §3.1 still described removed hardware
    Two owner-reported gaps, both the same species: text that was correct when written and was
    left standing after the thing it described changed.
    VISION NEVER MENTIONED THE ToF. The sharpest instance was in code. vision.py's header asserted
    "there is no depth sensor" -- flatly false since the SEN0628 was specified (8x8 zones,
    20-3500mm) and tof.py plus the sensors.py fusion were built. Corrected, and replaced with the
    division of labour, because the two modules are easy to conflate:
    vision.py WHAT a thing is and roughly where. Deliberative. Feeds world_model.py.
    Per Master Hardware Design 12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
    [vision.py]
2026-09-15 Sweep: finish the INA260 and ToF corrections everywhere, not just where they were noticed
    The owner asked for everything to be brought into line after finding three stale claims I had
    missed. This is the wide grep that should have followed the 2026-09-15 INA260 rename, run
    across every file rather than the ones I happened to be editing.
    THE ONE THAT MATTERED. scripts/wheel_current_test.py hardcoded _RAIL=0x44 with the comment
    "motor 12V bus. NOT 0x45 (Pi 9V feed)". Both halves are now false: 0x44 is the 6V ARM rail and
    0x45 is the +12V bus. That script measures per-wheel current for M-1/E-1 -- tomorrow's bench
    work. Left alone it would have reported ARM-rail current as per-wheel motor draw: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
    [config.py, test_expected_i2c_agreement.py, tof.py, wheel_current_test.py]
2026-09-15 Battery sense: a second opinion, after the divider went open unnoticed for hours
    THE FAULT. The ADS1115 battery divider is unfed again. A0 reads 0.025V, stable, where an
    11.36V pack should put ~2.7V on it; battery_volts reports 0.09V and is correctly rejected by
    accept_battery_raw()'s 5.0V floor. Meanwhile INA260 0x45 read 10.97V on the +12V bus. Those
    two numbers coexisted for hours and nothing in the system compared them -- it was caught
    because a human read a diagnostics run.
    THE DIAGNOSIS CAME FROM A CONTROL THE BOARD PROVIDES FOR FREE. config.py:249 records that the
    charge-sense divider is not wired, so A2/A3 are unconnected -- and they read 0.906V and 0.905V.
    That is what a floating i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
    [brain.py, config.py, test_battery_crosscheck.py, test_brain_reset_gate.py]
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2026-09-17 Arm channel map was wrong in four places; measured it on hardware
    The 2026-09-06 remap reversed the joint order on paper and the plugs were never
    moved. Measured one channel at a time with the owner watching: wrist pitch CH0,
    elbow CH1, shoulder CH2, second shoulder axis CH3, wrist rotate CH4, gripper CH5,
    base yaw CH6. CH0-CH3 were exactly reversed; CH4-CH6 were already right. Every
    spare channel on both PCA9685s was probed and is empty, so nothing was hiding.
    The mirrored shoulder pair does not exist. J1b = 2x1500us - J1a is retracted:
    mirrored and same-direction commands on CH2/CH3 drew statistically identical
    settled current, where a real shared axis driven wrongly would fight hard. The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
    [arm.py, config.py, diagnostics.py, retrieval_task.py, test_diagnostics_verdict.py, test_retrieval_task.py]
2026-09-17 FR-300-003 closed: operator reset is a voice command or a screen tap
    Owner decision 2026-09-17. Three changes, plus one correction to the record.
    The record first: safety.py claimed FR-300-003 was not implemented and that "every
    fault state this class enters is recovered from automatically once the triggering
    condition clears". That stopped being true on 2026-08-18, when brain.py gained
    _await_reset_or_resume(), and the comment was never updated. An external reviewer
    read it in September and reported the requirement as open. Corrected, with the
    authority named: brain.py owns fault state, safety.py deliberately holds no latch.
    1. Voice reset. A latched fault returns early from _tick() befor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
    [brain.py, safety.py, test_selftest_override_classification.py, test_voice_reset.py, voice.py]
2026-09-17 Bind _voice_reset_requested in the reset-gate test's brain namespace
    The gate now accepts a voice reset as well as a screen tap, so
    _await_reset_or_resume() calls a method this hand-built namespace did not bind.
    The namespace deliberately still has no .voice attribute -- that is what proves
    the screen-tap path works with no voice subsystem present.
    [test_brain_reset_gate.py]
2026-09-17 Sonar array closed: all three channels range-tested and working
    First time since the build. Front 49.7cm, left 91.1cm, right 30.9cm, each stable
    to +-0.4cm over 8 samples and each reading its own direction -- three distinct
    distances, so no cross-talk. All three ECHO lines idle LOW and go low against an
    internal pull-down, the healthy signature on every channel. R2 at 4.990V @ 0.026A,
    against 0.101A with one sensor fitted and the 0.348A that flagged a short earlier
    the same day: nothing is drawing fault current.
    Getting here took a reversed crimp pin that had never clicked home, a ground fault
    on the GeeekPi breakout, and two sensors destroyed by reverse polarity.
    Also corrects a stale cla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
2026-09-18 M-1: motor mapping measured -- the board addresses were swapped
    Rover on boxes, wheels clear, service stopped. Each port driven alone by raw
    address and port number, never by wheel name, since config.MOTOR_PORT was the
    thing under test. Owner named the wheel that actually turned.
    0x61 M1 -> LEFT REAR 0x60 M1 -> RIGHT REAR
    0x61 M2 -> LEFT CENTER 0x60 M2 -> RIGHT CENTER
    0x61 M3 -> LEFT FRONT 0x60 M3 -> RIGHT FRONT
    Two findings, and the unexpected one mattered more.
    The port order M1=REAR, M2=MIDDLE, M3=FRONT was right. That is what commit 484fbdc
    asserted on 2026-09-04 from "physical layout symmetry" -- an argument, not a
    measurement, and flagged as untrustworthy in config.py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
    [config.py, motors.py]
2026-09-18 E-1: encoder map measured -- left/right transposed here too, Phase B dead
    Same swap as the motor boards, found the same day. The encoders were landed at the
    same time as the motors, so the left/right confusion propagated into both columns.
    Master Hardware Design 7.2 predicted exactly this, saying the encoder assignment
    "may follow the physical wheels, or the port permutation, or neither".
    lf -> A4/A5 lm -> A6/A7 lr -> B2/B3
    rf -> A0/A1 rm -> A2/A3 rr -> B0/B1
    THE METHOD MATTERS MORE THAN THE RESULT. Do not poll these pins for edges: at 0.6
    duty the edge rate is ~7.7kHz against a ~1.2kHz I2C ceiling, and the aliasing reads
    as a CONSTANT. Three separate attempts -- encoder_map_ch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
    [config.py]
2026-09-20 Master Hardware Design rev 2.2: signal board, scrub removed hardware, Pico design
    Three changes, plus two staged perf scripts.
    1. Removed hardware is deleted, not struck. The ISO1540 isolator, TPSM84205,
    AMS1117-3.3 and the VCC2/GND2 two-domain scheme are scrubbed from the three
    design docs, the bench procedures and the code comments. That treatment had
    grown to ~400 lines describing parts that are not in the rover, which is the
    opposite of the master doc's stated scope. History is retained in
    docs/archive/ and Master Engineering Package rev 6.2.0.
    Standing rules survive without the parts: the encoder-rail sag that killed
    all six Hall sensors stays in 2.2, the cross-do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
    [config.py, i2c_bus_check.py, sensors.py, thermal_soak.py, tof.py, vision.py]
2026-09-20 Docs: device I/O index, remove all strikethrough, P8 rail, Pi 5 overlay fix
    Four changes across the three design documents.
    1. Section 2.1 gains a voltage column, and the 3.3V DROK path that was never in
    it. P8 (+12V bus -> DROK-4 -> R5) was missing from the distribution tree
    entirely: the rail has been documented since 2026-08-28 and the converter
    live since 2026-09-11, but the path feeding it was never written down. Two
    things about it are still unknown and are now open item 16 -- whether it is
    fused at all (it is the only +12V branch without a numbered fuse) and its
    wire gauge. Nothing monitors R5 either; the 2026-08-25 encoder deaths
    happened on an unmonitored 3.3V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
2026-09-20 Docs: state what is true, drop the correction narrative; fix arm channel map
    The three design documents recorded not just what the rover is, but every wrong
    thing they used to say about it and when that was fixed. That narration is gone.
    Removed across all three: dated "corrected on / this row previously said / that
    was wrong / three weeks apart" annotations, superseded-but-retained blocks, and
    "original text follows" notes. Where a wrong claim had a live correction beside
    it, only the correction remains. Closed open items are deleted rather than
    annotated. Sections 12 and 14 and Software Design section 12 were trimmed and
    renumbered, cross-references updated across documents.
    Where a past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
2026-09-20 Docs: current state only -- drop changelogs and removed-hardware lists
    The design documents now describe what the rover is. They no longer describe
    what it was, what was taken out, or how the documents themselves changed.
    Removed from Master Hardware Design:
    - the whole "Changes in revision" block (2.2 and 2.0 entries)
    - the Supersedes lineage row in Document Control
    - section 0's "What was removed" table
    - section 15.8 "Removed from the design" in full; section 15 is now 15.1-15.7
    - remaining "out of the rover / used to live here / removed 2026-xx-xx"
    phrasing in sections 0, 4, 5.3, 14, 16 and 16.1
    Removed from Functional Requirements:
    - the v3.2 / v3.0 / v3.1 revision-his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
2026-09-23 Docs: add section 1.1 control level board layout; fix motor side transposition
    New section 1.1 records the dimensioned control-level layout, with the drawing
    committed at docs/drawings/WildWilly_Control_Level_Layout.svg. Plan view, mm,
    origin lower-left.
    Deck: 200 x 140 x 4.4 mm, 2.4 mm floor rising to a 3 mm lip, R5 corners, a
    15 x 60 mm harness notch, four M3 chassis mounts on a 94.0 x 124.0 pattern with
    Oe9 keep-out, M2.5 standoffs into a 2.9 x 7.8 mm lattice. 61% fill, two stacks
    of headroom left.
    Twelve board positions with footprint, height and hole pattern each. Section 1's
    one-line "body tray" description is replaced: the body is two decks, and the
    power level below carries the fou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
2026-09-23 Drawings: re-place the control level for noise separation; generate the SVG
    The control level layout is re-placed against the design rules in section 1.1,
    and the drawing is now generated from data rather than hand-drawn.
    docs/drawings/gen_control_level_layout.py holds the placement and validates it
    against the deck outline, the harness notch and the four M3 keep-outs before it
    writes the SVG. A bad edit fails loudly instead of producing a drawing that
    looks fine and cannot be built.
    Four zones, arranged so the two things that must not meet -- millivolt analog
    and switched motor current -- sit at opposite ends of the deck:
    QUIET top-left signal board, ADS1115, Pico B
    LOGIC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
    [gen_control_level_layout.py]
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2026-09-24 Docs: Pico 2 W pin-level design, both links on the GPIO header; 170 RPM motor swap
    Master Hardware Design 2.2 -> 2.3, FRD 3.2 -> 3.3, Software Design 1.1 -> 1.2.
    Section 4.7 rewritten from a sketch into a buildable pinout. Both Picos now sit
    on the 40-pin header rather than one on the Pi 5 service port: freeing the six
    sonar lines leaves two spare UARTs, the service port stays available as the
    console for when the Pi will not boot, and the breakout drops from 13 lines to
    11 on a board chosen because the head assembly rejected a full-size HAT.
    Pico B sonar + BNO085 RST uart2-pi5, Pi GP4/GP5
    Pico A six encoders uart4-pi5, Pi GP12/GP13
    Encoder pairs land on Pico A GP0-GP11 in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
2026-09-24 Docs: the display is on the Pi header 5V, not R2; move Pico B's feed to the breakout
    Owner-stated 2026-09-24. Every rails table in the Master Hardware Design listed
    "Pi screen" against R2 (DROK-5V) - section 0, section 2.2, BOM 15.6, the INA260
    0x40 row in 16.3, and the INA260 side table. All corrected. FRD's INA260
    roll-call corrected with it. Section 5.4 and 16.15 were already right: the
    display takes a 3-pin power tap off the 40-pin header.
    Three consequences recorded in section 0:
    1. R2's consumers are steering servos and sonar VCC, nothing else. That makes
    16.12's short-detection arithmetic fully attributable - healthy R2 with one
    sonar ~0.10A, +15mA per further healthy sensor,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
2026-09-24 Docs: 4.7 Pico B pins - UART to GP12/GP13, RST to GP15, sonar to GP0-GP5
    Forced by the decision to build one carrier layout twice. Two assignments in the
    4.7 sketch could not survive a shared board, and both were found by auditing the
    schematic against the pin map rather than by building it:
    1. J2 could not exist. Pico A's UART sat on GP12/GP13 (pins 16/17) and Pico B's
    on GP0/GP1 (pins 1/2). One layout means one net per connector way, so a single
    J2 footprint cannot land on both pairs. Both Picos now run UART0 on GP12/GP13.
    Pico A's link pins and the Pi's link pins for A are now the same numbers.
    2. J3 way 11 would have sat on Pico B's reset net. Way 11 lands on Pico pin 14,
    w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
2026-09-24 Pico A firmware: PIO encoder counter, verified on hardware; two silent PIO bugs
    Board A is UID 643f69a756a232ea, MicroPython v1.29.0 (2026-08-24), RPI_PICO2_W.
    Recorded in 4.7 and firmware/README.md. Nothing is wired: what is proven is the
    counter itself and that every code path in pico_a.py runs. The link to the Pi,
    the LED, the R5 divider and the frame rate under real edge load are not.
    Six state machines watching one PIO-generated 46.9 Hz square wave all read
    exactly 47 over one second. Getting there found two bugs, both of which failed
    SILENTLY, which is why they are written down rather than just fixed:
    1. `jmp(x_dec, "cont")` with `label("cont")` immediately before `wrap()` targets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
    [pico_a.py, pico_b.py]
2026-09-24 Pico B identified and exercised; record the no-echo cost and the ECHO pull decision
    Board B is UID ad25bbf0f1e1f160, MicroPython v1.29.0 (2026-08-24), RPI_PICO2_W.
    Both boards now recorded in 4.7 against their roles - they are identical, and
    after wiring the only thing telling them apart is what they are plugged into,
    which is how the two left/right transpositions of 2026-09-18 happened.
    Verified on B with nothing wired: the open-drain reset behaves against an
    emulated pull-up (idle 1 -> asserted 0 -> released 1), three disconnected sonars
    report -1 and never a distance, UART0 opens on GP12/GP13, GP14 toggles.
    Two findings recorded rather than silently fixed:
    1. A no-echo costs the FULL t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
2026-09-24 Docs: archive nine superseded documents; rescue one live item before filing them
    docs/ goes from 15 markdown files to 6. Everything moved is historical; the live
    set is the three design documents plus the Bench Test Procedures, the User Guide,
    and the Fix Implementation Plan. docs/archive/README.md records what moved and why,
    and 17.1 now lists the whole live set instead of three of it.
    Archived:
    2026-08-21-power-fault-and-voice-latency.md self-labelled historical since
    2026-09-15; stale INA260 names
    CLAUDE_CODE_HANDOFF.md one-off handoff, 2026-08-15, same
    WildWilly_MCP3008_AllZero_Checklist.md that chip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
2026-09-26 Pico carriers: Pico orientation was inverted; shift right, drop the external LED
    Three owner corrections in one pass. The first invalidated the built carrier
    boards, so this is the record of why they are being rebuilt.
    1. THE PICO WAS DRAWN THE WRONG WAY ROUND. Its pins point down and the board is
    seen from above, so with the USB at the left it is pins 21-40 along the TOP
    row and 1-20 along the BOTTOM - the top-left pin is pin 40, VBUS. The
    drawings had it inverted, which put every signal on the power side and every
    power connection on the signal side. No rotation rescues it: a 180 degree turn
    maps the top row to 21-column, not column. The two carriers already built to
    the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
    [pico_a.py, pico_b.py]
2026-09-26 Motors: real 170 RPM specs land; counts/rev is 1540, and the edge-rate claim was wrong
    Owner supplied the specifications for the 12V 170 RPM variant on 2026-09-26:
    1:35 (vendor also quotes 1:35.5), 170 RPM no-load, 130 RPM rated, 0.82 kg.cm
    rated torque, 2.8 kg.cm stall, 60 mA no-load, 1.3 A stall.
    ENCODER_COUNTS_PER_REV = 11 x 4 x 35 = 1540, or 1562 at 35.5. Neither figure in
    this repo was close: 752 is 2.0x low, 3292 is 2.1x high. The 1.4% ambiguity
    between 35 and 35.5 is all that is left to settle, and a calibration run does it.
    Staged in config.py as ENCODER_COUNTS_PER_REV_170RPM and deliberately NOT made
    live: 752 is correct for the motors currently in the rover and odometry.py
    divides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
    [config.py, pico_a.py]
2026-09-27 Docs: make the archived subsystem status one coherent August snapshot
    It described two architectures at once and contradicted itself. The document is a
    2026-08-08 snapshot, last genuinely updated 2026-08-18, but someone edited the
    sensors.py row on 2026-09-17 without moving the snapshot date. The result: that
    row declared the BNO085 crash-loop "STALE", while the standing note at the foot of
    the same document still presented it as open and undiagnosed. The same edit also
    broke the row into four cells in a three-column table.
    The September text is lifted out of the table into a clearly headed "Added after
    this snapshot" block, so the table is one coherent August state again. No August
    content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
2026-09-27 Docs: FRD motor-board mapping was backwards; config.py MOTOR_PORT note nine days stale
    Two genuinely stale references, both the same kind: a fact corrected in one place
    on 2026-09-18 and left wrong in another.
    1. FRD FR-400 acceptance criteria opened with "Wheel and driver assignment is
    fixed by the as-built wiring: 0x60 drives the left side (LF, LM, LR) and 0x61
    the right (RF, RM, RR)." Backwards, and stated as settled as-built fact. M-1
    measured it the other way on 2026-09-18 by driving each port alone by raw
    address with the owner naming the wheel that turned: 0x61 is LEFT, 0x60 is
    RIGHT. config.py MOTOR_PORT and motors.py were fixed that day; the FRD was
    missed, so it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
    [config.py]
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2026-09-27 Docs: 4.7's "one 4-wire harness" for Pico B is six wires, and says so now
    The sentence predates two things: the reset pull-up needing Pi 3V3, and the
    UART's signal ground being given its own landing at pin 18 rather than sharing
    the power return. Replaced with the actual table.
    1 5V header 5V at the breakout -> upper + rail -> F1
    2 GND Pi GND -> upper - rail
    3 3V3 header pin 1 -> lower + rail -> R4
    4 UART TX GP5, phys 29 -> GP12, pin 16
    5 UART RX GP4, phys 7 -> GP13, pin 17
    6 signal GND Pi GND -> pin 18
    All six are already lines on the Ge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
2026-09-27 Back up the board drawings into the repo -- they only existed in a temp dir
    The two carrier boards were soldered on 2026-09-27 from a sheet whose only copy was
    a session scratchpad file and a claude.ai artifact. Neither survives a wiped temp
    directory, so the source of the boards now in the rover was not in the repo at all.
    docs/drawings/ gains, following the gen_*.py + Name.svg convention already there:
    gen_pico_carrier_boards.py both figures from ONE mapping, so A and B
    cannot drift; pin assertions fail loudly
    WildWilly_Pico_Carrier_Board_A.svg generated
    WildWilly_Pico_Carrier_Board_B.svg generated
    WildWilly_Pico_Carrier_Boards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
    [gen_pico_carrier_boards.py]
2026-09-28 Fold the whole Pico carrier design into the Master Hardware Design as 4.8
    The boards in the rover were built from a sheet whose content was nowhere in the
    three design documents. 4.7 said what the Picos do and where they connect; how the
    boards are actually built -- BOM, the feed, the column-by-column layout, connector
    nets, spare pins, build order, meter checks -- existed only in an HTML artifact.
    That breaks the three-document rule, and it means the docs could not have rebuilt
    these boards.
    New 4.8, twelve subsections, with 4.7 pointing into it. Everything was taken from
    gen_pico_carrier_boards.py rather than from the sheet's prose, because the prose was
    wrong -- see below. check48.py re-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
2026-09-29 Bring both Picos up: main.py, LED status, and what the silence really was
    Neither board had main.py. Each carried its code as pico_a.py / pico_b.py,
    and a Pico only autoruns main.py, so both sat at a bare REPL driving nothing.
    On a UART that is indistinguishable from an absent board, an unpowered one, a
    reversed feed or a swapped pair -- and the Pi then received a corrupted copy of
    its own transmission, which read as damaged silicon. It was crosstalk across
    the J2 harness into an unterminated stub. Nothing was broken.
    Board B is now proven end to end: $S frames at 33.3 Hz on /dev/ttyAMA2, zero
    sequence gaps and zero bad checksums over six seconds, all three HC-SR04
    ranging, and the stuck-EC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
    [gen_pico_carrier_boards.py, pico_a.py, pico_b.py]
2026-09-30 Release idle motors and servos, and fix the encoder wheel map
    THE ENCODER MAP. pico_a.py's WHEELS tuple was rf, rm, lf, lm, rr, lr -- copied
    from config.ENCODER_PINS, which disagrees with the as-built landing recorded in
    Master Hardware Design 16.6 by a left/right swap at every position. The two have
    contradicted each other in the repo the whole time.
    16.6 is the one that is right. Bench proof, one wheel at a time on blocks:
    driving lf counted on GP0/GP1, rf on GP4/GP5, lm on GP2/GP3, rm on GP6/GP7,
    rr on GP10/GP11 -- the as-built table, five for five. The HARNESS was never
    wrong. Do not "fix" this by re-landing twelve wires.
    IDLE POWER, all figures measured on the rover 2026-09-30, none e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
    [arm.py, config.py, encoder_calibration.py, motors.py, pico_a.py, test_sim_hardware.py]
2026-09-30 Backplane: spec, drawings, BOMs and a netlist derived from 16.1
    DESIGN ONLY. Nothing here changes Willie in his current form -- he keeps
    running on the five hand-built boards and work continues on them.
    A backplane, not a redesign. Every purchased module stays exactly as it is and
    plugs in; the hand-built boards that only held passives are absorbed into
    copper. Owner-directed scope: the EPLZON signal and power boards, the
    distribution board, the MOSFET board, the GODIY hub and both Pico carriers.
    The FeatherWing stack sockets in for retention, bus and logic -- its motor VIN
    and six motor pairs stay on its own terminals, because the fix for a 1.5A path
    is fewer connector hops, not more.
    WHY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
    [BOM-fab.csv, BOM-owner.csv, nets.csv]
2026-09-30 Backplane: Pi box header, board-mounted connectors, mounting holes
    Owner decisions, 2026-09-30.
    THE PI: a 2x20 2.54mm SMD KEYED BOX HEADER with a 40-way IDC ribbon. Shrouded
    and polarised, so the ribbon cannot go on backwards -- which matters on a rover
    with four reverse-polarity events on record. It also decouples the board
    outline from wherever the Pi is mounted, removing one of the three blockers.
    Its EIGHT GROUND PINS are the real gain. Today the Pi's reference reaches the
    boards through pin 6/9 -- two wires. Eight in parallel give a far lower
    impedance tie at exactly the junction the star cares about. GNDS went from 9
    pins to 27 across this change.
    BOARD-MOUNTED CONNECTORS for the en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
    [BOM-fab.csv, nets.csv]
2026-09-30 Backplane drawings: carry the connector decisions and the honest gap
    The published sheet predated today's decisions, so it showed motor connectors
    that are not happening and an undecided Pi interface.
    Floorplan now shows what was decided: the Pi's 2x20 keyed box header and the
    six keyed encoder connectors highlighted, sonars and ToF board-mounted, the
    rail inputs marked "up to 10 A" -- which is the fact that rules out a single
    connector family -- and NO MOTOR CONNECTORS called out, because the pairs stay
    on the FeatherWing terminals and never touch this board.
    The "five open questions" section is replaced by what is decided and what is
    not, with the deciding input for the connector family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
2026-09-30 Backplane: through-hole footprints, and where the netlist stops being useful
    Owner-directed: THROUGH-HOLE passives, so the board stays hand-assemblable --
    which matters because the person fixing it is the person who built it.
    Footprints assigned for the parts whose form factor is actually decided: the
    Pi header, both Pico sockets, the THT axial resistors, DO-41 diodes, Q1 in
    TO-220, and the M3 mounting holes. Everything else stays TBD rather than
    guessed; a fab BOM with invented footprints is worse than one with blanks.
    ⚠ The Pi header was specified SMD. On an otherwise through-hole board a THT
    shrouded box header is far easier to hand-solder and is equally keyed. Both
    options are record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
2026-09-30 config: drop the stale RST-on-MCP23017 comment
    Left behind by a2e6852. It still described the BNO085 reset as MCP23017 port B
    bit 4 and cited ENCODER_ADDR, both of which are gone. The live note four lines
    down already says where RST actually is -- Pico B GP15, unreachable until the
    Pi-to-Pico wire is fixed.
    Found by an external review of main, which was reading the tree as it stood
    before the C-1 Phase 3 cutover landed.
    Claude-Session: https://claude.ai/code/session_01DK9xMgwo9arVQZDAuwTVc5
    [config.py]
2026-09-30 Clean the last stale MCP23017 comments
    Three described the present as though the expander still existed, which is the
    kind of thing that sends the next person to change the wrong hardware:
    sensors.py IMU: said RST 'is now wired up below via adafruit_mcp230xx's
    DigitalInOut pin, so hard_reset() does a real GPIO pulse'. It does not. That
    was true between 2026-08-14 and 2026-09-30; the line has not been reconnected
    and hard_reset() is back to the no-op it was before. The chip is healthy --
    it answers SHTP on 0x4A with an incrementing sequence.
    config.py encoder header: still called them 'MCP23017 @0x27, quadrature A/B'.
    They are Pico A over uart4-pi5, Phase A edges only -- magni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
    [config.py, sensors.py]
2026-09-30 firmware: say what actually ran, not what was true when it was written
    An external review read firmware/pico_b.py's header -- NOT YET RUN ON HARDWARE --
    and reasonably concluded Pico B was unproven. The line was stale by a day. Pico B
    ran on 2026-09-30: 200 $S frames in 6.0s at 33.3 Hz, zero sequence gaps, zero bad
    checksums, all three HC-SR04s ranging, and the stuck-ECHO flag firing correctly on
    two dead sensors and clearing on a good one.
    pico_a.py was worse: it still said NOTHING IS WIRED YET, so the UART link, the LED,
    the R5 divider and the frame rate under real edge load were all unproven. All four
    are now measured -- $E at exactly 50.0 Hz, 300 frames with zero gaps and zero bad
    check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
    [pico_a.py, pico_b.py]
2026-09-30 Pin the encoder wheel order, after the calibration script got it wrong
    An external review found it: scripts/encoder_calibration.py had
    _WHEELS=('rf','rm','lf','lm','rr','lr') while the firmware builds the $E frame as
    lf, lm, rf, rm, lr, rr. A calibration run would have measured one wheel correctly
    and written the answer against the wheel on the OTHER SIDE of the rover -- in the
    one script whose entire job is attributing counts to the right wheel.
    THE CHAIN MATTERS MORE THAN THE BUG. pico_a.py's tuple was corrected on 2026-09-29
    after proving the as-built landing on hardware, one wheel at a time on blocks.
    firmware/README.md's $E line was NOT corrected. The calibration script was written
    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
    [encoder_calibration.py, test_encoder_order.py]
2026-09-30 Test pico_link, and count the sequence gaps the protocol exists to expose
    pico_link carries every sonar and encoder reading and sits in the safety path --
    SonarArray decides whether forward motion is allowed from what it says arrived and
    when. It had no tests at all.
    21 tests, covering the ways a serial link fails that a naive reader turns into
    confident wrong data: a corrupted frame (dropped, not half-believed), a frame split
    across three reads (reassembled), a link gone quiet (must NOT keep serving its last
    reading), a mid-stream disconnect (reader survives, link reports stale), a 16-bit
    counter wrap (not a gap), a Pico reboot (counted separately), an unsigned 32-bit
    encoder rollover (not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
    [pico_link.py, test_pico_link.py]
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2026-10-01 Fusion tests: feed a fake Pico link instead of relying on sim mode
    They passed alone and failed in the full suite: SIMULATE_HARDWARE is fixed at
    config's first import, so the fixture's None link hit the real read path.
    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
    [test_sonar_tof_fusion.py]
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2026-10-01 BNO085: recover through Pico B's hardware RST, and catch a frozen driver
    RST proven on the rover: $R,ok then the chip reboots. Across a reset the live
    driver raised twice and then returned its cached quaternion forever, silently,
    so recovery is RST plus a rebuild, and an unchanged quaternion past
    IMU_STALE_S counts as a failed read. Rate-limited to one per 10 s.
    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
    [brain.py, config.py, sensors.py, test_imu_reset.py]
2026-10-01 Warn on a low encoder rail and name it in the stall stop
    R5 low is detection only (owner decision): status prefix, R5_LOW event, and a
    stall stop that says 'encoder rail R5 low' instead of blaming the wheels.
    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
    [brain.py, config.py, sensors.py, test_brain_r5.py]
2026-10-01 ENCODER_COUNTS_PER_REV = 382, measured under power
    lf driven at 0.35 to 3905 counts (3911 with coast); tape mark made 10.25 turns.
    x1 Phase A on the 35.5:1 motors, effective ~34.7:1. Ends the 3292 -> 752 ->
    422 -> 1562 chain of derived figures. Hand-turning is not a valid method here:
    back-driving the gearbox slips the hub. Docs swept.
    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
    [breakaway_sweep.py, config.py, encoder_calibration.py, odometry.py, pico_a.py, sensors.py]
2026-10-01 pico_a: fix the pin maps the 09-29 WHEELS correction left behind; Phase B is alive
    WHEELS was reordered to lf-first but PHASE_A/PHASE_B kept rf: 0, so flashing
    this file would have swapped every wheel left/right. The board still runs the
    older copy, which is correct end to end. Measured over USB: lf GP0/1 ... rr
    GP10/11, and Phase B toggles in step with A on all six new motors.
    test_encoder_order now pins slot i to GP 2i/2i+1.
    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
    [pico_a.py, test_encoder_order.py]
2026-10-01 Encoders: signed x2 quadrature on Pico A (a-0.3, installed); direction in odometry
    Phase B is alive on all six new motors. a-0.3 counts both edges of A with B
    sampled at each -- signed, 763 counts/rev (2 x the 381.6 x1 measurement).
    +throttle counts up on every wheel; ENCODER_SIGN makes rover-forward positive
    across the mirrored sides in odometry. Encoders unwraps 32-bit and re-bases on
    a Pico reboot instead of reading it as motion.
    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
    [config.py, encoder_calibration.py, odometry.py, pico_a.py, sensors.py, test_encoder_signed.py]
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2026-10-01 Fix three FRD-audit safety gaps: voice stop, motor thread death, sonar health
    - Voice 'stop' now leaves the motion state; before, the same tick's dispatch
    drove again (ROAM/SLOW/AVOID/DOCK/WAVE). Fault states untouched.
    - DriveBase writes are guarded: one I2C error no longer kills the ramp thread
    (after which stop() did nothing); is_healthy feeds _check_health. brake()
    brakes every wheel even if one write fails.
    - Sonar link and motors are in _check_health and the self-test.
    test_brain_voice_stop needs the rover stack; not yet run (willie offline).
    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
    [brain.py, motors.py, test_brain_voice_stop.py, test_drive_fault.py, test_sonar_health.py]
2026-10-01 Self-test retry: probe only missing I2C addresses, never re-scan the bus
    A full scan quick-writes every address; the BNO085 logs each as SHTP
    error 2 and its Error List packet crashes adafruit_bno08x (KeyError: 12).
    With the base off the retry ran every 30 s and knocked the IMU over each time.
    Claude-Session: https://claude.ai/code/session_01RZTgkw763fzGfCZcGxK7s8
    [brain.py, test_selftest_i2c_probe.py]
2026-10-01 Answer voice while the self-test is failing, and say what is wrong
    _tick() returned before both drain passes when the startup self-test
    failed, so every command was heard and none answered. Queries, diagnostics
    and shutdown now run; other intents are refused aloud with the reason.
    status/battery no longer read out a dead ADC as -0.0 volts.
    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
    [brain.py, test_brain_voice_drain.py, test_brain_voice_selftest_fault.py]
2026-10-01 Voice: log a once-a-minute wake-loop heartbeat
    Voice was silently deaf for weeks with the capture thread alive. The
    heartbeat logs frames scored/muted, best wake score, peak level and
    overflows, so the next failure shows which half is broken.
    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
    [voice.py]
2026-10-01 Remote commands from Home Assistant: status, battery, stop, come_here
    remote_cmd.py serves POST /command on :8765, token-authenticated, fixed
    intents only. Stop takes the immediate stop_requested path; the rest are
    queued like spoken commands, so all Directive gating applies. Replies from
    the drain passes go through brain._say(), which speaks them and hands the
    text back to the HA caller for TTS on the Nest.
    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
    [brain.py, config.py, remote_cmd.py, test_remote_cmd.py]
2026-10-01 Tests: bind brain._say in the voice-drain fixtures
    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
    [test_brain_manual_drive.py, test_brain_roam_permission.py, test_brain_voice_drain.py, test_brain_voice_expiry.py, test_brain_voice_selftest_fault.py]
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2026-10-02 Arm current limit, rail overcurrent, retention purge, non-blocking stuck email
    FR-700-001: arm rail held above ARM_CURRENT_LIMIT_A releases the arm (the
    limit was defined and never read). FR-200-002: bus/steering rails above 90%
    of their fuse for 1 s latch OVERCURRENT_FAULT until an operator reset.
    FR-2000-008: STUCK photo+SMTP run on their own thread. FR-1800-003: STUCK
    escalation announces the cloud send. FR-1800-004/FR-1900-010: daily
    retention purge from IDLE.
    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
    [brain.py, config.py, test_current_limits.py]
2026-10-02 Name dead sonars, expose IMU heading, report uncommanded wheel motion
    FR-800-004: SonarArray.failed_channels names a channel with Pico B's
    stuck-ECHO flag or a stale per-channel age; brain logs SONAR_FAULT and
    prefixes the status. FR-800-001: IMU.heading (yaw) from the quaternion.
    FR-500-003 inverse: wheels turning with no command logged once per episode.
    FR-1100-002: subsystem fault events carry value= and expected=.
    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
    [brain.py, config.py, sensors.py, test_sensor_gaps.py]
2026-10-02 Self-test names base-off; voice tone reaches Piper; bashful trigger
    FR-100-002: when only base-fed subsystems fail and the 12V bus reads ~0V,
    the self-test says 'base power appears OFF' instead of listing sensors.
    FR-1500-008/009, FR-1600-006: speak()'s tone now sets Piper's length scale
    (falls back to neutral if the flag is rejected); compliments and personal
    questions answer in the bashful tone and show the bashful face.
    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
    [brain.py, test_voice_tone.py, voice.py]
2026-10-02 Correct stale comments in arm.py, retrieval_task.py and brain.py
    arm.py claimed no named poses and a CH1-7 map; retrieval_task.py claimed no
    gripper force sensor; brain.py claimed the DOCK branch satisfies FR-200-005.
    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
    [arm.py, brain.py, retrieval_task.py]
2026-10-02 Docs: fold the 10-01/10-02 work into FRD, SWD and MHD; fix 11 contradictions
    Remote commands (partial FR-1300 reversal), battery halts with docking
    deferred, overcurrent/arm limits, sonar health, heading, tone, retrieve gate,
    self-test scan change. Corrects: identity.py exists, encoders signed x2 at
    763, divider 0.2432, 0x44 vs 0x45, BNO085 INT vs Pico B GP15, unused arm
    poses, STUCK email exception, test count 476, module table, Hailo LLM on,
    requirement count 128. FR-1400 Claude-vs-Gemini recorded as an open owner
    decision. Stale config.py comments corrected.
    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
    [config.py]
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2026-10-02 Per-class object widths for range; come-here looks around before failing
    FR-1700-008 / FR-1000-006: localize() ranged everything as 8 cm wide, which
    put a person at about a sixth of their true distance; now a nominal per-class
    width table (person 45 cm). Come-here sweeps PURSUIT_SEARCH_STEPS timed turns
    before giving up.
    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
    [config.py, pursuit_task.py, test_sensor_gaps.py, vision.py]
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2026-10-02 Stair standoff moves to the planning layer and fails closed; safer 'forget'
    Per SWD 6.6 the mapped standoff now only shapes ROAM/SLOW/AVOID decisions; the
    reflex front reading, approve_motion and the world-model obstacle feed see the
    sonar alone (no phantom obstacles). With stairs mapped and no fresh pose, or an
    error reading them, ROAM refuses. 'forget X' matches whole words and refuses
    pronouns ('forget it') and fragments under 3 letters.
    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
    [brain.py, test_rooms_stairs_memory.py, voice.py]
2026-10-02 Self-test never probes the BNO085, not even at startup
    The single startup scan still quick-wrote 0x4A; on the first boot of
    today's code the SHTP error list stalled the IMU long enough to latch
    SENSOR_FAULT, which would recur every boot. The IMU's presence is proven by
    its driver constructing and its health by the separate self-test check.
    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
    [brain.py, test_selftest_i2c_probe.py]
2026-10-02 Repeated brake on a stopped, released drive is a no-op (wheels twitched)
    Seen on the rover: in a latched fault emergency_stop() every tick woke the
    sleeping drivers and braked; the ramp loop released them again after
    MOTOR_COAST_AFTER_S. Waking and braking writes each motor's two direction pins
    in turn, briefly driving it, so every wheel twitched. Nothing moving means
    nothing to brake.
    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
    [motors.py, test_brake_no_twitch.py]
2026-10-02 Docs: second gap round folded in; Claude recorded as the cloud provider
    Rooms/stairs/memory/intent-gate/widths/sweep/odometry/routines from
    4f59034..0f99e26. SWD 6.6 and FRD FR-1200-005 now describe the reworked
    planning-only, fail-closed stair standoff (cb9a68d). FR-1400: owner decision
    2026-10-02, Claude (claude-sonnet-5-5), Gemini wording read as Claude.
    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
2026-10-02 Debounce sonar fault reporting (2 s to fail, 2 s to clear)
    First live run: one flapping channel logged 46 SONAR_FAULT events in two
    minutes. Report a channel only after SONAR_FAULT_DEBOUNCE_S of continuous
    failure, clear it after the same of continuous health.
    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
    [brain.py, config.py, test_sensor_gaps.py]
2026-10-02 Closed-loop wheel speed; speeds set in mph (0.5 slow, 1.0 cruise, 1.5 cap)
    FR-500-004: each wheel's duty = feed-forward from its measured duty->RPM line
    (breakaway sweep 2026-10-02) + a PI trim on its encoder, bounded to
    WHEEL_TRIM_MAX so a blocked wheel gets a limited push and stall detection
    still stops it. No healthy encoders -> feed-forward only. SPEED_* are now
    fractions of the 1.5 mph cap (FR-400-004). WHEEL_SPEED_CONTROL turns the
    trim off.
    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
    [brain.py, config.py, motors.py, test_wheel_speed_control.py]
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2026-10-02 IMU freshness on quaternion+acceleration, stale limit 3.0 s
    Perfectly still on the blocks the fused quaternion stayed bit-identical for
    up to 3.7 s (reports ~5 Hz, down from ~10 Hz on 10-01), so the 1.5 s
    quaternion-only check latched a false SENSOR_FAULT every ~15 s (53
    recoveries in 30 min). Raw accelerometer noise changes whenever a report
    arrives.
    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
    [config.py, sensors.py]
2026-10-02 Willie proposes feature requests; owner approves by email (FR-2200)
    feature_requests.py, to the approved 2026-09-11 design: scans his own event
    log for repeated problems (stalls, faults, tick overruns, unmatched voice,
    failed tasks; >= 5 in 7 days), composes one request a day with the cloud
    model (evidence wrapped as untrusted data, never composed on-device), emails
    it with a one-time code; 'Willie: approve <code>' over the DKIM-verified path
    writes docs/feature-requests/<date>-<slug>.md and commits that file alone
    (git add <path>; commit --only) and pushes. Unapproved requests expire in
    secrets/. Writes Markdown only.
    Claude-Session: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
    [brain.py, config.py, email_client.py, feature_requests.py, test_feature_requests.py]
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2026-10-02 Docs: third sweep (speed loop, email commands, FR-2200, demos, FR-2100, IMU, SSD boot, backups)
    Folds 8f9ec08..80c074f and the 2026-10-02 rover work into FRD/SWD/MHD:
    SSD boot and fallback, NAS backups, never-full-charged packs and the first
    live low-battery halt, IMU report rate drop. Corrects stale messages in
    motors.py (closed loop now built) and the IMU freshness wording.
    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
    [brain.py, motors.py, sensors.py]
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2026-10-02 Wave uses the hardware-verified pose (FR-700-002)
    brain._wave() only twitched wrist rotation +-300us from wherever the arm sat;
    the 2026-09-17 wave was done by hand and its values sat unused in config. Now:
    elbow open to 1000 first, shoulder to 750 in 50us steps, wrist pitch
    1380<->1620 x4, then shoulder back to rest before the elbow closes, wrist to
    the low-current 2300. Arm.was_driven() so the shoulder never steps from a
    placeholder pulse.
    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
    [arm.py, brain.py, config.py, test_brain_wave.py]
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2026-10-02 E-stop is the main power switch; there is no mushroom switch (owner)
    Removes the latching-mushroom E-stop and the 'software can't sense the
    E-stop' gap from safety.py, the FRD and the fix plan. The main power switch
    cuts all power including the Pi, so FR-300-001/002/003 are met by hardware
    and there is nothing to sense. (SWD/MHD are corrected in the as-built
    rewrite.)
    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
    [safety.py]
2026-10-02 Software and Hardware Design rewritten as-built only
    Owner instruction: describe the rover as built today; remove remarks about
    replaced or broken parts. History (MCP23017, old motors/divider/board,
    destroyed sensors, resolved faults, dated status blocks) removed -- git holds
    it. Live constraints kept as present-tense rules; open items collected per
    doc. SWD 1577->936 lines, MHD 3951->1920. Section numbers preserved.
    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
2026-10-02 Self-test settle sleep at startup only (Willie's first feature request)
    His approved request cited 288 TICK_OVERRUNs; they cluster at 501-506 ms, the
    0.5 s settle sleep in _self_test() re-run on the tick every 30 s while the
    self-test failed with the base off. Request marked done.
    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
    [brain.py]
2026-10-02 Voice capture via callback + queue: stop dropping ~20% of the audio
    The blocking stream.read() dropped ~55 blocks a minute whenever the wake loop
    ran late, so a distant wake word often arrived with pieces missing. The
    PortAudio callback now copies each block into a ~4 s queue (latency='high')
    and the loop reads from it.
    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
    [config.py, voice.py]
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2026-10-02 Arm outputs cleared before the driver wakes; battery voltage from the bus monitor
    Arm: releasing only SLEEPs the PCA9685, which keeps old pulse widths, and the
    driver's reset() wakes it -- so every start replayed the last pulse and the
    shoulder jumped. ALL_LED_OFF_H full-off is now written at register level
    before the driver is created, and release() zeroes outputs before sleeping.
    Battery: the A0 divider reads 7.19 V on an 11.98 V pack (0x45 bus: 11.90 V).
    ADC.battery_volts now uses the +12V bus INA260 plus BUS_TO_PACK_DROP_V when the
    bus is live, and the divider only when it is not.
    Claude-Session: https://claude.ai/code/session_01R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
    [arm.py, brain.py, config.py, sensors.py]
2026-10-05 Gripper feedback replaces the FSR; 15 Ah packs; per-corner steering centres
    Gripper: the FSR402 is removed. The gripper MG90S pot wiper now feeds
    ADS1115 A2 through a 47k/47k divider + 100 nF at the ADS end.
    config.ADS_CH_GRIP_FB / GRIP_FB_DIVIDER_SCALE, sensors.ADC.grip_feedback_volts(),
    scripts/fsr_grip_curve.py -> scripts/grip_feedback_curve.py. Measured
    2026-10-05 with the longer fingers: open 1150us = 73 mm, shut 2205us
    (0.39 A); 2210us and 1050us stall. A2 tracks ~0.8 mV/us but shifted
    between runs - must be read against the R3 rail (not done yet).
    Hand-off confirmation is still timed. All three design docs, CLAUDE.md
    and the drawings swept for the FSR.
    Power: 2 x 3S 15000 mAh in para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
    [config.py, gen_control_level_layout.py, grip_feedback_curve.py, motors.py, retrieval_task.py, sensors.py, steer_jog.py]
2026-10-06 Come to me, avoidance turns from ToF + camera, stow opens the elbow first, steering map
    FR-1000-006: come_to_me_task.py sequences Navigator (room mission) then
    PursuitTask(come_here) under one COME_TO_ME state. Rooms route through each
    labelled doorway, not centroid to centroid. A blocked labelled doorway asks
    to be let in (DOOR_WAIT_S, DOOR_MAX_ASKS) and resumes when it clears; the
    knock is not built. Voice fast path: "I'm in the kitchen, come to me".
    FR-1000-002 (owner: avoidance needs ToF and cameras): avoidance.py picks the
    turn for brain._avoid() and Navigator._avoiding() from side sonar, the ToF's
    column halves and front-camera detections, min() per side. The stop is still
    sonar + ToF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
    [arm.py, avoidance.py, brain.py, come_to_me_task.py, config.py, gen_control_level_layout.py, motors.py, navigation.py]
2026-10-06 Steering channel map measured: LF3 RF2 LM0 RM1 LR9 RR8
    Each channel swung 1000<->2000us alone on the rover, owner naming the wheel.
    All six sit straight at 1500. The lower-channel-is-left placeholder had the
    fronts and rears reversed.
    INA260 0x40 stayed flat (0.51-0.54A) while a steering servo visibly swung:
    the servo supply is not on that monitor's path, so current cannot confirm
    steering motion. Recorded against FR-600's open V+ path item.
    Claude-Session: https://claude.ai/code/session_01UrFVBfN6UM3fGYmYRFsjPm
    [config.py]
2026-10-06 ToF orientation measured; drive verified; 0x40 not the steering supply
    TOF_LEFT_COLUMNS=(4,5,6,7): a hand, then an upright tin on Willie's left
    (front-camera photo as witness) appeared in columns 5-7 only -- the image is
    mirrored. Row 0 is the top of the view. Zones r0-r2 x c0-c2 read 0-5 cm:
    the cover's window edge; a bigger-window cover is being printed, and the
    floor profile waits for it.
    FR-400 drive: live-verified by the owner 2026-10-06.
    Master Hardware Design: 0x40 is listed as the steering 5V monitor, but its
    reading stayed flat while a steering servo swung.
    Battery cross-check message no longer calls the divider the authority:
    battery_volts has followed the bus while it is live s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
    [brain.py, config.py]
2026-10-06 Clock from internet time before the rover starts; Witty Pi RTC kept right
    At boot wp5d copies the Witty Pi RTC into the system clock, and on
    2026-10-06 that RTC was a week and 36 minutes fast; the service started on
    2026-10-13 before timesyncd corrected it. The Pi 5's own RTC has no battery.
    scripts/clock_sync.sh runs as the unit's ExecStartPre: waits up to 45 s for
    internet time, then writes it to the Witty Pi RTC (wp5 menu 1, as the
    service user -- root collides with the user's app lock). No internet in
    time: start anyway on the RTC's time, logged. Never fatal.
    The RTC itself was reset from internet time by hand the same day.
    Claud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
2026-10-07 ToF remounted 180 deg: left is columns 0-3; floor profile keeps rows 6-7 only
    The SEN0628 was refitted 2026-10-07 in a new bigger-window housing, rotated
    180 deg. Re-measured with an upright tin on Willie's left and a front-camera
    photo as witness: the tin landed in columns 0-1, so TOF_LEFT_COLUMNS=(0,1,2,3)
    and row 7 is the bottom of the view. The 2026-10-06 note had the rows
    backwards (row 0 was the bottom then); corrected in config and all three docs.
    The new housing removed the 0-5 cm window-edge returns.
    Floor capture, twice: rows 6-7 see floor at 37-60 cm, even and repeatable;
    rows 0-5 see the room at 1.3-1.8 m. Baked in as floor those zones would read
    DROP anywhere the room differs.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
    [calibrate_tof_floor.py, config.py, test_tof.py, tof.py]
2026-10-07 Rotation mode: corners steered onto the turning circle, spin on IMU, watched
    Owner 2026-10-07: a skid turn on the floor strained in place at duty 0.6 and
    turned 62 deg "rough" at full duty. rotate.py steers FL/RR right and FR/RL
    left onto the circle round his centre (atan(0.16/0.155) = 46 deg, clamped to
    the +-500 us servo range, ~37 deg), middles straight, then spins with the
    corners 1.44x the middles (DriveBase.set_wheels). Stops on IMU heading; sonar
    or ToF inside ROTATE_CLEAR_CM, wrong-way heading, timeout, or the front
    camera's integrated image shift disagreeing with the IMU stop it and say why.
    Measured today: WHEELBASE_M 0.32; all four corners point right for +us,
    ~15 deg/200 us by e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
    [config.py, motors.py, rotate.py, rotate_test.py, test_rotate.py]
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2026-10-07 Rear camera by-id path; stop-early 10 deg; rear camera is an Arducam OV9281
    The rotation test's rear camera got no frames: CAMERA_DEVICE was /dev/video8
    and the camera is /dev/video0 since this boot -- video nodes renumber. Now the
    /dev/v4l/by-id path, which follows the camera. v4l2 identifies it as an
    Arducam OV9281 (UC599) global-shutter camera; 0c45:6366 is its USB bridge,
    which lsusb had reported as a Microdia webcam. Hardware doc corrected.
    ROTATE_STOP_EARLY_DEG 5 -> 10: third live run stopped at 89.1 deg and coasted
    to 95.0.
    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
    [config.py]
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2026-10-07 Rotation wired into brain: voice turns, roam avoidance, through SafetyController
    rotate.py's spin now goes through SafetyController.set_wheels, approved as a
    turn (motion enabled, tilt, battery tier), and a refused spin fails and says
    why. brain.py runs it as state ROTATE via start_rotation(deg, then=...);
    all 11 Directive/stop sites abort it. Voice: "turn around" (180) and "turn
    left/right N degrees"; a bare "turn left" stays the manual nudge. _avoid()
    turns +-45/+-90 by rotation when AVOID_USE_ROTATION; a refused or blocked
    rotation backs off and lets AVOID retry. Navigator's avoidance still skid-
    turns; the service uses the front camera only.
    Rotation live-verified on the bench script bo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
    [brain.py, config.py, rotate.py, safety.py, test_rotate.py, voice.py]
2026-10-07 Feature request approved by owner: Detect and recover from stalled IMU reports
2026-10-07 Rotation counts turns past 180; battery authority made explicit
    Rotation: a live 180 deg "turn around" logged "-178.4 deg" -- heading wraps at
    +-180, so start-to-now cannot tell 182 from -178, and a turn past 190 would
    have tripped the wrong-way stop. _turned() now sums wrapped heading changes
    tick by tick. Test turns 270 through the wrap.
    Battery (outside review, P1): since b47f7d7 battery_volts IS the bus while the
    bus is live, so _battery_reading_disputed() compared the bus with itself and
    the docstrings still called the divider "the AUTHORITY". Now explicit: bus live
    -> the bus is the reading, and the check is a consistency guard; bus dead ->
    the divider is the only reading, and a halt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
    [brain.py, rotate.py, test_battery_halt.py, test_rotate.py]
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2026-10-07 Rotation pre-spin clearance; CI runs the simulated suite on every push
    Outside review 2026-10-07, P0 "rotation safety envelope": a rotation is now
    refused before anything moves unless front, left and right all read at least
    ROTATE_START_CLEAR_CM (20 cm: corners sweep ~9 cm beyond an estimated 0.42 x
    0.41 m body), or if the distance sensors cannot be read; he says which side
    is short. In _avoid() a refused rotation backs up rather than skid-turning,
    which sweeps the same circle. The rear is still unseen; the bump stop covers
    it.
    P1 "no CI": .github/workflows/tests.yml runs on every push and PR -- Ubuntu,
    Python 3.13 (willie's), compileall, then the full WILLY_SIMULATE=1 suite.
    Move-path aud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
    [brain.py, config.py, rotate.py, rotate_test.py, test_rotate.py]
2026-10-07 Hailo runtime import is optional in brain.py
    The first CI run stopped at collection: tests/test_tick_timing.py imports
    brain, which imported hailo_llm (picamera2, hailo_platform) unconditionally
    whenever ENABLE_HAILO_LLM was on. Those exist only on the rover. A missing
    runtime now logs a warning and leaves Willie without the on-board model
    (STUCK falls back to the cloud) instead of failing to import; the
    brake-before-generate hook is installed only when the model loaded.
    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
    [brain.py]
2026-10-07 CI fixes: brake through SafetyController; diagnostics imports hardware lazily
    Second CI run (514 passed, 5 failed) found real problems the laptop hid:
    - tests/test_no_direct_drive_bypass: brain's brake-before-Hailo called
    DriveBase.brake() directly. Now SafetyController.brake_now(): a synchronous
    hard brake callable from any thread, stop-only, leaving the tick thread's
    timed-move state alone. Test added.
    - tests/test_expected_i2c_agreement (4): diagnostics.py imported board/busio
    at the top; they exist only on the rover. Now imported inside scan_i2c().
    - tests/test_reflex_deliberative_separation: brake_now()'s first docstring
    named the AI backend inside the reflex layer; reworded.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
    [brain.py, diagnostics.py, safety.py, test_hailo_brake.py]
2026-10-07 User Guide rewritten against the code; FRD gains three built requirements
    User Guide (last reviewed 2026-09-10): rewritten against the current code.
    Adds turning on the spot, teaching rooms/stairs/routes, faces, memory, the
    "reset" after a fault, Home Assistant commands, the STOP SVC button, general
    conversation and personality, strangers, and privacy. Corrects the arm (it
    moves), come here (it searches), wheel sensors (they count), the E-stop (main
    power switch), shutdown confirm (15 s, "confirm" or "yes"), feature-request
    approval (exact subject line) and the battery caveat. Unproven items are
    marked "not yet tried for real".
    FRD: three behaviours built before any requirement covered them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
2026-10-07 Faster spoken replies: Piper loaded once, short replies cached
    Live voice timing (2026-10-07): speech-to-text ~3.7-4.1 s (mostly the
    speaking plus the 0.6 s end-of-speech silence), reply synthesis 2.6-5.1 s --
    every reply started a new piper process that loaded the voice model from
    disk. voice.PiperEngine loads the model once (warmed on the speaker thread at
    startup) via Piper's Python API -- 1.3+ synthesize_wav/SynthesisConfig or 1.2
    synthesize -- and caches the finished audio of short replies
    (TTS_CACHE_MAX_CHARS), so fixed fast-path answers need no synthesis after
    first use. Any failure falls back to the old subprocess. The timing line
    names the path taken (cache/inproc/subprocess). Not y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
    [config.py, test_tts_engine.py, voice.py]
2026-10-08 "What are you doing?" and brief "what are you looking at?"; FR-600 power, email decision
    FR-1500-011 (owner): "what are you doing / up to / what's going on" answers
    with one short sentence from the current state (exploring, turning left, on
    the way to the kitchen, looking for you, backing up as asked, waiting, or
    stopped and why). Answered in the speech-only pass, so it works while he is
    moving; read-only. "What are you looking at?" joins what_do_you_see, which
    now names at most the three most confident things in view.
    Docs: steering servo V+ power path confirmed by the owner (peak current still
    unmeasured; the steering_5v trip reads 0x40, which cannot see steering
    current, so it cannot fir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
    [brain.py, test_what_doing.py, voice.py]
2026-10-08 Docs: ToF #2 pins 8/10 free (INT not connected), ToF RX wire green, ToF #2 harness in place, ADS1115 replaced, spring-tethered steering gear redesign noted
    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
2026-10-08 Display drops to 5 fps while speech is transcribed
    Measured 2026-10-08 on willie: reply synthesis 2.6-5.1 s -> 0.1-0.4 s with
    the in-process Piper; a simple command ~4.5 s end to end. Remaining cost is
    speech-to-text: base.en transcription 1.44 s with nothing else running, ~2.1
    s inside the service. py-spy put the face display (30 fps redraw + flip) at
    ~20% of a core, the largest competitor (the wake-word thread is the
    transcribing thread and already pauses). display.set_quiet() drops it to
    DISPLAY_FPS_QUIET (5) for the duration of transcription. tiny.en was
    benchmarked (1.13 s) and rejected: 11/12, "how's your battery" -> "House
    your battery". Findings recorded in Software Design.
    Co-Autho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
    [config.py, display.py, test_talking_mouth.py, voice.py]
2026-10-08 Model never answers sensor questions; "how is your battery"; GPS requirements
    Live 2026-10-08: "How is your battery?" missed the fixed phrases, went to the
    Hailo model, and Willie spoke the model's invented "I am at 80%" before the
    real "I can't read my battery right now" (Pi-only power). The model cannot
    know sensor facts: for status, battery, where_are_you, what_do_you_see,
    what_doing and diagnostics, any model reply other than the fixed
    acknowledgements is dropped and brain speaks the real answer. "how is / what
    is your battery" added to the fast path.
    FRD: FR-2300 GPS (Adafruit PA1010D on order, I2C 0x10) -- report position
    with a map link, learn home, wander alert by email, GPS time ba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
    [test_what_doing.py, voice.py]
2026-10-08 Hailo model streams tokens: other threads freeze 2.2 s, not 7.7 s
    FR-1400-006, measured on willie 2026-10-08 with a 20 ms heartbeat thread:
    generate_all() held the GIL for the whole call -- every other thread froze
    4.6 s on a short prompt and 7.7 s on a realistic 2,900-char one. Streaming
    generate() releases it between tokens (~0.12 s each) at the same total time;
    the longest freeze left is the prompt read, 2.2 s. save_context /
    load_context of a pre-read prompt prefix was measured and rejected (44 MB
    restore ~1 s, call no faster). The brake-before-generation hook stays until
    the model runs outside this process. Test fakes gain generate(); the brake
    test's generate_all() now raises so it can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
    [hailo_llm.py, test_hailo_brake.py, test_hailo_chatml.py, test_hailo_generation_params.py, test_hailo_statelessness.py]
2026-10-08 Hailo re-qualified (no change, model ceiling); its misses become fixed phrases
    experiments/hailo_qualification.py hailo --repeats 3 on the current code:
    78.1% usable, 25.0% strict, 12 wrong intent, 9 unparseable, 85.4% precision
    above the 0.7 floor, median 4.8 s -- vs 80.2 / 27.1 / 10 / 9 / 88.0 / 4.9 on
    2026-09-14. Within noise and stable across repeats: the 1.5 B model's
    ceiling. Artifact committed under experiments/results/.
    The phrasings it got wrong that reach it in practice are now deterministic:
    "power yourself off" (still confirms), "much juice left", "put that arm
    away", "say hi to them" (once read as come_here, i.e. motion) and "are you
    doing okay". Near-misses and negations still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
    [test_what_doing.py, voice.py]
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2026-10-08 He no longer hears himself; self-test reason first in "what are you doing"
    Live 2026-10-08: after "What are you doing?", a capture opened off the audio
    queued during transcription just as the reply began, recorded the reply, and
    he answered himself ("Heard: I'm just starting up." -> model, 11 s). The mute
    checked only the moment a frame was read. Now a capture is abandoned the
    moment he starts speaking, and after each handled utterance the stale backlog
    is dropped and the wake model reset. On Pi-only power the state stays INIT,
    so "what are you doing" said "I'm just starting up"; a failing self-test is
    now reported first.
    FRD: talking mouth (FR-1600-009) and "what are you doing" (FR-1500-01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
    [brain.py, test_what_doing.py, voice.py]
2026-10-08 FR-100-003: self-test also refuses motion on a low encoder rail (R5)
    The startup self-test already checked imu.is_healthy and
    encoders.is_healthy -- the FRD's "encoder and IMU checks outstanding" was
    stale. Live: it passed with full power (2026-10-06/07) and, with only the Pi
    powered (2026-10-08), reported "encoders not reporting" and kept motion
    disabled. Added: Pico A's R5-low flag (encoders.r5_low), the rail whose
    loss killed every encoder on 2026-08-25, now fails the boot gate as
    "encoder supply rail R5 low" (safety-critical, no override). FRD corrected.
    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
    [brain.py, test_what_doing.py]
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2026-10-08 M-009 thermal monitoring; FRD/docs stale claims corrected
    thermal.py: SoC temp + fan tach every 5 s, warm 70 / hot 80 C with hysteresis,
    EVENT=THERMAL on level change, spoken once on hot or fan stopped, CPU temp on the
    face from 70 C, status reply notes hot. Never touches motion.
    Docs: section V register brought in line with the section text across FR-000..FR-2300,
    FR-900-005 (shutdown releases the arm), ADS1115 replacement, Hailo 78.1%,
    grasp rebuild, requirement count 139, M-001..M-020.
    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
    [brain.py, config.py, display.py, test_thermal.py, thermal.py]
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2026-10-08 FR-1000-006: knock at a shut door (off until ARM_POSE_KNOCK is measured)
    knock.py: fixed, timed step list -- elbow open first, stepped shoulder, 3 wrist-pitch
    taps, back to rest -- started only from a sonar standoff inside ARM_KNOCK_STANDOFF_CM.
    Navigator DOOR_WAIT: knock then ask per attempt, wheels stopped every tick; arm release
    ends it (ask-only after), door opening sends the arm home before driving, abort holds
    the arm. ARM_POSE_KNOCK=None keeps today's ask-only behaviour.
    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
    [brain.py, config.py, knock.py, navigation.py, test_knock.py]
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2026-10-09 Stale bus reading counts as dead bus; failed Hailo server keeps the model off
    - CurrentMonitor.fresh_volts(): per-rail freshness. brain._bus_volts() treats a
    0x45 reading older than INA_FRESH_S as a dead bus for every battery decision,
    so a dead monitor can no longer freeze battery_volts at its last good value.
    - If the Hailo server will not start, vision falls back in-process but the
    on-board model stays off (the in-process model is the freeze itself).
    Both from the 2026-10-08 outside review.
    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
    [brain.py, config.py, hailo_llm.py, hailo_server.py, sensors.py, test_battery_bus_authority.py, test_hailo_server.py]
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2026-10-10 Rear coverage: rear ToF gates reversing; rear camera for rotation and reverse stop
    - Rear SEN0628 on UART0 (uart0-pi5), mounted upside down: per-sensor geometry in
    ToFSensor (floor rows 0-1, Willie's left = cols 0-3), own floor profile
    (calibrate_tof_floor.py --rear). SonarArray.rear_cm(); approve_motion refuses
    reverse inside DIST_STOP behind; timed reverse aborts mid-flight; drop = 0.
    - Rear camera (vision.RearCamera): on demand, privacy-gated, idle close. Passed to
    rotation as rear_grab (it never was). While reversing, a background watcher runs
    Hailo detection; a person/pet close behind pulls rear_cm to 0. Adds stops only.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
    [brain.py, calibrate_tof_floor.py, config.py, safety.py, sensors.py, test_rear_camera.py, test_rear_tof.py, tof.py]
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2026-10-10 Fix: a timed move held back to straighten the wheels counts as active
    Voice 'back up' -> MANUAL saw timed_move_active False during the 0.3 s settle, went to
    IDLE, and IDLE's stop() cancelled the move before it started. Found before the first test.
    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
    [safety.py, test_straighten_before_moving.py]
2026-10-10 ToF: no drop verdicts for 3 s after a sensor starts giving frames
    Every false 'drop behind' on 2026-10-10 came within ~6 s of start-up; 100 frames standalone
    were clean. Start-up frames carry missing zones.
    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
    [config.py, test_rear_tof.py, test_tof.py, tof.py]
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2026-10-10 Rear camera never blocks the tick; log when a timed move finishes
    Live 2026-10-10: reversing toward the couch, the tick froze 897 ms waiting on the rear
    camera lock while VideoCapture() opened. The camera now opens in the background and
    close_if_idle() never waits. 'Timed <action> finished' tells a timeout from an abort.
    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
    [safety.py, test_rear_camera.py, vision.py]
2026-10-10 Roam by voice; questions beep and listen for the answer; rear-gap findings
    - "go explore" / "explore" / "roam" / "go wander" / "start exploring" grant the session's
    roam permission by voice and, from IDLE, set off (owner 2026-10-10). "Stop" still revokes.
    - voice.ask(): after a question (roam ask, shutdown confirm) he chirps and listens once with
    no wake word; the answer is queued as a spoken command. Yes-matching ignores punctuation,
    and "go explore" answers the roam ask as yes.
    - FRD: rear ToF missed a 2-inch box and a dark fabric couch; rear camera saw no couch at
    6/20/40 cm. Rear HC-SR04 pending a divider-board change.
    Clau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
    [brain.py, config.py, test_brain_roam_permission.py, test_roam_by_voice.py, voice.py]
2026-10-10 ToF ports follow the swapped harnesses: front = UART0, rear = UART3
    Palm over the FRONT sensor showed on ttyAMA0 (2026-10-10). Owner chose software over re-plugging.
    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
    [config.py]
2026-10-10 Fix: the front ToF now actually feeds the forward stop; ToF logs name the sensor
    distances() only consulted the ToF once tof.available was True, and only a read sets it,
    so the forward check never read it (it joined in only after an avoidance turn read it).
    Read every tick; a failed read still means sonar alone. Found 2026-10-10.
    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
    [brain.py, sensors.py, test_sonar_tof_fusion.py, tof.py]
2026-10-10 IMU start never crashes the service: RST + retry, else start without it
    10-09 crash loops: BNO085 raised at construction past _init_device. Now try, hardware RST,
    try again, else run without the driver; poll-loop recovery keeps trying, self-test keeps
    motion off.
    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
    [sensors.py, test_imu_start.py]
2026-10-10 "Check your logs": spoken 24 h log summary, then offers to ask for a fix
    - logcheck.py: counts WARNING/ERROR causes (EVENT faults, stalls, plain warnings), skips
    consequences ("emergency stop", state changes); one sentence, top three + "N other kinds".
    - If problems were found he asks "Do you want me to ask for a fix?" (beep and listen); yes
    runs the FR-2200 feature-request process now (owner_asked bypasses the 1/day limit only).
    Not yet run on the rover.
    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
    [brain.py, config.py, feature_requests.py, logcheck.py, test_logcheck.py, voice.py]
2026-10-10 Rear sonar (Pico B b-0.2, GP6/GP7) and firmware updates over the Pi UART (a-0.4, b-0.2)
    - Pico B b-0.2: fourth HC-SR04 (rear) appended AFTER the flags in $S, so fields 0-9 are
    unchanged; flag bit 3 = rear ECHO stuck. Pi: rear_sonar_cm(); rear_cm() = nearer of rear
    sonar and rear ToF (the sonar sees the dark couch the ToF missed); dead rear sonar named.
    - UART updates: launcher.py (installed once as main.py) runs app.py, resets on crash/hang,
    rolls back to app_prev.py after two failed trial boots; uartupd.py receives acknowledged,
    adler32-verified chunks; scripts/pico_update.py sends, commits, checks version, confirms.
    Claude-Se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
    [brain.py, launcher.py, pico_a.py, pico_b.py, pico_update.py, sensors.py, test_pico_uart_update.py, test_rear_tof.py]
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2026-10-10 General questions: skip the on-board model, fast cloud chat (Haiku 4.5, short spoken reply)
    Live 'why is the grass green?' took 11-15 s (STT 5-6 s + Hailo 5.3 s rejected + cloud ~4 s).
    Plain questions with no command words now go straight to CloudAIProvider.chat(); commands
    unchanged; falls back to the Sonnet path on failure.
    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
    [ai_provider.py, config.py, test_fast_general_questions.py, voice.py]
2026-10-10 Voice guard: whole-word matches only ('ok' no longer matches 'look')
    Outside review 2026-10-10: the sensor-intent word check used substrings.
    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
    [test_model_sensor_intent_guard.py, voice.py]
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
