hdhimmel/willy-rover/(notices)

Notices in the files:
docs/WildWilly_Master_Hardware_Design_v2.0.md:
17.2 `CLAUDE.md` citations:
`CLAUDE.md` cites this document (§16 pin-to-pin schedule, §12 design constraints), not the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
17.3 `config.py` section citations:
`config.py` carries no §9.1 citations. This document's §9 has no subsections.
End of document.
